Ale1x/auto-gauge/docs/hardware/README.md

# Hardware e gate K0

Analisi di fattibilità, vincoli e piani di verifica. Questi documenti non costituiscono una qualifica elettrica o automotive.

- [BUCK5_FEEDBACK_REVIEW.md](BUCK5_FEEDBACK_REVIEW.md) — Buck 5 V — screening del feedback LM5164-Q1
- [CAN_POWER_TEST_PLAN.md](CAN_POWER_TEST_PLAN.md) — CAN, alimentazione e prove K0 — proposta non congelata
- [CAPACITY_K0.md](CAPACITY_K0.md) — Sensibilità memoria e interrogazioni — K0, 2026-10-24
- [CONNECTORS_CABLE_K0.md](CONNECTORS_CABLE_K0.md) — Connettori e cavo — shortlist K0, 2026-10-24
- [GATE_K0.md](GATE_K0.md) — Gate K0 — revisione 0.14, 2026-10-24
- [HW_IGN_TEST_PROTOCOL.md](HW_IGN_TEST_PROTOCOL.md) — HW-IGN — protocollo operativo K0, NON ESEGUITO
- [LOGGING_K0.md](LOGGING_K0.md) — Logging locale limitato — proposta K0, 2026-10-24
- [MCU_RAIL_K0.md](MCU_RAIL_K0.md) — Rail MCU 3,3 V — verifica K0, 2026-10-24
- [MECHANICAL_K0.md](MECHANICAL_K0.md) — Studio meccanico K0 — revisione 0.3, diametro da congelare
- [MEMORY_RF_K0.md](MEMORY_RF_K0.md) — Memoria e RF — approfondimento K0, 2026-10-24
- [POWER_ENVELOPE_K0.md](POWER_ENVELOPE_K0.md) — Cavo e potenza — inviluppo analitico K0, 2026-10-24
- [STANDBY_BUDGET_K0.md](STANDBY_BUDGET_K0.md) — Standby — target approvato e primo controllo quantitativo
- [USB_RECOVERY_K0.md](USB_RECOVERY_K0.md) — Recovery USB alimentata — analisi K0

- [Blocker K0-001](issues/K0-001_BLOCKERS.md).
- [Sorgenti e studi KiCad](../../hardware/README.md).
- [BOM candidati](../../hardware/BOM_CANDIDATES.csv).
- [Studio meccanico](../../hardware/mechanical/gauge-k0-concepts.drawio.png).
