Ale1x/auto-gauge/docs/firmware/README.md

# Firmware

Guide dei sottosistemi. Per stato e comandi principali partire da firmware/README.md; studi SDK e codice rimangono nel modulo.

- [DEVICE_BUILD.md](DEVICE_BUILD.md) — Build reale ESP32-S3 — SDK ufficiale v6.1
- [DEVICE_ENDPOINT.md](DEVICE_ENDPOINT.md) — Endpoint C integrato — sviluppo host
- [DIAGNOSTIC_COVERAGE.md](DIAGNOSTIC_COVERAGE.md) — Copertura diagnostica scalare FW-09 — Service 01
- [FLASH_HISTORY_MODEL.md](FLASH_HISTORY_MODEL.md) — FW-08 — storico persistente su flash simulata
- [JOURNAL_HISTORY.md](JOURNAL_HISTORY.md) — FW10: sector journal history, development format 1
- [PARSER_BUILD.md](PARSER_BUILD.md) — Parser C condiviso: compilazione e stack
- [RUNTIME.md](RUNTIME.md) — FW11 autonomous host runtime coordinator
