Ale1x/auto-gauge/docs/project/README.md

# Progetto

Stato corrente, decisioni approvate e registri. WORKSTREAMS mantiene anche la cronologia; per riprendere partire da STATUS.

- [DECISIONS.md](DECISIONS.md) — Registro decisioni approvate
- [STATUS.md](STATUS.md) — Stato corrente — 25 ottobre 2026
- [WORKSTREAMS.md](WORKSTREAMS.md) — Lavoro parallelo — 24 ottobre 2026
- [traceability.md](traceability.md) — Tracciabilità K0 — revisione 0.8

- [DOCUMENTATION_MAP.json](DOCUMENTATION_MAP.json) — mappa dei percorsi precedenti.
