Ale1x/auto-gauge/hardware/pin_matrix.csv

sheet | reference | pin | pin_name | net | status
01_OBD_INPUT | J100 | 1 | Pin_1 | NC | EXTERNAL HARNESS / TYPE A DRAWING OPEN
01_OBD_INPUT | J100 | 2 | Pin_2 | NC | EXTERNAL HARNESS / TYPE A DRAWING OPEN
01_OBD_INPUT | J100 | 3 | Pin_3 | NC | EXTERNAL HARNESS / TYPE A DRAWING OPEN
01_OBD_INPUT | J100 | 4 | Pin_4 | GND | EXTERNAL HARNESS / TYPE A DRAWING OPEN
01_OBD_INPUT | J100 | 5 | Pin_5 | OBD_SIGNAL_GND | EXTERNAL HARNESS / TYPE A DRAWING OPEN
01_OBD_INPUT | J100 | 6 | Pin_6 | CANH_CABLE | EXTERNAL HARNESS / TYPE A DRAWING OPEN
01_OBD_INPUT | J100 | 7 | Pin_7 | NC | EXTERNAL HARNESS / TYPE A DRAWING OPEN
01_OBD_INPUT | J100 | 8 | Pin_8 | NC | EXTERNAL HARNESS / TYPE A DRAWING OPEN
01_OBD_INPUT | J100 | 9 | Pin_9 | NC | EXTERNAL HARNESS / TYPE A DRAWING OPEN
01_OBD_INPUT | J100 | 10 | Pin_10 | NC | EXTERNAL HARNESS / TYPE A DRAWING OPEN
01_OBD_INPUT | J100 | 11 | Pin_11 | NC | EXTERNAL HARNESS / TYPE A DRAWING OPEN
01_OBD_INPUT | J100 | 12 | Pin_12 | NC | EXTERNAL HARNESS / TYPE A DRAWING OPEN
01_OBD_INPUT | J100 | 13 | Pin_13 | NC | EXTERNAL HARNESS / TYPE A DRAWING OPEN
01_OBD_INPUT | J100 | 14 | Pin_14 | CANL_CABLE | EXTERNAL HARNESS / TYPE A DRAWING OPEN
01_OBD_INPUT | J100 | 15 | Pin_15 | NC | EXTERNAL HARNESS / TYPE A DRAWING OPEN
01_OBD_INPUT | J100 | 16 | Pin_16 | OBD_BATT_RAW | EXTERNAL HARNESS / TYPE A DRAWING OPEN
01_OBD_INPUT | J101 | 1 | Pin_1 | BPLUS_CABLE_FUSED | MAPPING H / HOUSINGS 0430200600 + 0430250600
01_OBD_INPUT | J101 | 2 | Pin_2 | GND | MAPPING H / HOUSINGS 0430200600 + 0430250600
01_OBD_INPUT | J101 | 3 | Pin_3 | OBD_SIGNAL_GND | MAPPING H / HOUSINGS 0430200600 + 0430250600
01_OBD_INPUT | J101 | 4 | Pin_4 | CANH_CABLE | MAPPING H / HOUSINGS 0430200600 + 0430250600
01_OBD_INPUT | J101 | 5 | Pin_5 | CANL_CABLE | MAPPING H / HOUSINGS 0430200600 + 0430250600
01_OBD_INPUT | J101 | 6 | Pin_6 | NC | MAPPING H / HOUSINGS 0430200600 + 0430250600
01_OBD_INPUT | F100 | 1 |  | OBD_BATT_RAW | OPEN: CURRENT / I2T / DC BREAKING
01_OBD_INPUT | F100 | 2 |  | BPLUS_CABLE_FUSED | OPEN: CURRENT / I2T / DC BREAKING
01_OBD_INPUT | R101 | 1 |  | OBD_SIGNAL_GND | OPEN GROUND / EMC REVIEW
01_OBD_INPUT | R101 | 2 |  | GND | OPEN GROUND / EMC REVIEW
01_OBD_INPUT | #FLG01 | 1 |  | OBD_BATT_RAW | EXTERNAL SOURCE DECLARATION
01_OBD_INPUT | #FLG02 | 1 |  | GND | EXTERNAL RETURN DECLARATION
02_AUTOMOTIVE_POWER | U201 | 2 | A | BPLUS_CABLE_FUSED | CANDIDATE / LIMITS OPEN
02_AUTOMOTIVE_POWER | U201 | 24 | C | PROT_MID | CANDIDATE / LIMITS OPEN
02_AUTOMOTIVE_POWER | U201 | 22 | VS | PROT_MID | CANDIDATE / LIMITS OPEN
02_AUTOMOTIVE_POWER | U201 | 3 | SW_SENSE | PROT_SENSE_SW | CANDIDATE / LIMITS OPEN
02_AUTOMOTIVE_POWER | U201 | 4 | UVLO | PROT_UVLO | CANDIDATE / LIMITS OPEN
02_AUTOMOTIVE_POWER | U201 | 5 | OV | PROT_OV | CANDIDATE / LIMITS OPEN
02_AUTOMOTIVE_POWER | U201 | 6 | EN | PROT_MID | CANDIDATE / LIMITS OPEN
02_AUTOMOTIVE_POWER | U201 | 7 | SLEEP | PROT_SLEEP_HV | CANDIDATE / LIMITS OPEN
02_AUTOMOTIVE_POWER | U201 | 13 | GND | GND | CANDIDATE / LIMITS OPEN
02_AUTOMOTIVE_POWER | U201 | 19 | CS_MINUS | PROT_CS_MINUS | CANDIDATE / LIMITS OPEN
02_AUTOMOTIVE_POWER | U201 | 20 | CS_PLUS | PROT_CS_PLUS | CANDIDATE / LIMITS OPEN
02_AUTOMOTIVE_POWER | U201 | 18 | ISCP | PROT_CS_PLUS | CANDIDATE / LIMITS OPEN
02_AUTOMOTIVE_POWER | U201 | 1 | DGATE | IDEAL_DIODE_GATE | CANDIDATE / LIMITS OPEN
02_AUTOMOTIVE_POWER | U201 | 14 | HGATE | LOAD_GATE | CANDIDATE / LIMITS OPEN
02_AUTOMOTIVE_POWER | U201 | 15 | OUT | AON_PROTECTED | CANDIDATE / LIMITS OPEN
02_AUTOMOTIVE_POWER | U201 | 16 | SLEEP_OV | PROT_MID | CANDIDATE / LIMITS OPEN
02_AUTOMOTIVE_POWER | U201 | 23 | CAP | PROT_CAP | CANDIDATE / LIMITS OPEN
02_AUTOMOTIVE_POWER | U201 | 9 | TMR | PROT_TMR | CANDIDATE / LIMITS OPEN
02_AUTOMOTIVE_POWER | U201 | 10 | IMON | NC | CANDIDATE / LIMITS OPEN
02_AUTOMOTIVE_POWER | U201 | 11 | ILIM | PROT_ILIM | CANDIDATE / LIMITS OPEN
02_AUTOMOTIVE_POWER | U201 | 12 | FLT | NC | CANDIDATE / LIMITS OPEN
02_AUTOMOTIVE_POWER | U201 | 8 | NC | NC | CANDIDATE / LIMITS OPEN
02_AUTOMOTIVE_POWER | U201 | 17 | NC | NC | CANDIDATE / LIMITS OPEN
02_AUTOMOTIVE_POWER | U201 | 21 | NC | NC | CANDIDATE / LIMITS OPEN
02_AUTOMOTIVE_POWER | Q201 | 1 | G | IDEAL_DIODE_GATE | OPEN MOSFET SELECTION
02_AUTOMOTIVE_POWER | Q201 | 2 | D | PROT_MID | OPEN MOSFET SELECTION
02_AUTOMOTIVE_POWER | Q201 | 3 | S | BPLUS_CABLE_FUSED | OPEN MOSFET SELECTION
02_AUTOMOTIVE_POWER | Q202 | 1 | G | LOAD_GATE | OPEN MOSFET SELECTION
02_AUTOMOTIVE_POWER | Q202 | 2 | D | PROT_CS_MINUS | OPEN MOSFET SELECTION
02_AUTOMOTIVE_POWER | Q202 | 3 | S | AON_PROTECTED | OPEN MOSFET SELECTION
02_AUTOMOTIVE_POWER | R201 | 1 |  | PROT_MID | OPEN OCP / I2T
02_AUTOMOTIVE_POWER | R201 | 2 |  | PROT_CS_MINUS | OPEN OCP / I2T
02_AUTOMOTIVE_POWER | R202 | 1 |  | PROT_MID | CANDIDATE
02_AUTOMOTIVE_POWER | R202 | 2 |  | PROT_CS_PLUS | CANDIDATE
02_AUTOMOTIVE_POWER | D201 | 1 | A1 | BPLUS_CABLE_FUSED | OPEN CLAMP / ENERGY / POLARITY
02_AUTOMOTIVE_POWER | D201 | 2 | A2 | GND | OPEN CLAMP / ENERGY / POLARITY
02_AUTOMOTIVE_POWER | C201 | 1 |  | PROT_MID | CANDIDATE
02_AUTOMOTIVE_POWER | C201 | 2 |  | GND | CANDIDATE
02_AUTOMOTIVE_POWER | C202 | 1 |  | PROT_CAP | CANDIDATE
02_AUTOMOTIVE_POWER | C202 | 2 |  | PROT_MID | CANDIDATE
02_AUTOMOTIVE_POWER | R203 | 1 |  | PROT_SENSE_SW | OPEN UV/OV LIMITS
02_AUTOMOTIVE_POWER | R203 | 2 |  | PROT_UVLO | OPEN UV/OV LIMITS
02_AUTOMOTIVE_POWER | R204 | 1 |  | PROT_UVLO | OPEN UV/OV LIMITS
02_AUTOMOTIVE_POWER | R204 | 2 |  | PROT_OV | OPEN UV/OV LIMITS
02_AUTOMOTIVE_POWER | R205 | 1 |  | PROT_OV | OPEN UV/OV LIMITS
02_AUTOMOTIVE_POWER | R205 | 2 |  | GND | OPEN UV/OV LIMITS
02_AUTOMOTIVE_POWER | R206 | 1 |  | PROT_ILIM | OPEN OCP
02_AUTOMOTIVE_POWER | R206 | 2 |  | GND | OPEN OCP
02_AUTOMOTIVE_POWER | C203 | 1 |  | PROT_TMR | OPEN FAULT TIME
02_AUTOMOTIVE_POWER | C203 | 2 |  | GND | OPEN FAULT TIME
02_AUTOMOTIVE_POWER | C204 | 1 |  | AON_PROTECTED | OPEN INRUSH / SOA
02_AUTOMOTIVE_POWER | C204 | 2 |  | GND | OPEN INRUSH / SOA
02_AUTOMOTIVE_POWER | R215 | 1 |  | CAN_INH_HV | CANDIDATE
02_AUTOMOTIVE_POWER | R215 | 2 |  | PROT_SLEEP_HV | CANDIDATE
02_AUTOMOTIVE_POWER | R216 | 1 |  | PROT_SLEEP_HV | CANDIDATE
02_AUTOMOTIVE_POWER | R216 | 2 |  | GND | CANDIDATE
02_AUTOMOTIVE_POWER | R217 | 1 |  | CAN_INH_HV | OPEN WAKE SEQUENCE
02_AUTOMOTIVE_POWER | R217 | 2 |  | BUCK5_EN_HV | OPEN WAKE SEQUENCE
02_AUTOMOTIVE_POWER | C217 | 1 |  | BUCK5_EN_HV | OPEN WAKE SEQUENCE
02_AUTOMOTIVE_POWER | C217 | 2 |  | GND | OPEN WAKE SEQUENCE
02_AUTOMOTIVE_POWER | U202 | 1 | GND | GND | CANDIDATE / 5V LOOP H
02_AUTOMOTIVE_POWER | U202 | 2 | VIN | AON_PROTECTED | CANDIDATE / 5V LOOP H
02_AUTOMOTIVE_POWER | U202 | 3 | EN/UVLO | BUCK5_EN_HV | CANDIDATE / 5V LOOP H
02_AUTOMOTIVE_POWER | U202 | 4 | RON | BUCK5_RON | CANDIDATE / 5V LOOP H
02_AUTOMOTIVE_POWER | U202 | 5 | FB | BUCK5_FB | CANDIDATE / 5V LOOP H
02_AUTOMOTIVE_POWER | U202 | 6 | PGOOD | BUCK5_PG | CANDIDATE / 5V LOOP H
02_AUTOMOTIVE_POWER | U202 | 7 | BST | BUCK5_BST | CANDIDATE / 5V LOOP H
02_AUTOMOTIVE_POWER | U202 | 8 | SW | BUCK5_SW | CANDIDATE / 5V LOOP H
02_AUTOMOTIVE_POWER | U202 | 9 | EP | GND | CANDIDATE / 5V LOOP H
02_AUTOMOTIVE_POWER | L202 | 1 | 1 | BUCK5_SW | H / CURRENT AND LOSS OPEN
02_AUTOMOTIVE_POWER | L202 | 2 | 2 | 5V_OBD | H / CURRENT AND LOSS OPEN
02_AUTOMOTIVE_POWER | C205 | 1 |  | AON_PROTECTED | CANDIDATE
02_AUTOMOTIVE_POWER | C205 | 2 |  | GND | CANDIDATE
02_AUTOMOTIVE_POWER | C206 | 1 |  | BUCK5_BST | CANDIDATE
02_AUTOMOTIVE_POWER | C206 | 2 |  | BUCK5_SW | CANDIDATE
02_AUTOMOTIVE_POWER | C207 | 1 |  | 5V_OBD | CANDIDATE
02_AUTOMOTIVE_POWER | C207 | 2 |  | GND | CANDIDATE
02_AUTOMOTIVE_POWER | R207 | 1 |  | BUCK5_RON | CANDIDATE
02_AUTOMOTIVE_POWER | R207 | 2 |  | GND | CANDIDATE
02_AUTOMOTIVE_POWER | R208 | 1 |  | 5V_OBD | CANDIDATE
02_AUTOMOTIVE_POWER | R208 | 2 |  | BUCK5_FB | CANDIDATE
02_AUTOMOTIVE_POWER | R209 | 1 |  | BUCK5_FB | CANDIDATE
02_AUTOMOTIVE_POWER | R209 | 2 |  | GND | CANDIDATE
02_AUTOMOTIVE_POWER | R210 | 1 |  | BUCK5_SW | OPEN TYPE3 LOOP
02_AUTOMOTIVE_POWER | R210 | 2 |  | BUCK5_RIPPLE_A | OPEN TYPE3 LOOP
02_AUTOMOTIVE_POWER | C208 | 1 |  | BUCK5_RIPPLE_A | OPEN TYPE3 LOOP
02_AUTOMOTIVE_POWER | C208 | 2 |  | 5V_OBD | OPEN TYPE3 LOOP
02_AUTOMOTIVE_POWER | C209 | 1 |  | BUCK5_RIPPLE_A | OPEN TYPE3 LOOP
02_AUTOMOTIVE_POWER | C209 | 2 |  | BUCK5_FB | OPEN TYPE3 LOOP
02_AUTOMOTIVE_POWER | R211 | 1 |  | 5V_OBD | CANDIDATE
02_AUTOMOTIVE_POWER | R211 | 2 |  | BUCK5_PG | CANDIDATE
02_AUTOMOTIVE_POWER | U203 | 2 | VIN | 5V_SERVICE | CANDIDATE / E46 INITIAL VALUES
02_AUTOMOTIVE_POWER | U203 | 8 | EN | 5V_SERVICE | CANDIDATE / E46 INITIAL VALUES
02_AUTOMOTIVE_POWER | U203 | 1 | MODE_SYNC | GND | CANDIDATE / E46 INITIAL VALUES
02_AUTOMOTIVE_POWER | U203 | 7 | COMP_FSET | GND | CANDIDATE / E46 INITIAL VALUES
02_AUTOMOTIVE_POWER | U203 | 6 | SS_TR | BUCK33_SS | CANDIDATE / E46 INITIAL VALUES
02_AUTOMOTIVE_POWER | U203 | 4 | GND | GND | CANDIDATE / E46 INITIAL VALUES
02_AUTOMOTIVE_POWER | U203 | 3 | SW | BUCK33_SW | CANDIDATE / E46 INITIAL VALUES
02_AUTOMOTIVE_POWER | U203 | 5 | FB | BUCK33_FB | CANDIDATE / E46 INITIAL VALUES
02_AUTOMOTIVE_POWER | U203 | 9 | PG | BUCK33_PG | CANDIDATE / E46 INITIAL VALUES
02_AUTOMOTIVE_POWER | L203 | 1 | 1 | BUCK33_SW | CANDIDATE
02_AUTOMOTIVE_POWER | L203 | 2 | 2 | 3V3_SYS | CANDIDATE
02_AUTOMOTIVE_POWER | C210 | 1 |  | 5V_SERVICE | CANDIDATE
02_AUTOMOTIVE_POWER | C210 | 2 |  | GND | CANDIDATE
02_AUTOMOTIVE_POWER | C211 | 1 |  | 3V3_SYS | CANDIDATE
02_AUTOMOTIVE_POWER | C211 | 2 |  | GND | CANDIDATE
02_AUTOMOTIVE_POWER | C212 | 1 |  | 3V3_SYS | CANDIDATE
02_AUTOMOTIVE_POWER | C212 | 2 |  | GND | CANDIDATE
02_AUTOMOTIVE_POWER | C213 | 1 |  | BUCK33_SS | CANDIDATE
02_AUTOMOTIVE_POWER | C213 | 2 |  | GND | CANDIDATE
02_AUTOMOTIVE_POWER | R212 | 1 |  | 3V3_SYS | CANDIDATE
02_AUTOMOTIVE_POWER | R212 | 2 |  | BUCK33_FB | CANDIDATE
02_AUTOMOTIVE_POWER | R213 | 1 |  | BUCK33_FB | CANDIDATE
02_AUTOMOTIVE_POWER | R213 | 2 |  | GND | CANDIDATE
02_AUTOMOTIVE_POWER | C214 | 1 |  | 3V3_SYS | CANDIDATE
02_AUTOMOTIVE_POWER | C214 | 2 |  | BUCK33_FB | CANDIDATE
02_AUTOMOTIVE_POWER | R214 | 1 |  | 3V3_SYS | CANDIDATE
02_AUTOMOTIVE_POWER | R214 | 2 |  | BUCK33_PG | CANDIDATE
03_MCU_MEMORY_BLE | U301 | 1 | GND | GND | CANDIDATE / PIN MAP H
03_MCU_MEMORY_BLE | U301 | 2 | 3V3 | 3V3_SYS | CANDIDATE / PIN MAP H
03_MCU_MEMORY_BLE | U301 | 3 | EN | MCU_EN | CANDIDATE / PIN MAP H
03_MCU_MEMORY_BLE | U301 | 4 | IO4 | CAN_TXD | CANDIDATE / PIN MAP H
03_MCU_MEMORY_BLE | U301 | 5 | IO5 | CAN_RXD | CANDIDATE / PIN MAP H
03_MCU_MEMORY_BLE | U301 | 6 | IO6 | CAN_EN | CANDIDATE / PIN MAP H
03_MCU_MEMORY_BLE | U301 | 7 | IO7 | CAN_nSTB | CANDIDATE / PIN MAP H
03_MCU_MEMORY_BLE | U301 | 8 | IO15 | CAN_nFAULT | CANDIDATE / PIN MAP H
03_MCU_MEMORY_BLE | U301 | 9 | IO16 | ALS_INT | CANDIDATE / PIN MAP H
03_MCU_MEMORY_BLE | U301 | 10 | IO17 | DISP_RESET | CANDIDATE / PIN MAP H
03_MCU_MEMORY_BLE | U301 | 11 | IO18 | TOUCH_INT | CANDIDATE / PIN MAP H
03_MCU_MEMORY_BLE | U301 | 12 | IO8 | ALS_SDA | CANDIDATE / PIN MAP H
03_MCU_MEMORY_BLE | U301 | 13 | USB_D- | USB_DN_MCU | CANDIDATE / PIN MAP H
03_MCU_MEMORY_BLE | U301 | 14 | USB_D+ | USB_DP_MCU | CANDIDATE / PIN MAP H
03_MCU_MEMORY_BLE | U301 | 15 | IO3 | NC | CANDIDATE / PIN MAP H
03_MCU_MEMORY_BLE | U301 | 16 | IO46 | NC | CANDIDATE / PIN MAP H
03_MCU_MEMORY_BLE | U301 | 17 | IO9 | ALS_SCL | CANDIDATE / PIN MAP H
03_MCU_MEMORY_BLE | U301 | 18 | IO10 | DISP_CS | CANDIDATE / PIN MAP H
03_MCU_MEMORY_BLE | U301 | 19 | IO11 | DISP_D0 | CANDIDATE / PIN MAP H
03_MCU_MEMORY_BLE | U301 | 20 | IO12 | DISP_CLK | CANDIDATE / PIN MAP H
03_MCU_MEMORY_BLE | U301 | 21 | IO13 | DISP_D1 | CANDIDATE / PIN MAP H
03_MCU_MEMORY_BLE | U301 | 22 | IO14 | DISP_D2 | CANDIDATE / PIN MAP H
03_MCU_MEMORY_BLE | U301 | 23 | IO21 | DISP_D3 | CANDIDATE / PIN MAP H
03_MCU_MEMORY_BLE | U301 | 24 | IO47 | TOUCH_RESET | CANDIDATE / PIN MAP H
03_MCU_MEMORY_BLE | U301 | 25 | IO48 | DISP_ENABLE | CANDIDATE / PIN MAP H
03_MCU_MEMORY_BLE | U301 | 26 | IO45 | NC | CANDIDATE / PIN MAP H
03_MCU_MEMORY_BLE | U301 | 27 | IO0 | BOOT_N | CANDIDATE / PIN MAP H
03_MCU_MEMORY_BLE | U301 | 28 | IO35 | NC | CANDIDATE / PIN MAP H
03_MCU_MEMORY_BLE | U301 | 29 | IO36 | NC | CANDIDATE / PIN MAP H
03_MCU_MEMORY_BLE | U301 | 30 | IO37 | NC | CANDIDATE / PIN MAP H
03_MCU_MEMORY_BLE | U301 | 31 | IO38 | USB_PRESENT_SAFE_TBD | CANDIDATE / PIN MAP H
03_MCU_MEMORY_BLE | U301 | 32 | IO39 | OBD_PRESENT_SAFE_TBD | CANDIDATE / PIN MAP H
03_MCU_MEMORY_BLE | U301 | 33 | IO40 | NC | CANDIDATE / PIN MAP H
03_MCU_MEMORY_BLE | U301 | 34 | IO41 | NC | CANDIDATE / PIN MAP H
03_MCU_MEMORY_BLE | U301 | 35 | IO42 | NC | CANDIDATE / PIN MAP H
03_MCU_MEMORY_BLE | U301 | 36 | RXD0 | UART0_RX_TEST | CANDIDATE / PIN MAP H
03_MCU_MEMORY_BLE | U301 | 37 | TXD0 | UART0_TX_TEST | CANDIDATE / PIN MAP H
03_MCU_MEMORY_BLE | U301 | 38 | IO2 | TOUCH_SCL_TBD_LEVEL | CANDIDATE / PIN MAP H
03_MCU_MEMORY_BLE | U301 | 39 | IO1 | TOUCH_SDA_TBD_LEVEL | CANDIDATE / PIN MAP H
03_MCU_MEMORY_BLE | U301 | 40 | GND | GND | CANDIDATE / PIN MAP H
03_MCU_MEMORY_BLE | U301 | 41 | GND | GND | CANDIDATE / PIN MAP H
03_MCU_MEMORY_BLE | C301 | 1 |  | 3V3_SYS | CANDIDATE
03_MCU_MEMORY_BLE | C301 | 2 |  | GND | CANDIDATE
03_MCU_MEMORY_BLE | C302 | 1 |  | 3V3_SYS | CANDIDATE
03_MCU_MEMORY_BLE | C302 | 2 |  | GND | CANDIDATE
03_MCU_MEMORY_BLE | R301 | 1 |  | 3V3_SYS | CANDIDATE
03_MCU_MEMORY_BLE | R301 | 2 |  | MCU_EN | CANDIDATE
03_MCU_MEMORY_BLE | C303 | 1 |  | MCU_EN | CANDIDATE
03_MCU_MEMORY_BLE | C303 | 2 |  | GND | CANDIDATE
03_MCU_MEMORY_BLE | R302 | 1 |  | 3V3_SYS | CANDIDATE
03_MCU_MEMORY_BLE | R302 | 2 |  | BOOT_N | CANDIDATE
03_MCU_MEMORY_BLE | TP301 | 1 | 1 | MCU_EN | TEST PAD / FOOTPRINT OPEN
03_MCU_MEMORY_BLE | TP302 | 1 | 1 | BOOT_N | TEST PAD / FOOTPRINT OPEN
03_MCU_MEMORY_BLE | TP303 | 1 | 1 | UART0_TX_TEST | TEST PAD / FOOTPRINT OPEN
03_MCU_MEMORY_BLE | TP304 | 1 | 1 | UART0_RX_TEST | TEST PAD / FOOTPRINT OPEN
03_MCU_MEMORY_BLE | TP305 | 1 | 1 | GND | TEST PAD / FOOTPRINT OPEN
04_CAN_PHY | U401 | 1 | TXD | CAN_TXD | PIN TABLE CHECKED / DFM OPEN
04_CAN_PHY | U401 | 2 | GND | GND | PIN TABLE CHECKED / DFM OPEN
04_CAN_PHY | U401 | 3 | VCC | 5V_OBD | PIN TABLE CHECKED / DFM OPEN
04_CAN_PHY | U401 | 4 | RXD | CAN_RXD | PIN TABLE CHECKED / DFM OPEN
04_CAN_PHY | U401 | 5 | VIO | 3V3_SYS | PIN TABLE CHECKED / DFM OPEN
04_CAN_PHY | U401 | 6 | EN | CAN_EN | PIN TABLE CHECKED / DFM OPEN
04_CAN_PHY | U401 | 7 | INH | CAN_INH_HV | PIN TABLE CHECKED / DFM OPEN
04_CAN_PHY | U401 | 8 | ~{FAULT} | CAN_nFAULT | PIN TABLE CHECKED / DFM OPEN
04_CAN_PHY | U401 | 9 | WAKE | AON_PROTECTED | PIN TABLE CHECKED / DFM OPEN
04_CAN_PHY | U401 | 10 | VSUP | AON_PROTECTED | PIN TABLE CHECKED / DFM OPEN
04_CAN_PHY | U401 | 11 | NC | NC | PIN TABLE CHECKED / DFM OPEN
04_CAN_PHY | U401 | 12 | CANL | CANL_CABLE | PIN TABLE CHECKED / DFM OPEN
04_CAN_PHY | U401 | 13 | CANH | CANH_CABLE | PIN TABLE CHECKED / DFM OPEN
04_CAN_PHY | U401 | 14 | ~{STB} | CAN_nSTB | PIN TABLE CHECKED / DFM OPEN
04_CAN_PHY | C401 | 1 |  | 5V_OBD | CANDIDATE
04_CAN_PHY | C401 | 2 |  | GND | CANDIDATE
04_CAN_PHY | C402 | 1 |  | 3V3_SYS | CANDIDATE
04_CAN_PHY | C402 | 2 |  | GND | CANDIDATE
04_CAN_PHY | C403 | 1 |  | AON_PROTECTED | CANDIDATE
04_CAN_PHY | C403 | 2 |  | GND | CANDIDATE
04_CAN_PHY | R401 | 1 |  | 3V3_SYS | CANDIDATE
04_CAN_PHY | R401 | 2 |  | CAN_TXD | CANDIDATE
04_CAN_PHY | R402 | 1 |  | CAN_EN | CANDIDATE
04_CAN_PHY | R402 | 2 |  | GND | CANDIDATE
04_CAN_PHY | R403 | 1 |  | CAN_nSTB | CANDIDATE
04_CAN_PHY | R403 | 2 |  | GND | CANDIDATE
04_CAN_PHY | D401 | 1 | A1 | CANH_CABLE | OPEN CAN CLAMP / CAPACITANCE
04_CAN_PHY | D401 | 2 | A2 | GND | OPEN CAN CLAMP / CAPACITANCE
04_CAN_PHY | D402 | 1 | A1 | CANL_CABLE | OPEN CAN CLAMP / CAPACITANCE
04_CAN_PHY | D402 | 2 | A2 | GND | OPEN CAN CLAMP / CAPACITANCE
05_AMOLED_TOUCH | J501 | 1 | Pin_1 | OPEN | BLOCKED / EXACT PANEL REVISION AND MATE OPEN
05_AMOLED_TOUCH | J501 | 2 | Pin_2 | OPEN | BLOCKED / EXACT PANEL REVISION AND MATE OPEN
05_AMOLED_TOUCH | J501 | 3 | Pin_3 | OPEN | BLOCKED / EXACT PANEL REVISION AND MATE OPEN
05_AMOLED_TOUCH | J501 | 4 | Pin_4 | OPEN | BLOCKED / EXACT PANEL REVISION AND MATE OPEN
05_AMOLED_TOUCH | J501 | 5 | Pin_5 | OPEN | BLOCKED / EXACT PANEL REVISION AND MATE OPEN
05_AMOLED_TOUCH | J501 | 6 | Pin_6 | OPEN | BLOCKED / EXACT PANEL REVISION AND MATE OPEN
05_AMOLED_TOUCH | J501 | 7 | Pin_7 | OPEN | BLOCKED / EXACT PANEL REVISION AND MATE OPEN
05_AMOLED_TOUCH | J501 | 8 | Pin_8 | OPEN | BLOCKED / EXACT PANEL REVISION AND MATE OPEN
05_AMOLED_TOUCH | J501 | 9 | Pin_9 | OPEN | BLOCKED / EXACT PANEL REVISION AND MATE OPEN
05_AMOLED_TOUCH | J501 | 10 | Pin_10 | OPEN | BLOCKED / EXACT PANEL REVISION AND MATE OPEN
05_AMOLED_TOUCH | J501 | 11 | Pin_11 | OPEN | BLOCKED / EXACT PANEL REVISION AND MATE OPEN
05_AMOLED_TOUCH | J501 | 12 | Pin_12 | OPEN | BLOCKED / EXACT PANEL REVISION AND MATE OPEN
05_AMOLED_TOUCH | J501 | 13 | Pin_13 | OPEN | BLOCKED / EXACT PANEL REVISION AND MATE OPEN
05_AMOLED_TOUCH | J501 | 14 | Pin_14 | OPEN | BLOCKED / EXACT PANEL REVISION AND MATE OPEN
05_AMOLED_TOUCH | J501 | 15 | Pin_15 | OPEN | BLOCKED / EXACT PANEL REVISION AND MATE OPEN
05_AMOLED_TOUCH | J501 | 16 | Pin_16 | OPEN | BLOCKED / EXACT PANEL REVISION AND MATE OPEN
05_AMOLED_TOUCH | J501 | 17 | Pin_17 | OPEN | BLOCKED / EXACT PANEL REVISION AND MATE OPEN
05_AMOLED_TOUCH | J501 | 18 | Pin_18 | OPEN | BLOCKED / EXACT PANEL REVISION AND MATE OPEN
05_AMOLED_TOUCH | J501 | 19 | Pin_19 | OPEN | BLOCKED / EXACT PANEL REVISION AND MATE OPEN
05_AMOLED_TOUCH | J501 | 20 | Pin_20 | OPEN | BLOCKED / EXACT PANEL REVISION AND MATE OPEN
05_AMOLED_TOUCH | J501 | 21 | Pin_21 | OPEN | BLOCKED / EXACT PANEL REVISION AND MATE OPEN
05_AMOLED_TOUCH | J501 | 22 | Pin_22 | OPEN | BLOCKED / EXACT PANEL REVISION AND MATE OPEN
05_AMOLED_TOUCH | J501 | 23 | Pin_23 | OPEN | BLOCKED / EXACT PANEL REVISION AND MATE OPEN
05_AMOLED_TOUCH | J501 | 24 | Pin_24 | OPEN | BLOCKED / EXACT PANEL REVISION AND MATE OPEN
05_AMOLED_TOUCH | J501 | 25 | Pin_25 | OPEN | BLOCKED / EXACT PANEL REVISION AND MATE OPEN
05_AMOLED_TOUCH | J501 | 26 | Pin_26 | OPEN | BLOCKED / EXACT PANEL REVISION AND MATE OPEN
05_AMOLED_TOUCH | J501 | 27 | Pin_27 | OPEN | BLOCKED / EXACT PANEL REVISION AND MATE OPEN
05_AMOLED_TOUCH | J501 | 28 | Pin_28 | OPEN | BLOCKED / EXACT PANEL REVISION AND MATE OPEN
05_AMOLED_TOUCH | J501 | 29 | Pin_29 | OPEN | BLOCKED / EXACT PANEL REVISION AND MATE OPEN
05_AMOLED_TOUCH | J501 | 30 | Pin_30 | OPEN | BLOCKED / EXACT PANEL REVISION AND MATE OPEN
05_AMOLED_TOUCH | J501 | 31 | Pin_31 | OPEN | BLOCKED / EXACT PANEL REVISION AND MATE OPEN
05_AMOLED_TOUCH | TP501 | 1 | 1 | DISP_CLK | LOGICAL INTERFACE ONLY
05_AMOLED_TOUCH | TP502 | 1 | 1 | DISP_CS | LOGICAL INTERFACE ONLY
05_AMOLED_TOUCH | TP503 | 1 | 1 | DISP_D0 | LOGICAL INTERFACE ONLY
05_AMOLED_TOUCH | TP504 | 1 | 1 | DISP_D1 | LOGICAL INTERFACE ONLY
05_AMOLED_TOUCH | TP505 | 1 | 1 | DISP_D2 | LOGICAL INTERFACE ONLY
05_AMOLED_TOUCH | TP506 | 1 | 1 | DISP_D3 | LOGICAL INTERFACE ONLY
05_AMOLED_TOUCH | TP507 | 1 | 1 | DISP_RESET | LOGICAL INTERFACE ONLY
05_AMOLED_TOUCH | TP508 | 1 | 1 | DISP_ENABLE | LOGICAL INTERFACE ONLY
05_AMOLED_TOUCH | TP509 | 1 | 1 | TOUCH_SCL_TBD_LEVEL | LOGICAL INTERFACE ONLY
05_AMOLED_TOUCH | TP510 | 1 | 1 | TOUCH_SDA_TBD_LEVEL | LOGICAL INTERFACE ONLY
05_AMOLED_TOUCH | TP511 | 1 | 1 | TOUCH_INT | LOGICAL INTERFACE ONLY
05_AMOLED_TOUCH | TP512 | 1 | 1 | TOUCH_RESET | LOGICAL INTERFACE ONLY
06_LIGHT_SENSOR | U601 | 1 | VDD | 3V3_SYS | PIN TABLE E06 / LAND PATTERN OPEN
06_LIGHT_SENSOR | U601 | 2 | ADDR | GND | PIN TABLE E06 / LAND PATTERN OPEN
06_LIGHT_SENSOR | U601 | 3 | GND | GND | PIN TABLE E06 / LAND PATTERN OPEN
06_LIGHT_SENSOR | U601 | 4 | SCL | ALS_SCL | PIN TABLE E06 / LAND PATTERN OPEN
06_LIGHT_SENSOR | U601 | 5 | INT | ALS_INT | PIN TABLE E06 / LAND PATTERN OPEN
06_LIGHT_SENSOR | U601 | 6 | SDA | ALS_SDA | PIN TABLE E06 / LAND PATTERN OPEN
06_LIGHT_SENSOR | C601 | 1 |  | 3V3_SYS | CANDIDATE
06_LIGHT_SENSOR | C601 | 2 |  | GND | CANDIDATE
06_LIGHT_SENSOR | R601 | 1 |  | 3V3_SYS | CANDIDATE
06_LIGHT_SENSOR | R601 | 2 |  | ALS_SCL | CANDIDATE
06_LIGHT_SENSOR | R602 | 1 |  | 3V3_SYS | CANDIDATE
06_LIGHT_SENSOR | R602 | 2 |  | ALS_SDA | CANDIDATE
06_LIGHT_SENSOR | R603 | 1 |  | 3V3_SYS | CANDIDATE
06_LIGHT_SENSOR | R603 | 2 |  | ALS_INT | CANDIDATE
07_TEST_SERVICE | J701 | A1 | GND | GND | CONNECTOR MPN / VBUS PROTECTION OPEN
07_TEST_SERVICE | J701 | A4 | VBUS | USB_VBUS_RAW | CONNECTOR MPN / VBUS PROTECTION OPEN
07_TEST_SERVICE | J701 | A5 | CC1 | USB_CC1 | CONNECTOR MPN / VBUS PROTECTION OPEN
07_TEST_SERVICE | J701 | A6 | D+ | USB_DP_PORT | CONNECTOR MPN / VBUS PROTECTION OPEN
07_TEST_SERVICE | J701 | A7 | D- | USB_DN_PORT | CONNECTOR MPN / VBUS PROTECTION OPEN
07_TEST_SERVICE | J701 | A8 | SBU1 | NC | CONNECTOR MPN / VBUS PROTECTION OPEN
07_TEST_SERVICE | J701 | A9 | VBUS | USB_VBUS_RAW | CONNECTOR MPN / VBUS PROTECTION OPEN
07_TEST_SERVICE | J701 | A12 | GND | GND | CONNECTOR MPN / VBUS PROTECTION OPEN
07_TEST_SERVICE | J701 | B1 | GND | GND | CONNECTOR MPN / VBUS PROTECTION OPEN
07_TEST_SERVICE | J701 | B4 | VBUS | USB_VBUS_RAW | CONNECTOR MPN / VBUS PROTECTION OPEN
07_TEST_SERVICE | J701 | B5 | CC2 | USB_CC2 | CONNECTOR MPN / VBUS PROTECTION OPEN
07_TEST_SERVICE | J701 | B6 | D+ | USB_DP_PORT | CONNECTOR MPN / VBUS PROTECTION OPEN
07_TEST_SERVICE | J701 | B7 | D- | USB_DN_PORT | CONNECTOR MPN / VBUS PROTECTION OPEN
07_TEST_SERVICE | J701 | B8 | SBU2 | NC | CONNECTOR MPN / VBUS PROTECTION OPEN
07_TEST_SERVICE | J701 | B9 | VBUS | USB_VBUS_RAW | CONNECTOR MPN / VBUS PROTECTION OPEN
07_TEST_SERVICE | J701 | B12 | GND | GND | CONNECTOR MPN / VBUS PROTECTION OPEN
07_TEST_SERVICE | J701 | SH | SHIELD | USB_SHIELD | CONNECTOR MPN / VBUS PROTECTION OPEN
07_TEST_SERVICE | R701 | 1 |  | USB_CC1 | CANDIDATE
07_TEST_SERVICE | R701 | 2 |  | GND | CANDIDATE
07_TEST_SERVICE | R702 | 1 |  | USB_CC2 | CANDIDATE
07_TEST_SERVICE | R702 | 2 |  | GND | CANDIDATE
07_TEST_SERVICE | R703 | 1 |  | USB_DP_PORT | CANDIDATE
07_TEST_SERVICE | R703 | 2 |  | USB_DP_MCU | CANDIDATE
07_TEST_SERVICE | R704 | 1 |  | USB_DN_PORT | CANDIDATE
07_TEST_SERVICE | R704 | 2 |  | USB_DN_MCU | CANDIDATE
07_TEST_SERVICE | R705 | 1 |  | USB_SHIELD | OPEN EMC / CHASSIS STRATEGY
07_TEST_SERVICE | R705 | 2 |  | GND | OPEN EMC / CHASSIS STRATEGY
07_TEST_SERVICE | U701 | 7 | VOUT | 5V_SERVICE | CANDIDATE / USB INPUT PROTECTION OPEN
07_TEST_SERVICE | U701 | 1 | GND | GND | CANDIDATE / USB INPUT PROTECTION OPEN
07_TEST_SERVICE | U701 | 2 | VOUT | 5V_SERVICE | CANDIDATE / USB INPUT PROTECTION OPEN
07_TEST_SERVICE | U701 | 3 | VIN1 | 5V_OBD | CANDIDATE / USB INPUT PROTECTION OPEN
07_TEST_SERVICE | U701 | 4 | PR1 | MUX_PR1 | CANDIDATE / USB INPUT PROTECTION OPEN
07_TEST_SERVICE | U701 | 5 | MODE | 5V_OBD | CANDIDATE / USB INPUT PROTECTION OPEN
07_TEST_SERVICE | U701 | 6 | VIN2 | USB_5V_PROTECTED_TBD | CANDIDATE / USB INPUT PROTECTION OPEN
07_TEST_SERVICE | U701 | 8 | ST | NC | CANDIDATE / USB INPUT PROTECTION OPEN
07_TEST_SERVICE | R706 | 1 |  | 5V_OBD | CANDIDATE
07_TEST_SERVICE | R706 | 2 |  | MUX_PR1 | CANDIDATE
07_TEST_SERVICE | R707 | 1 |  | MUX_PR1 | CANDIDATE
07_TEST_SERVICE | R707 | 2 |  | GND | CANDIDATE
07_TEST_SERVICE | C701 | 1 |  | USB_5V_PROTECTED_TBD | CANDIDATE
07_TEST_SERVICE | C701 | 2 |  | GND | CANDIDATE
07_TEST_SERVICE | C702 | 1 |  | 5V_SERVICE | CANDIDATE
07_TEST_SERVICE | C702 | 2 |  | GND | CANDIDATE
07_TEST_SERVICE | SW701 | 1 | 1 | MCU_EN | CANDIDATE
07_TEST_SERVICE | SW701 | 2 | 2 | GND | CANDIDATE
07_TEST_SERVICE | SW702 | 1 | 1 | BOOT_N | CANDIDATE
07_TEST_SERVICE | SW702 | 2 | 2 | GND | CANDIDATE
