Ale1x/auto-gauge/hardware/presence_sensing/study_pin_matrix.csv

sheet | reference | pin | pin_name | net | status
PRESENCE_SENSING_STUDY | R1 | 1 |  | USB_RAW_H | H / LEAKAGE MAX AND ENVIRONMENT OPEN
PRESENCE_SENSING_STUDY | R1 | 2 |  | USB_SENSE_H | H / LEAKAGE MAX AND ENVIRONMENT OPEN
PRESENCE_SENSING_STUDY | R2 | 1 |  | USB_SENSE_H | H / LEAKAGE MAX AND ENVIRONMENT OPEN
PRESENCE_SENSING_STUDY | R2 | 2 |  | GND_STUDY | H / LEAKAGE MAX AND ENVIRONMENT OPEN
PRESENCE_SENSING_STUDY | R3 | 1 |  | AON_PROTECTED_H | H / LEAKAGE MAX AND ENVIRONMENT OPEN
PRESENCE_SENSING_STUDY | R3 | 2 |  | OBD_SERIES_MID | H / LEAKAGE MAX AND ENVIRONMENT OPEN
PRESENCE_SENSING_STUDY | R4 | 1 |  | OBD_SERIES_MID | H / LEAKAGE MAX AND ENVIRONMENT OPEN
PRESENCE_SENSING_STUDY | R4 | 2 |  | OBD_SENSE_H | H / LEAKAGE MAX AND ENVIRONMENT OPEN
PRESENCE_SENSING_STUDY | R5 | 1 |  | OBD_SENSE_H | H / LEAKAGE MAX AND ENVIRONMENT OPEN
PRESENCE_SENSING_STUDY | R5 | 2 |  | GND_STUDY | H / LEAKAGE MAX AND ENVIRONMENT OPEN
PRESENCE_SENSING_STUDY | R6 | 1 |  | SWITCHED_3V3_H | H / LEAKAGE MAX AND ENVIRONMENT OPEN
PRESENCE_SENSING_STUDY | R6 | 2 |  | REFERENCE_H | H / LEAKAGE MAX AND ENVIRONMENT OPEN
PRESENCE_SENSING_STUDY | R7 | 1 |  | REFERENCE_H | H / LEAKAGE MAX AND ENVIRONMENT OPEN
PRESENCE_SENSING_STUDY | R7 | 2 |  | GND_STUDY | H / LEAKAGE MAX AND ENVIRONMENT OPEN
PRESENCE_SENSING_STUDY | U1 | 8 | VCC | SWITCHED_3V3_H | H / UNBOUNDED LEAKAGE / NOT QUALIFIED
PRESENCE_SENSING_STUDY | U1 | 4 | VEE | GND_STUDY | H / UNBOUNDED LEAKAGE / NOT QUALIFIED
PRESENCE_SENSING_STUDY | U1 | 3 | INA+ USB | USB_SENSE_H | H / UNBOUNDED LEAKAGE / NOT QUALIFIED
PRESENCE_SENSING_STUDY | U1 | 2 | INA- REF | REFERENCE_H | H / UNBOUNDED LEAKAGE / NOT QUALIFIED
PRESENCE_SENSING_STUDY | U1 | 5 | INB+ OBD | OBD_SENSE_H | H / UNBOUNDED LEAKAGE / NOT QUALIFIED
PRESENCE_SENSING_STUDY | U1 | 6 | INB- REF | REFERENCE_H | H / UNBOUNDED LEAKAGE / NOT QUALIFIED
PRESENCE_SENSING_STUDY | U1 | 1 | OUTA USB | USB_PRESENT_H | H / UNBOUNDED LEAKAGE / NOT QUALIFIED
PRESENCE_SENSING_STUDY | U1 | 7 | OUTB OBD | OBD_PRESENT_H | H / UNBOUNDED LEAKAGE / NOT QUALIFIED
PRESENCE_SENSING_STUDY | R8 | 1 |  | SWITCHED_3V3_H | H / LEAKAGE MAX AND ENVIRONMENT OPEN
PRESENCE_SENSING_STUDY | R8 | 2 |  | USB_PRESENT_H | H / LEAKAGE MAX AND ENVIRONMENT OPEN
PRESENCE_SENSING_STUDY | R9 | 1 |  | SWITCHED_3V3_H | H / LEAKAGE MAX AND ENVIRONMENT OPEN
PRESENCE_SENSING_STUDY | R9 | 2 |  | OBD_PRESENT_H | H / LEAKAGE MAX AND ENVIRONMENT OPEN
PRESENCE_SENSING_STUDY | C1 | 1 |  | SWITCHED_3V3_H | H / LOCAL VCC DECOUPLING
PRESENCE_SENSING_STUDY | C1 | 2 |  | GND_STUDY | H / LOCAL VCC DECOUPLING
PRESENCE_SENSING_STUDY | J1 | 1 | Pin_1 | USB_RAW_H | CANDIDATE
PRESENCE_SENSING_STUDY | J1 | 2 | Pin_2 | AON_PROTECTED_H | CANDIDATE
PRESENCE_SENSING_STUDY | J1 | 3 | Pin_3 | SWITCHED_3V3_H | CANDIDATE
PRESENCE_SENSING_STUDY | J1 | 4 | Pin_4 | GND_STUDY | CANDIDATE
PRESENCE_SENSING_STUDY | J2 | 1 | Pin_1 | USB_PRESENT_H | CANDIDATE
PRESENCE_SENSING_STUDY | J2 | 2 | Pin_2 | OBD_PRESENT_H | CANDIDATE
PRESENCE_SENSING_STUDY | J2 | 3 | Pin_3 | GND_STUDY | CANDIDATE
PRESENCE_SENSING_STUDY | #FLG1 | 1 |  | SWITCHED_3V3_H | CANDIDATE
PRESENCE_SENSING_STUDY | #FLG2 | 1 |  | GND_STUDY | CANDIDATE
