Ale1x/auto-gauge/hardware/usb_power/design_v01/study_pin_matrix.csv

sheet | reference | pin | pin_name | net | status
USB_PREREGULATOR_STUDY | U1 | 1 | PGND | GND_STUDY | H / LOW-VIN DROPOUT AND STARTUP OPEN
USB_PREREGULATOR_STUDY | U1 | 2 | VIN | BENCH_AFTER_PROTECTION_OPEN | H / LOW-VIN DROPOUT AND STARTUP OPEN
USB_PREREGULATOR_STUDY | U1 | 3 | EN | ENABLE_QUALIFIED_OPEN | H / LOW-VIN DROPOUT AND STARTUP OPEN
USB_PREREGULATOR_STUDY | U1 | 4 | AGND | GND_STUDY | H / LOW-VIN DROPOUT AND STARTUP OPEN
USB_PREREGULATOR_STUDY | U1 | 5 | FB | USB_PRE_FB | H / LOW-VIN DROPOUT AND STARTUP OPEN
USB_PREREGULATOR_STUDY | U1 | 6 | VOS | USB_PRE_H3V792 | H / LOW-VIN DROPOUT AND STARTUP OPEN
USB_PREREGULATOR_STUDY | U1 | 7 | SW | USB_PRE_SW | H / LOW-VIN DROPOUT AND STARTUP OPEN
USB_PREREGULATOR_STUDY | U1 | 8 | PG | PG_STUDY_NOT_MCU_GPIO | H / LOW-VIN DROPOUT AND STARTUP OPEN
USB_PREREGULATOR_STUDY | U1 | 9 | PAD | GND_STUDY | H / LOW-VIN DROPOUT AND STARTUP OPEN
USB_PREREGULATOR_STUDY | L1 | 1 | 1 | USB_PRE_SW | H / SOURCE STOCK0 / HOT CURVE OPEN
USB_PREREGULATOR_STUDY | L1 | 2 | 2 | USB_PRE_H3V792 | H / SOURCE STOCK0 / HOT CURVE OPEN
USB_PREREGULATOR_STUDY | C1 | 1 |  | BENCH_AFTER_PROTECTION_OPEN | H / BIAS ENVELOPE OPEN
USB_PREREGULATOR_STUDY | C1 | 2 |  | GND_STUDY | H / BIAS ENVELOPE OPEN
USB_PREREGULATOR_STUDY | C2 | 1 |  | BENCH_AFTER_PROTECTION_OPEN | H / BIAS ENVELOPE OPEN
USB_PREREGULATOR_STUDY | C2 | 2 |  | GND_STUDY | H / BIAS ENVELOPE OPEN
USB_PREREGULATOR_STUDY | C3 | 1 |  | USB_PRE_H3V792 | H / BIAS ENVELOPE OPEN
USB_PREREGULATOR_STUDY | C3 | 2 |  | GND_STUDY | H / BIAS ENVELOPE OPEN
USB_PREREGULATOR_STUDY | C4 | 1 |  | USB_PRE_H3V792 | H / BIAS ENVELOPE OPEN
USB_PREREGULATOR_STUDY | C4 | 2 |  | GND_STUDY | H / BIAS ENVELOPE OPEN
USB_PREREGULATOR_STUDY | R1 | 1 |  | USB_PRE_H3V792 | H / NOT PURCHASE APPROVED
USB_PREREGULATOR_STUDY | R1 | 2 |  | USB_PRE_FB | H / NOT PURCHASE APPROVED
USB_PREREGULATOR_STUDY | R2 | 1 |  | USB_PRE_FB | H / NOT PURCHASE APPROVED
USB_PREREGULATOR_STUDY | R2 | 2 |  | GND_STUDY | H / NOT PURCHASE APPROVED
USB_PREREGULATOR_STUDY | R3 | 1 |  | ENABLE_QUALIFIED_OPEN | H / NOT PURCHASE APPROVED
USB_PREREGULATOR_STUDY | R3 | 2 |  | GND_STUDY | H / NOT PURCHASE APPROVED
USB_PREREGULATOR_STUDY | R4 | 1 |  | USB_PRE_H3V792 | H / NOT PURCHASE APPROVED
USB_PREREGULATOR_STUDY | R4 | 2 |  | PG_STUDY_NOT_MCU_GPIO | H / NOT PURCHASE APPROVED
USB_PREREGULATOR_STUDY | J1 | 1 | Pin_1 | BENCH_AFTER_PROTECTION_OPEN | EXTERNAL BENCH INTERFACE ONLY
USB_PREREGULATOR_STUDY | J1 | 2 | Pin_2 | GND_STUDY | EXTERNAL BENCH INTERFACE ONLY
USB_PREREGULATOR_STUDY | J1 | 3 | Pin_3 | ENABLE_QUALIFIED_OPEN | EXTERNAL BENCH INTERFACE ONLY
USB_PREREGULATOR_STUDY | J2 | 1 | Pin_1 | USB_PRE_H3V792 | TEST ONLY / MUX NOT CONNECTED
USB_PREREGULATOR_STUDY | J2 | 2 | Pin_2 | GND_STUDY | TEST ONLY / MUX NOT CONNECTED
USB_PREREGULATOR_STUDY | J2 | 3 | Pin_3 | PG_STUDY_NOT_MCU_GPIO | TEST ONLY / MUX NOT CONNECTED
USB_PREREGULATOR_STUDY | #FLG1 | 1 |  | BENCH_AFTER_PROTECTION_OPEN | EXTERNAL BENCH SOURCE ONLY
USB_PREREGULATOR_STUDY | #FLG2 | 1 |  | GND_STUDY | EXTERNAL BENCH SOURCE ONLY
