Ale1x/auto-gauge/mobile/README.md

# Auto Gauge per iPhone

App SwiftUI in italiano con quattro sezioni: **Dispositivo, Schermate, Temi, Impostazioni**. Aspetto automatico, chiaro o scuro; un unico salvataggio per schermate e luminosità; catalogo di temi sportivi e creazione gratuita dei propri colori.

La modalità demo, inizialmente attiva, permette di provare tutte le funzioni senza hardware. È indicata da un solo banner superiore e si controlla dalle Impostazioni. Configurazione, due viaggi, backup e versione dell’aggiornamento demo persistono separatamente in `AutoGauge/demo/`; nessuna operazione demo usa radio, CloudKit, ricevute native qualificate o il provider OTA reale. La scheda del display è un’anteprima della configurazione, non una lettura live. Lo storico resta conservato nel modello e nel protocollo, ma non occupa una scheda della navigazione corrente.

La UI e le relative verifiche sono documentate in [DesignValidation/UX27](../docs/validation/ios/UX27/README.md). Il marketplace e la revisione delle superfici sono documentati in [DesignValidation/THEMES27](../docs/validation/ios/THEMES27/README.md). Le sezioni APP e i dettagli di protocollo più sotto documentano anche l’evoluzione storica del progetto.

La revisione compatta della panoramica e delle azioni di Schermate è documentata in [DesignValidation/SCREENS27](../docs/validation/ios/SCREENS27/README.md).

Le altre pagine e il nuovo primo avvio sono documentati in [DesignValidation/EXPERIENCE27](../docs/validation/ios/EXPERIENCE27/README.md).

## Introduzione iniziale

Il primo avvio propone tre pagine illustrate, scorrevoli e saltabili: il display, gli stili e il collegamento. Le immagini sono incluse nell’app e disponibili offline; sono illustrazioni introduttive, mentre le anteprime effettive dei temi restano nel marketplace. L’introduzione non cambia il tema salvato o i diritti di acquisto. La scelta finale apre la modalità dispositivo oppure la demo, senza iniziare automaticamente la ricerca Bluetooth. `onboarding.completed.v1` ricorda il completamento; anche Salta conclude l’introduzione. Le installazioni precedenti senza indicatore la vedono una volta dopo questo aggiornamento.

Il pulsante temporaneo **Impostazioni → Rivedi introduzione** riapre il percorso. Non cancella impostazioni o dati. I test UI ordinari evitano la presentazione automatica; i casi dedicati aggiungono `--uitesting-onboarding` per verificare primo avvio, completamento, ripetizione e scelta della modalità.

## Temi e acquisti

Il catalogo include il tema originale gratuito e 59 temi a pagamento, fra interpretazioni sportive e creazioni originali, con prezzo iniziale approvato di 1,99 € per tema. Il creatore di colori è gratuito. Dieci famiglie grafiche comprendono sport, pixel/16 bit, arcade, terminale, synthwave, analogico, minimal, blueprint, endurance e rétro. I 60 temi complessivi si esplorano per categoria; la ricerca ha una pagina dedicata e la creazione vive nella raccolta personale. Colori e intestazioni dei temi cambiano solo il quadrante: sfondi e superfici dell’app mantengono la palette adattiva comune.

La demo permette anteprima, aggiunta alla raccolta e selezione senza addebiti; proprietà e selezioni demo sono separate dallo stato reale. StoreKit gestisce prodotti non consumabili, transazioni verificate, ripristino e aggiornamenti dei diritti. Gli acquisti reali sono disabilitati da `AutoGaugeThemePurchasesEnabled = false`: prima di attivarli occorrono i prodotti App Store Connect e il supporto di consegna del tema al display reale, assente nell’attuale schema BLE. La selezione modifica ora le anteprime dell’app; non viene inviata al firmware come tema.

`Config/Themes.storekit` è un catalogo locale per sviluppo, rigenerato da `scripts/generate_theme_store.py` (invocato dal generatore del progetto). Non viene attivato automaticamente nello schema. Per le verifiche StoreKit locali, selezionarlo nell’azione Run di uno schema di sviluppo e abilitare il gate solo in quella build; ripristinare il gate prima di distribuire. Il catalogo locale non crea prodotti su App Store Connect. Nessun logo ufficiale o affiliazione è dichiarato.

## Target corrente

Dal 25 ottobre 2026 il target minimo dell'app e del package GaugeCore è **iOS 27.0** (DEC-015), compilato con Xcode 27/Swift 6.4 e SDK iOS 27. La navigazione usa direttamente `Tab`, senza fallback iOS17. Le sezioni APP-04…APP-16 e le immagini conservano le verifiche storiche con target precedente; non dimostrano esecuzione sul runtime iOS27. Il generatore del progetto conserva il nuovo minimo anche nelle build cloud-development.

## Avvio e verifica

Dalla radice del repository:

```sh
python3 mobile/scripts/generate_project.py
swift test --package-path mobile
xcodebuild -project mobile/AutoGauge.xcodeproj -scheme AutoGauge -sdk iphonesimulator -configuration Debug -derivedDataPath mobile/DerivedData build CODE_SIGNING_ALLOWED=NO
```

Aprire `mobile/AutoGauge.xcodeproj`, schema condiviso `AutoGauge`, simulatore iPhone. Il generatore usa soltanto Python standard, scopre i file Swift per feature, configura gli asset e rigenera le risorse demo dalle fixture condivise. Non serve XcodeGen.

Bundle approvato: `it.ale1x.autogauge`. La configurazione predefinita resta senza firma e senza entitlement cloud. Team/container approvati e opzione esplicita `--cloud-development` sono descritti in [Config/README.md](Config/README.md). Il flag prepara il progetto, non esegue provisioning né avvia CloudKit. Non sono state modificate impostazioni dell’account Apple o pubblicato nulla.

## App e stato

- `App/AutoGaugeApp.swift` è il solo entry point; `App/Model/AppModel.swift` coordina le azioni con @Observable/@MainActor.
- `App/Features/` separa dispositivo, dashboard, temi, impostazioni e storico; `App/Navigation/` mantiene destinazioni tipizzate e stato per scena.
- `App/Design/` e `App/Components/` raccolgono theme, colori adattivi e azioni con area minima44pt. L’aspetto Automatico segue il sistema; Chiaro e Scuro sono preferenze esplicite persistite.
- `Sources/GaugeCore/` contiene configurazione/editor, framing, archivio storico e `Simulation/` con endpoint/canale in memoria. Il package è testabile su host senza SwiftUI.

La UI espone **Salva modifiche**. Il modello conserva separatamente bozza, salvataggio locale e conferma del dispositivo. Quando il dispositivo reale è scollegato, il salvataggio resta sul telefono e indica che il display deve essere aggiornato. Alla riconnessione il confronto con la configurazione letta ricostruisce le modifiche pendenti; un esito sconosciuto richiede lettura/riconciliazione senza ripetizione cieca della scrittura.

Annulla torna all’ultimo salvataggio locale. Il ripristino delle impostazioni iniziali, nel menu con conferma, usa solo misure disponibili e richiede poi Salva modifiche. Le scritture locali sono atomiche. La prima apertura migra l’eventuale precedente configurazione demo locale.

## Roundtrip configurazione e connessioni

APP-08 usa `DevelopmentGaugeTransport` → `GaugeRPCClient` → `InMemoryGaugePacketPipe`: encode richiesta → decode endpoint → encode risposte → decode client per `hello`, `config.get`, `config.validate`, `config.apply`, `logs.read` e `logs.ack`. Verifica kind, requestID, versione, fase e revisione. `SimulatedGaugeTransport` APP-04 resta disponibile solo per compatibilità/regressioni. Le capability del mock sono esattamente sette PID Service01:04/05/0C/0D/0F/10/11; non sono una promessa di supporto di una vettura o di tutti i PID standard.

Applicare richiede `expected_revision` corrente e nuova revisione corrente+1. `received` è distinto da `applied`/`persistence=volatile`. Se il link cade prima del commit, il pending può essere annullato; se il device committa e l’ACK si perde, il client mantiene l’esito **sconosciuto**, conserva la bozza e deve rileggere dopo riconnessione. Nessun rollback o retry cieco e nessuna falsa conferma di persistenza flash.

Il canale consente una sola connessione attiva e lega i pending a lease + requestID. Client A/B/A possono collegarsi in sequenza senza reset; callback del vecchio lease non agiscono sul nuovo. Non c’è owner unico persistente. Token e CRC sono strumenti di simulazione/correlazione, non autenticazione. Il trasporto reale `UnconfiguredGaugeTransport` continua a rifiutare le scritture.

## Editor

Limiti1–3 dashboard e1–5 widget; ID stabili dopo rimozioni, geometrie su griglia intera0–10000. Selezione dalla lista o anteprima, trascinamento, slider e stepper coerenti con gli stessi metodi core. I riquadri che superano il bordo circolare producono un avviso senza cambiare la validazione rettangolare condivisa.

Target minimo **iOS 27**, editor libero, font e disposizione sono ipotesi di sviluppo per O-10/O-23. Il modello non dichiara fit finale del pannello. Ai font di accessibilità lista e controlli conservano nomi, selezione e funzioni con testo dinamico; i controlli di posizione e dimensione sono espressi in percentuale. Nessuna dashboard live sull’iPhone.

## Storici

L’app importa pagine dal ring volatile del gauge simulato attraverso `logs.read`, salva prima sul telefono e invia `logs.ack` solo dopo write riuscita. L’ACK non elimina il buffer sorgente per altri telefoni. Ogni installazione ha un proprio cursore device/session; si riparte dal cursore locale per il resume. Le fixture storiche del protocollo includono sequenze3–6 e perdita1–2 per le regressioni. La UI demo corrente usa due viaggi separati, con 960 letture e quattro misure.

`LogModels.swift` conserva sequenze/tempi uint64 come stringhe decimali canoniche, anche oltre2^53 e fino aUInt64.max, senza Double. Pagine con record/status/raw incoerenti, chiavi duplicate/sconosciute, primitive fuori tipo o gap non dichiarati vengono rifiutate. Gli stati non disponibili mostrano `—`; i validi sono visualizzati mediante i decoder delle misure supportate, senza esporre i byte del protocollo. Nessuna data assoluta viene ricostruita senza un’ancora affidabile.

`LocalLogArchive` prepara snapshot candidati e li rende attivi soltanto dopo sostituzione atomica del file. Duplicati identici sono idempotenti; conflitti o errori storage preservano lo snapshot e non producono ACK nuovo. Se un ACK verso il simulatore fallisce dopo la write locale, il salvataggio rimane valido e la mancata conferma è dichiarata.

Limiti **del prototipo**, non retention di prodotto/cloud:512KiB di file,1024record complessivi,16sessioni e128intervalli coalescenti; pagina4096byte/max16record/max16intervalli. A pieno si rifiuta la nuova pagina senza eviction. Una sola istanza actor per file, nessun coordinamento fra processi. Atomicità file non significa durabilità a ogni power loss o policy finale di protezione/backup iOS.

Il pulsante Aggiorna viaggi aggiorna la demo senza duplicare i dati. Le risorse demo derivano da `shared/fixtures/` tramite `generate_demo_logs.py`; non vengono caricate sul cloud.

## iCloud e manutenzione

DEC-012 sceglie account iCloud del telefono e CloudKit senza account email separato. L’adapter nativo APP-05 usa la banca dati privata Development: l’azione Sincronizza verifica l’account e poi aggiorna la copia; Recupera viaggi verifica l’account e recupera i dati. Una verifica account riuscita non equivale a backup. Configurazione e blocco Apple Developer Program sono descritti in [Config/README.md](Config/README.md).

La build predefinita unsigned e tutte le build simulatore non costruiscono CKContainer. Il factory reale richiede flag esplicito e un profilo Development incorporato, non scaduto, con Team/app/container/servizio CloudKit approvati; il controllo del template non sostituisce la verifica della firma/provisioning da parte di iOS. I dettagli tecnici Apple restano nella configurazione, fuori dalla UI.

**L’archivio corrente contiene soltanto simulazione.** La UI non lo accoda al cloud, anche su build firmata: `enqueue(..., provenance: .simulation)` viene rifiutato dal core. Non esiste ancora un produttore di storici da radio reale. La sync esplicita può elaborare solo una coda reale già predisposta; senza record reali mostra “Nessuno storico reale”, senza dichiarare backup riuscito. Fixture e test sintetici restano locali/fakeDB.

`CloudHistoryOutbox` salva atomicamente in `cloud-outbox-v1.json`: massimo512 KiB,1024 elementi complessivi e8 contesti account. Il prototipo trattiene anche le ricevute già confermate: al limite rifiuta nuovi inserimenti con errore visibile, senza cancellare pending, archivio o cloud. Nessuna retention cloud è imposta. Un actor possiede un file, senza coordinamento tra processi. Reload/scritture fallite preservano lo snapshot; dopo errore di reload gli inserimenti sono bloccati. Nessun upload automatico/background o migrazione di coda tra account.

Schema cloud immutabile1: tipo `AGHistoryV1`, campi `schemaVersion`, `payload` JSON canonico e `digest` SHA256. Ogni payload contiene device/session e un record oppure intervallo di perdita esplicita; sequence/monotonic_ms restano stringhe uint64. Il recordID è SHA256 dell’identità device/session/sequence (o estremi della perdita), separato dal digest contenuto. Il digest rileva incoerenze, non autentica i dati. Una fetch identica o un conflitto di creazione identico confermano l’idempotenza; contenuto diverso blocca la coda senza sovrascrivere il server (`ifServerRecordUnchanged`). Non vengono caricate dashboard/configurazione né date assolute inventate. APP-05 offre upload e riconciliazione dei singoli record; APP-06 aggiunge il recupero paginato descritto sotto, senza promettere download atomico/completo o unificazione remota delle sessioni. Le ricevute già confermate non vengono riverificate contro cancellazioni/modifiche cloud successive: il contatore indica conferme passate, non un audit attuale del backup.

Il contesto deriva dall’identificatore utente CloudKit, conservato localmente solo come digest. Un cambio account invalida la generazione e annulla il task/operazione di salvataggio in corso; anche i controlli prima e dopo gli await impediscono ricevute locali per un contesto vecchio. La coda precedente resta separata e si riprende solo dopo nuova verifica di quell’account e azione esplicita. Se un salvataggio remoto riesce ma la risposta o la scrittura locale si perde, il pending viene conservato e il retry verifica il record immutabile: non si presume rollback remoto. Annullare non elimina record già ricevuti dal server. I controlli account pre/post e la cancellazione sono difese del client: il SDK non offre in questa API una precondizione server atomica sull’identità account, quindi resta da verificare sul dispositivo il cambio account durante una richiesta già in volo. L’ACK gauge resta esclusivamente conferma di salvataggio locale e non dipende da iCloud.

Il reset fisico USB è manutenzione separata dal cambio telefono: cancellerà credenziali, configurazione e log locali del gauge, senza cancellare cloud o storici già sincronizzati. Questa app non esegue reset reali.

## Verifiche APP-04

Con Xcode27.0 (27A266a), Swift6.4, SDK iOS Simulator27.0: **42 test Swift superati**, build Debug arm64/x86_64 riuscita. Suite:22 casi configurazione,15 vettori framing,8 scenari storico con riapertura a ogni operazione e10 scambi RPC golden condivisi, oltre ai test di failure/disconnessione/revisione/lease/limiti. Nessun dispositivo fisico o BLE reale testato.

Installazione/avvio locale sul simulatore iPhone17Pro/iOS26.4 riusciti. L’archivio prodotto dal bootstrap del nuovo bundle contiene quattro record della sessione05…, perdita1–2 e cursore6, dopo roundtrip attraverso il simulatore.

La [verifica design](../docs/validation/ios/README.md) descrive rendering statici ImageRenderer light/dark,320/640pt e DynamicType accessibility3, contrasto misurato e limiti. Non è un collaudo interattivo completo di VoiceOver o di tutte le schermate native. CUA non espone Simulator.app in questa sessione. La sola compilazione non è stata presentata come verifica visiva.

## Verifiche APP-05

Gli11 test fakeDB/cloud coprono offline/reopen/resume, idempotenza, conflitti locali/remoti, errore scrittura dopo commit remoto, rifiuto fixture, account change durante await e dopo commit, cancellazione, uint64 oltre2^53/fino aUInt64.max, perdite esplicite, decoder diretto invalido, limiti e reload corrotto. Nessun test contatta Apple. Build simulatore e device unsigned verificano la compilazione; cloud live non verificato per mancanza membership/profilo. Schermata Account usa componenti SwiftUI Pro con controlli44pt, etichette italiane e testo dinamico; verifica VoiceOver su dispositivo resta manuale.

## Recupero iCloud APP-06

`CloudHistoryPullDatabase` espone pagine opache account-local; l’adapter usa `CKQueryOperation` su `AGHistoryV1` nella private DB e richiede soltanto schemaVersion/payload/digest. Legge al massimo16 record per pagina; il core accetta payload≤4096 byte, somma payload/identità/digest≤64KiB, cursore opaco≤64KiB e1–8 pagine per azione. Il limite di64KiB riguarda la pagina applicativa, escluso cursore; i callback SDK ricevono comunque un CKRecord prima dei controlli (limiti SDK/servizio distinti). Nessuna API di streaming campi CloudKit viene dichiarata. Cancellazione annulla CKQueryOperation e impedisce checkpoint tardivi.

L’archivio dedicato `cloud-restored-v1.json` mantiene massimo512KiB/1024 elementi/8 account complessivi. Elementi e checkpoint della pagina vengono salvati con una sola write atomica; nessun avanzamento su conflitto, digest/identità errata, errore parziale query o write fallita. Pagine precedenti già scritte restano recuperate anche se una successiva fallisce. Il resume riparte dal cursore persistito di quell’account; la UI richiede verifica account prima di selezionare/rileggere l’archivio, quindi dopo cold launch senza accesso iCloud non espone automaticamente un account precedente. Il pieno blocca nuove pagine senza espellere dati. L’archivio non viene accodato automaticamente all’upload e non invia ACK al gauge.

Il merge differisce dall’import diretto del gauge: una loss è un’**osservazione**, non assenza globale. Un record di B dentro una perdita segnalata da A viene conservato insieme all’intervallo osservato; non è corruzione. Schema1 non conserva l’identificatore del telefono osservatore, quindi non viene inventata una provenienza individuale non disponibile. Intervalli osservati sovrapposti rimangono elementi separati; record device/session/sequence identico si deduplica, contenuto diverso con stessa identità blocca tutta la pagina. Dispositivi/sessioni diversi restano distinti. Il ripristino non forza contiguità né un ACK sequenziale globale, non cancella dati locali e non deduce cancellazioni remote.

Il cursore CKQuery viene archiviato via NSSecureCoding e vincolato al contesto account. Cursor non decodificabile o errore CloudKit invalidArguments/changeTokenExpired durante continuation produce richiesta di nuova scansione, senza restart nascosto o eliminazione dei dati. La nuova scansione è un pulsante esplicito e azzera solo checkpoint/stato di traversata; i record già recuperati restano. Quello che termina è **una scansione**, non una fotografia completa/atomica del backup: [Apple precisa che il cursore non è uno snapshot](https://developer.apple.com/documentation/cloudkit/ckqueryoperation/init(cursor:)) e che [gli indici query si aggiornano in modo asincrono](https://developer.apple.com/documentation/cloudkit/ckqueryoperation/recordmatchedblock-7kek0). Inserimenti/delezioni fra pagine possono causare risultati ripetuti o saltati; ripetere una scansione riconcilia gli elementi trovati ma non dimostra completezza. Non si usano offset sequenziali fabbricati o tempi assoluti come watermark.

Account offre recupero/continua, nuova scansione, cancellazione e navigazione all’elenco cloud separato dagli esempi. I record mostrano stato/raw/tempo relativo; le perdite osservate hanno una spiegazione distinta dalla disponibilità cloud. Il banner globale riguarda il collegamento dispositivo simulato; l’archivio iCloud è etichettato come sorgente separata. Default unsigned/simulatore resta disabilitato e nessuna fixture viene inviata. Nessuna chiamata live/provisioning è stata eseguita. Membership/profilo restano necessari; query/schema/indici non sono stati verificati sul servizio.

Test fakeDB aggiunti: merge loss+record, identità device/session, contatori unsigned64, pagina atomica, offline/reopen/checkpoint, retry deduplicato, conflitti con rollback, digest/ID, cursor scaduto/restart, cambio account durante read/account await, cancellazione, pagine vuote/budget, ripartenza esplicita dopo scan terminata, bounds count/bytes e reload corrotto. I test rimangono locali, senza Apple.

## Bluetooth nativo di sviluppo APP-07

`shared/gatt.profile.json` è copiato deterministicamente in GaugeCore/Resources dal generatore; `GaugeGATTProfile` verifica UUID distinti/versione/tipi interi/limiti e non duplica UUID nel client. `NativeBluetoothController` non costruisce CBCentralManager all’avvio: occorrono toggle sviluppo e pressione esplicita su Avvia ricerca. La descrizione privacy `NSBluetoothAlwaysUsageDescription` è italiana, nella lingua unica dell’app. Nessun test o tool ha attivato la radio, cercato o collegato hardware.

Ricerca filtrata per servizio per massimo10s e20 candidati, nessun connect automatico; un solo peripheral e una sola write/read in attesa. Connect/discovery/CCCD hanno limite30s H. La scrittura usa esclusivamente `.withResponse` e attende callbackATT per ogni chunk≤min(maximumWriteValueLength,512); il canale non è pronto prima della conferma CCCD. La caratteristica risposta deve offrire indicazioni senza proprietà notify concorrente (CoreBluetooth non consente di scegliere arbitrariamente fra entrambe). Nessun MTU o payload20/512 è assunto garantito. Cancel, uscita schermata e background fermano scan/link; nessun background mode, reconnect o retry infinito. Le richieste si annullano alla chiusura. Proxy delegate per lease/generazioni, identità di central/peripheral/caratteristiche e ricreazione manager al nuovo scan impediscono riuso intenzionale di callback/chunk fra collegamenti.

Lo stream AG usa `GaugeStreamReassembler`: un frame incompleto≤4112byte, chunk≤512, header/version/kind/ID/reserved/length e CRC controllati, nessuna ricerca di magic dentro dati corrotti. Timer assoluto10s dal primo byte, non rinnovato dai frammenti. Il nativo valida all’arrivo anche se l’ultimoACKATT è ancora pendente: conserva il solo frame incompleto e mette in coda soltanto frame completi validati (coda separata≤4112byte, poi frammenti≤512 per il pipe). Coda piena/indicazioni non richieste/corruzione chiudono il link senza troncare dati. Il clientRPC ha un ulteriore assembler bounded e deadline assoluta30s per richiesta, compresa la scrittura; i timer scadono anche senza nuovi bytes. Questi sono parametri H, non throughput qualificato.

`GaugeRPCClient` è indipendente da CoreBluetooth e testabile con packetpipe finto: una richiesta in volo, requestID crescente nonzero nella connessione, nessun reset ID su open ripetuta/stessa generazione o wrap. Verifica op/kind/ID/versione/fase/capability, distingue received da applied e legge configurazione soltanto dopo hello/capability valide. La configurazione letta passa il validator con i soli PID dichiarati (ECUunknown, senza inventare supporto numerico). Il riferimento di sviluppo conferma solo persistence=volatile; niente durable simulato. Eventi non gestiti/risposte di altre richieste abortiscono il client invece di essere riusati.

Apply può aver committato già alla dispatch dell’ultimo chunk, anche se l’ACKATT manca: perdita link/timeout/errore produce esito sconosciuto, nessun rollback/retry cieco. Solo revision_conflict/invalid_configuration sono rifiuti precommit noti nel contratto di sviluppo; I/O dopo received resta ambiguo. Con esito sconosciuto una nuova apply è bloccata fino a config.get valido dopo riconnessione/hello. Le risposte già arrivate prima dell’ACKATT finale restano accodate. I test possono abilitare esplicitamente mutazioni su pipe finto (`allowTestMutations`); il percorso nativo mantiene sempre chiuso quel gate e non lo deduce da hello.authenticated o da ATT.

La UI nativa offre solo selezione/connessione/hello di sviluppo con stato **sicurezza non verificata**. Configurazione e log reali non sono collegati all’editor/importer, e ogni mutazione reale resta bloccata finché LESC/MITM/128bit/ammissione e server radio non sono provati. Il telefono non può osservare tutti i flag SMP: hello/CCCD/ATT non autenticano il server. Nessun codice fisso, bond wipe, reset per cambiare telefono o owner unico viene introdotto. Più telefoni sequenziali/una connessione restano DEC-011; iCloud è distinto. Futuro passo hardware: qualificare server/admission/indications e pairing con passkey sul gauge, poi collegare i flussi reali attraverso prove e nuovi gate espliciti.

Test host aggiunti: framing massimo/varie frammentazioni, CRC/header/kind/versione/ID, coalescing e partial, deadline assoluta con drip e senza bytes, limiti/profile condiviso, CCCD/writeLength, una richiesta, cancel/lease vecchi, gate anche con authenticated=true, received/applied primaACKATT, ultimoACKATT perso dopo commit, I/O ambiguo/rifiuto precommit, blocco retry fino a lettura validata. Build sim/device unsigned verificano compilazione, non pairing/radio/sicurezza. PNG DesignValidation sono snapshot APP-04 e non certificano la nuova pagina Bluetooth; form/list usano componenti italiani44pt/DynamicType. VoiceOver e hardware restano collaudi manuali non eseguiti.

Interop APP-07: le risposte legacy config current/validated/received/applied e rejected del contratto possono omettere op. Il client correla sempre requestID e operazione/fase pendente, limita l’omissione alle precise forme legacy e rifiuta op presente ma null/bool/numero/errato. Hello e successi logs richiedono op. Un rifiuto applicativo valido conclude la richiesta mantenendo sequenzaID/link, mentre frame extra o frammenti trailing nella stessa consegna provocano chiusura. Il replay end-to-end dei10scambi `shared/fixtures/rpc.exchanges.json` usa i payload originali senza aggiungere op e copre anche revision_conflict e session_mismatch; fixture/serverPython/C non sono stati modificati per adattarsi al fake. Errori I/O ambigui di apply continuano a produrre unknown/readback gate.

Verifica finale APP-07/interoperabilità: **89 test Swift passati** (84 precedenti +5 regressioni golden/forme legacy). Il replay copre tutti10gli scambi originali, senza op aggiunti nei payload. Build iOSsimulator e generic iOSdevice unsigned riuscite dopo il fix. La verifica indipendente/integrata non attiva radio, pairing, provisioning o cloud; native resta hello-only e la sicurezza server non è qualificata.

## Trasporto unificato e integrazione C APP-08

Editor e storico nella UI usano ora `DevelopmentGaugeTransport`, non più il client parallelo APP-04: stesso `GaugeRPCClient`/framing/reassembly del percorso host C. Il pipe in memoria frammenta richieste/risposte e conserva i payload originali del simulatore, senza aggiungere op alle risposte legacy. UI e file restano esplicitamente simulati/volatili. Il protocollo `DevelopmentGaugePacketPipe` richiede connessione locale esplicita; `NativeBluetoothController` non vi conforma, quindi questo adapter non apre configurazione/log/mutazioni BLE. Le API APP-04 e i vecchi nomi stato/risultato restano compatibili tramite alias.

Il transport coordina capability/identità, bozza validata, revisione attesa letta e nuova revisione device+1, snapshot e stato ricevuto/applicato/sconosciuto. La revisione del file bozza può essere41 mentre il device passa1→2: applicare non riscrive la bozza. Durante import storico, la guardia di operazione/lease copre lettura cursore→logs.read→write atomica del file→logs.ack; cambio lease dopo write lascia il file locale e segnala ACK non consegnato. La richiestaACK viene registrata nei test C solo dopo scrittura riuscita, mai dopo un errore filesystem.

`GaugeRPCPersistencePolicy` distingue `volatileDevelopment` da `hostDurableStore` **scelto esplicitamente dal test**. La policy verifica il label atteso, non dimostra da sola durabilità/auth. Gli stati `appliedHostDurable` significano file host C con readback verificato; non flashESP32, firmware firmato, alimentazione automotive o radio qualificata. La UI ordinaria mantiene policyvolatile. Hello.authenticated del CLI deriva da hookfixture esplicitamente trusted, non pairing fisico; non apre gate nativi.

Solo `Tests/GaugeCoreTests/CHostEndpointSupport.swift`, sotto `#if os(macOS)`, contiene Foundation.Process/POSIXpipe. Compila in directory temporanea il target firmware `gauge_device_endpoint_cli` usando CMake/toolchain esistenti (`AG_SANITIZERS=OFF` in questa integrazione; sanitizerC sono verifiche separate). Avvia un processo C persistente con `--trusted-fixture-admission --store-file PATH --control-file PATH`; `--seed-initial` è aggiunto soltanto alla prima creazione del file. Nessun Process, comando CMake, hookadmission o eseguibileC entra nell’app iOS. I payload AG sono binari originali, con read POSIX≤512 per non attendere artificialmente512byte su una risposta corta. Le sidecar fault/connect sono ASCII host-only, fuori dal wireRPC.

I test esercitano processi C veri, non golden sintetizzati: hello/get/validate/applydurable/readback; draft/save indipendente; logs.read/import AtomicLogFileStorage/reopen/ACK; errore filesystem reale che impedisceACK e retry degli stessi record; RPCrevisionstale; A→B→A nello **stesso PID** con snapshot aggiornato e cursori file separati, ACK senza erase del ring. ConfigstoreC reale su file8192byte usa flush/readback; i log restano la sorgente volatile seed5/seq3–6 del CLI, non log fisici del veicolo né flashhistorypersistente.

Con `drop-applied`, C committa ma tace dopo received: deadline del client e cancellazione terminano il processo host in attesa, conservando il file; reconnect avvia C sullo stesso store senza seeddefault e get verifica revisione2 prima di consentire apply3. `fail-after-marker` dimostra unknown anche dopo marker persistito ma readback I/O fallito; controllo host restoreIO+get risolve nello stesso processo. Non si presume rollback. Gli identificatori/proxy del client restano legati al lease: il pipe host mantiene il processo nei passaggi puliti A/B/A, ma lo termina in disconnect sporco (richiesta incompleta, risposta non consumata o lettura pendente) per impedire che un vecchio ID1 diventi la risposta del nuovo client ID1. Il file config resta; il ring seed ricreato dopo reboot è esclusivamente una fixture host, non un reset di prodotto.

Verifica APP-08: **105 test Swift passati**, inclusi89precedenti,2testtransportunificato,10testprocessoC e4test diagnostici/negative aggiuntivi. La regressione aggiuntiva abbandona deliberatamente helloID1 non consumato e prova che il nuovo client non riceve quei byte. Il subprocesso viene terminato/teardown e buildtemporanei eliminati; i test non richiedono rete, radio o provisioning. Buildsim/device unsigned compilano la UI con transportunificato. CloudKit e Nativehello-only restano invariati; nessun dato demo/Cfixture viene accodato al cloud. La durabilità host e l’ammissione trustedfixture non qualificano lo stackradio o i driverflash fisici.

Diagnostica APP-08: il client riconosce esclusivamente le forme C tipizzate `(diagnostic, configuration_not_operational, store_state)` per config.get/apply (stati read_only/capability_mismatch/no_valid_configuration/conflict/io_or_integrity_error), `(diagnostic, history_not_operational, read_only)` per logs.read/ack e `(outcome_unknown, outcome_unknown, commit_or_readback_failed)` solo per apply. Op esplicito deve corrispondere; omissione resta limitata a queste forme e alle legacy già previste. Extra configurazione/applied_revision/persistence, fase/operazione/stato incoerenti o op:null non producono una diagnosi accettata né uno snapshot corrente. Non sono stati cambiati payload/schema C per adattare il client.

`GaugeEndpointFailure`/Kind/StoreState e `lastEndpointFailure` conservano la causa tipizzata per test/diagnostica. La UI usa descrizioni italiane (“Configurazione non verificabile: archivio in sola lettura”), senza stampare store_state/codici sorgente. Apply diagnostico/outcome_unknown produce comunque unknownCommit+latch; un get diagnostico non cancella il latch. Il transport conserva lo snapshot precedente **stale**, richiede rilettura e non invia apply automatici. Il test C corrompe in-place il payload dello slot più recente lasciando un fallback READ_ONLY: quel fallback non diventa current, non sovrascrive la revisione2 confermata sul telefono e non abilita nuovi apply.

Exception safety del solo harness: letture pendenti sono legate alla generazione e il defer vecchio non azzera quella nuova. Prima di avviare un successore sullo stesso file, `confirmStopped` attende sia uscita del vecchio processo sia completamento del suo reader, con deadline2s; se non confermato, il nuovo writer non parte. Una cancellazione può lasciare cleanup in corso ma il connect seguente deve attendere la stessa conferma. Nessun SIGKILL o processo di terzi coinvolto. Il controllo sidecar viene scritto prima di pubblicare lease/avviare un processo; errore file non può lasciare active bloccato. Regressioni C coprono readA pendente→disconnect→B immediato, esito corrente verificato oppure diagnosi readonly dopo interruzione, e sidecar reso directory→nessun PID/lease esposto→retry riuscito dopo rimozione del blocco.

## Analisi storici APP-09

La pagina «Misure nel tempo» legge gli archivi già importati sul telefono e offre filtri per sessione, PID ed ECU. Il percorso Storici usa il file locale del gauge simulato; il percorso Account usa separatamente gli elementi effettivamente recuperati dall’archivio iCloud. Nessuna fixture diventa live, nessun dato viene creato dal grafico e nessuna operazione BLE/cloud viene attivata da questa pagina.

Sono qualificate soltanto sette formule, coerenti con `firmware/src/obd_decode.c`: carico04, refrigerante05, regime0C, velocità0D, aspirazione0F, portata aria10 e farfalla11. I raw escludono header Service/PID e devono avere la lunghezza esatta. Stato sorgente non valido, formula sconosciuta, lunghezza errata o regressione del contatore non diventano zero: rimangono righe diagnostiche con raw e contatori originali immutati. I valori zero validi restano zero.

Le linee uniscono campioni disponibili della stessa serie e si interrompono su qualità esclusa, regressioni temporali o buchi nella copia sequenziale globale. Non rappresentano una misura continua; una perdita contiene sequenze, non un intervallo temporale inventato. Le osservazioni di perdita cloud possono coesistere con record disponibili nello stesso intervallo; la UI distingue osservazione, record disponibili e sequenze mancanti nella copia, senza dedurre assenza globale. Sessioni e dispositivi rimangono distinti.

Il tempo del grafico è relativo al primo record della sessione: la sottrazione avviene in UInt64 prima della conversione in Double. Tabella e origine conservano contatori esatti in stringhe canoniche, anche oltre2^53 e fino aUInt64.max; per intervalli che superano la precisione intera diDouble è mostrato un avviso sull’asse approssimato. Non vengono fabbricate date assolute.

Limiti del prototipo: massimo1024 record/1024 osservazioni per sessione e1024 record nell’input importato, massimo240 punti sul grafico, tabella paginata50 righe. La decimazione seleziona soltanto punti originali, conserva estremi/globali e bordi dei segmenti quando il budget lo consente; se le interruzioni sono troppe usa soli punti senza false connessioni. Proiezioni cancellabili fuori dal MainActor e generazioni impediscono pubblicazioni obsolete al cambio filtro/archivio. Un errore non modifica l’archivio.

Verifica: **117 test Swift passati** (105 precedenti +12 formule/qualità/filtri/sessioni/perdite/UInt64/decimazione/bounds). Build simulatore e device unsigned riuscite. La [verifica visiva APP-09](../docs/validation/ios/APP09/README.md) contiene screenshot reali del simulatore light/dark e testo accessibile, con titolo e back nativi visibili. Il banner è inserito nei contenuti degli stack invece di coprire la barra di navigazione. VoiceOver interattivo, gesto back e tap fisico non sono stati eseguiti; i controlli usano navigazione SwiftUI nativa ed etichette italiane. Nessuna qualifica su hardware/radio/cloud live viene dedotta da questi esiti.

## Catalogo scalare APP-10

La copertura grafici passa da7a **53 PID scalari**, esattamente quelli implementati in `firmware/src/obd_decode.c` e descritti in `docs/firmware/DIAGNOSTIC_COVERAGE.md`. Questa sezione aggiorna il limite di sette formule descritto nell’incremento APP-09. Nessun PID composto/O2, stato/enum, OEM o servizio aggiuntivo viene proiettato arbitrariamente in un valore scalare. Per tutti gli altri PID resta «formula non disponibile nell’app».

Nomi italiani, unità, lunghezza raw esatta e coefficienti razionali rispettano il decoder C; nessun clamp ai normali valori fisici. Restano preservati in particolare22=79U16/1000,43=100U16/255 (massimo25700%),44=U16/32768 comandato e non lambda misurata,5D=U16/128−210 con frazioni eA6=U32/10 unsigned fino429496729,5km.5B indica vita residua del pacco ibrido.42 rimane tensione centralina, senza promuoverla a tensione misurata ai morsetti della batteria. Raw/status originali e separazione qualità/perdite non cambiano.

Timeline e filtri usano automaticamente le53 etichette e unità quando tali PID sono presenti nell’archivio. Il Catalogo misure mostra separatamente i PID dichiarati dal gauge simulato e le formule disponibili per gli storici: la presenza della formula non dichiara supportoECU, non aggiunge misure al mock o all’editor e non attiva discovery/polling. Nessuna modifica ai gate BLE/cloud.

Verifica: **121 test Swift passati**, inclusi117 precedenti e4 nuovi test di catalogo. Il confronto indipendente carica readonly `shared/fixtures/diagnostic-scalars.cases.json`:212 vettori generati eseguendo il vero parser C,53PID per minimo/metà/massimo/pattern, con valori, byteCount e unità. Ulteriori prove coprono allowlist precisa su256PID, lunghezze0…8 e raw non canonici per ogni formula, tutti i6status per ciascuno dei53PID, preservazione raw e casi frazionari/U32 espliciti. Il generatore/oracle C è gestito dal coordinatore, distinto dall’implementazione Swift. Build simulatore e device unsigned riuscite; nessuna prova radio, veicolo o cloud live viene dedotta da questo confronto. Nessun redesign o nuovo framework; iOS17 resta il target minimo.

## Verifica pacchetto OTA offline APP-11

`OTAPackageVerifier.verify(envelope:image:trustedKeys:hardwareID:inactiveCapacity:acceptedCounter:)` è un’API sincrona del core senza UI di download o updater. Il chiamante fornisce hardwareID, capacità effettiva dello slot inattivo, soglia di release fidata/durevole e una mappa locale di chiavi pubbliche fidate. Il pacchetto non può fornire una propria trust anchor. Non sono incluse chiavi di prodotto; nessuna chiave privata è presente nel core, nell’app o nei file versionati.

Envelope1…4096byte, oggetti con schema chiuso e rilevamento duplicati anche dopo decoding degli escape JSON, niente numeri frazionari/esponenziali/bool al posto di interi, trailingJSON, array o nesting arbitrario. Stringhe limitate al sottoinsieme ASCII del reference, hash esadecimale lowercase e releaseUInt64 come stringa canonica senza conversione inDouble. La serializzazione firmata usa esattamente `AUTO-GAUGE-OTA-MANIFEST\0V1\0` seguito dal JSON ASCII ordinato/compatto di `shared/reference/ota_manifest.py`.

Il parser conserva il limite generico64 caratteri di firmware_version del reference; la verifica **candidato ESP32-S3** aggiunge un gate esplicito di versione≤31 e image_bytes multiplo di16. Queste restrizioni concordate corrispondono al profilo del verificatore target e sono più strette della sola verifica Python generica: un pacchetto generico firmato può essere rifiutato come candidato ESP. Non viene confuso expected_reference con expected_package nei vettori comuni.

Chiavi pubbliche accettate soltanto come DER PKCS#1 RSAPublicKey, dimensione≤8192byte, struttura DER esatta/minimale senza dati trailing, modulo esattamente3072bit, attributi Security RSA/public/3072 e blocksize384. SPKI/PEM non vengono indovinati o convertiti dal core. Firma base64 canonica di384byte, `Security.framework` `.rsaSignatureMessagePSSSHA256`: l’header SecKey.h dell’SDK specifica MGF1-SHA256 e salt32byte per tale algoritmo. Nessun fallback a paddingPKCS1, salt automatico, algoritmi differenti o libreria esterna.

Dopo firma valida, la dimensione deve corrispondere esattamente a quella dichiarata e rientrare nei16MiB; CryptoKit SHA256 verifica i byte copiati. `VerifiedOTACandidate` conserva manifest, envelopeSnapshot e imageSnapshot in proprietà `let`, senza init pubblico o Codable che possano fabbricare un esito verificato. I byte vengono copiati profondamente; mutare la memoria sorgente o una successiva copia del chiamante non muta il candidato. Il chiamante deve evitare scritture concorrenti alla memoria d’ingresso durante la chiamata, come per ogni Data usato fra thread. Nessuno stato/floor/slot viene avanzato.

Il risultato attesta soltanto questo snapshot: non dichiara installazione, applicazione, formato immagine/descriptor/chip avviabile, SecureBoot, flash, boot selection, salute o rollback realmente eseguiti. Questi passaggi restano responsabilità del target e delle qualifiche successive. L’API non è collegata ai flussi BLE/cloud; nessun download, comando remoto o accesso a rete/radio è stato aggiunto. Per immagini grandi la futura UI dovrà chiamare questa API fuori dal MainActor, senza alterarne i byte fra verifica e uso.

Verifica: **130 test Swift passati** (121 precedenti +9 OTA). I test macOS eseguono esclusivamente il generatore condiviso `scripts/generate_ota_vectors.py` in cartella temporanea con chiavi effimere OpenSSL eliminate, poi verificano46casi con l’implementazione Swift nativa, non con un fake crypto. Coperti7pacchetti validi (ordine/whitespace/escape/limiti/counterMAX), salt20/MGF384/paddingPKCS1/domain errati, chiave3070bit/SPKI/trailing/garbage, hardware/trust/capacity/replay, schema/duplicati/overflow/trailing, profiloESP e immagine mutata/troncata/estesa. Prove aggiuntive confrontano i byte canonici esatti, bounds/profili, ragioni tipizzate e snapshot contro memoria NSMutableData successivamente alterata. Process/OpenSSL esistono solo nei test macOS e non entrano nel core o nel binario iOS. Build sim/device unsigned riuscite: compilazione, non prova updater fisico o test radio/cloud.

## Trasferimento OTA host APP-12

Il core aggiunge il codec binario bounded e `OTATransferSender`, un actor stop-and-wait che accetta solo `VerifiedOTACandidate`. Il gate `allowHostDevelopmentMutations` è chiuso per default: non è un'autorizzazione di produzione e nessun adapter BLE o controllo UI lo abilita. `OTATransferTransport` rappresenta una sessione host esterna già qualificata dal test, con generazione nonzero e scambio completo di payload AG correlati; framing, sicurezza radio e sessione fidata restano responsabilità del futuro adapter.

`upload(_:transferID:)` invia start, blocchi manifesto fino1024byte, begin, blocchi immagine fino1024byte e finish; termina in `ready`. `select()` è un'azione successiva esplicita. Ogni ACK deve avere16byte esatti e corrispondere a ID, fase e offset previsti; versioni/enum/flag riservati, trailing byte, rifiuti, ACK persi, deadline, cancellazioni e cambi generazione non producono avanzamenti inventati. Dopo una consegna incerta lo stato `unknown` è terminale: nessun retry, reset, resume, cancel o select automatico. Una select tentata conserva `selectionMayHaveChanged` anche se la risposta non arriva; selected non significa firmware avviato o sano.

Il deadline assoluto copre l'intera upload o la singola select; il trasporto deve rispettare cancellazione/deadline e rifiutare frame extra/obsoleti. La protezione actor impedisce upload/select sovrapposti anche durante un await. Il client conserva gli ultimi offset confermati e non considera la sola accettazione di un blocco prova di durabilità fisica. Contratto e confini: [OTA_TRANSFER_V0.1.md](../docs/protocols/OTA_TRANSFER_V0.1.md). Nessun download, flash, reboot, chiave di prodotto, floor durabile o aggiornamento operativo viene attivato da questa API.

I test consumano gli stessi vettori binari C/Swift e candidati verificati con vere firme OpenSSL/Security.framework. Il mock di trasporto è esplicitamente comportamentale: verifica sequenza e guasti, non firma target, flash o BLE. Le prove coprono upload fino ready, select separata, ACK esatti/alterati, gate, timeout, cambio generazione, busy/reentry e cancellazione prima/dopo consegna. L'interop con processo C è un controllo distinto del coordinatore.

Verifica APP-12: **143testSwift passati** (130precedenti +11codec/sender +2interop con processo C),41request e20response fixture condivise, build iOSsim e genericdevice unsigned riuscite. Le prove di processo C usano un sink comportamentale con consenso fixture esplicito, senza PSA/SDK/flash o radio; confermano il dialogo e il blocco dei retry dopo ACK perduto. Nessuna esecuzione OTA su iPhone o ESP32 è dedotta dalle build.

## Sessione OTA con frame AG APP-13

`OTAPacketTransport` collega `OTATransferSender` a un `GaugePacketPipe` esclusivo usando codec e reassembler AG esistenti. Non modifica i kind/frame RPC né sceglie una route in base al contenuto remoto. Il gate host è chiuso per default; `open()` osserva soltanto una connessione già pronta e non avvia scansione/pairing/radio. La generazione nonzero e il limite effettivo di write vengono fissati una volta. Un oggetto chiuso non si riapre e non riusa la pipe con RPC.

Ogni richiesta usa un ID AG crescente da1, un solo scambio alla volta e frammenti≤min(limite connessione,512). La risposta deve essere un unico frame kind2 con stesso ID e ACK OTA16byte valido: frame aggiuntivi o prefissi trailing nello stesso chunk, CRC, timestamp fuori dall'intervallo dello scambio, cambi di generazione/limite, timeout e cancellazione chiudono la sessione senza retry. Epoch verificati dopo gli await impediscono che un callback tardivo dopo `close()` pubblichi successo; close disconnette soltanto la generazione fissata. `currentGeneration()` durante uno scambio può osservare lo stato senza dichiarare BUSY o interromperlo. L'osservazione non dimostra autenticazione radio.

Otto test mirati passati: gate/readiness, frammentazione fino a1byte e cap512, ID consecutivi, ACK errati/extra/troncati/corrotti, timestamp futuro/precedente, cambio generazione/limite, deadline totale e frame dal primo byte, cancellazione, busy e close durante open/readiness/write/receive con callback tardivi. Le mock pipe rispettano cancellazione; anche la futura pipe deve farlo affinché le deadline della task group terminino bounded. L'interop framed con il processo C e le build vengono registrati separatamente dal coordinatore. [Contratto](../docs/protocols/OTA_FRAMED_V0.1.md). Nessun percorso BLE nativo, UI updater, flash o provisioning è abilitato da APP-13.

Verifica integrata APP-13: **153testSwift passati** (143precedenti +8packettransport +2framedinteropC), build iOSsim e genericdevice unsigned riuscite. Il processo C riceve frammenti request≤23byte e Swift riassembla ACK in chunk5byte; upload si ferma READY, select distinta. La perdita dell'ACK select dopo esecuzione C lascia UNKNOWN e impedisce un secondo tentativo. Il backend CLI resta comportamentale, senza SDK/PSA/flash o radio; nessuna esecuzione OTA fisica viene dedotta.

## Preparazione locale pacchetto OTA APP-14

La schermata Firmware permette di selezionare separatamente manifesto firmato e immagine tramite il file picker di sistema. `OTAPackagePreparation` copia file regolari con limiti4096byte/16MiB, usando accesso security-scoped e letture bounded, poi conserva gli snapshot nel proprio actor. Verifica firma/hash/policy con il verificatore nativo esistente fuori dal MainActor. Cambiare un input o fallire una nuova importazione invalida il candidato; file originali modificati dopo la copia non modificano il pacchetto già preparato.

`OTAPreparationTrust` arriva esclusivamente dal chiamante locale e copia profondamente le chiavi pubbliche; non è decodificato dal pacchetto o dall’archivio. Nel normale avvio il profilo è assente: la UI mostra il requisito e permette la selezione, senza inventare verifica/compatibilità o abilitare trasferimenti. Non esiste un import di trust anchor dal file scaricato né una chiave di prodotto incorporata. I profili nei test sono solo fixture esplicite, con chiavi private OpenSSL già eliminate dal generatore comune.

Un candidato verificato può essere salvato con sostituzione atomica in un unico file locale `AGOP`v1 con header chiuso/lunghezze e i soli byte envelope+immagine. Non si salvano trust, percorsi, un bit «verificato», stato installato o contatori accettati. Alla riapertura tutti i byte sono limitati e verificati nuovamente con il profilo/floor corrente; replay, alterazione, troncamento e trailing sono rifiutati senza riscrivere il file originale. Scrittura atomica non è una promessa di fsync/power-loss fisico. Cancellazione durante scrittura può seguire un salvataggio già avvenuto: la UI richiede verifica successiva e non dichiara rollback.

Stato UI sul MainActor con generazioni protegge le pubblicazioni obsolete; cancellazione mantiene il blocco fino all’invalidazione dell’actor. Etichette italiane, picker e Form nativi, nessun nuovo framework, download o comando OTA. Verifica locale non equivale a bootabilità/installazione. Il sender BLE resta disabilitato nella UI: questa preparazione non apre alcun gate nativo.

Verifica APP-14: **163testSwift passati** (153precedenti +10preparazione), build simulatore e genericdevice unsigned riuscite. Coperti save/reopen reale, floor corrente, archive corruption/truncation/trailing, limiti e tipi file, copie input/trust indipendenti, invalidazione, cancellazione e errore filesystem senza falsi successi. [Screenshot reali light/dark e limiti dell’ispezione](../docs/validation/ios/APP14/README.md). Progetto Xcode rigenerato per le nuove view; i3JSON risorse restano invariati. Nessun flash, radio, cloud live o provisioning attivato.

## Sessioni native predisposte APP-15

AppModel usa ora una sessione configurazione/storici astratta, con bozze simulate separate dalle bozze perdevice e archivio nativo indicizzato perdevice/sessione. `QualifiedGaugeTransport` richiede un provider di qualifica **locale**, legato a generazione e deviceID, ricontrollato a ogni RPC e prima del consumo delle risposte. Il provider dell’app resta `UnqualifiedNativeGaugeProvider`: nessun `hello.authenticated`, pulsante o dato del wire apre il gate. Il controller CoreBluetooth riserva una finestra di scambio alla sessione qualificata e invalida i callback per generazione.

`logs.sessions` fornisce un catalogo non-snapshot, ordinato perSID e mai interpretato come cronologia. Import locale committato prima dell’ACK; solo la sessione qualificata può creare receipt per l’inbox locale dei dati destinati al cloud. Il successivo spostamento nell’outbox è durevole prima della rimozione dall’inbox, e richiede un’azione account esplicita. Non si caricano fixture/demo. Un receipt già committato viene accodato anche se la UI ha cambiato sessione prima del ritorno dell’import.

Review del coordinatore: corretto il caso in cui una qualifica tardiva perA poteva aprire/scollegare il nuovopeerB. L’open RPC verifica ora la connessione attesa; cleanup usa soltanto la generazione tentata. Due regressioni dedicate passano; suite Swift finale175test e build iOSsim/device unsigned riuscite. I9test di sessione qualificata usano pipe/provider locali comportamentali; non sono una qualifica Bluetooth fisica.

Aggiornamento APP-15 recovery: lo snapshot archivio v2 salva record/cursore e intenti cloud qualificati nello stesso commit atomico. La riconciliazione locale consegna gli intenti all’inbox con deduplica e li rimuove dall’archivio solo dopo il commit inbox; crash o errore tra i file conservano una copia recuperabile. Errori di scrittura dall’esito ambiguo bloccano ulteriori mutazioni fino al reload. L’app recupera anche all’avvio senza connessione al gauge/account e riusa un solo actor per il file nativo. Archivi v1 e import simulati non acquisiscono provenienza qualificata. Dettagli e verifiche in [APP15_RECOVERY](../docs/mobile/APP15_RECOVERY.md). Il provider/route fisico resta da qualificare e il gate nativo predefinito resta chiuso; nessuna sync CloudKit live viene dedotta dai test.

## Flusso OTA collegato APP-16

La schermata Firmware collega ora la preparazione al sender con dipendenze locali iniettate da AppModel. `OTAInstallationController` mantiene una sola operazione attraverso la navigazione: progresso da ACK reali, termine READY, selezione successiva esplicita e confermata, UNKNOWN terminale senza retry, chiusura lease su annullamento/uscita. Con trust e provider di sessione qualificata configurati la UI chiama il percorso esistente; nel normale avvio le dipendenze sono assenti e vengono mostrate chiaramente. Nessun fake provider, downloader, chiave prodotto o qualifica fisica è stato aggiunto. Dettagli del contratto provider e limiti dopo crash in [APP16_INSTALLATION](../docs/mobile/APP16_INSTALLATION.md).
