Ale1x/auto-gauge/docs/mobile/README.md

# App iPhone

Guide tecniche iOS. Il punto di ingresso del modulo resta mobile/README.md; DEVELOPMENT descrive la postazione e i comandi correnti.

- [APP15_RECOVERY.md](APP15_RECOVERY.md) — APP-15 — recovery degli intenti storici qualificati
- [APP16_INSTALLATION.md](APP16_INSTALLATION.md) — APP-16 — preparazione e trasferimento OTA raggiungibili dalla UI
- [APPLE_CONFIGURATION.md](APPLE_CONFIGURATION.md) — Configurazione Apple approvata per CloudKit
- [DEVELOPMENT.md](DEVELOPMENT.md) — Sviluppo iOS locale
- [IOS27_MIGRATION.md](IOS27_MIGRATION.md) — Migrazione iOS 27 — 25 ottobre 2026
