Ale1x/auto-gauge/docs/product/README.md

# Prodotto

La specifica v0.2 è la baseline; applicare le successive decisioni in ../project/DECISIONS.md.

- [SPEC_V0.2.md](SPEC_V0.2.md) — OBD-II Smart Gauge — Specifica di prodotto e hardware
