Ale1x/auto-gauge/docs/protocols/README.md

# Protocolli e policy condivise

Contratti documentati fra app e dispositivo. Schema, fixture e codice di riferimento rimangono in [shared/](../../shared/README.md). I documenti marcati come proposta mantengono quello stato; applicare le decisioni approvate e le implementazioni effettive.

- [BLE_ADMISSION_PROPOSAL.md](BLE_ADMISSION_PROPOSAL.md) — Ammissione di nuovi telefoni — flusso approvato in DEC-014
- [CLOUD_OPTIONS.md](CLOUD_OPTIONS.md) — Account e cloud — CloudKit scelto in DEC-012
- [CONFIG_JSON_C.md](CONFIG_JSON_C.md) — Parser C bounded della configurazione wire — sviluppo v0.1
- [CONNECTION_POLICY_V0.1.md](CONNECTION_POLICY_V0.1.md) — Più client, una connessione BLE attiva — sviluppo v0.1
- [C_STREAM_V0.1.md](C_STREAM_V0.1.md) — Stream C bounded — riferimento v0.1
- [DIAGNOSTIC_ORACLE.md](DIAGNOSTIC_ORACLE.md) — Oracle C per il catalogo diagnostico mobile
- [ESP_IMAGE_PREFLIGHT.md](ESP_IMAGE_PREFLIGHT.md) — OTA-02: preflight immagine ESP32-S3, solo host
- [FRAMING_V0.1.md](FRAMING_V0.1.md) — Framing di sviluppo v0.1
- [GATT_V0.1.md](GATT_V0.1.md) — GATT di sviluppo v0.1
- [HISTORY_SESSIONS_V0.1.md](HISTORY_SESSIONS_V0.1.md) — Retained history session discovery v0.1
- [LOG_SYNC_V0.1.md](LOG_SYNC_V0.1.md) — Import storico — riferimento locale v0.1
- [OTA_BOOT_HEALTH_V0.1.md](OTA_BOOT_HEALTH_V0.1.md) — Durable OTA boot state and local health
- [OTA_FRAMED_V0.1.md](OTA_FRAMED_V0.1.md) — OTA framed session v0.1
- [OTA_TRANSFER_V0.1.md](OTA_TRANSFER_V0.1.md) — OTA transfer v0.1 — development contract
- [OTA_V0.1.md](OTA_V0.1.md) — OTA — pacchetto firmato e verifica offline v0.1
- [OWNERSHIP_PROPOSAL.md](OWNERSHIP_PROPOSAL.md) — Proposta storica di ownership — SUPERATA
- [PROTOCOL_V0.1.md](PROTOCOL_V0.1.md) — Contratto di sviluppo app–gauge v0.1
- [RPC_C_V0.1.md](RPC_C_V0.1.md) — Codec RPC C bounded — sviluppo v0.1
- [RPC_V0.1.md](RPC_V0.1.md) — Roundtrip applicativo di sviluppo
- [SESSION_SECURITY_REVIEW.md](SESSION_SECURITY_REVIEW.md) — Sessioni e reset — invarianti di sviluppo
