Ale1x/auto-gauge/docs/software/README.md

# Architettura software

Documenti di integrazione applicativa e consegna. Le baseline riportate nelle sezioni storiche non attestano nuove prove fisiche.

- [APPLICATION.md](APPLICATION.md) — Serialized firmware application owner
- [DISCOVERY.md](DISCOVERY.md) — Discovery Service01 e proposta iniziale
- [GAUGE_RENDERER.md](GAUGE_RENDERER.md) — Renderer RGB565 incrementale — V0.13
- [GAUGE_UI.md](GAUGE_UI.md) — Controller gauge autonomo e scena tipizzata
- [MAINTENANCE.md](MAINTENANCE.md) — Provisioning e manutenzione persistente
- [SOFTWARE_COMPLETION.md](SOFTWARE_COMPLETION.md) — Completamento software — inventario eseguibile
- [SOFTWARE_DELIVERY.md](SOFTWARE_DELIVERY.md) — Consegna software riproducibile
- [TWAI_PORT.md](TWAI_PORT.md) — Modern TWAI SDK adapter — development boundary
