Ale1x/auto-gauge/firmware/ota_study/README.md

# OTA-03 / FW-12: installer e verificatore SDK isolati

24 ottobre 2026. Questo progetto compila e collega un percorso ESP-IDF reale per il solo slot OTA inattivo. **`app_main` è vuoto e non invoca alcuna API.** Le funzioni installer, se chiamate in futuro con callback qualificati, cancellerebbero/scriverebbero flash e potrebbero cambiare il boot. Nessun dispositivo è stato collegato o aggiornato durante queste prove.

## Sequenza e confini

`ag_ota_installer_init` richiede un oggetto statico azzerato, un proprietario esclusivo di tutte le operazioni OTA/partizioni e tre hook fidati: verificatore crittografico del manifesto, autorizzazione locale corrente legata alla lease e clock monotono. Il verificatore target `ag_manifest_verify` e il wrapper `ag_manifest_verify_hook` sono implementati e linkati: verificano RSA3072-PSS-SHA256, schema/canonicalizzazione, hardware, capacità e release floor con trust locale. Sono ora collegati all’installer dal nuovo adapter di trasferimento, con un owner bounded; main e servizio BLE/RPC restano da integrare. Il chiamante deve fornire hardwareID, floor fidato e lookup delle chiavi locali; nessun booleano del telefono può sostituirli. Il verificatore Python host resta distinto. Le chiavi di produzione non sono provisionate. Dettagli: [MANIFEST_VERIFY.md](MANIFEST_VERIFY.md).

1. `begin`: verifica prima il manifesto, ricontrolla tempo/autorizzazione, richiede running OTA VALID e boot==running, due slot registrati distinti/non sovrapposti e otadata8192byte. Chiama `esp_ota_begin` soltanto sullo slot opposto. Factory/PENDING_VERIFY, altri boot già selezionati e geometrie incompatibili sono rifiutati. Lo studio non effettua il bootstrap iniziale da factory.
2. `write`: chunk1…1024byte in ordine e nell’esatta lunghezza autorizzata, offset non riutilizzati, policy/clock freschi dopo le letture di metadati. SDK write riuscita significa accettazione SDK, non una promessa di durabilità per ciascun chunk. Nessuna ripresa/riprogrammazione automatica dopo errore.
3. `finish`: lunghezza completa, `esp_ota_end` per verificare l’immagine secondo configurazione SDK, poi SHA256 PSA dei byte effettivamente riletti dalla partizione e confronto con hash autorizzato. Verifica anche versione descriptor/floor secure_version. SDK end consuma sempre il handle: il codice non lo abortisce dopo end.
4. `select`: operazione separata, ricontrolla partizioni/autorizzazione e ricalcola l’hash dello slot per rilevare modifiche successive a finish. Usa `esp_ota_set_boot_partition`, senza bypass della verifica SDK. Prima della chiamata marca `selection_may_have_changed`: errore o revoca/timeout dopo la chiamata possono significare selezione già avvenuta. Nessun retry cieco o rollback inventato.

SDK begin può invalidare metadati dello slot **inattivo** in otadata già prima di select; la separazione delle API non significa otadata immutato durante il download. I byte dello slot running sono esclusi dal writer. Le garanzie fisiche del bootloader e di otadata sotto brownout non sono dimostrate da questo studio.

Un rilievo della review del sorgente SDK fissato è stato corretto: `esp_ota_begin` può pubblicare un handle e poi fallire l’erase senza liberarlo. Il codice conserva tale handle anche su errore e tenta abort; fallimento cleanup rimane esplicito. Un’installazione per boot e nessun altro proprietario OTA sono prerequisiti anche per escludere il wrap del contatore handle SDK. Un rifiuto di autorizzazione prima dell’ammissione lascia IDLE, lease e clock non associati: non occupa il ciclo di un futuro chiamante valido. Dopo l’ammissione, fault/cancel non riaprono il ciclo: serve gestione esplicita al nuovo boot, con riconciliazione dello stato reale.

Tutti gli accessi usano lease corrente, clock senza regressione e deadline assoluta/idle, compreso il polling senza nuovi byte. Hook non rientranti, serializzati sullo stesso proprietario; nessun writer concorrente può alterare i byte fra hash e selezione. Limiti H:16MiB immagine,4096byte manifesto, versione ASCII terminata32byte, timeout totale massimo15minuti. Sono limiti di sviluppo, non requisiti V1 congelati.

## Riproduzione senza dispositivo

```sh
sh firmware/ota_study/build.sh
python3 firmware/ota_study/report_build.py
python3 -m unittest discover -s tests -p test_ota_installer.py -v
```

Build SDKv6.1 fissato a `fff9895c82d744c7237be8847347bdd1b07c6643`; tutte18entry point (7installer +2manifesto +3payloadadapter +6framedadapter) sono trattenute nel link con le vere dipendenze esp_ota/PSA. Immagine260608byte, non sizing V1. Report controlla main senza chiamate e hash sorgenti/artefatti. Configurazione separata4MiB con factory+due OTA da1MiB e rollback abilitato; **non** è la mappa della V1 e non dimensiona i2MiB di log. Secure Boot/encryption/antirollback hardware non sono attivati; l’installer rifiuta la compilazione con antirollback hardware in questo studio. Il flag SDK di capacità Wi-Fi può risultare attivo: i simboli init radio sono assenti e il main non avvia radio.

L’harness host compila il C di produzione con shim comportamentali SDK e **hash model non crittografico** esplicito. Copre ordering, errori e byte letti, non la correttezza SHA/SMP/flash del vero SDK. ASan/UBSan e8gruppi includono pre/post allocazione su begin fallito, abort fallito, offset/lunghezza, manifest/auth prima di erase, partizioni/boot invalidi, timeout/regressione/IO lento, lease vecchie, reentry, hash/descriptor e selezione ambigua. Il nuovo harness manifesto aggiunge4gruppi/55vettori con shim PSA esplicitamente non crittografico. Le firme reali sono provate separatamente con Python/OpenSSL, Security.framework Swift e la libreria portable TF-PSA-Crypto nativa:55vettori/13manifesti accettati. Questa prova nativa usa il C di produzione e vere RSA/SHA, senza sostituzioni delle funzioni crypto; non esegue il provider/acceleratore ESP32. Report separato `native-crypto-report.json` e comando locale facoltativo `python3 scripts/check_native_ota_crypto.py`, con cache fissata e sorgenti verificate. La correttezza/integrazione SHA del vero SDK sul target non è stata eseguita qui. Non si attribuiscono al modello le garanzie crittografiche della libreria.

Restano necessari provisioning delle trust anchor target e binding del controller a un trasporto autenticato, salute del boot di prova, coordinamento del contatore durabile con rollback, recovery USB e prove fisiche di interruzione. Questo codice non conferma salute, riavvia, avanza floor durabili o brucia eFuse. Non è una release di aggiornamento utilizzabile.

Fonti primarie lette: [OTA ESP-IDFv6.1 ESP32-S3](https://docs.espressif.com/projects/esp-idf/en/v6.1/esp32s3/api-reference/system/ota.html) e `components/app_update/esp_ota_ops.c`, `include/esp_ota_ops.h`, `esp_partition.h` del checkout fissato. [Review sorgente](../../docs/reviews/software/OTA_INSTALLER_SOURCE_REVIEW.md), [harness e review indipendente](../../docs/reviews/software/OTA_INSTALLER_REVIEW.md).

## Trasferimento bounded FW-13

`transfer_adapter.{h,c}` collega `ag_ot_owner_t` al verificatore C/PSA e all’installer esistenti. Il chiamante fornisce trust e callback platform locali, con lease autenticata/manutenzione corrente, clock e timeout. Init non esegue crypto o flash. L’owner statico assembla envelope≤4096byte in blocchi≤1024, verifica prima di begin e accetta immagine soltanto agli offset esatti autorizzati. Finish e select restano operazioni separate; nessun reboot/floor/health viene aggiunto. [Contratto](../../docs/protocols/OTA_TRANSFER_V0.1.md).

ACK16byte con ID/progressi/stato bounded; ID e CRC non autenticano. Una richiesta valida richiede controlli prima/dopo callback; revoca, deadline o errore backend terminano l’owner e tentano cleanup una sola volta se begin era stato tentato. Dopo select tentato l’incertezza resta latched e non si ritenta. Lease di un altro telefono non può cancellare o avanzare il trasferimento corrente. Poll periodico obbligatorio anche senza traffico. Un owner e un trasferimento per boot, nessun resume/restart.

Il mapping cancel riconosce `AG_OTA_DENIED`+FAULT dell’installer come cleanup eseguito solo se handle inattivo e nessuna incertezza; un errore abort resta incerto. Harness adapter collega controller+adapter+installer veri con doppi SDK/hash/manifesto **non crittografici**. Il link ESP-IDF separato usa invece il vero verificatore PSA. Test Swift eseguono il CLI C di fixture tramite stdio: confermano ordering/ACK, non sicurezza radio o flash. Nessuna route nativa BLE/RPC o UI OTA è attiva. [Review indipendente](../../docs/reviews/software/OTA_TRANSFER_REVIEW.md), [verifica V0.10](../../docs/verification/VERIFICATION_V0.10.md).

## Sessione AG dedicata FW-14

`framed_adapter.{h,c}` compone endpoint AG, owner OTA, adapter payload, verificatore manifesto e installer. `ag_ota_framed_adapter_init` richiede lease e policy locali, non inizializza radio, non verifica pacchetti e non scrive flash. L’endpoint usa kind1/2 esistenti, ID consecutivi da1, staging senza mutazioni e step separato. Header OTA oversize/non-request, replay, frame concatenati/trailing o deadline chiudono la sessione prima del dispatch; una chiusura dopo effetti conserva l’incertezza. I callback tardivi/lease obsolete non resettano l’owner.

Nessuna route viene aggiunta al bridge NimBLE/JSON RPC; la futura piattaforma deve scegliere localmente una sessione OTA esclusiva. Prima di ogni ACK il chiamante ricontrolla autorizzazione/tempo e deve poi gestire l’invio/confirm reale. Poll periodico e proprietario esclusivo rimangono obbligatori. Main ancora vuoto;18entry point forzate e dipendenze AG vere linkate. Il test adapter framed esegue produzione C attraverso doppi SDK/hash/manifesto **non crittografici**; SDK reale compila separatamente. [Contratto framed](../../docs/protocols/OTA_FRAMED_V0.1.md), [review](../../docs/reviews/software/OTA_FRAMED_REVIEW.md), [V0.11](../../docs/verification/VERIFICATION_V0.11.md).
