Ale1x/auto-gauge/docs/reviews/software/README.md

# Review software

Risultati di revisioni tecniche alla data indicata. Gli esiti non si estendono automaticamente al codice modificato successivamente.

- [ADMISSION_REVIEW.md](ADMISSION_REVIEW.md) — FW-07 — review indipendente del controller di ammissione
- [APP08_REVIEW.md](APP08_REVIEW.md) — Review indipendente APP08 — transport di sviluppo e processo C
- [APP09_REVIEW.md](APP09_REVIEW.md) — Review APP-09 del coordinatore
- [APP10_REVIEW.md](APP10_REVIEW.md) — Review APP-10 del coordinatore
- [BLE_CREDENTIAL_RESET_AUDIT.md](BLE_CREDENTIAL_RESET_AUDIT.md) — Audit reset credenziali NimBLE — V0.13
- [BLUETOOTH_REVIEW.md](BLUETOOTH_REVIEW.md) — Review indipendente APP07 — Bluetooth/RPC/stream
- [BOOT_HEALTH_REVIEW.md](BOOT_HEALTH_REVIEW.md) — Boot health and durable floor — independent review
- [CLOUDKIT_REVIEW.md](CLOUDKIT_REVIEW.md) — APP-05 — review indipendente CloudKit e outbox
- [CLOUD_RESTORE_REVIEW.md](CLOUD_RESTORE_REVIEW.md) — APP-06 — review indipendente del recupero storico CloudKit
- [COMPLETION_COORDINATOR_REVIEW.md](COMPLETION_COORDINATOR_REVIEW.md) — Completion checkpoint coordinator review —25October2026
- [C_STREAM_REVIEW.md](C_STREAM_REVIEW.md) — Review indipendente — decoder C dello stream AG
- [ENDPOINT_INTEGRATION_REVIEW.md](ENDPOINT_INTEGRATION_REVIEW.md) — Review del coordinatore: endpoint e integrazione
- [ESP_IMAGE_REVIEW.md](ESP_IMAGE_REVIEW.md) — Independent review: OTA-02 ESP image preflight
- [FLASH_HISTORY_REVIEW.md](FLASH_HISTORY_REVIEW.md) — Lettura del coordinatore — FW08 persistente simulato
- [FW05_REVIEW.md](FW05_REVIEW.md) — FW-05 — review indipendente della persistenza configurazione
- [INTEGRATION_V0.13_REVIEW.md](INTEGRATION_V0.13_REVIEW.md) — Review di integrazione V0.13
- [JOURNAL_HISTORY_REVIEW.md](JOURNAL_HISTORY_REVIEW.md) — FW-10 journal history — independent review
- [NIMBLE_STUDY_REVIEW.md](NIMBLE_STUDY_REVIEW.md) — NimBLE compile study — independent review
- [OTA_FRAMED_REVIEW.md](OTA_FRAMED_REVIEW.md) — OTA framed session — independent review
- [OTA_INSTALLER_REVIEW.md](OTA_INSTALLER_REVIEW.md) — OTA03 installer study — independent review and host fault injection
- [OTA_INSTALLER_SOURCE_REVIEW.md](OTA_INSTALLER_SOURCE_REVIEW.md) — Independent source review: SDK OTA installer study
- [OTA_MANIFEST_TARGET_REVIEW.md](OTA_MANIFEST_TARGET_REVIEW.md) — FW-12 target manifest verifier — independent review
- [OTA_PACKAGE_SWIFT_REVIEW.md](OTA_PACKAGE_SWIFT_REVIEW.md) — APP-11 — review indipendente del verificatore OTA Swift
- [OTA_REVIEW.md](OTA_REVIEW.md) — Review indipendente OTA v0.1
- [OTA_TRANSFER_REVIEW.md](OTA_TRANSFER_REVIEW.md) — OTA transfer v0.1 — independent source and fault review
- [PARSER_ADMISSION_COORDINATOR.md](PARSER_ADMISSION_COORDINATOR.md) — Lettura del coordinatore — parser e ammissione
- [PREPARATION_AND_CATALOG_REVIEW.md](PREPARATION_AND_CATALOG_REVIEW.md) — Offline OTA preparation and retained-session catalog — independent review
- [READINESS_AUDIT.md](READINESS_AUDIT.md) — Audit di completamento — Auto Gauge v0.2.6
- [RUNTIME_REVIEW.md](RUNTIME_REVIEW.md) — FW-11 runtime — independent review
