Ale1x/auto-gauge/docs/project/DECISIONS.md

# Registro decisioni approvate

## DEC-001 — 2026-10-24 — revisione requisiti v0.2.1

Origine: risposta del proprietario in questa chat: «Diametro esterno del dispositivo: 44,45 mm».

O-02 è risolta per l'interpretazione: **il diametro esterno finito massimo è 44,45 mm**. Si applica al dispositivo, non al solo PCB o all'area attiva del pannello. Il limite non autorizza aumenti di diametro né riduzioni del display PR-009. Tolleranze produttive e inclusione dell'inviluppo del connettore accoppiato vanno ancora esplicitate; non si assume una tolleranza positiva.

Questo addendum approvato integra docs/product/SPEC_V0.2.md, conservata invariata. La revisione dei requisiti risultante è v0.2.1. Non è un'approvazione di K0, BOM o produzione.

## DEC-002 — 2026-10-24 — revisione requisiti v0.2.2

Origine: risposta del proprietario: «Bene, allora facciamolo leggermente più grande, non è un problema».

È approvato un aumento contenuto del diametro esterno rispetto a 44,45 mm, per permettere lo studio dell'assieme con display AMOLED touch nominale 1,75″. DEC-001 è superata **nel limite numerico**, mentre resta confermato che l'ingombro di interesse è quello esterno del dispositivo. PR-013 è aggiornato in questo senso; PR-009 resta invariato.

Il nuovo massimo numerico non è stato indicato dal proprietario. Ø52 mm è un'ipotesi ingegneristica iniziale, non un massimo approvato né un fit validato. Prima del freeze serviranno quote reali di pannello/FPC, pareti e tolleranze, connettori, magnete e RF. O-02 rimane aperta per il valore finale, tolleranze e inviluppo del plug accoppiato.

Questo addendum integra docs/product/SPEC_V0.2.md e porta i requisiti risultanti a v0.2.2. Non approva K0, BOM o produzione.

## DEC-003 / DEC-004 / DEC-005 — 2026-10-24 — revisione requisiti v0.2.3

Tre decisioni approvate dal proprietario in questa chat:

- **DEC-003 — O-01:** «Solo PID live Service 01 (consigliato)». La V1 comprende solo PID live Service 01 standard supportati dal veicolo. Service 02/09 e lettura DTC non rientrano nel perimetro approvato. Restano vietati servizi di scrittura/attuazione e Mode 04. La compatibilità e i decoder richiedono comunque verifica.
- **DEC-004 — O-14:** «Buffer sul gauge e sincronizzazione successiva. Però senza intasare il gauge». È approvato il buffering locale con successiva sincronizzazione BLE; deve essere limitato e non sovraccaricare il dispositivo. Capacità, frequenza log, retention, comportamento a pieno e perdita ammessa non sono fissati. docs/hardware/LOGGING_K0.md propone una soluzione circolare bounded: i suoi valori numerici restano H, non decisioni approvate.
- **DEC-005 — O-04 / parte O-06:** «Sì: 100 µA entro 5 minuti». Target massimo all'ingresso OBD a 12 V: 100 µA entro 5 minuti dal quadro OFF. Il limite è approvato, non misurato. Condizioni termiche, banda e picchi da precisare; latenza di riaccensione e rilevamento IGN restano aperti. Nessuna deroga per CAN attivo a quadro OFF.

Le decisioni integrano docs/product/SPEC_V0.2.md e i precedenti addendum; requisiti risultanti v0.2.3. O-01 chiusa come decisione di scope; O-04 chiusa nel target e tempo, aperta nella prova/metodo; O-14 risolta nel meccanismo, aperta nei limiti quantitativi. Nessuna approvazione K0, PCB o ordine.

## DEC-006 / DEC-007 — 2026-10-24 — revisione requisiti v0.2.4

- **DEC-006 — O-14:** owner approva la policy proposta:2MiB fissi se disponibili dopo sizing OTA, registrazione fino a1Hz per PID, sovrascrittura dati più vecchi con segnalazione della perdita. Non è garantita una durata fissa: overhead, numeroPID e formato record la determinano. La lettura/UI può restare a5Hz ove supportato; il logger non deve rallentare i percorsi critici. Se2MiB non sono disponibili dopo sizing, riportare il conflitto; non ridurre OTA/recovery autonomamente.
- **DEC-007 — O-03:** owner approva alimentazione USB temporanea per recovery anche senza OBD collegato. USB non è alimentazione d'uso normale. Restano obbligatorie protezioni e verifica di backfeed in entrambe le direzioni.

Autorizzazione operativa: invio delle richieste già preparate a VIEWE, Huaxin, JLCPCB e PCBWay approvato, senza ordine o impegno di acquisto. Recapito di risposta fornito dall'owner registrato in docs/suppliers/SUPPLIER_CONTACT_LOG.md.

Queste decisioni integrano gli addendum precedenti; requisiti risultanti v0.2.4. Nessuna approvazione del gate K0 o produzione.

## DEC-008 — 2026-10-24 — revisione requisiti v0.2.5

Origine: alla domanda «Durante l’avviamento del motore, accetti che il gauge possa riavviarsi per una breve caduta di tensione, purché riparta automaticamente?» il proprietario risponde «Sì, riavvio automatico accettabile».

Durante l’avviamento motore è ammesso un riavvio del gauge dovuto a una breve caduta di alimentazione, con ripartenza automatica. Questa eccezione aggiorna PR-006 nel solo evento crank; non autorizza spegnimenti a quadro ON fuori da quell’evento, né richiede continuità del display durante la caduta. Non introduce un’alimentazione nominale24V.

O-07 è risolta solo per la classe funzionale durante il crank: reset ammesso, recupero autonomo richiesto. Livelli/durate del profilo, soglie brownout e latenza massima di recupero restano aperti e da verificare. Integrità configurazione/log/OTA, assenza di trasmissioni diagnostiche improprie al riavvio e protezioni restano da dimostrare.

Requisiti risultanti v0.2.5; docs/product/SPEC_V0.2.md resta conservata invariata. Nessuna approvazione del gate K0, di componenti definitivi o produzione.

## DEC-009 — 2026-10-24 — autorizzazione operativa allo schema di revisione

Origine, richiesta esplicita del proprietario: «Procedi,non fermarti fin quando abbiamo lo schema kicad, fai tutti gli step necessari».

È autorizzato proseguire a pin assignment, progetto e schema KiCad modificabile per revisione ingegneristica, anche con i blocker K0 già documentati. Questa richiesta successiva prevale sulle precedenti condizioni operative che impedivano di creare lo schema. Non dimostra il superamento K0 né risolve dati tecnici mancanti: connessioni/valori non verificati devono restare marcati H/TBD/OPEN, senza dichiarare lo schema definitivo o pronto alla fabbricazione.

La revisione A0 non autorizza layout/routing PCB, ordini, eFuse irreversibili o collegamento alla vettura. I requisiti funzionali restano v0.2.5; si tratta di una variazione dell’ordine di lavoro, non di una deroga a protezioni, diametro, standby o comportamento IGN.

## DEC-010 — 2026-10-24 — avvio parallelo app e firmware

Origine: richiesta del proprietario «Organizziamo il lavoro: puoi dividere in più agenti che lavorano contemporaneamente a più task: si può già iniziare a lavorare all'app mobile. Un altro subagente può lavorare al firmware del device».

È autorizzato avviare contemporaneamente app iOS e firmware mediante subagenti, coordinando le interfacce con il filone hardware. Il primo incremento può usare dati simulati, test host e HAL finché i dettagli hardware non sono verificati. Le assegnazioni e i risultati sono in docs/project/WORKSTREAMS.md.

Le scelte di sviluppo nel contratto docs/protocols/PROTOCOL_V0.1.md (schema, geometria, target SDK) sono ipotesi tecniche, non risposte del proprietario alle questioni aperte. Backend, ownership, sicurezza BLE/OTA e specifiche hardware non sono implicitamente approvati da questa organizzazione del lavoro. Non sono autorizzati pubblicazione dell'app, ordini, provisioning eFuse o collegamenti alla vettura. Requisiti funzionali invariati v0.2.5.

## DEC-011 — 2026-10-24 — più dispositivi BLE, una connessione attiva

Origine, precisazione del proprietario: «il dispositivo può essere connesso a N dispositivi bluetooth, però non contemporaneamente, questo è l'unico constrain».

PR-020 è aggiornato: il gauge può essere utilizzato da più dispositivi Bluetooth in momenti diversi; l'unico vincolo di esclusività è **una sola connessione Bluetooth attiva alla volta**. Non è richiesto un solo iPhone permanentemente associato o un unico proprietario dispositivo nel cloud. Aggiungere o cambiare telefono non richiede reset, cancellazione dei dati o trasferimento di proprietà. Non viene introdotto un numero massimo N come nuovo requisito: gli eventuali limiti tecnici di bonding/memoria vanno documentati e verificati, senza trasformarli tacitamente in un vincolo di prodotto.

La precisazione supera la formulazione originaria di PR-020 e le proposte tecniche successive fondate su owner unico. La policy di connessione non è una prova di autenticazione: sicurezza della sessione, antireplay e aggiornamenti firmati restano requisiti separati già previsti dalla SPEC. Non vanno usati per reintrodurre un'esclusività permanente a un solo telefono. La V1 conserva l'app iOS/Swift; consentire altri client BLE non richiede in questa decisione lo sviluppo di un'app Android.

Decisione precedente mantenuta nel suo ambito corretto: il proprietario ha scelto «Reset fisico via USB/pulsanti, senza autorizzazione cloud» alla domanda che specificava la cancellazione di credenziali, configurazione e log locali del gauge, senza cancellare gli storici cloud. Tale reset rimane una **procedura di manutenzione/factory reset separata**, non il meccanismo necessario per cambiare telefono. La scelta non esegue alcuna cancellazione adesso e non definisce tempi/gesto, circuiti o provisioning.

O-08 è risolta per il vincolo di connessione e la natura locale del reset; implementazione, autenticazione e prove restano aperte. Requisiti risultanti v0.2.6; docs/product/SPEC_V0.2.md è conservata invariata come fonte originaria. Nessuna approvazione hardware, produzione o attivazione di un trasporto reale.

## DEC-012 — 2026-10-24 — account iCloud e CloudKit

Origine: alla domanda sul modello di account/cloud il proprietario sceglie «Account iCloud del telefono + CloudKit, senza account email separato».

PR-021 usa l'account iCloud dell'iPhone e CloudKit per la sincronizzazione; non si crea un account email/password distinto né un backend Supabase. Il gauge resta autonomo senza telefono/cloud. DEC-011 resta invariata: più client utilizzabili in sequenza e una sola connessione BLE attiva, senza owner unico del gauge imposto dall'account cloud.

O-13 è risolta per provider e identità account. Container, team/firma Apple e ambiente devono essere configurati prima delle prove live; retention, cancellazione/esportazione, offline e protezione dati vanno ancora definite/verificate. La scelta non autorizza costi, pubblicazione dell'app, provisioning irreversibile o upload di fixture nel database reale. Requisiti risultanti v0.2.7; SPEC originaria conservata invariata.

## DEC-013 — 2026-10-24 — identificatori Apple di sviluppo

Origine: il proprietario conferma «Usa il team ZDQFU74347 e i nuovi identificatori proposti» alla domanda che indicava Team, Bundle ID e container e specificava l'assenza di pubblicazione App Store.

Configurazione di sviluppo autorizzata: team `ZDQFU74347`, Bundle ID `it.ale1x.autogauge`, container `iCloud.it.ale1x.autogauge`, ambiente iniziale Development e database privato dell'account iCloud. È autorizzata la creazione/configurazione delle risorse Apple relative a questi identificatori tramite l'account già disponibile, se accessibile; nessuna pubblicazione App Store, nuovo contratto, costo o cambio di abbonamento. Credenziali e chiavi non vengono inserite nel repository. Un'eventuale richiesta Apple di login/consenso non disponibile richiede l'intervento del proprietario.

Questa è un'autorizzazione operativa, non un'esecuzione già avvenuta o un esito di sync live. Requisiti funzionali invariati v0.2.7.

## DEC-014 — 2026-10-24 — autorizzazione locale dei nuovi telefoni

Origine: il proprietario approva «codice solo per nuovi telefoni» alla proposta di aprire «Associa telefono» sul display del gauge, mostrare un codice casuale e inserirlo su iPhone.

Il nuovo telefono richiede questo consenso locale e codice; i telefoni già riconosciuti si riconnettono senza ripeterlo. DEC-011 resta invariata: più telefoni sequenziali, una connessione attiva, nessun owner unico o reset per cambiare telefono. Il pairing non richiede iCloud o autorizzazione cloud. Il reset fisico USB/pulsanti resta manutenzione separata.

Il flusso UX è fissato; tecnologia LE Secure Connections/passkey, cache dei bond, durata della finestra, rate limit, gesto menu e revoca sono dettagli da implementare/verificare in `docs/protocols/BLE_ADMISSION_PROPOSAL.md`. Non si attivano radio, chiavi o accesso alla vettura per effetto della decisione. Requisiti risultanti v0.2.8; SPEC originaria conservata invariata.

## DEC-015 — 2026-10-25 — migrazione a iOS 27

Origine: il proprietario chiede «Puoi migrare ad IOS 27». Il target minimo di app iPhone e package GaugeCore diventa iOS27.0; il generatore Xcode e la tracciabilità devono conservarlo. Si può usare direttamente la navigazione moderna senza fallback iOS17. Il deployment macOS del package per i test host rimane invariato, così come bundle/team/container e i gate di sicurezza BLE/OTA/cloud. La richiesta non avvia acquisti, provisioning o pubblicazione. Le evidenze precedenti con targetiOS17 restano snapshot storici.
