Ale1x/auto-gauge/evidence/contact/huaxin-submission.png

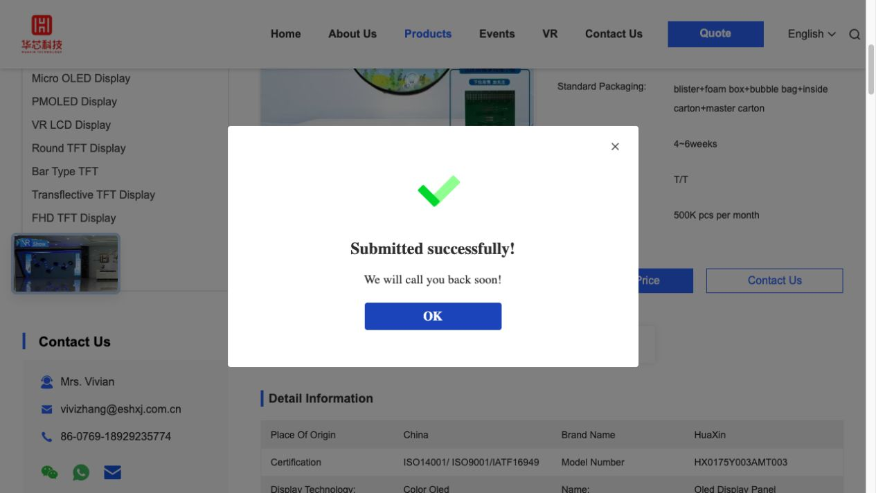
evidence/contact/huaxin-submission.png
