Ale1x/auto-gauge/evidence/contact/viewe-submission.png

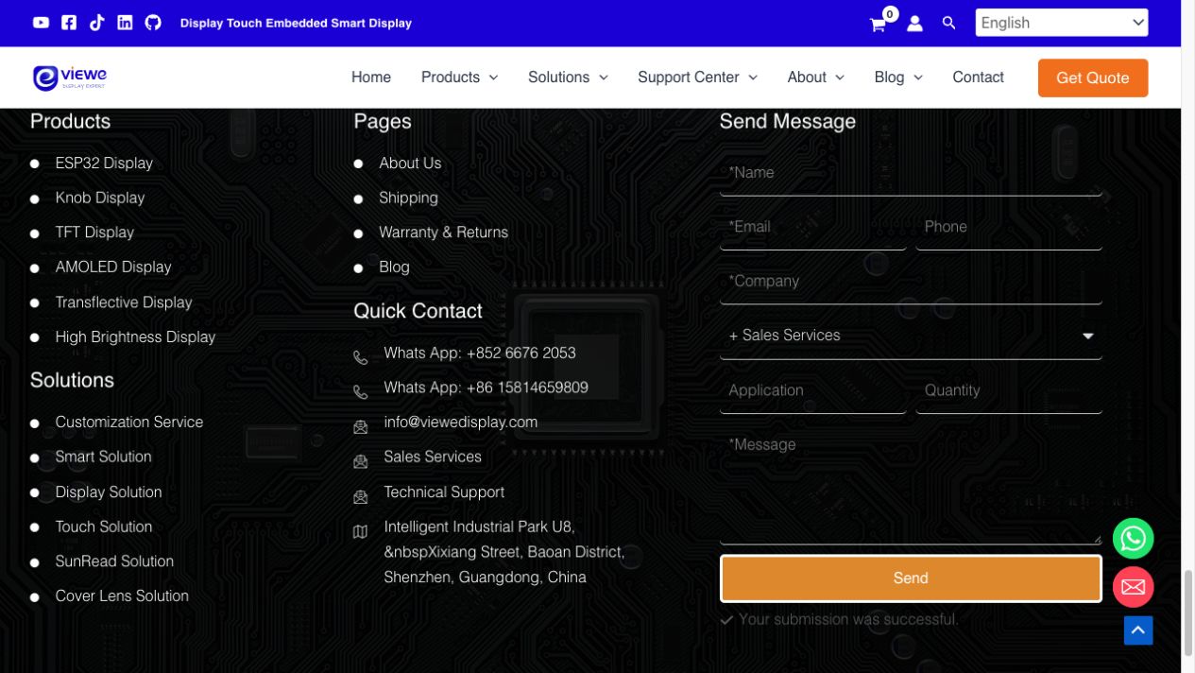
evidence/contact/viewe-submission.png
