Ale1x/auto-gauge/evidence/lm74900-current.png

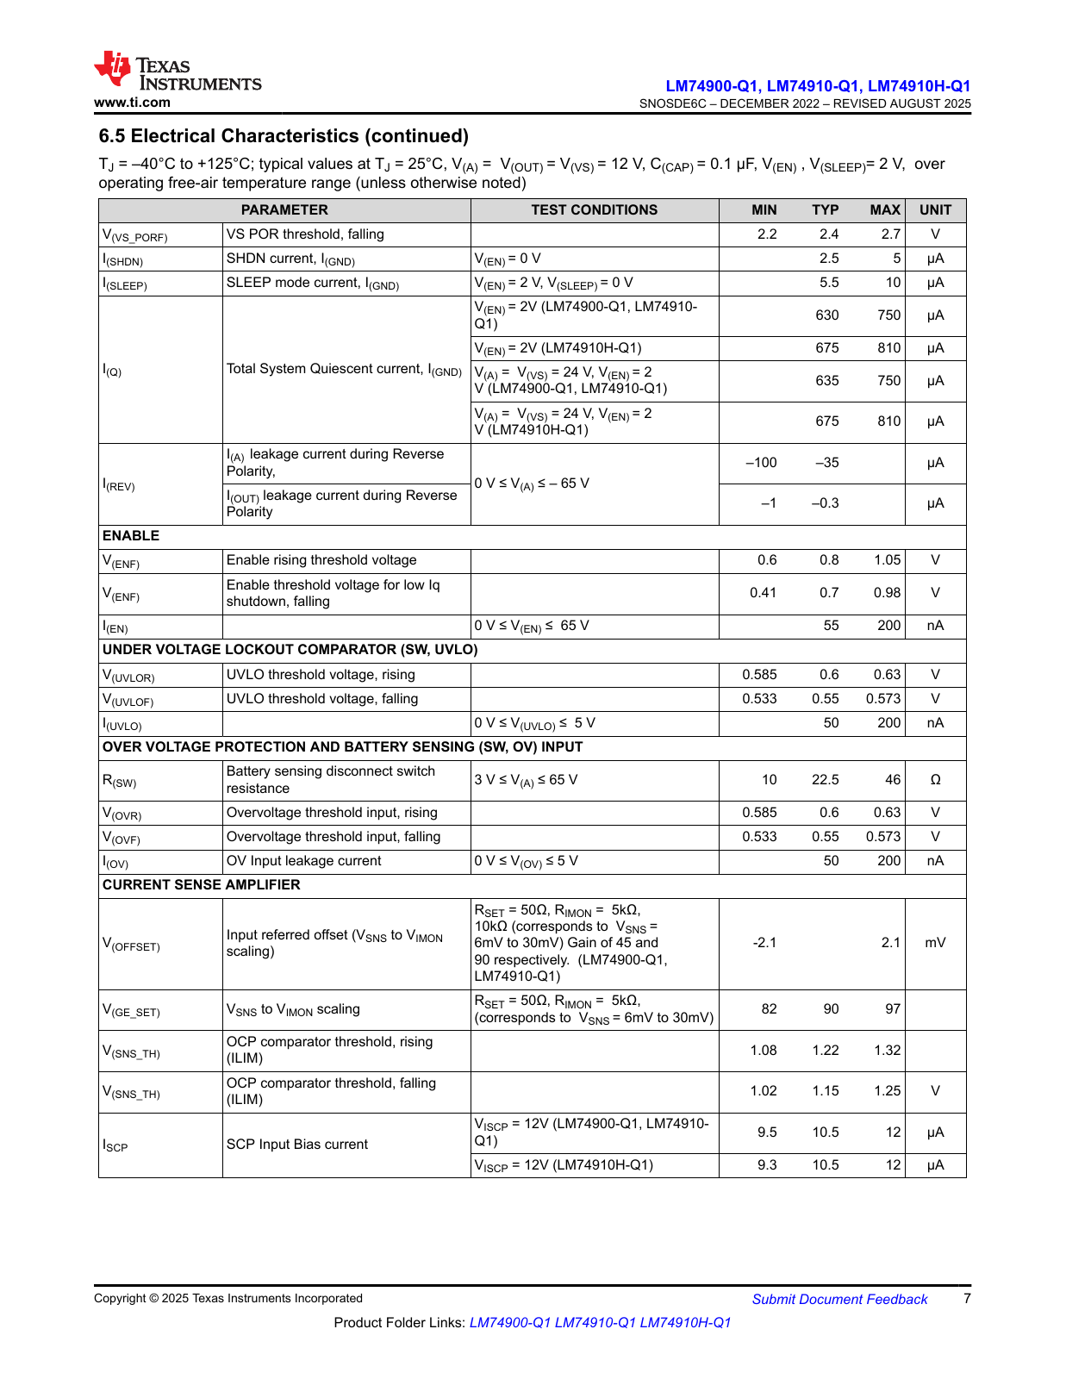
evidence/lm74900-current.png
