Ale1x/auto-gauge/evidence/lx-electrical.png

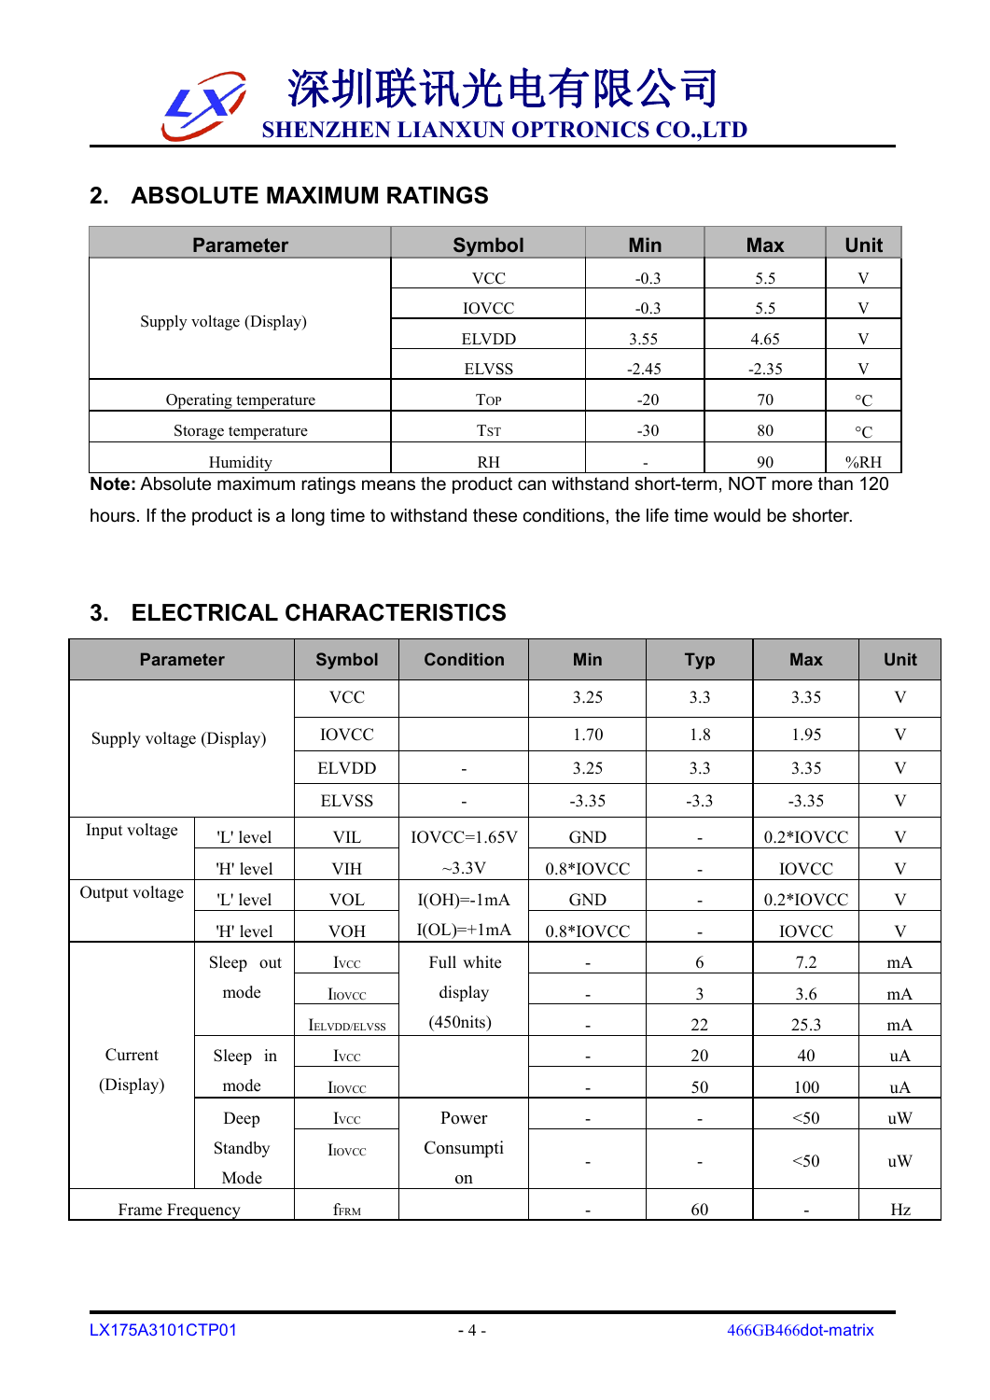
evidence/lx-electrical.png
