Ale1x/auto-gauge/evidence/lx-mechanical.png

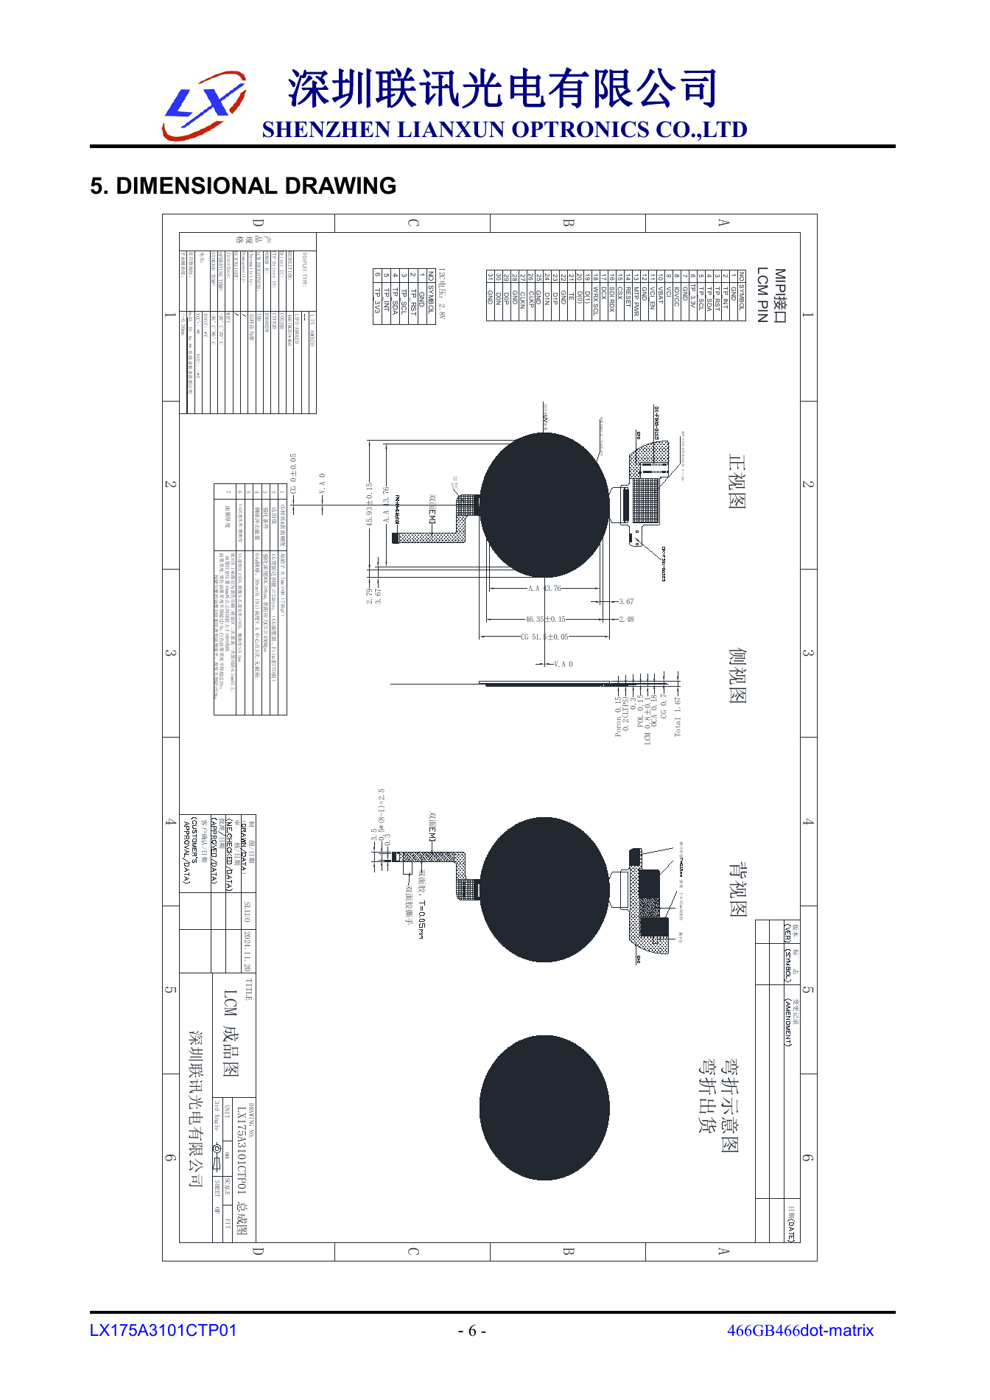
evidence/lx-mechanical.png
