Ale1x/auto-gauge/evidence/lx-pinout.png

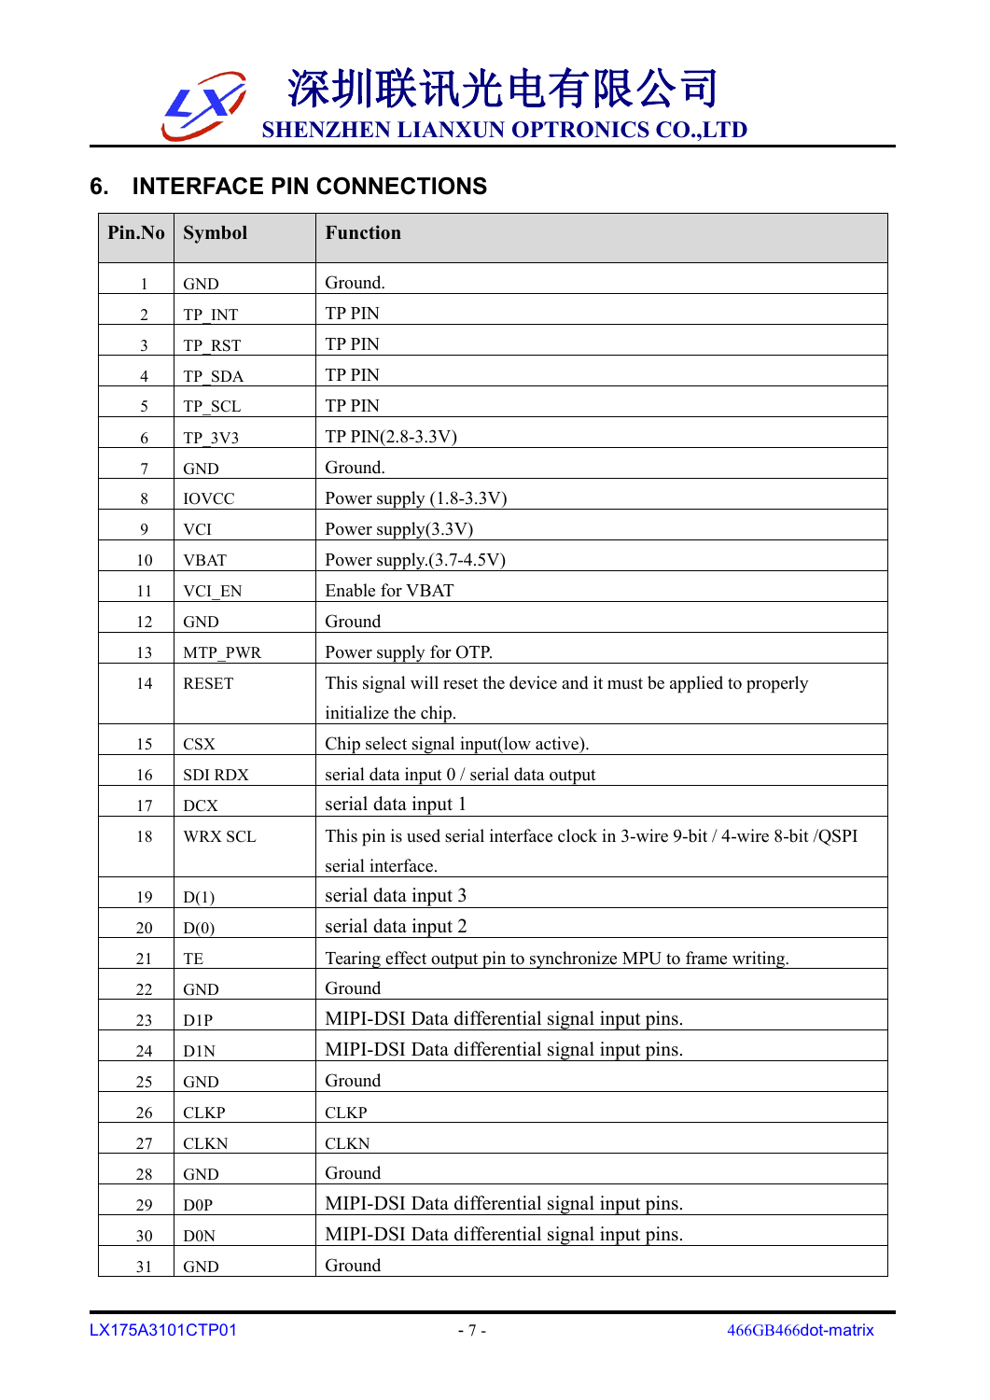
evidence/lx-pinout.png
