Ale1x/auto-gauge/evidence/panel-application.png

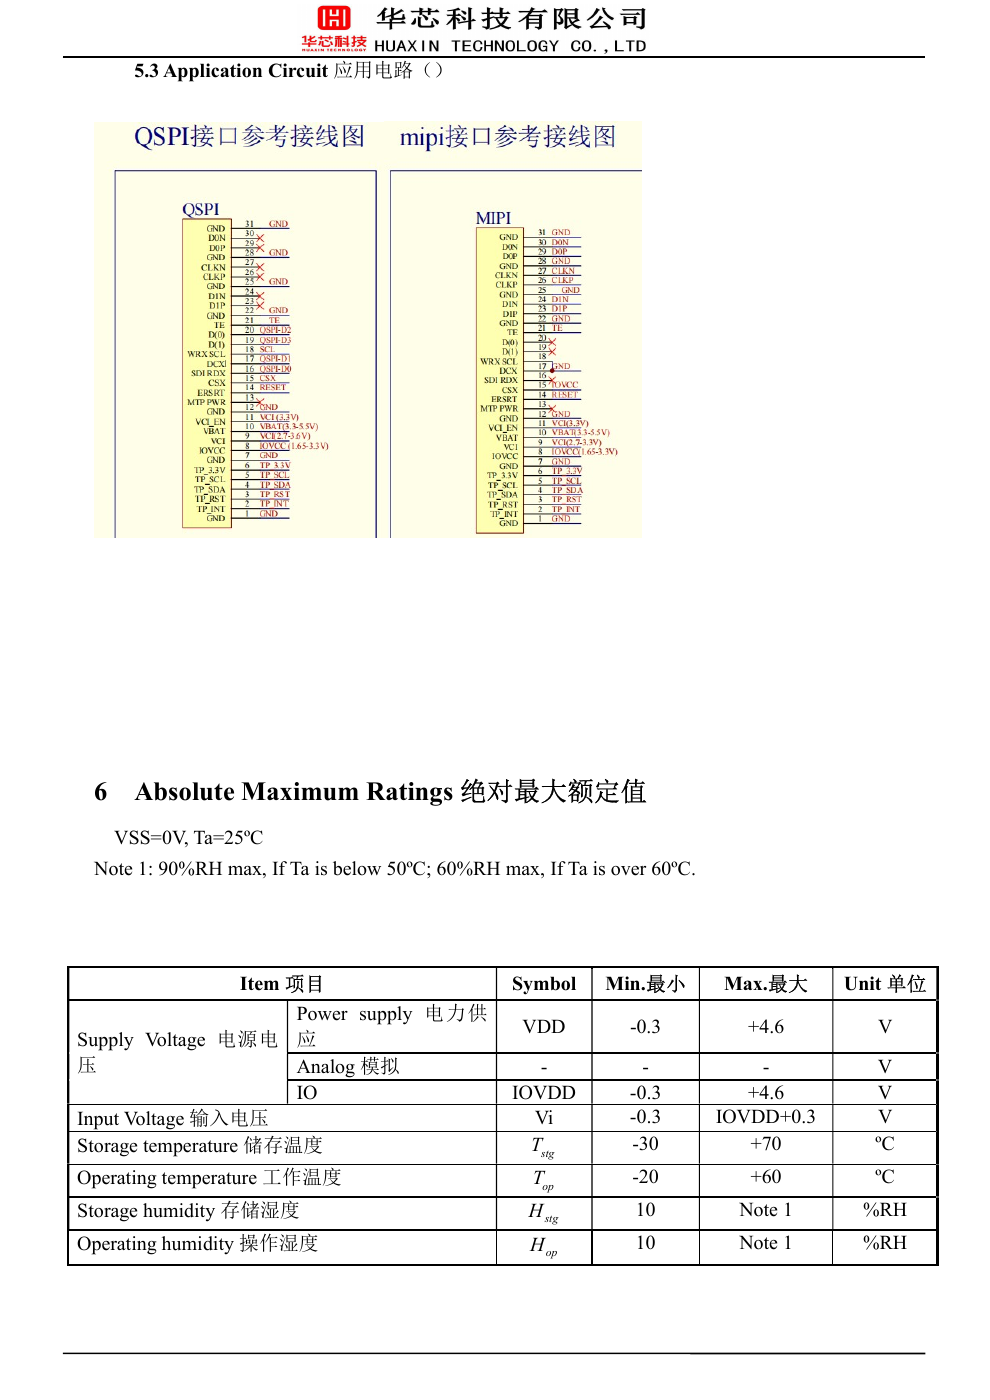
evidence/panel-application.png
