Ale1x/auto-gauge/evidence/panel-mechanical.png

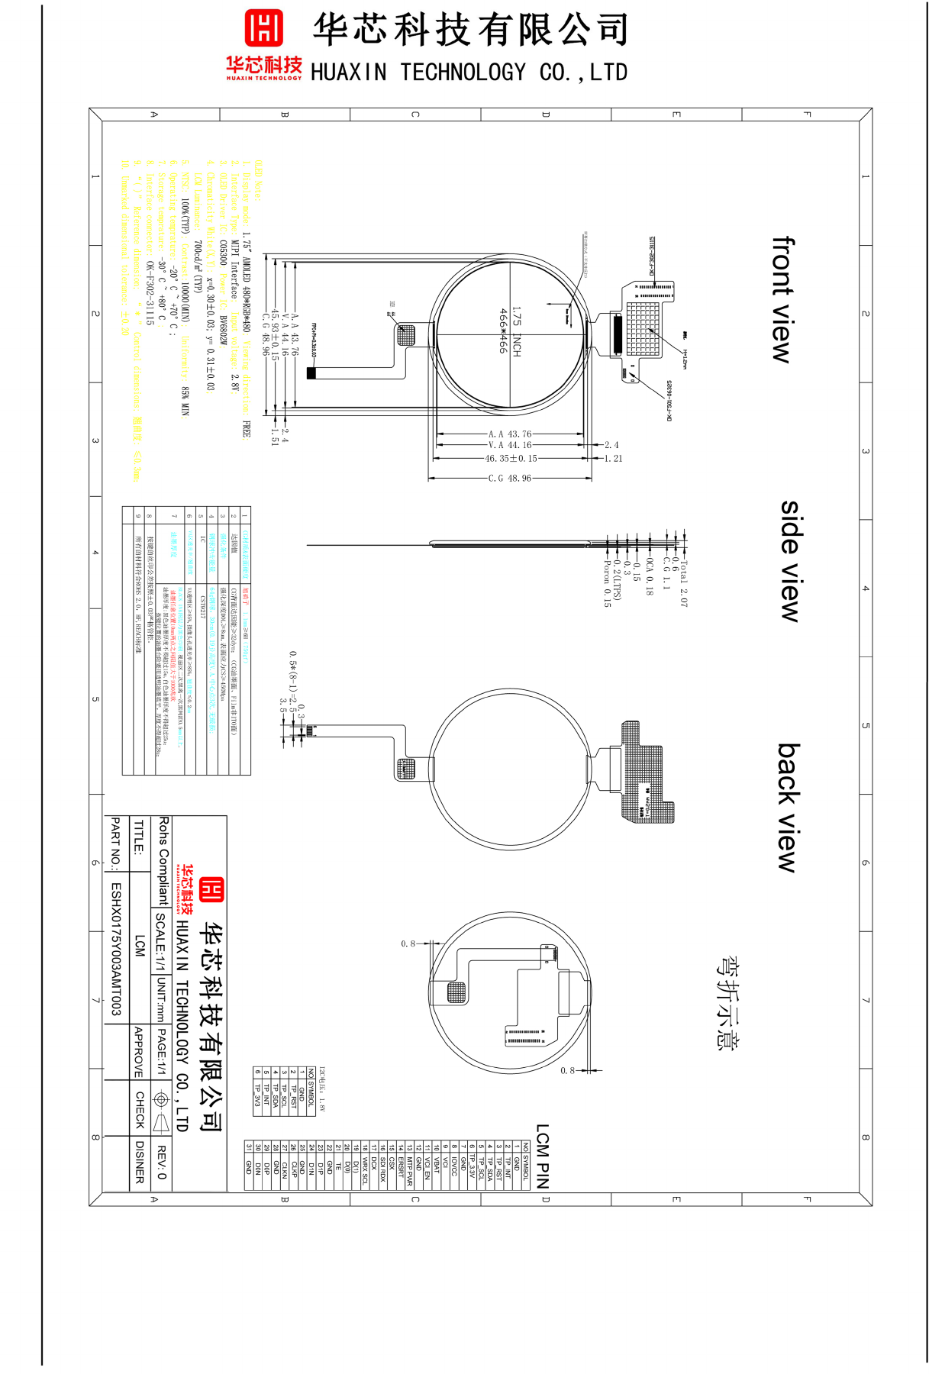
evidence/panel-mechanical.png
