Ale1x/auto-gauge/evidence/tcan-power.png

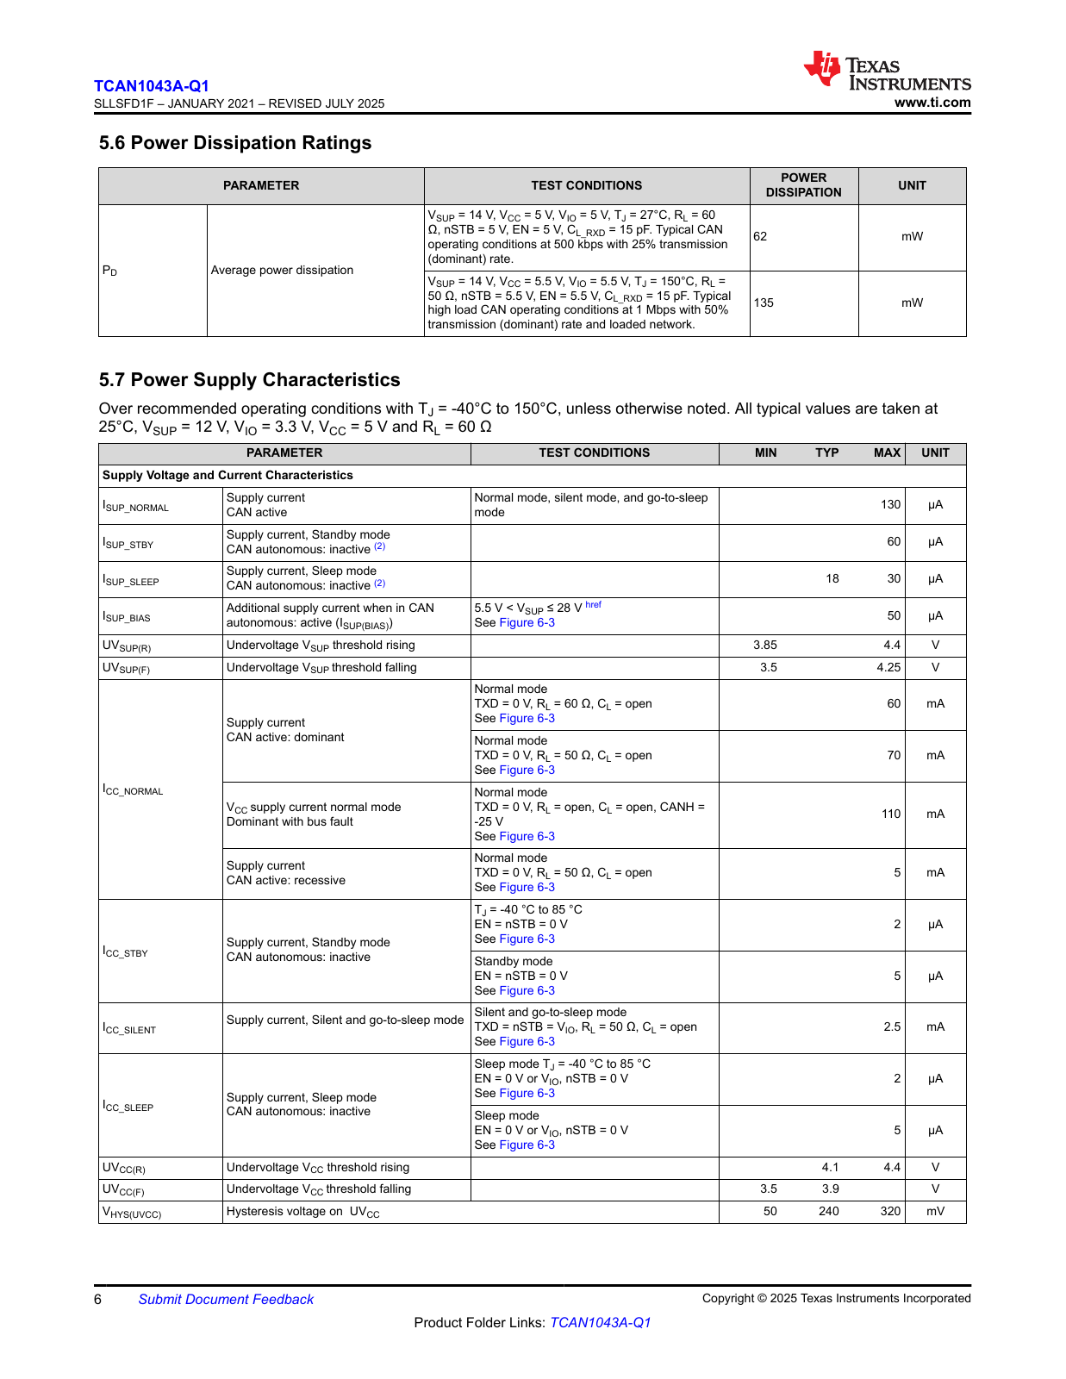
evidence/tcan-power.png
