Ale1x/auto-gauge/evidence/tps7a21-thermal-table.png

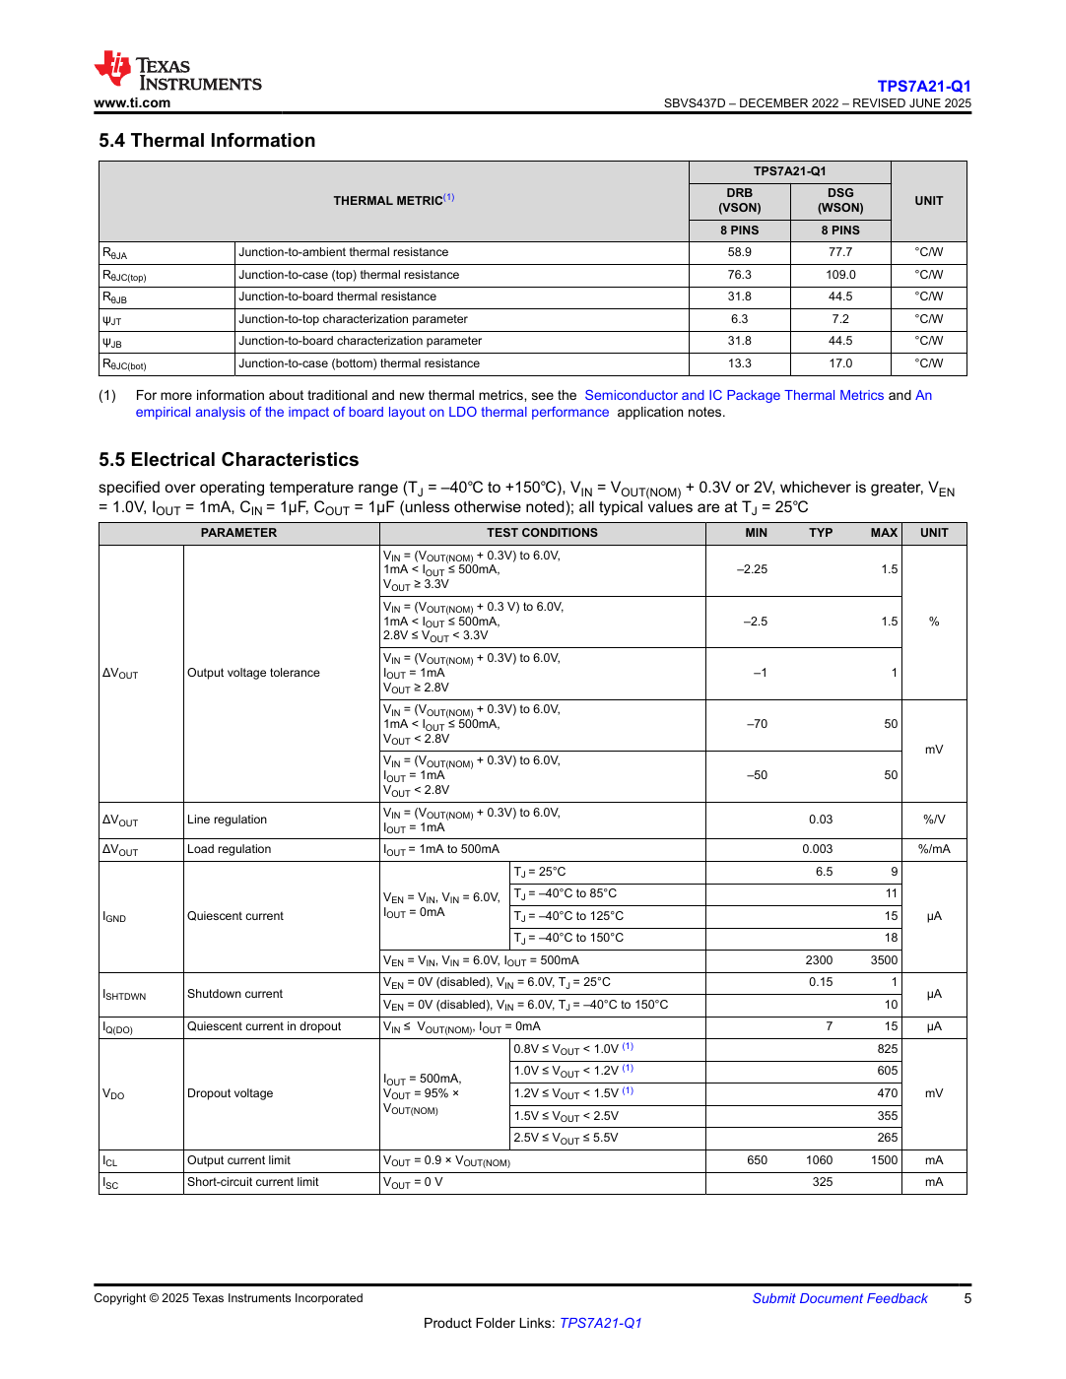
evidence/tps7a21-thermal-table.png
