Ale1x/auto-gauge/evidence/tps2116-limits-04.png

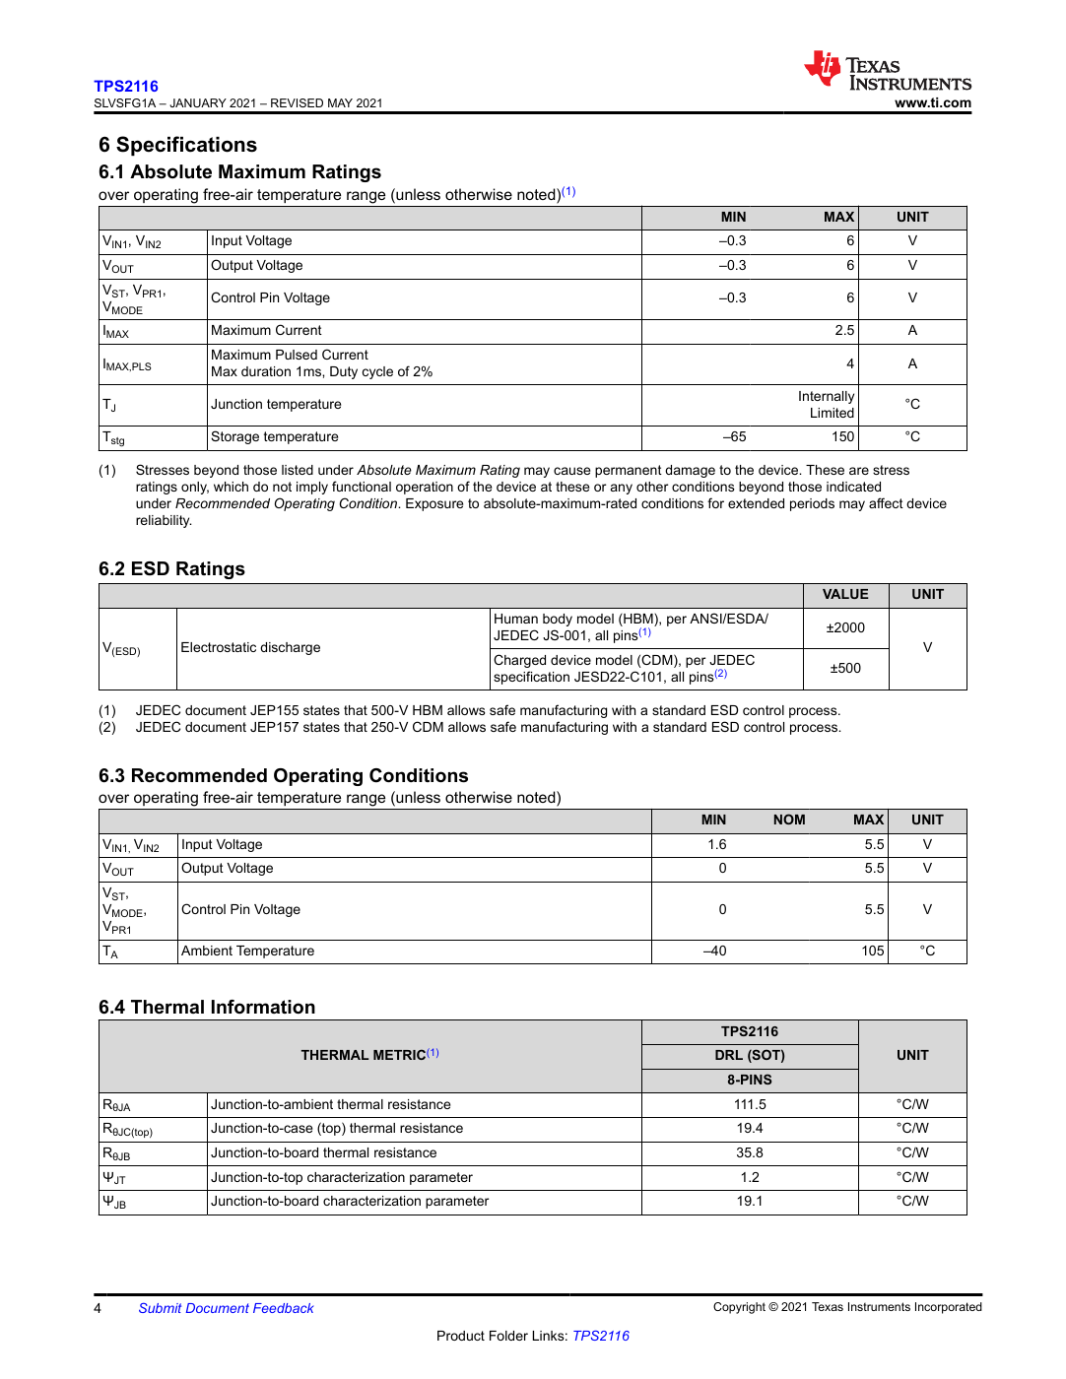
evidence/tps2116-limits-04.png
