Ale1x/auto-gauge/evidence/tps2116-limits-05.png

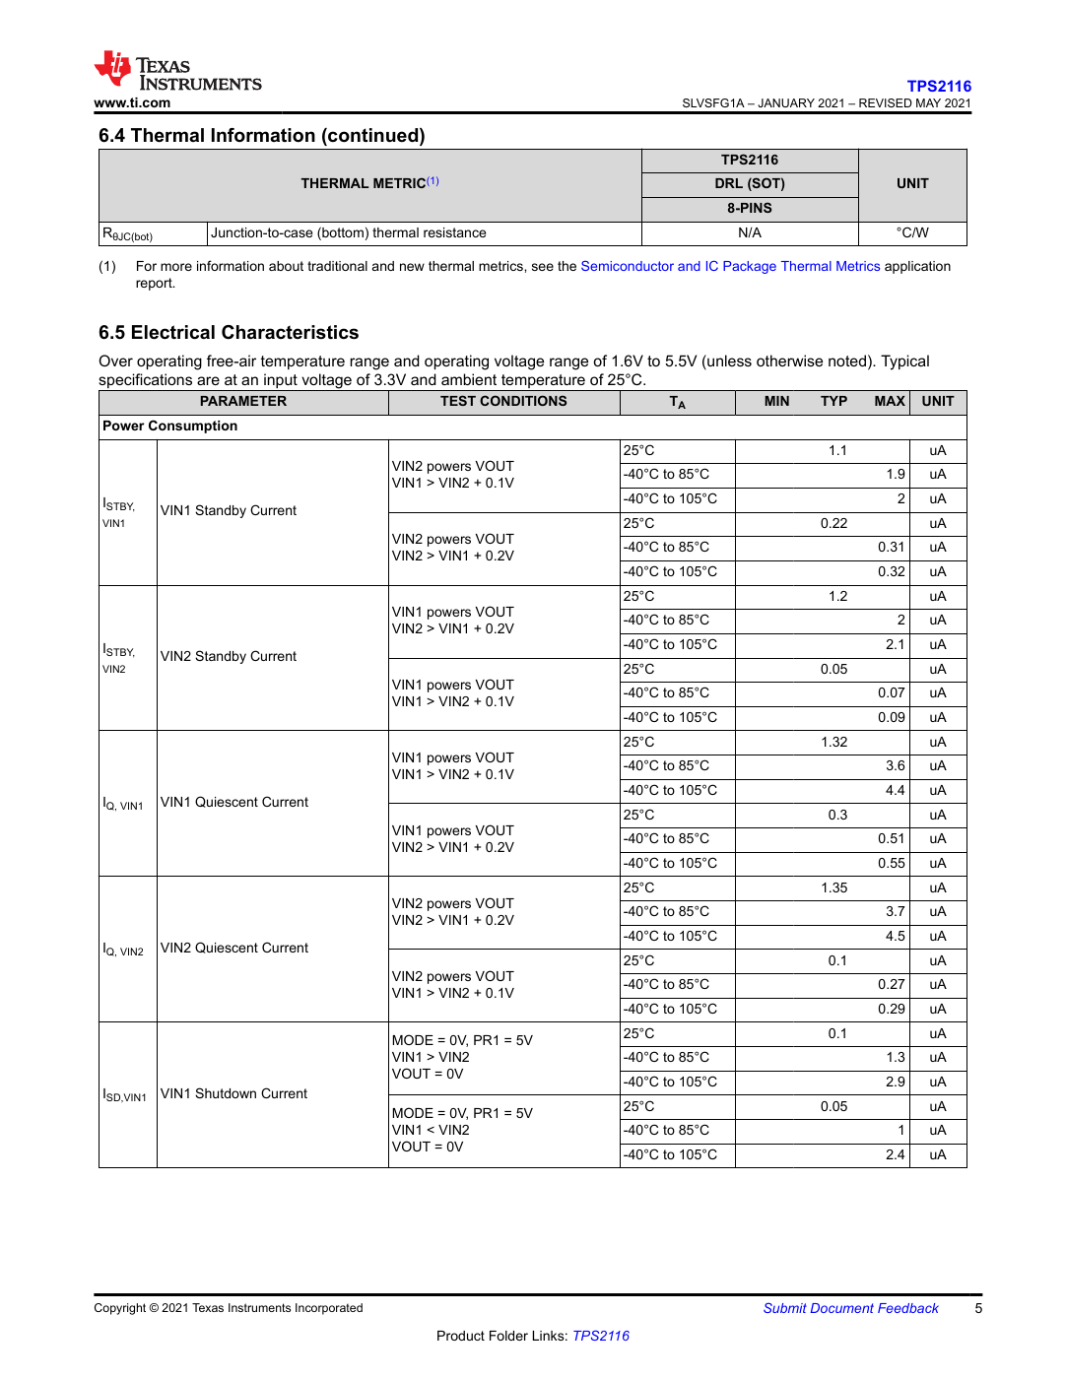
evidence/tps2116-limits-05.png
