Ale1x/auto-gauge/evidence/tps6281x-current-table.png

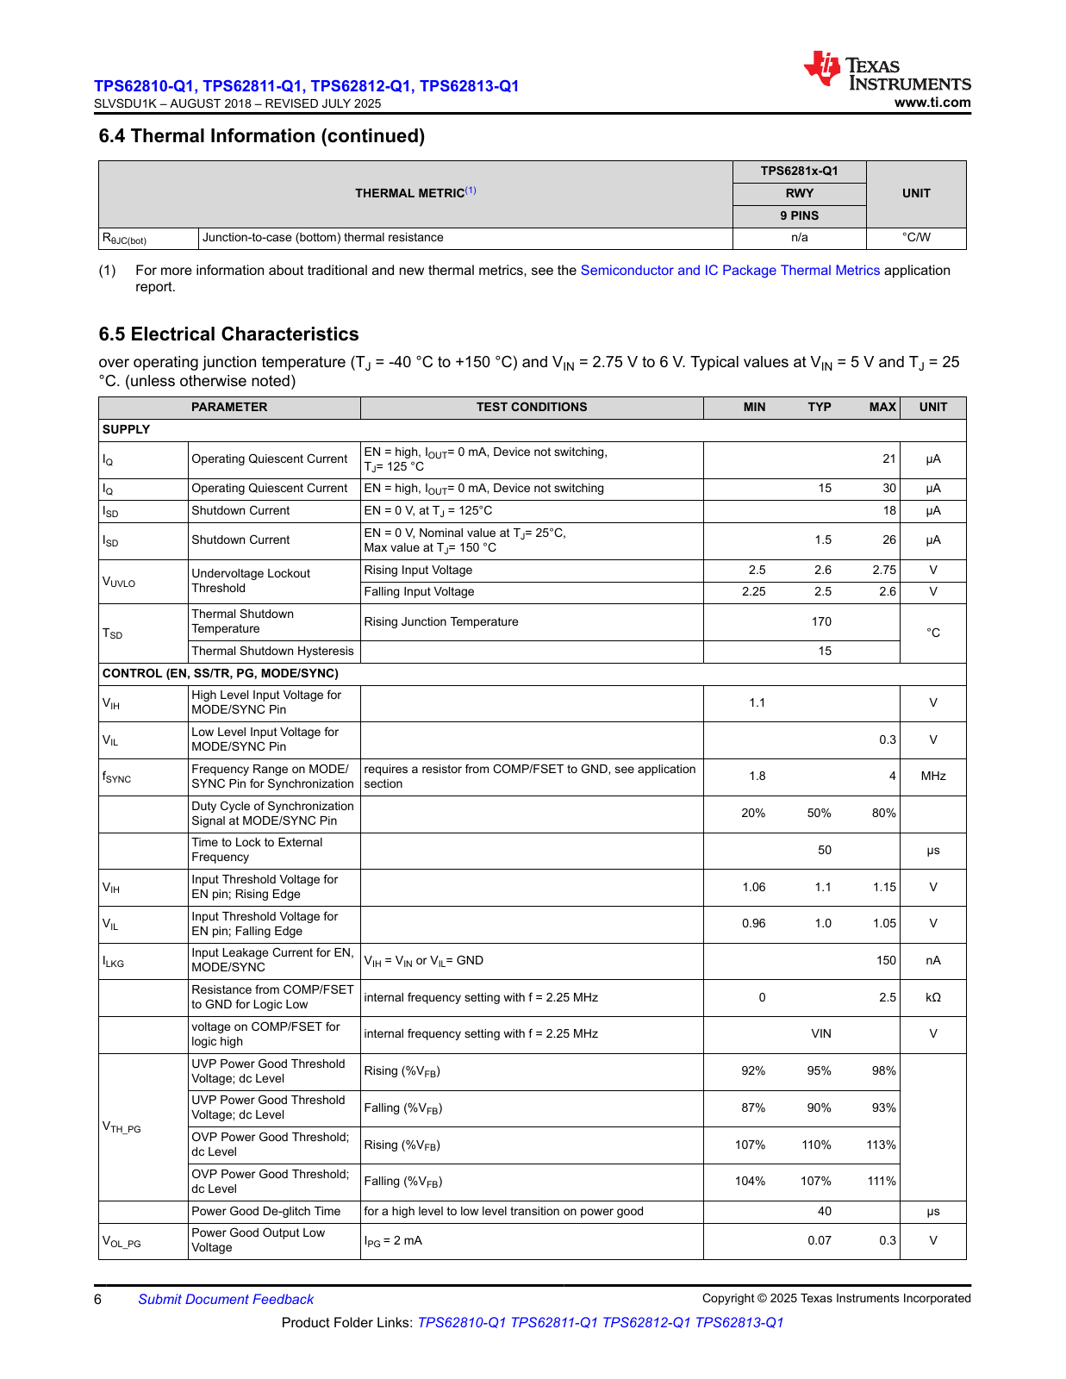
evidence/tps6281x-current-table.png
