Ale1x/auto-gauge/evidence/viewe-electrical.png

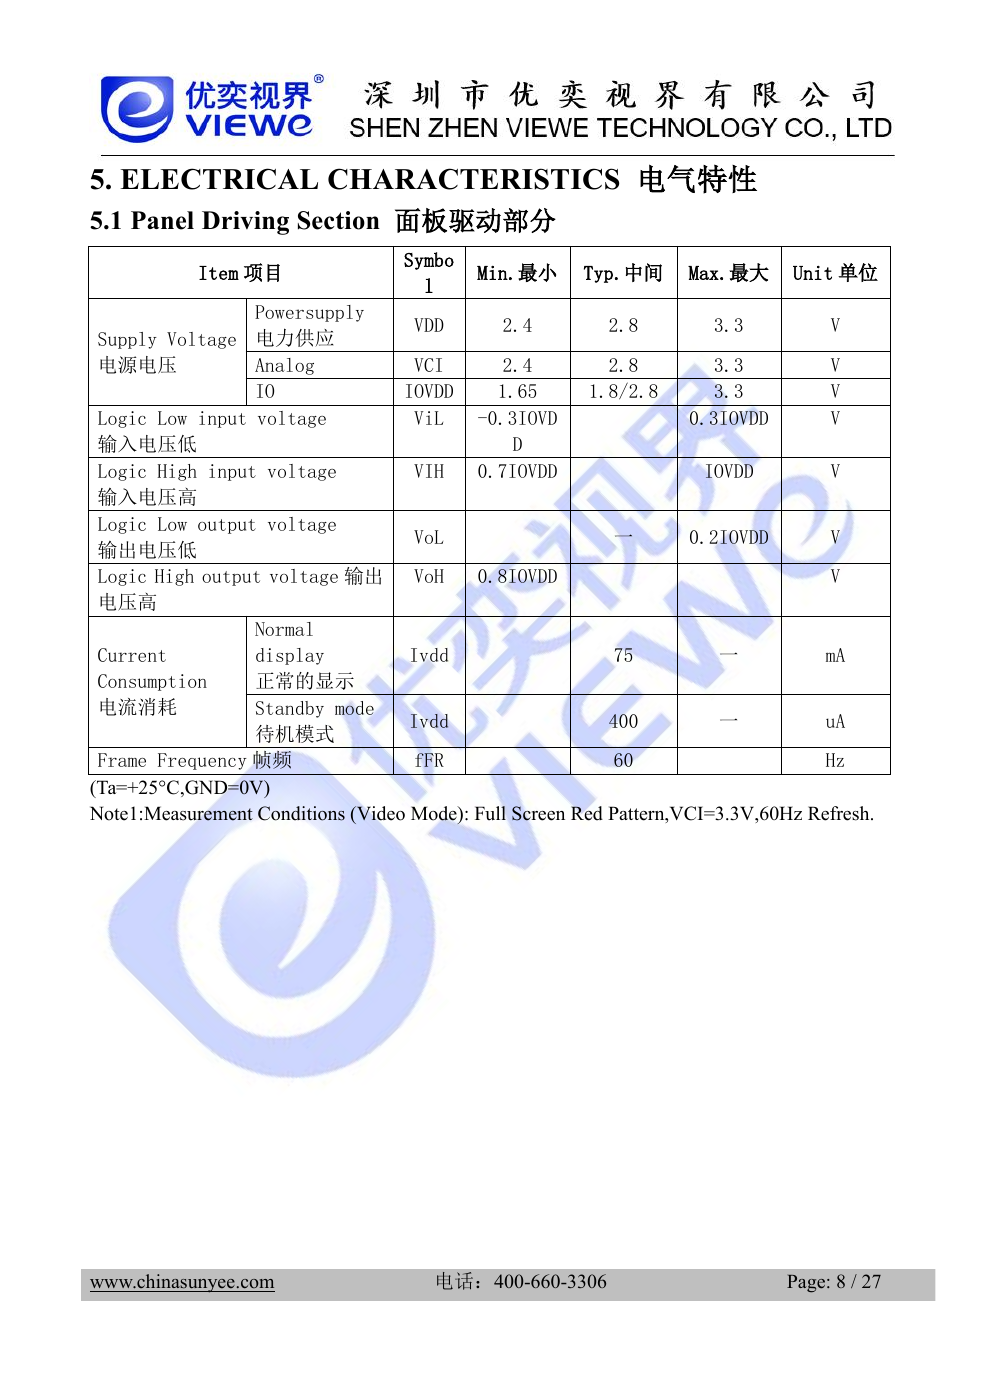
evidence/viewe-electrical.png
