Ale1x/auto-gauge/evidence/viewe-mechanical.png

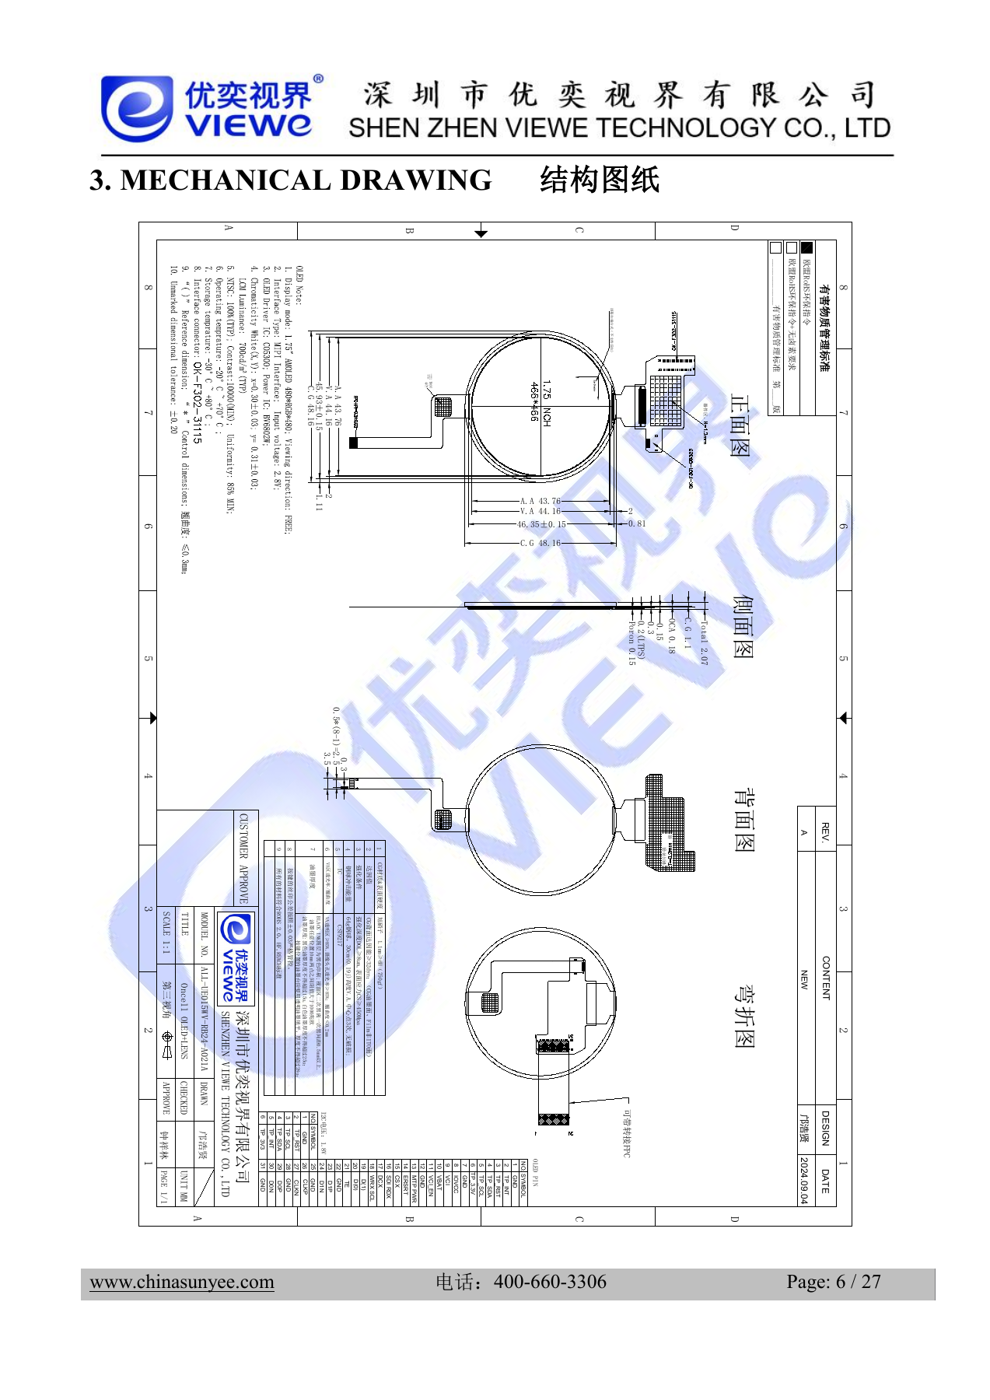
evidence/viewe-mechanical.png
