Ale1x/auto-gauge/hardware/mechanical/gauge-k0-concepts.drawio.png

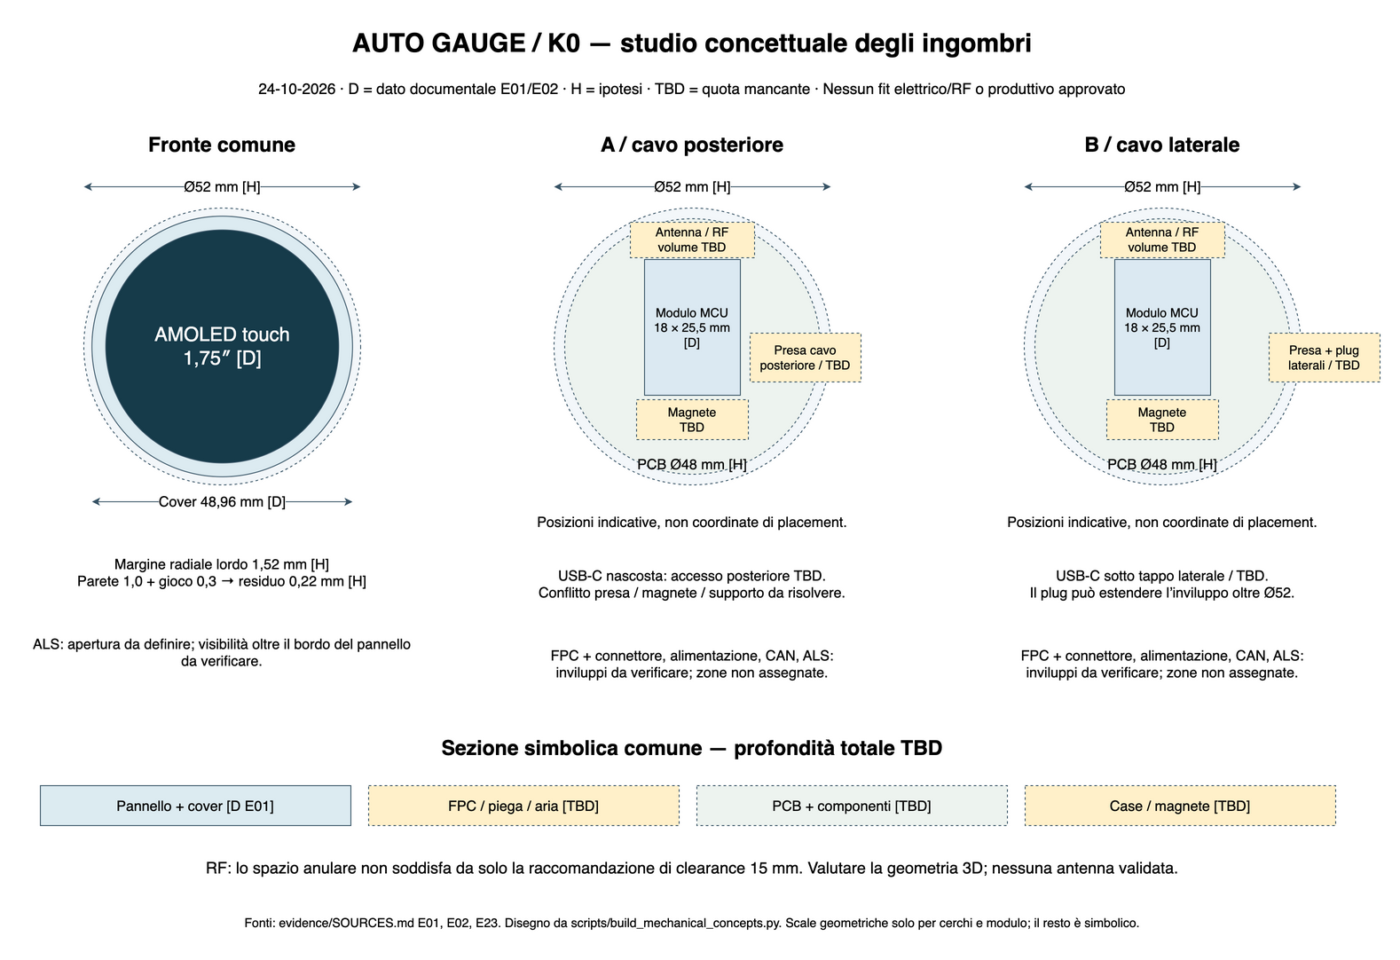
hardware/mechanical/gauge-k0-concepts.drawio.png
