Ale1x/auto-gauge/hardware/presence_sensing/presence_sensing_render.png

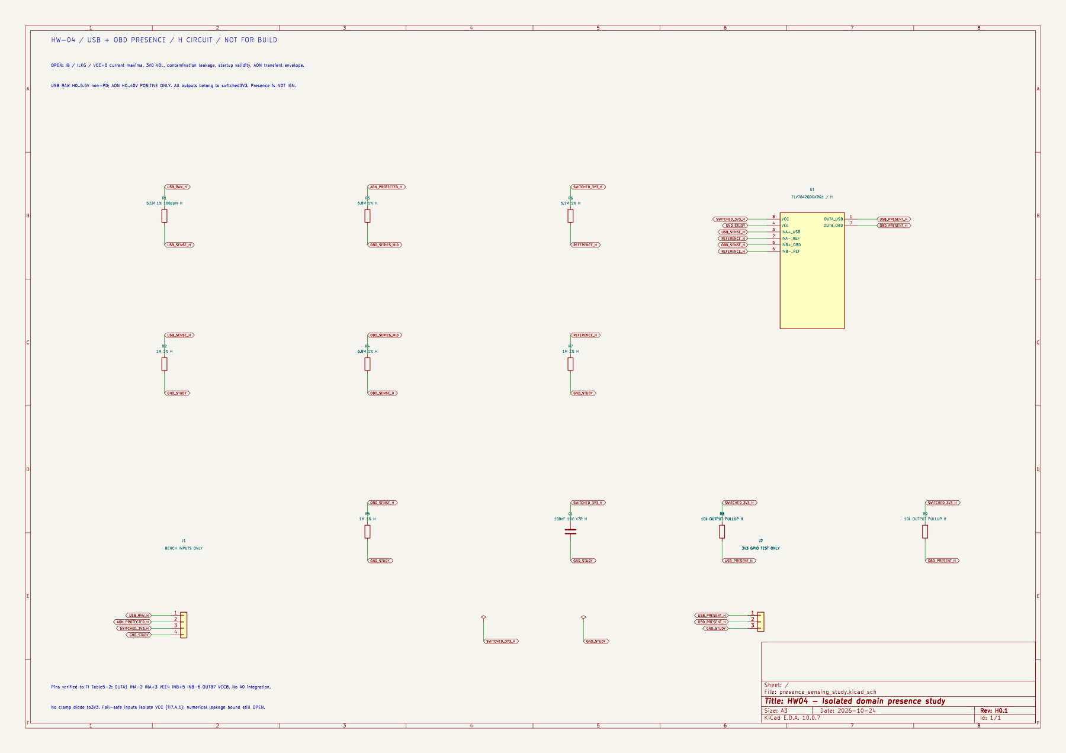
hardware/presence_sensing/presence_sensing_render.png
