Ale1x/auto-gauge/hardware/presence_sensing/sources/dual_electrical_table.png

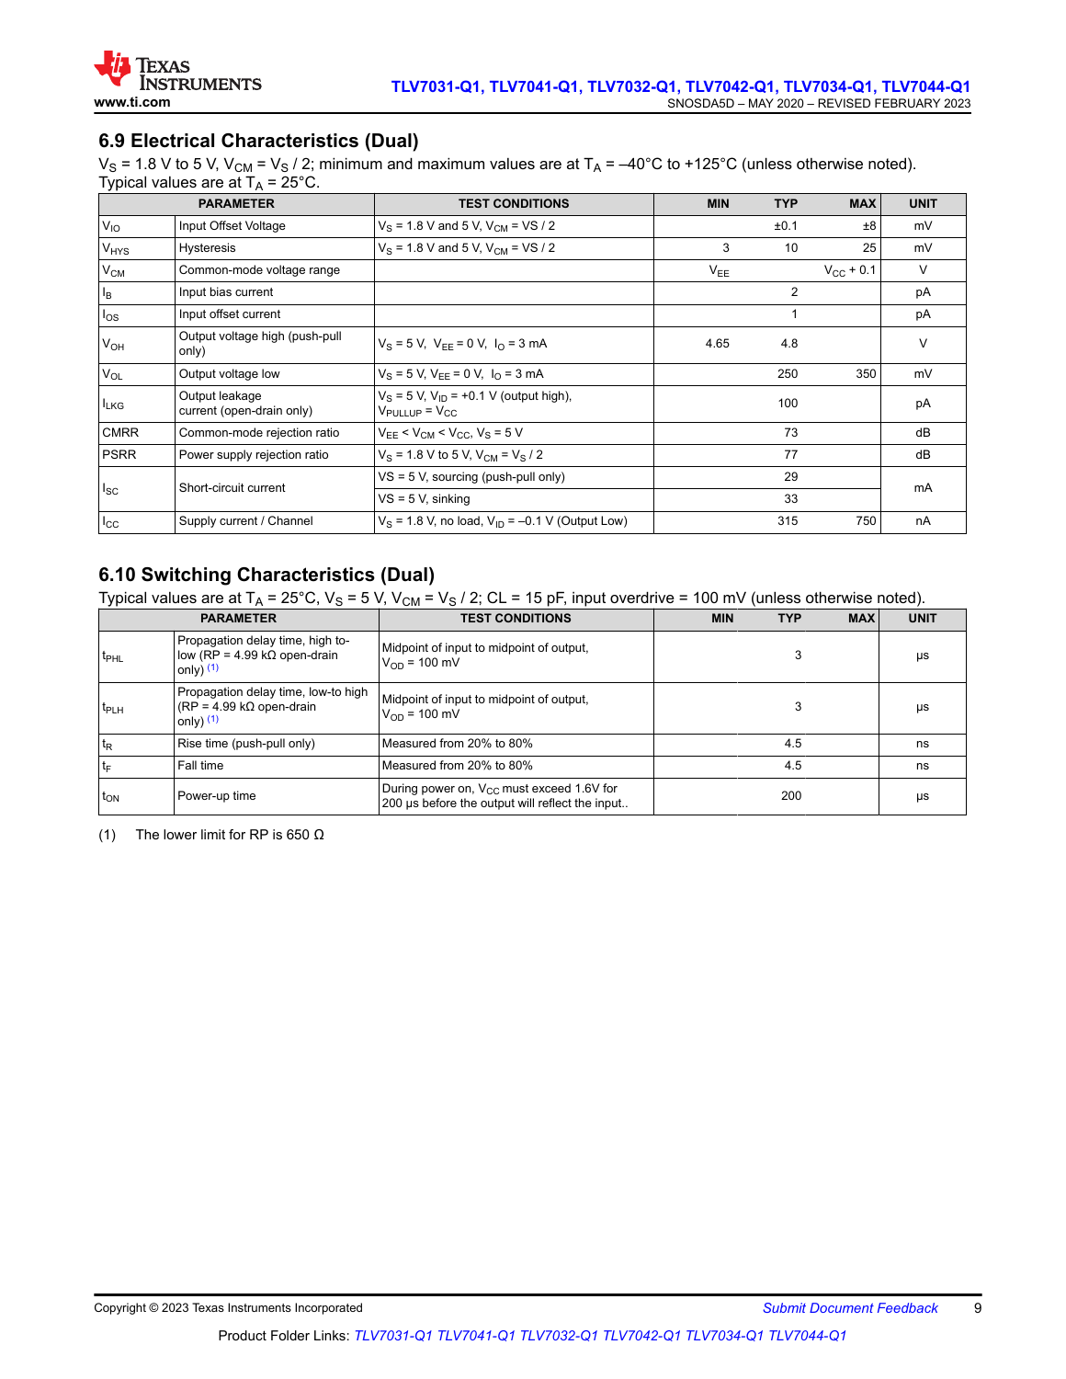
hardware/presence_sensing/sources/dual_electrical_table.png
