Ale1x/auto-gauge/hardware/usb_power/design_v01/sources/coilcraft_xal4030_curves.png

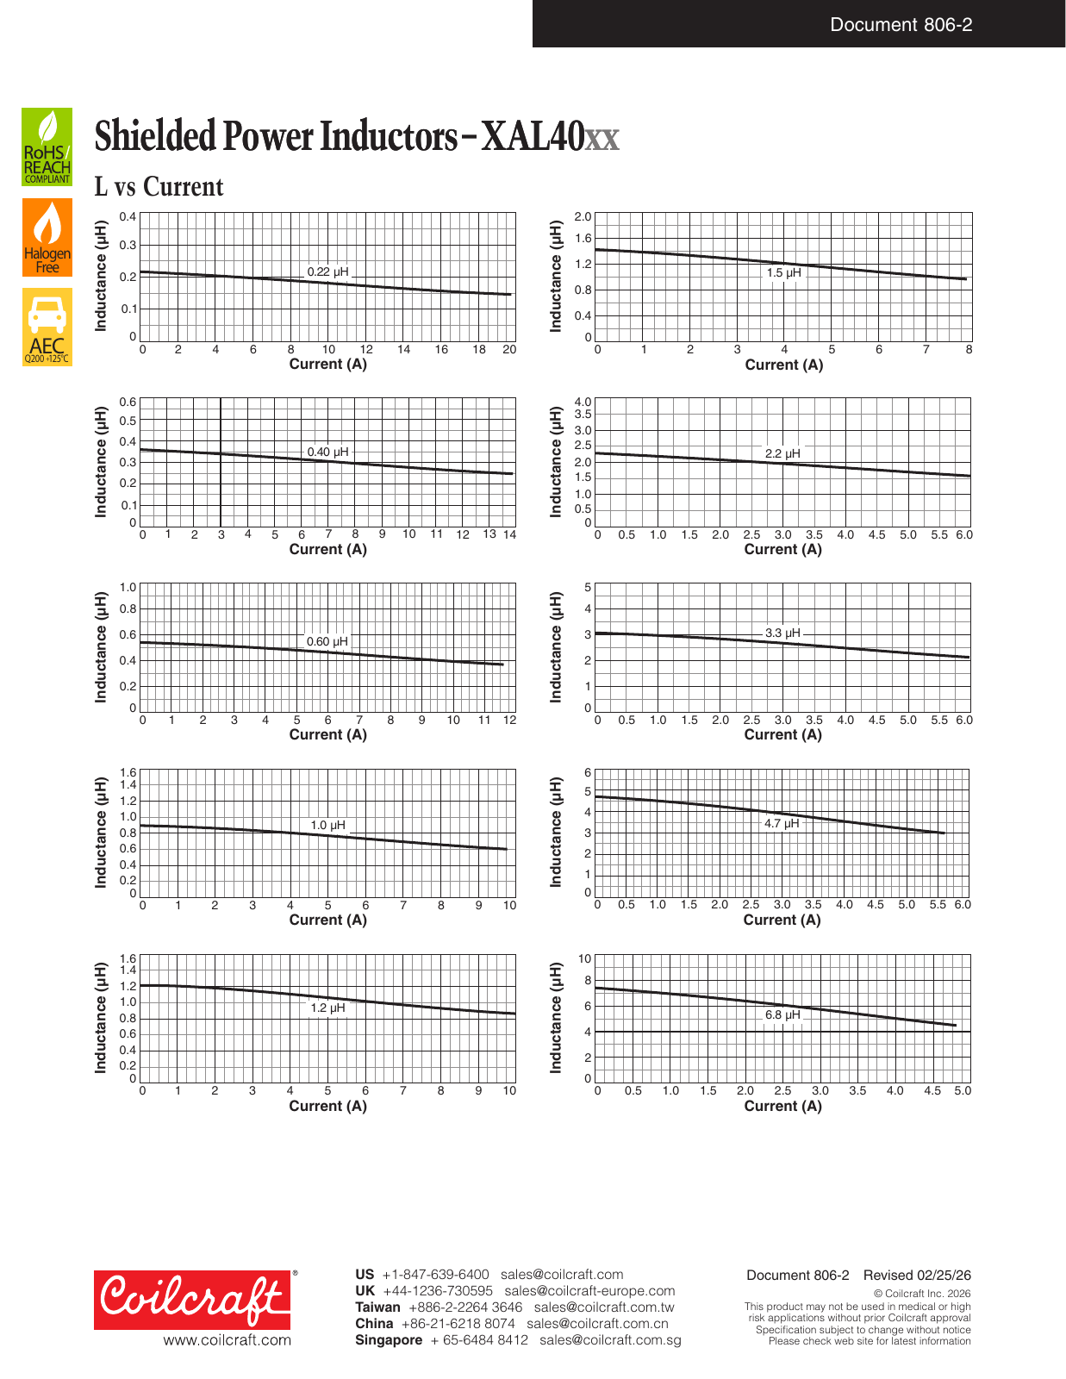
hardware/usb_power/design_v01/sources/coilcraft_xal4030_curves.png
