Ale1x/auto-gauge/hardware/usb_power/design_v01/study_render.png

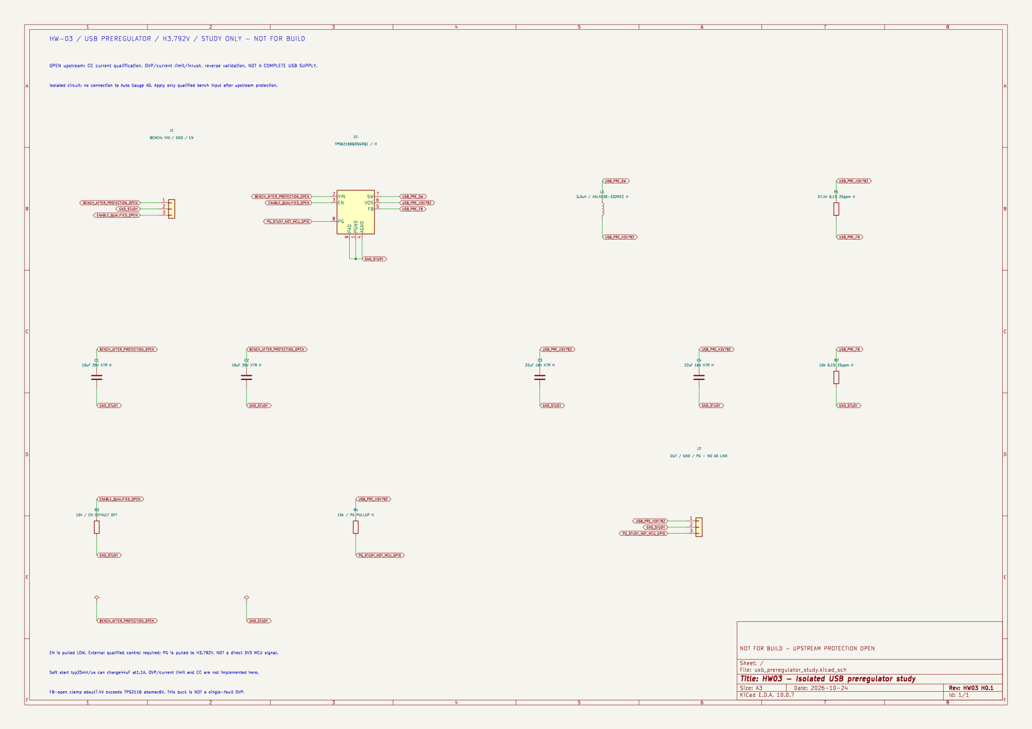
hardware/usb_power/design_v01/study_render.png
