Ale1x/auto-gauge/hardware/usb_power/sources/tps2596-table7.png

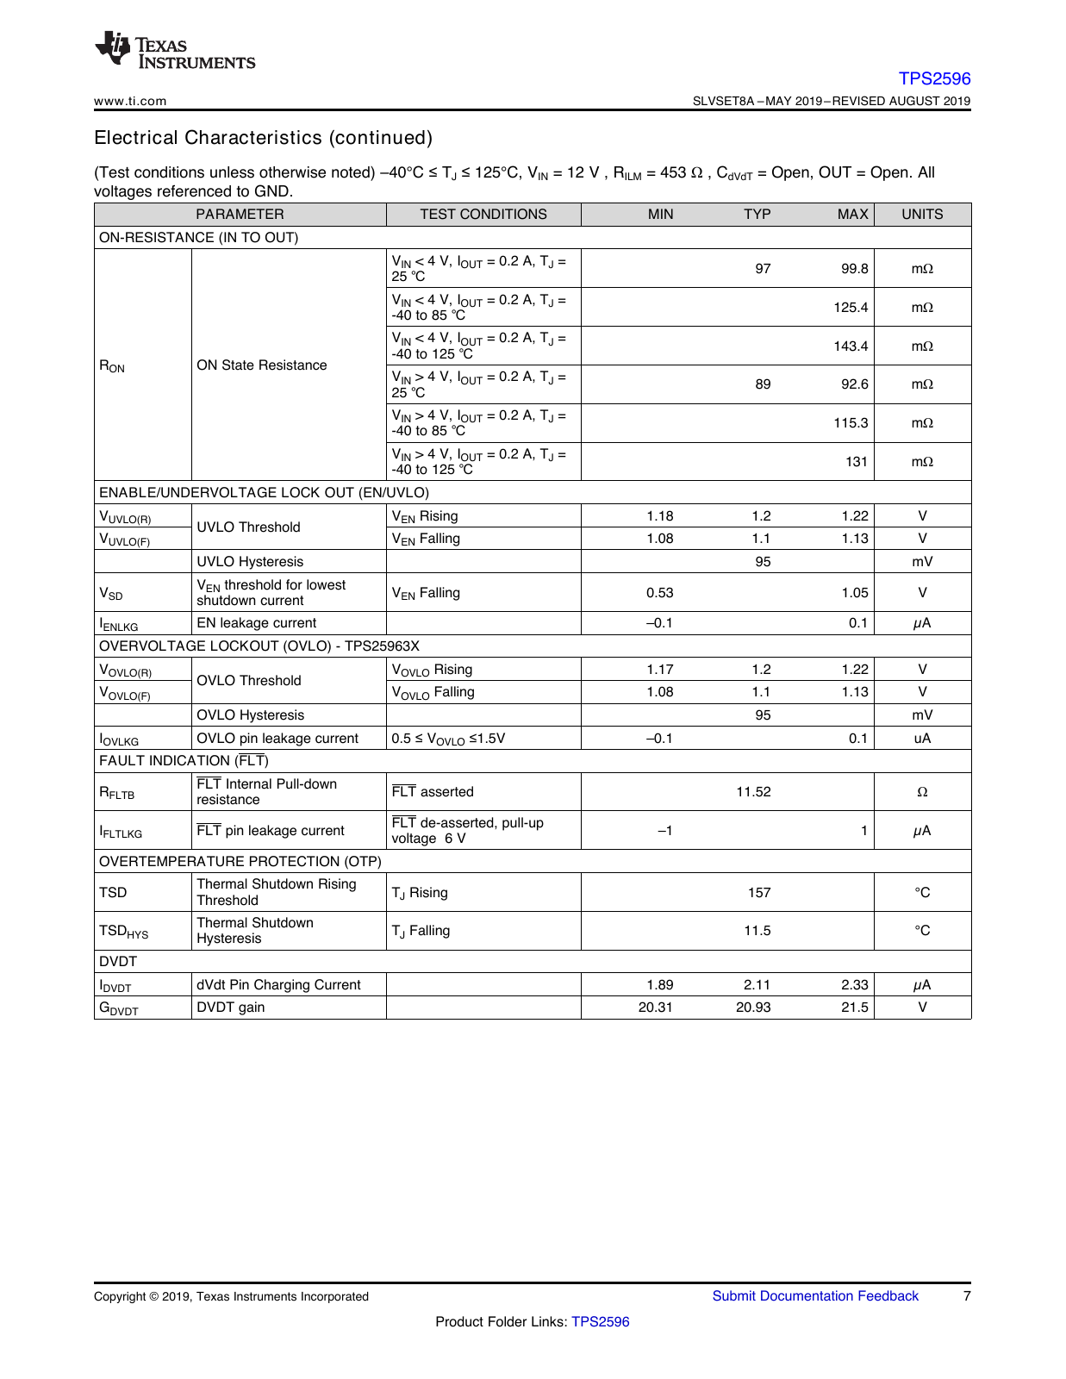
hardware/usb_power/sources/tps2596-table7.png
