Ale1x/auto-gauge/hardware/usb_power/sources/tps25940-table6.png

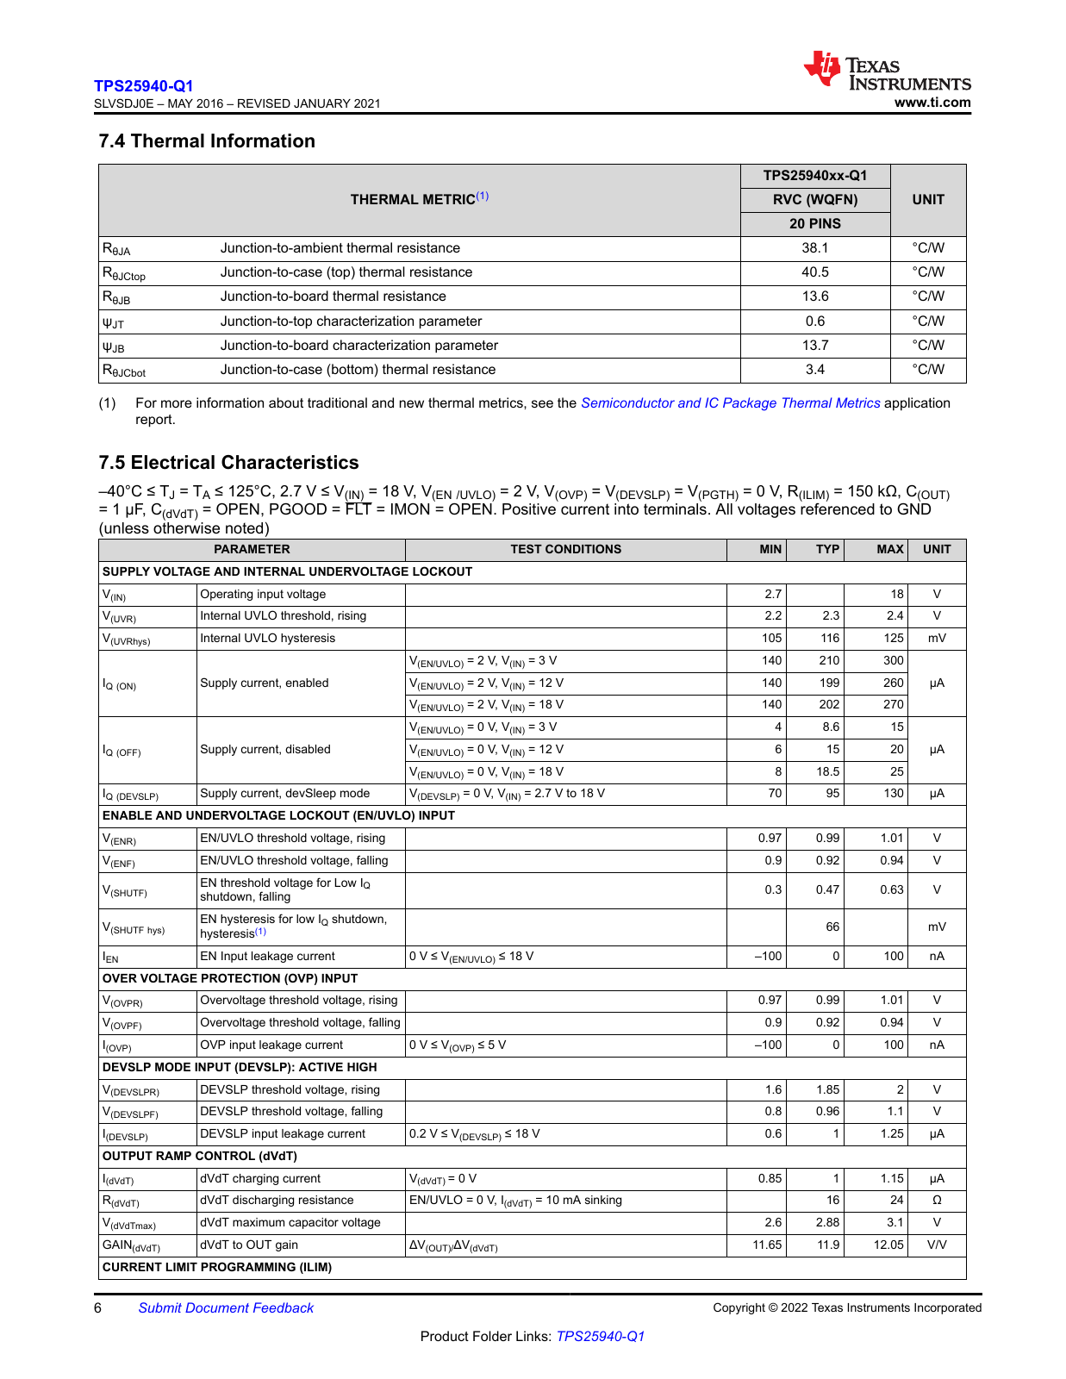
hardware/usb_power/sources/tps25940-table6.png
