Ale1x/auto-gauge/docs/suppliers/SUPPLIER_CONTACT_LOG.md

# Registro contatti fornitori — 2026-10-24

Autorizzazione esplicita del proprietario a contattare VIEWE, Huaxin, JLCPCB e PCBWay ricevuta in chat; indirizzo di risposta fornito: passarelli598@gmail.com. Contatto usato: Auto Gauge project. Nessun ordine o pagamento autorizzato o effettuato.

| Fornitore | Canale | Stato comprovato | Evidenza |
|---|---|---|---|
| VIEWE | Modulo prodotto, selezione Technical Support | INVIATO; sito mostra «Your submission was successful.» | evidence/contact/viewe-submission.png |
| Huaxin | Modulo prodotto + risposta Gmail da Janie | RISPOSTA ricevuta24/10/2026,11:24:43 Europe/Rome: campioni a stock, USD10/unità; trasporto da quotare | E32; evidence/contact/huaxin-submission.png |
| Ecer | Email Jessica, Buyer Service | RICHIESTA INFORMAZIONI ricevuta24/10/2026,12:15:10 Europe/Rome; nessuna offerta | E33 |
| JLCPCB | Gmail a support@jlcpcb.com | INVIATO24/10/2026; API label SENT | messaggio/thread1a16d739c384f6e6 |
| PCBWay | Gmail a service@pcbway.com | INVIATO24/10/2026; API label SENT | messaggio/thread1a16d73a05737e49 |

Le conferme provano la ricezione del modulo da parte del sito, non una risposta commerciale né approvazione tecnica. I testi di riferimento sono docs/suppliers/SUPPLIER_MESSAGES_READY.md; nel modulo è stato inserito il recapito approvato. Nessun allegato progettuale caricato. Non reinviare duplicati a VIEWE/Huaxin senza motivo documentato.

Aggiornamento verificato in Gmail: due messaggi ricevuti, registrati come E32/E33. Allegato Huaxin salvato in evidence/huaxin-email-2026-10-24.pdf. Nessun blocker tecnico chiuso. Le email costituiscono evidenza commerciale/documentale, non istruzioni a cambiare requisiti o ordinare.

Follow-up Huaxin INVIATO il24/10/2026 tramite Gmail, dopo che il proprietario ha fornito il recapito di spedizione per il preventivo. Messaggio `1a16d72c214c2295`, thread `1a16d3a6a89c9b04`, label SENT confermata dall’API. Testo conservato in evidence/contact/huaxin-followup-2026-10-24.html. Richiesti costo spedizione in Italia, disponibilità di cinque campioni, conferma prezzo/codice/touch e rettifica dei dati tecnici. Chiarito che il prodotto richiesto è1,75″ e che non si tratta di un ordine. In attesa di risposta; nessun pagamento o acquisto.

Richieste assemblaggio JLCPCB/PCBWay inviate separatamente, senza CC fra fornitori, usando il testo già autorizzato. Nessun allegato di produzione. Corpo conservato in evidence/contact/assembly-inquiry-2026-10-24.html. Indirizzi riconfermati sulle pagine ufficiali E10/E11 (riverifica24/10/2026). Invio API non prova lettura, accettazione di montaggio completo o preventivo. In attesa di risposta.

KDS: estensione del consenso ricevuta esplicitamente in chat il24/10/2026. INVIATO a mail@kds-online.de tramite Gmail, messaggio/thread1a16d7e3b92f1aaa, label SENT. Richiesti disegno/rating del33114 e fattibilità di cinque cavi2m CAN+potenza, con riferimenti4/5 separati nello studio, strain relief e protezione al prelievo da valutare. Nessun indirizzo personale di spedizione o allegato riservato trasmesso; nessun ordine. Testo conservato in evidence/contact/kds-inquiry-2026-10-24.html. In attesa di risposta.

Controllo Gmail mirato del24/10/2026,12:46UTC: ricerche nei messaggi ricevuti oggi per domini fornitori noti e oggettoAMOLED restituiscono soltanto E32/Janie ed E33/Jessica già registrati. Nessuna nuova risposta ai follow-up trovata in queste ricerche, nessuna modifica ai blocker pannello/cavo/assemblaggio. Non è un monitoraggio continuo né una ricerca di tutta la casella; nessun nuovo invio, ordine o pagamento.

## Aggiornamento — 25 ottobre 2026

Riletti thread Gmail Janie `1a16ea8142ede051` e `1a16d3a6a89c9b04`. La risposta delle 18:04:21 del24/10 (Europe/Rome) segnala problemi di consegna email e chiede un contatto alternativo; l'utente risponde alle18:06:09. Il materiale WhatsApp fornito in `email-response/` è ora esaminato (E53/E54; [analisi](../../evidence/HUAXIN_RESPONSE_2026-10-25.md)). Screenshot: confermati cinque ESHX0175Y003AMT003 on-cell, USD50 prodotto + USD50 UPS = USD100 dichiarati, partenza entro2–3giorni dal pagamento. Oneri importazione/IVA e revisione campioni non chiariti. Acquisiti wiring V1, due sequenze display, pacchetto factory CST9217 e tre foto FPC opzionali. Restano chiarimenti elettrici/termici e meccanici; nessun ordine, pagamento o nuovo messaggio. L'attesa del follow-up Huaxin sopra è superata da queste evidenze, non dagli altri fornitori.
