Ale1x/auto-gauge/docs/suppliers/SUPPLIER_MESSAGES_READY.md

# Richieste esterne pronte per revisione — 2026-10-24

Stato aggiornato: invio autorizzato dal proprietario; VIEWE/Huaxin inviati e confermati dal sito; JLCPCB/PCBWay inviati via Gmail con label SENT. Dettagli in docs/suppliers/SUPPLIER_CONTACT_LOG.md. Nessun acquisto, ordine o impegno economico. Testi senza allegati riservati; firma progetto «Auto Gauge prototype project». Canali pubblici nelle fonti E10/E11/E18–E22.

## 1. VIEWE — richiesta tecnica pannello

Destinatario pubblico: support@viewedisplay.com; canale alternativo: form sulla pagina E19.

Subject: Five bare 1.75-inch round touch AMOLED samples — exact part identity and technical clarification

Hello,

We are assessing five prototypes of a 12 V OBD-II gauge with one custom PCB and a bare 1.75-inch circular AMOLED panel with capacitive touch. The enclosure is being studied around 52 mm diameter; this is not a frozen mechanical specification.

Your product page lists ALL-UEOL018VG-RA31-A001A at USD 14.99, but its linked PDF cover identifies ALL-UEOL018WV-RA31-A001A and the mechanical drawing title block identifies ALL-UE015WV-RB24-A021A. Please confirm the exact orderable part and provide a corrected, revision-controlled datasheet for that exact assembly.

We need the full mechanical outline and tolerances including cover lens, folded FPC and component area; mating connector part numbers and pin numbering/contact orientation; all supply rails, sequencing, QSPI and touch logic levels; initialization code; maximum current per rail versus brightness/pattern and temperature; permitted operating/storage temperatures. Please clarify the differing temperature figures and the 1.8 V touch note in the linked document.

Can you supply five bare panels with touch, without a controller PCB? Please confirm stock, sample MOQ, exact unit price, shipping options to Italy, lead time, product revision and continuity of supply. An initial answer without payment or an order is requested.

Thank you,
Auto Gauge prototype project

## 2. Huaxin — richiesta tecnica alternativa

Canale: form del prodotto E18, contatto pubblico vivizhang@eshxj.com.cn.

Subject: Five 1.75-inch round AMOLED touch samples — ESHX/HX0175Y003AMT003 clarification

Hello,

We are assessing five prototypes using a bare 1.75-inch circular touch AMOLED on one custom PCB, without a development board. Please confirm whether ESHX0175Y003AMT003 in your published V0 PDF and HX0175Y003AMT003 on your product page are the same orderable assembly, and whether five samples can be supplied despite the listed production MOQ of 1000.

Please provide a corrected datasheet for the exact sample revision: supply rails and power sequencing, logic levels, maximum current per rail, operating/storage temperatures, initialization code, full mechanical/FPC drawing with tolerances and mating connector part numbers. The current document contains differing supply/temperature values, which we cannot resolve from a development board pinout.

Please confirm price, stock, sample lead time and shipping options to Italy. The enclosure diameter is not yet frozen; approximately 52 mm is the current study assumption. This is a feasibility inquiry, not an order or commitment to buy.

Thank you,
Auto Gauge prototype project

## 3. JLCPCB / PCBWay — fattibilità assieme completo

Canali: support/form ufficiale JLCPCB E10 e richiesta OEM/box build PCBWay E11. Non caricare un ordine o file di produzione inesistenti per simulare una quotazione.

Subject: Pre-design feasibility inquiry — five complete OBD gauge assemblies including display and cable

Hello,

Before freezing the PCB design, we would like to confirm feasibility for five complete prototype assemblies: one custom PCB, a bare 1.75-inch round AMOLED touch panel connected by FPC, a 2 m cable with twisted CAN pair, a Type A J1962 vehicle plug, and a detachable connector at the gauge. The system is for nominal 12 V vehicles only. The panel and final enclosure dimensions are not frozen; approximately 52 mm diameter is currently under study.

Can your service source or accept consigned panels, install and secure the FPC/panel manually, manufacture/source the cable and connectors, provide strain relief, and deliver all parts connected rather than only the SMT PCB? A candidate gauge connector is the Molex 0430200600/0430250600 pair, including appropriate crimp contacts and a short internal pigtail to the same PCB; it is not frozen.

Please distinguish PCB/PCBA, panel sourcing, cable/connector sourcing, manual assembly, fixtures/NRE, flashing, functional test, packaging, shipping and taxes. The indicative target is EUR 40–70 per finished unit for five units; the exact cost boundary is still being clarified. Please state any MOQ, exclusions, consigned-material requirements, scrap allowance and whether this target appears plausible before detailed design.

Gerbers, final BOM/CPL and assembly drawings do not exist yet. Please identify the information you require for an initial engineering assessment and a later binding quote. No manufacturing order or payment is authorized by this inquiry.

Thank you,
Auto Gauge prototype project

## 4. KDS — invio autorizzato ed eseguito24/10/2026

Destinatario pubblico verificato: mail@kds-online.de, da Impressum E42. Estensione del consenso ricevuta in chat; Gmail conferma SENT, messaggio1a16d7e3b92f1aaa. Nessun indirizzo di spedizione personale incluso in questa prima richiesta.

Subject: Technical inquiry — five Type A OBD plugs and 2 m CAN/power cable assemblies

Hello,

We are assessing five prototypes of a nominal 12 V OBD-II CAN gauge. Your article 33114, OBD-2 Stecker 44, is a candidate vehicle-side Type A plug. Before selection, please provide the manufacturer part number and current dimensioned drawing, contact numbering viewed from the mating and wiring sides, contact current/voltage and operating-temperature ratings, permitted wire sizes and cable outside diameter, soldering instructions, and strain-relief details. Please confirm whether any PCB or electronics is included; our design uses one custom PCB at the gauge only.

Can you supply five complete 2 m cables with a genuine twisted CAN-H/CAN-L pair and appropriately rated battery/ground conductors, a Type A vehicle plug, and a free end for installation of a detachable gauge connector? Please provide cable impedance, construction, conductor resistance, sections, insulation diameters, outside diameter, temperature/flex ratings and pin-to-colour mapping. No termination resistor, gateway or other electronics should be included. We are studying OBD pins 6/14/16 with pins 4 and 5 kept separately available pending the ground design; no OEM pins are needed. The final wiring and gauge connector are not frozen.

The cable requires appropriate protection close to the battery pickup; please state whether an inline fuse and strain relief can be integrated without an additional PCB, and which further electrical/load data you need to evaluate that. Fuse rating is not yet selected.

Please distinguish the plug kit price from the complete cable/assembly price, MOQ, stock, lead time and shipping to Italy. This is a feasibility and quotation inquiry only, not an order or purchase commitment.

Thank you,
Auto Gauge prototype project
