Ale1x/auto-gauge/hardware/BOM_CANDIDATES.csv

funzione | MPN_candidato | datasheet_link | tensioni | range_termico_C | disponibilita | prezzo_unitario | quantita_per_unita | quantita_lotto_5 | libreria_KiCad_o_footprint | LCSC_JLC_code | alternativa | rischio | evidenza | stato
MCU BLE + memoria | ESP32-S3-WROOM-1-N16R8 | https://www.espressif.com/sites/default/files/documentation/esp32-s3-wroom-1_wroom-1u_datasheet_en.pdf | 3.0–3.6 V | -40…+65 standard; fino+85 con ECC PSRAM e capacità ridotta1/16 | Mouser/LCSC: indicazione pubblica indicizzata; riconfermare | USD 6.72 Mouser qty1; USD 5.0752 LCSC promozione qty1 | 1 | 5 | RF_Module:ESP32-S3-WROOM-1 trovato via MCP; pin/land pattern da verificare | C2913202 LCSC; JLC non confermato | WROOM con R2 o SoC separato: nuova verifica obbligatoria | ECC necessario per estensione termica; RF magnete; log/OTA non dimensionati; Wi-Fi da disabilitare | E02 E13 E14 | NON CONGELATO
CAN PHY con wake | TCAN1043ADRQ1 | https://www.ti.com/lit/ds/symlink/tcan1043a-q1.pdf | VCC 5 V; VIO 1.7–5.5 V; VSUP da verificare su profilo scelto | -40…+125 ambiente | DigiKey 1699 indicati; non riservati | USD 1.71 qty1 | 1 | 5 | TCAN1043xDxQ1:14pin corrispondono aE03; land pattern generico diverso da esempioTI, DFM aperto | TBD | TCAN1043ATDRQ1; compatibilità da verificare | Wake non IGN; rail5 necessario; leakage e Vsup protetti | E03 E15 evidence/kicad-tcan-library-audit.json | NON CONGELATO
Buck dominio MCU3.3V | TPS62811QWRWYRQ1 | https://www.ti.com/lit/ds/symlink/tps62813-q1.pdf | VIN2.75–6V; VOUT3.3 candidato regolabile;1A | -40…+125TA; TJfino150 daPDF | DigiKey indicizzati decine di pezzi; prezzo/stockUE eJLC da confermare | USD2.12–2.47 qty1 indicativi fra risultati; non offerta | 1 candidato | 5 se selezionato | RWY9pin3x2mm; footprint e pin da verificare | TBD | TPS7A21-Q1 solo confrontoLDO500mA, non equivalente | Stadio5Vprotetto; shutdown max26uA a150C; inrush/compensazione/EMI e budget aperti | E46 E48 docs/hardware/MCU_RAIL_K0.md | CANDIDATO NON CONGELATO
Buck automotive | LM5164QDDARQ1 | https://www.ti.com/lit/ds/symlink/lm5164-q1.pdf | VIN6–100 V; uscita candidata5 V; max1 A | -40…+125 ambiente | Famiglia attiva; stock MPN TBD | TBD | 1 | 5 | Regulator_Switching:LM5164DDA trovato via MCP; PowerPAD/pin/rating variante da verificare | TBD | Altro buck automotive dopo power budget | Non regola sotto6 V; margine potenza/termica non chiuso | E04 | CANDIDATO STOCK NON VERIFICATO
Protezione polarità OV OC | LM74900QRGERQ1 | https://www.ti.com/lit/ds/symlink/lm74900-q1.pdf | 3–65 V; MOSFET esterni | -40…+125 ambiente | Famiglia attiva; stock MPN TBD | TBD | 1 | 5 | VQFN24 RGE: custom/check datasheet | TBD | Architettura a basso IQ da confrontare | Modalità normale incompatibile100µA; percorsoSLEEP/wake e TVS/SOA da validare | E05 | CANDIDATO STOCK NON VERIFICATO
Sensore luce | OPT3001DNPRQ1 | https://www.ti.com/lit/ds/symlink/opt3001-q1.pdf | VDD1.6–3.6 V; I2C | -40…+105 grade2 | Stock MPN TBD | TBD | 1 | 5 | USON6 DNP: custom/check finestra ottica | TBD | Altro ALS automotive da verificare | Apertura case e calibrazione ottica | E06 | CANDIDATO STOCK NON VERIFICATO
Pannello AMOLED touch | ESHX0175Y003AMT003 | https://www.displayamoled.com/photo/displayamoled/document/88489/ESHX0175Y003AMT003-SPEC.pdf | NON CONGELABILI: incongruenze fra sezioni | Incongruente nel PDF; conferma richiesta | E32 email24/10: campioni dichiarati a stock; quantità5/trasporto da confermare | USD10 campione; trasporto/imposte esclusi o da chiarire | 1 | 5 | FPC e pinout solo dopo revisione corretta | TBD | Altro pannello1.75 equivalente; nuovo diametro da definire | Fit completo nel nuovo inviluppo non verificato; dati elettrici incompleti | E01 E18 E32 DEC-002 | CANDIDATO RIAMMESSO ALLO STUDIO; NON VALIDATO
Pannello AMOLED touch alternativo | ALL-UEOL018VG-RA31-A001A | https://viewedisplay.com/download/72/display-datasheet/6230/all-ueol018wv-ra31-a001a-v1-0-spec.pdf | TBD: PDF relativo a codici diversi | TBD: dati non coerenti fra pagina e PDF | Vendita diretta pubblica; stock lotto5 non confermato | USD14.99 prezzo esposto; trasporto e imposte esclusi | 1 alternativa non cumulativa | 5 se selezionato | Custom FPC solo dopo identità/drawing corretti | TBD | Huaxin ESHX0175Y003AMT003 | VG/WV/cartiglio discordanti; no pinout congelabile | E19 E20 docs/suppliers/PANEL_SOURCING_K0.md | CANDIDATO; BLOCCATO SU IDENTITA/DATASHEET
Pannello AMOLED touch alternativo | LX175A3101CTP01 | https://cdn.ozdisan.com/public/product/assets/LX175A3101CTP01.pdf | Rail incoerenti nelPDF:richiesta chiarimento necessaria | -20…+70 dichiarati dal distributore; da confermare | Özdisan stock0 MOQ1 lead time4–5settimane; Eurocoin su richiesta | TBD | 1 alternativa non cumulativa | 5 se selezionato | TBD dopo datasheet esatto | TBD | VIEWE / Huaxin, non drop-in | Ingombro51.5mm dichiarato; no fit Ø52 con pareti ipotizzate; touch diverso | E21 E22 E29 docs/suppliers/PANEL_SOURCING_K0.md | CANDIDATO DI RISERVA; NO STOCK; DATASHEET INCOERENTE
Connettore gauge a pannello | 0430200600 | https://www.molex.com/en-us/products/part-detail/430200600 | Da verificare con terminali/profilo transitori | -40…+105 dichiarati | DigiKey indicizzati3769; riconfermare | USD0.40 solo housing qty1 | 1 candidato | 5 | A pannello con pigtail; nessun footprint selezionato | TBD | Header PCB diretto, studio alternativo | Crimp e cablaggio interno extra; fit e strain relief non verificati | E24 E25 E27 docs/hardware/CONNECTORS_CABLE_K0.md | CANDIDATO NON CONGELATO
Housing femmina cavo gauge | 0430250600 | https://www.molex.com/en-us/products/part-detail/0430250600 | Da verificare con terminali/profilo transitori | Da confermare variante | DigiKey indicizzati85648; riconfermare | USD0.51 solo housing qty1 | 1 candidato | 5 | Cablaggio; nessun footprint | TBD | Presa esterna diversa da verificare | Terminali venduti separatamente; protezione contatti alimentati e mating da verificare | E24 E28 docs/hardware/CONNECTORS_CABLE_K0.md | CANDIDATO NON CONGELATO
Terminale maschio gauge | 0430310007 | https://www.molex.com/en-us/products/part-detail/430310007 | Sistema transitori da verificare | Da verificare con specifica assieme | DigiKey indicizzati232719; non riservati | USD0.23 qty1 indicizzato | 5 H se cinque linee cablate; pinout non congelato | 25 H più scarti da quotare | Crimp in0430200600; nessun footprint | TBD | Variante26-30AWG solo con altro terminale verificato | 20-24AWG; isolamento/tooling e30cicli da verificare per uso previsto | E36 E38 E39 docs/hardware/CONNECTORS_CABLE_K0.md | CANDIDATO; NON CONGELATO
Terminale femmina cavo | 0430300007 | https://www.molex.com/en-us/products/part-detail/430300007 | Sistema transitori da verificare | Da verificare con specifica assieme | DigiKey indicizzati422268; non riservati | USD0.20 qty1 indicizzato | 5 H se cinque linee cablate; pinout non congelato | 25 H più scarti da quotare | Crimp in0430250600; nessun footprint | TBD | Variante26-30AWG solo con altro terminale verificato | 20-24AWG; isolamento/tooling e30cicli da verificare per uso previsto | E37 E38 E39 docs/hardware/CONNECTORS_CABLE_K0.md | CANDIDATO; NON CONGELATO
Plug veicolo J1962 Type A candidato | KDS articolo33114 (codice fornitore; MPN produttore TBD) | https://kds-online.de/de/obd-2-steckerkit-44-j1962-typ-a-12v-male.html | 12VTypeA dichiarato; rating contatti/transitori TBD | TBD | Pagina indica a stock2–4giorni; lotto5 non confermato | EUR4.99 esposti incl.IVA19%; consegnaItalia/IVA da riconfermare | 1 candidato | 5 se selezionato | Cablaggio saldato; drawing/pinout lato mating da acquisire | TBD | Altra famigliaJ1962 TypeA con evidenze complete | Solo SKU/pagina commerciale: dati essenziali e protezione fusibile mancanti | E42 docs/hardware/CONNECTORS_CABLE_K0.md | CANDIDATO COMMERCIALE; NON CONGELABILE
Connettore gauge PCB alternativo4p | 0430450400 | https://www.molex.com/en-us/products/part-detail/0430450400?display=pdf | Rating pagina600V; verifica transitori e sistema necessaria | -40…+105 dichiarati | Stock indicizzato; MOQ/prezzo UE TBD | TBD | 1 alternativa non cumulativa | 5 se selezionato | THT right angle; footprint/pin e meccanica da verificare | TBD | Micro-Fit6p a pannello | Solo4vie richiede decisione masse;30cicli dichiarati; no fit dimostrato | E26 docs/hardware/CONNECTORS_CABLE_K0.md | ALTERNATIVA NON CONGELATA
TVS ingresso automotive | TBD |  | TBD | TBD | NON VERIFICATA | TBD | TBD | TBD | Da definire: 02_AUTOMOTIVE_POWER | TBD | TBD | Energia e clamp dopo O-07 | SPEC v0.2 / K0-001 | BLOCCATO / NESSUN MPN SELEZIONATO
MOSFET protezione | TBD |  | TBD | TBD | NON VERIFICATA | TBD | TBD | TBD | Da definire: 02_AUTOMOTIVE_POWER | TBD | TBD | VDS SOA leakage e inrush dopo O-07 | SPEC v0.2 / K0-001 | BLOCCATO / NESSUN MPN SELEZIONATO
Fusibile cablaggio | TBD |  | TBD | TBD | NON VERIFICATA | TBD | TBD | TBD | Da definire: 01_OBD_INPUT | TBD | TBD | Proteggere cavo vicino al prelievo senza secondo PCB | SPEC v0.2 / K0-001 | BLOCCATO / NESSUN MPN SELEZIONATO
Rail pannello | TBD |  | TBD | TBD | NON VERIFICATA | TBD | TBD | TBD | Da definire: 02_AUTOMOTIVE_POWER / 05_AMOLED_TOUCH | TBD | TBD | Dati pannello incoerenti; power budget e sequenza da chiudere | SPEC v0.2 / K0-001 | BLOCCATO / NESSUN MPN SELEZIONATO
TVS CAN e filtro EMI | TBD |  | TBD | TBD | NON VERIFICATA | TBD | TBD | TBD | Da definire: 04_CAN_PHY | TBD | TBD | Capacità clamp e SI da validare | SPEC v0.2 / K0-001 | BLOCCATO / NESSUN MPN SELEZIONATO
Cavo2m con coppiaCAN e conduttori potenza | TBD |  | TBD | TBD | NON VERIFICATA | TBD | TBD | TBD | Da definire: 01_OBD_INPUT | TBD | TBD | Nessun cavo completo verificato; non trasferire rating cavo dati a potenza; E44 | SPEC v0.2 / K0-001 | BLOCCATO / NESSUN MPN SELEZIONATO
Connettore FPC | TBD |  | TBD | TBD | NON VERIFICATA | TBD | TBD | TBD | Da definire: 05_AMOLED_TOUCH | TBD | TBD | Vietato scegliere da foto o devboard | SPEC v0.2 / K0-001 | BLOCCATO / NESSUN MPN SELEZIONATO
USB-C + ESD + power path | TBD |  | TBD | TBD | NON VERIFICATA | TBD | TBD | TBD | Da definire: 07_TEST_SERVICE | TBD | TBD | DEC-007:recovery alimentata; fit e backfeed da verificare | SPEC v0.2 / K0-001 | BLOCCATO / NESSUN MPN SELEZIONATO
Passivi induttori condensatori | TBD |  | TBD | TBD | NON VERIFICATA | TBD | TBD | TBD | Da definire: 02_AUTOMOTIVE_POWER | TBD | TBD | Rating derating EMC e temperature da dimensionare | SPEC v0.2 / K0-001 | BLOCCATO / NESSUN MPN SELEZIONATO
Case magnete supporto | TBD |  | TBD | TBD | NON VERIFICATA | TBD | TBD | TBD | Da definire: docs/hardware/MECHANICAL_K0.md | TBD | TBD | Fit nuovo diametro (Ø52 ipotesi) e RF; costo assieme | SPEC v0.2 / K0-001 | BLOCCATO / NESSUN MPN SELEZIONATO
