Ale1x/auto-gauge/hardware/schematic_bom_review.csv

sheet | reference | value | MPN | footprint | datasheet | status | dnp | on_board | in_bom
01_OBD_INPUT | J100 | EXTERNAL J1962 TYPE A / 12V | TBD |  |  | EXTERNAL HARNESS / TYPE A DRAWING OPEN | False | False | True
01_OBD_INPUT | J101 | GAUGE INPUT / MAP H | TBD |  |  | MAPPING H / HOUSINGS 0430200600 + 0430250600 | False | True | True
01_OBD_INPUT | F100 | TBD FUSE / AT OBD B+ | TBD |  |  | OPEN: CURRENT / I2T / DC BREAKING | False | False | True
01_OBD_INPUT | R101 | DNP / GROUND LINK TBD | TBD |  |  | OPEN GROUND / EMC REVIEW | True | True | True
01_OBD_INPUT | #FLG01 | PWR_FLAG | TBD |  |  | EXTERNAL SOURCE DECLARATION | False | False | False
01_OBD_INPUT | #FLG02 | PWR_FLAG | TBD |  |  | EXTERNAL RETURN DECLARATION | False | False | False
02_AUTOMOTIVE_POWER | U201 | LM74900QRGERQ1 | LM74900QRGERQ1 |  | https://www.ti.com/lit/ds/symlink/lm74900-q1.pdf | CANDIDATE / LIMITS OPEN | False | True | True
02_AUTOMOTIVE_POWER | Q201 | TBD 80V+ / SOA | TBD |  |  | OPEN MOSFET SELECTION | False | True | True
02_AUTOMOTIVE_POWER | Q202 | TBD 80V+ / SOA | TBD |  |  | OPEN MOSFET SELECTION | False | True | True
02_AUTOMOTIVE_POWER | R201 | TBD SHUNT | TBD |  |  | OPEN OCP / I2T | False | True | True
02_AUTOMOTIVE_POWER | R202 | 0.1 ohm H / CS FILTER | TBD |  |  | CANDIDATE | False | True | True
02_AUTOMOTIVE_POWER | D201 | TBD AUTOMOTIVE TVS | TBD |  |  | OPEN CLAMP / ENERGY / POLARITY | False | True | True
02_AUTOMOTIVE_POWER | C201 | 100n / 100V H | TBD |  |  | CANDIDATE | False | True | True
02_AUTOMOTIVE_POWER | C202 | 100n / 16V H | TBD |  |  | CANDIDATE | False | True | True
02_AUTOMOTIVE_POWER | R203 | TBD UV TOP | TBD |  |  | OPEN UV/OV LIMITS | False | True | True
02_AUTOMOTIVE_POWER | R204 | TBD UV/OV MID | TBD |  |  | OPEN UV/OV LIMITS | False | True | True
02_AUTOMOTIVE_POWER | R205 | TBD OV BOTTOM | TBD |  |  | OPEN UV/OV LIMITS | False | True | True
02_AUTOMOTIVE_POWER | R206 | TBD ILIM | TBD |  |  | OPEN OCP | False | True | True
02_AUTOMOTIVE_POWER | C203 | TBD TIMER | TBD |  |  | OPEN FAULT TIME | False | True | True
02_AUTOMOTIVE_POWER | C204 | TBD BULK / RATING | TBD |  |  | OPEN INRUSH / SOA | False | True | True
02_AUTOMOTIVE_POWER | R215 | 10k H / HV INPUT | TBD |  |  | CANDIDATE | False | True | True
02_AUTOMOTIVE_POWER | R216 | 100k H | TBD |  |  | CANDIDATE | False | True | True
02_AUTOMOTIVE_POWER | R217 | TBD WAKE DELAY | TBD |  |  | OPEN WAKE SEQUENCE | False | True | True
02_AUTOMOTIVE_POWER | C217 | TBD / 50V | TBD |  |  | OPEN WAKE SEQUENCE | False | True | True
02_AUTOMOTIVE_POWER | U202 | LM5164QDDARQ1 / 5V H | LM5164QDDARQ1 | Package_SO:HSOP-8-1EP_3.9x4.9mm_P1.27mm_EP2.41x3.1mm_ThermalVias | https://www.ti.com/lit/ds/symlink/lm5164-q1.pdf | CANDIDATE / 5V LOOP H | False | True | True
02_AUTOMOTIVE_POWER | L202 | 47uH H / Isat TBD | TBD |  |  | H / CURRENT AND LOSS OPEN | False | True | True
02_AUTOMOTIVE_POWER | C205 | 2.2u / 100V H | TBD |  |  | CANDIDATE | False | True | True
02_AUTOMOTIVE_POWER | C206 | 2.2n / 50V X7R | TBD |  |  | CANDIDATE | False | True | True
02_AUTOMOTIVE_POWER | C207 | 47u / 10V H | TBD |  |  | CANDIDATE | False | True | True
02_AUTOMOTIVE_POWER | R207 | 41.2k H | TBD |  |  | CANDIDATE | False | True | True
02_AUTOMOTIVE_POWER | R208 | 316k H | TBD |  |  | CANDIDATE | False | True | True
02_AUTOMOTIVE_POWER | R209 | 100k H | TBD |  |  | CANDIDATE | False | True | True
02_AUTOMOTIVE_POWER | R210 | TBD RIPPLE RA | TBD |  |  | OPEN TYPE3 LOOP | False | True | True
02_AUTOMOTIVE_POWER | C208 | TBD RIPPLE CA | TBD |  |  | OPEN TYPE3 LOOP | False | True | True
02_AUTOMOTIVE_POWER | C209 | TBD RIPPLE CB | TBD |  |  | OPEN TYPE3 LOOP | False | True | True
02_AUTOMOTIVE_POWER | R211 | 100k H | TBD |  |  | CANDIDATE | False | True | True
02_AUTOMOTIVE_POWER | U203 | TPS62811QWRWYRQ1 / 3V3 H | TPS62811QWRWYRQ1 |  | https://www.ti.com/lit/ds/symlink/tps62813-q1.pdf | CANDIDATE / E46 INITIAL VALUES | False | True | True
02_AUTOMOTIVE_POWER | L203 | 0.47uH H / Isat TBD | TBD |  |  | CANDIDATE | False | True | True
02_AUTOMOTIVE_POWER | C210 | 22u / 10V H | TBD |  |  | CANDIDATE | False | True | True
02_AUTOMOTIVE_POWER | C211 | 22u / 10V H | TBD |  |  | CANDIDATE | False | True | True
02_AUTOMOTIVE_POWER | C212 | 22u / 10V H | TBD |  |  | CANDIDATE | False | True | True
02_AUTOMOTIVE_POWER | C213 | 4.7n H | TBD |  |  | CANDIDATE | False | True | True
02_AUTOMOTIVE_POWER | R212 | 88.7k H | TBD |  |  | CANDIDATE | False | True | True
02_AUTOMOTIVE_POWER | R213 | 19.6k H | TBD |  |  | CANDIDATE | False | True | True
02_AUTOMOTIVE_POWER | C214 | 10p H | TBD |  |  | CANDIDATE | False | True | True
02_AUTOMOTIVE_POWER | R214 | 100k H | TBD |  |  | CANDIDATE | False | True | True
03_MCU_MEMORY_BLE | U301 | ESP32-S3-WROOM-1-N16R8 | ESP32-S3-WROOM-1-N16R8 | RF_Module:ESP32-S3-WROOM-1 | https://www.espressif.com/sites/default/files/documentation/esp32-s3-wroom-1_wroom-1u_datasheet_en.pdf | CANDIDATE / PIN MAP H | False | True | True
03_MCU_MEMORY_BLE | C301 | 10u / 6.3V H | TBD |  |  | CANDIDATE | False | True | True
03_MCU_MEMORY_BLE | C302 | 100n / 10V H | TBD |  |  | CANDIDATE | False | True | True
03_MCU_MEMORY_BLE | R301 | 10k | TBD |  |  | CANDIDATE | False | True | True
03_MCU_MEMORY_BLE | C303 | 1u / 10V H | TBD |  |  | CANDIDATE | False | True | True
03_MCU_MEMORY_BLE | R302 | 10k H | TBD |  |  | CANDIDATE | False | True | True
03_MCU_MEMORY_BLE | TP301 | MCU_EN | TBD |  |  | TEST PAD / FOOTPRINT OPEN | False | True | False
03_MCU_MEMORY_BLE | TP302 | BOOT_N | TBD |  |  | TEST PAD / FOOTPRINT OPEN | False | True | False
03_MCU_MEMORY_BLE | TP303 | UART0_TX_TEST | TBD |  |  | TEST PAD / FOOTPRINT OPEN | False | True | False
03_MCU_MEMORY_BLE | TP304 | UART0_RX_TEST | TBD |  |  | TEST PAD / FOOTPRINT OPEN | False | True | False
03_MCU_MEMORY_BLE | TP305 | GND | TBD |  |  | TEST PAD / FOOTPRINT OPEN | False | True | False
04_CAN_PHY | U401 | TCAN1043ADRQ1 | TCAN1043ADRQ1 | Package_SO:SOIC-14_3.9x8.7mm_P1.27mm | https://www.ti.com/lit/ds/symlink/tcan1043a-q1.pdf | PIN TABLE CHECKED / DFM OPEN | False | True | True
04_CAN_PHY | C401 | 100n / 10V H | TBD |  |  | CANDIDATE | False | True | True
04_CAN_PHY | C402 | 100n / 10V H | TBD |  |  | CANDIDATE | False | True | True
04_CAN_PHY | C403 | 100n / 50V H | TBD |  |  | CANDIDATE | False | True | True
04_CAN_PHY | R401 | 10k H | TBD |  |  | CANDIDATE | False | True | True
04_CAN_PHY | R402 | 100k H | TBD |  |  | CANDIDATE | False | True | True
04_CAN_PHY | R403 | 100k H | TBD |  |  | CANDIDATE | False | True | True
04_CAN_PHY | D401 | TBD CAN TVS | TBD |  |  | OPEN CAN CLAMP / CAPACITANCE | False | True | True
04_CAN_PHY | D402 | TBD CAN TVS | TBD |  |  | OPEN CAN CLAMP / CAPACITANCE | False | True | True
05_AMOLED_TOUCH | J501 | FPC31 / ALL PINS OPEN | TBD |  |  | BLOCKED / EXACT PANEL REVISION AND MATE OPEN | False | False | False
05_AMOLED_TOUCH | TP501 | DISP_CLK | TBD |  |  | LOGICAL INTERFACE ONLY | False | False | False
05_AMOLED_TOUCH | TP502 | DISP_CS | TBD |  |  | LOGICAL INTERFACE ONLY | False | False | False
05_AMOLED_TOUCH | TP503 | DISP_D0 | TBD |  |  | LOGICAL INTERFACE ONLY | False | False | False
05_AMOLED_TOUCH | TP504 | DISP_D1 | TBD |  |  | LOGICAL INTERFACE ONLY | False | False | False
05_AMOLED_TOUCH | TP505 | DISP_D2 | TBD |  |  | LOGICAL INTERFACE ONLY | False | False | False
05_AMOLED_TOUCH | TP506 | DISP_D3 | TBD |  |  | LOGICAL INTERFACE ONLY | False | False | False
05_AMOLED_TOUCH | TP507 | DISP_RESET | TBD |  |  | LOGICAL INTERFACE ONLY | False | False | False
05_AMOLED_TOUCH | TP508 | DISP_ENABLE | TBD |  |  | LOGICAL INTERFACE ONLY | False | False | False
05_AMOLED_TOUCH | TP509 | TOUCH_SCL_TBD_LEVEL | TBD |  |  | LOGICAL INTERFACE ONLY | False | False | False
05_AMOLED_TOUCH | TP510 | TOUCH_SDA_TBD_LEVEL | TBD |  |  | LOGICAL INTERFACE ONLY | False | False | False
05_AMOLED_TOUCH | TP511 | TOUCH_INT | TBD |  |  | LOGICAL INTERFACE ONLY | False | False | False
05_AMOLED_TOUCH | TP512 | TOUCH_RESET | TBD |  |  | LOGICAL INTERFACE ONLY | False | False | False
06_LIGHT_SENSOR | U601 | OPT3001DNPRQ1 | OPT3001DNPRQ1 |  | https://www.ti.com/lit/ds/symlink/opt3001-q1.pdf | PIN TABLE E06 / LAND PATTERN OPEN | False | True | True
06_LIGHT_SENSOR | C601 | 100n / 10V H | TBD |  |  | CANDIDATE | False | True | True
06_LIGHT_SENSOR | R601 | 10k H | TBD |  |  | CANDIDATE | False | True | True
06_LIGHT_SENSOR | R602 | 10k H | TBD |  |  | CANDIDATE | False | True | True
06_LIGHT_SENSOR | R603 | 10k H | TBD |  |  | CANDIDATE | False | True | True
07_TEST_SERVICE | J701 | USB-C / EXACT MPN OPEN | TBD |  | https://www.usb.org/sites/default/files/documents/usb_type-c.zip | CONNECTOR MPN / VBUS PROTECTION OPEN | False | True | True
07_TEST_SERVICE | R701 | 5.1k 1% H / Rd | TBD |  |  | CANDIDATE | False | True | True
07_TEST_SERVICE | R702 | 5.1k 1% H / Rd | TBD |  |  | CANDIDATE | False | True | True
07_TEST_SERVICE | R703 | 0R H | TBD |  |  | CANDIDATE | False | True | True
07_TEST_SERVICE | R704 | 0R H | TBD |  |  | CANDIDATE | False | True | True
07_TEST_SERVICE | R705 | DNP / SHIELD LINK | TBD |  |  | OPEN EMC / CHASSIS STRATEGY | True | True | True
07_TEST_SERVICE | U701 | TPS2116DRLR | TPS2116DRLR | Package_TO_SOT_SMD:SOT-583-8 | https://www.ti.com/lit/ds/symlink/tps2116.pdf | CANDIDATE / USB INPUT PROTECTION OPEN | False | True | True
07_TEST_SERVICE | R706 | 340k H | TBD |  |  | CANDIDATE | False | True | True
07_TEST_SERVICE | R707 | 100k H | TBD |  |  | CANDIDATE | False | True | True
07_TEST_SERVICE | C701 | 1u / 10V H | TBD |  |  | CANDIDATE | False | True | True
07_TEST_SERVICE | C702 | 1u / 10V H | TBD |  |  | CANDIDATE | False | True | True
07_TEST_SERVICE | SW701 | RESET / HIDDEN SERVICE | TBD |  |  | CANDIDATE | False | True | True
07_TEST_SERVICE | SW702 | BOOT / HIDDEN SERVICE | TBD |  |  | CANDIDATE | False | True | True
