Ale1x/auto-gauge/docs/suppliers/README.md

# Fornitori

Documenti di sourcing e comunicazioni predisposte. I messaggi pronti sono documenti storici, non istruzioni a inviare nuove email.

- [PANEL_SOURCING_K0.md](PANEL_SOURCING_K0.md) — Pannelli K0 — ricerca di secondo livello, 2026-10-24
- [SUPPLIER_CONTACT_LOG.md](SUPPLIER_CONTACT_LOG.md) — Registro contatti fornitori — 2026-10-24
- [SUPPLIER_MESSAGES_READY.md](SUPPLIER_MESSAGES_READY.md) — Richieste esterne pronte per revisione — 2026-10-24
- [SUPPLIER_RFQ_DRAFT.md](SUPPLIER_RFQ_DRAFT.md) — Bozza richiesta fattibilità e preventivo — NON INVIATA
