Ale1x/auto-gauge/hardware/usb_power/design_v01/rail_tradeoff.csv

target_H_V | rtop_candidate_ohm | actual_nominal_V | vpre_min_screen_V | vpre_max_screen_V | i3p3_H_A | v3p3_upper_H_V | eta1_H | eta2_H | intermediate_current_screen_A | usb_load_only_screen_A | postmux_min_screen_V | tps62811_required_input_H_V | second_stage_margin_H_V | preregulator_rhs_allowed_at_usb4p5_H_ohm | low_vin_rhs_max_is_missing | status
3.8 | 37400.0 | 3.7920000000000003 | 3.6430875368809166 | 3.9805506239237336 | 0.5 | 3.42 | 0.8 | 0.8 | 0.5867275980499914 | 0.5937499999999998 | 3.607883880997917 | 3.53 | 0.07788388099791721 | 0.7129254142905241 | True | CONDITIONAL_SCREEN_NOT_GUARANTEED
4.0 | 40200.0 | 4.016 | 3.8577358016741408 | 4.216270991490216 | 0.5 | 3.42 | 0.8 | 0.8 | 0.5540814897361269 | 0.5937499999999998 | 3.8244909122899733 | 3.53 | 0.2944909122899735 | 0.3318523830539106 | True | CONDITIONAL_SCREEN_NOT_GUARANTEED
4.2 | 42200.0 | 4.176 | 4.011055990812158 | 4.384642682609133 | 0.5 | 3.42 | 0.8 | 0.8 | 0.5329020599304073 | 0.5937499999999998 | 3.9790818672163337 | 3.53 | 0.4490818672163339 | 0.030672345131835012 | True | CONDITIONAL_SCREEN_NOT_GUARANTEED
4.5 | 46400.0 | 4.512 | 4.333028388001994 | 4.738223233958856 | 0.5 | 3.42 | 0.8 | 0.8 | 0.4933039455542603 | 0.5937499999999998 | 4.3034301512687385 | 3.53 | 0.7734301512687387 | -0.6804275893472027 | True | CONDITIONAL_SCREEN_NOT_GUARANTEED
