Ale1x/auto-gauge/docs/validation/ios/THEMES27/after/33-purchase-dark.png

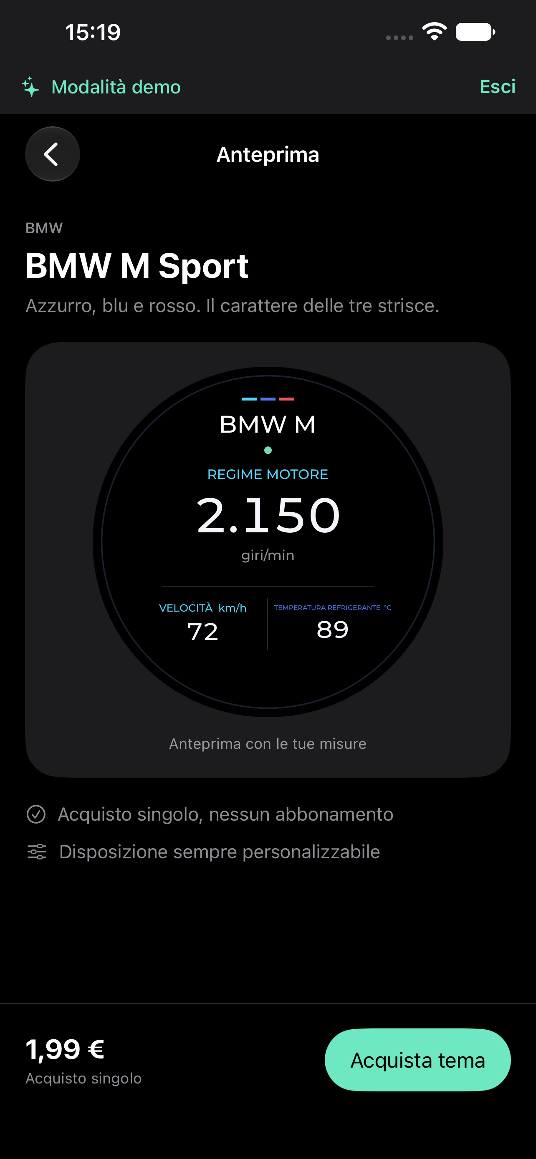
docs/validation/ios/THEMES27/after/33-purchase-dark.png
