Ale1x/auto-gauge/docs/validation/ios/THEMES27/before/31-purchase-before.png

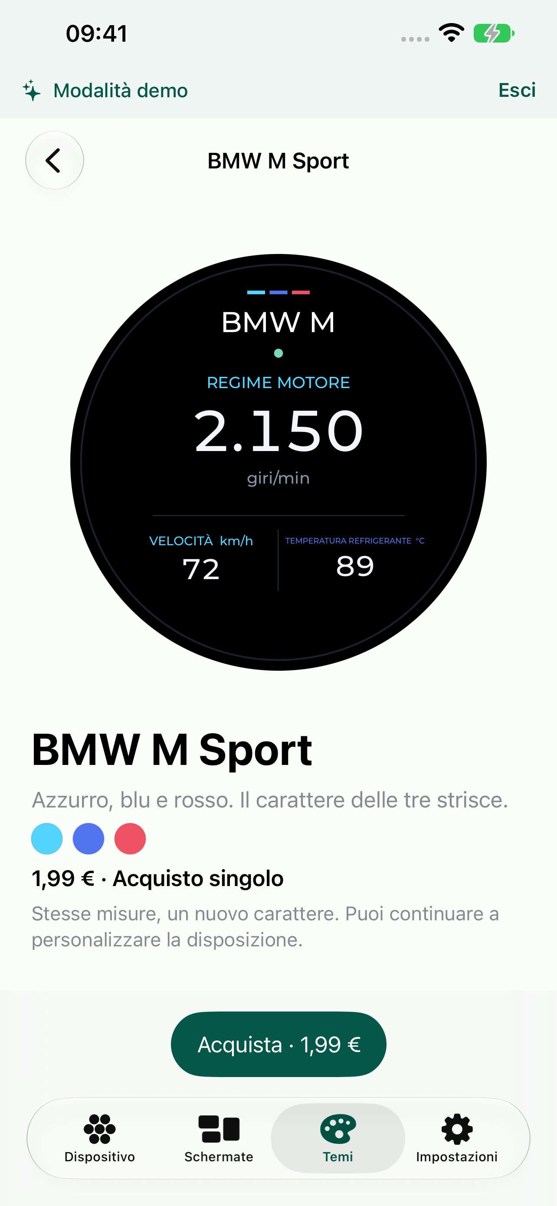
docs/validation/ios/THEMES27/before/31-purchase-before.png
