Ale1x/auto-gauge/docs/validation/ios/EXPERIENCE27/before/55-theme-maker.png

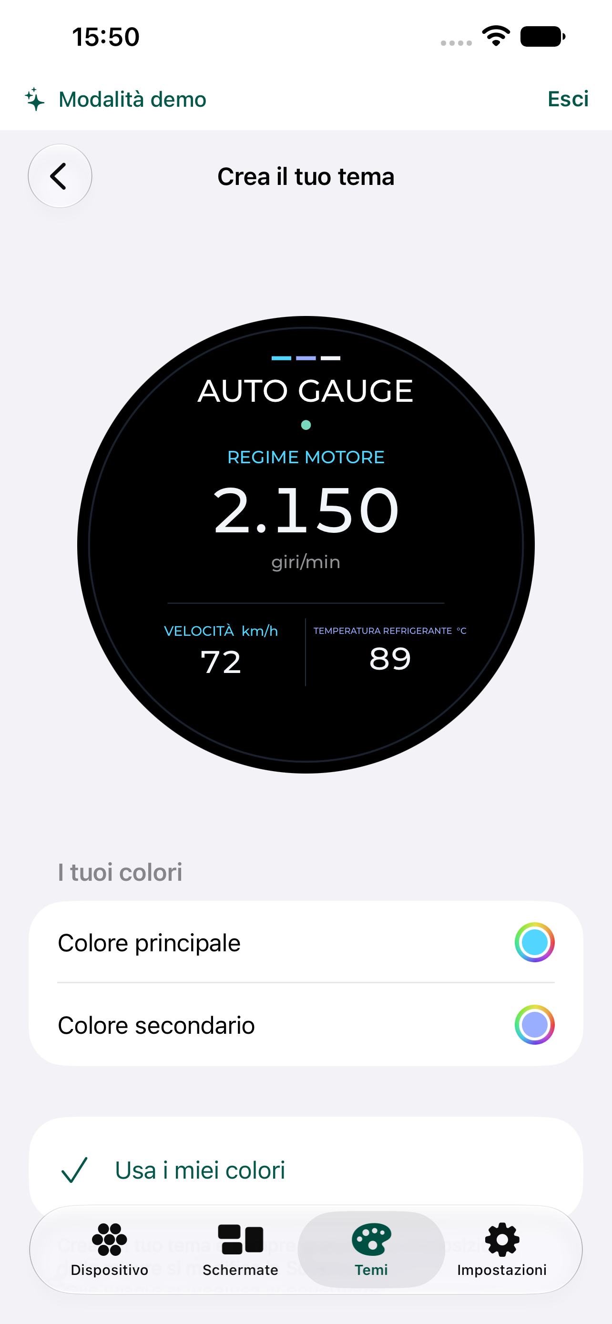
docs/validation/ios/EXPERIENCE27/before/55-theme-maker.png
