Ale1x/auto-gauge/docs/validation/ios/ONBOARDING27/ASSETS.md

# Onboarding illustration assets

Generated on 25 October 2026 using the built-in Image Gen tool. Each PNG has an alpha channel, is bundled in Assets.xcassets and loads offline. No external image service is called by the app. These are conceptual onboarding illustrations; real theme previews use the app renderer.

## Final assets

- `App/Assets.xcassets/OnboardingWelcome.imageset/illustration.png`
- `App/Assets.xcassets/OnboardingThemes.imageset/illustration.png`
- `App/Assets.xcassets/OnboardingConnect.imageset/illustration.png`

## Generation prompts

### Welcome

Use case: stylized-concept. Asset type: polished transparent hero illustration for the first onboarding screen of the Italian Auto Gauge iPhone app. Existing design language: light cool gray or true black native canvas, teal accent #05574A in light mode and mint #6EE8C2 in dark. Subject: a beautiful round automotive digital gauge, black satin slim circular housing, floating at a subtle three-quarter angle. Face has precise mint green and white tick marks, a central large simple speed number 86 with tiny km/h, restrained redline arc, two small lower readouts. Editorial premium 3D product illustration, soft tactile materials, crisp purposeful geometry, subtle mint reflected light, no excessive sci-fi neon. Centered composition, entire device fully visible, generous transparent margin, roughly square, object occupies 76 percent of frame. A few subtle floating mint motion arcs convey driving without a car or a scene. Actual alpha transparent background, no white box or cast floor. No logos, no branding, no slogans, no explanatory text, no watermark. Intended to be displayed about 340x340 points on a mobile onboarding, strong silhouette works on both dark and light backgrounds.

### Themes

Use case: stylized-concept. Asset type: transparent illustration for step two of Auto Gauge iPhone onboarding. Premium editorial 3D product art with black satin automotive digital gauge housings, soft tactile materials, precise geometry and restrained mint #6EE8C2 edge highlights. Three distinctly styled circular gauge faces arranged in a tasteful fan floating in depth: largest foreground round gauge has a retro 16-bit pixel speed readout in mint with squared bitmap tick marks; a partially overlapping rear left round gauge shows a minimal ivory analog face with orange needle; rear right round gauge shows a dark purple and coral synthwave digital face. Completely round faces, no square phone or cards. Entire three objects visible without cropping, square centered composition, balanced transparent margins, occupies 82 percent of canvas. Beautiful controlled studio lighting, realistic premium materials but playful clean app illustration. Palette mint, black, ivory with coral/purple confined to alternate gauge faces. Works on cool light gray or true black UI backgrounds. True transparent alpha background, no floor, no opaque rectangle, no text except restrained small numeric gauge readouts, no brand logos, no slogans, no watermark. Intended to visually communicate many different display themes, at 340x340 points.

### Connection

Use case: stylized-concept. Asset type: transparent hero illustration for final connection step of Auto Gauge iPhone onboarding. Polished editorial 3D product illustration. A slim black modern smartphone tilted slightly backward on the left and a black satin round automotive digital gauge floating slightly forward on the right. The phone screen shows a beautifully simple mint green circular confirmation checkmark on dark glass and a miniature circular gauge near bottom; no app text. The round gauge has precise mint green and white speed ticks, central numeric 86, restrained redline arc, tiny lower numeric readouts. Two subtle mint wireless curved waves between phone and gauge communicate easy pairing. Consistent premium tactile materials, crisp geometry, soft mint reflected light #6EE8C2, controlled studio lighting. Square centered composition with entire objects fully visible, 78 percent frame occupancy, generous transparent margin, no environment or cast floor. True alpha transparent background. Strong silhouette works on both cool light gray and pure black native UI. No logos, no branding, no captions or slogans, no watermark. Designed to display at about 340x340 points in an approachable consumer app.
