Ale1x/auto-gauge/docs/validation/README.md

# Verifiche UI iOS

Le cartelle conservano screenshot, metadati e report del singolo intervento. Le immagini sono evidenze alla data di acquisizione; non tutte rappresentano la UI corrente. I test eseguibili restano in `mobile/UITests/`.

| Revisione | Contenuto |
|---|---|
| [ONBOARDING27](ios/ONBOARDING27/README.md) | Ultima introduzione con tre illustrazioni; chiaro/scuro e testo grande |
| [EXPERIENCE27](ios/EXPERIENCE27/README.md) | Home, impostazioni, luminosità, misure, aggiornamenti e primo onboarding |
| [SCREENS27](ios/SCREENS27/README.md) | Panoramica Schermate e azioni contestuali |
| [THEMES27](ios/THEMES27/README.md) | Marketplace, raccolta e 60 temi |
| [CLUSTER27](ios/CLUSTER27/README.md) | Quadrante circolare nella direzione Waveshare |
| [UX27](ios/UX27/README.md) | Prima revisione UX sul runtime iOS 27 |
| [APP14](ios/APP14/README.md) | Preparazione aggiornamento e relativi stati |
| [APP09](ios/APP09/README.md) | Storici, filtri e grafici della baseline precedente |
| [Rendering iniziali](ios/README.md) | Verifiche statiche iniziali e relativi limiti |

I prompt e i percorsi delle illustrazioni correnti sono in [ONBOARDING27/ASSETS.md](ios/ONBOARDING27/ASSETS.md). Le immagini usate dall’app rimangono in `mobile/App/Assets.xcassets/`; questa sezione contiene le evidenze di verifica.
