Ale1x/auto-gauge/docs/verification/README.md

# Verifiche versionate

Risultati storici degli incrementi software. Conservare la distinzione fra test host, build SDK e qualifica fisica.

- [VERIFICATION_V0.1.md](VERIFICATION_V0.1.md) — Verifica del primo incremento software
- [VERIFICATION_V0.10.md](VERIFICATION_V0.10.md) — Decimo incremento: controller e sender OTA bounded
- [VERIFICATION_V0.11.md](VERIFICATION_V0.11.md) — Undicesimo incremento: sessione OTA nei frame AG
- [VERIFICATION_V0.12.md](VERIFICATION_V0.12.md) — Dodicesimo incremento: chiusura dei filoni avviati
- [VERIFICATION_V0.13.md](VERIFICATION_V0.13.md) — V0.13 — integrazione applicativa e consegna software
- [VERIFICATION_V0.2.md](VERIFICATION_V0.2.md) — Verifica del secondo incremento parallelo
- [VERIFICATION_V0.3.md](VERIFICATION_V0.3.md) — Verifica del terzo incremento — più client BLE
- [VERIFICATION_V0.4.md](VERIFICATION_V0.4.md) — Verifica del quarto incremento
- [VERIFICATION_V0.5.md](VERIFICATION_V0.5.md) — Verifica del quinto incremento
- [VERIFICATION_V0.6.md](VERIFICATION_V0.6.md) — Sesto incremento: integrazione software
- [VERIFICATION_V0.7.md](VERIFICATION_V0.7.md) — Settimo incremento: storici, grafici e preflight OTA
- [VERIFICATION_V0.8.md](VERIFICATION_V0.8.md) — Ottavo incremento: runtime autonomo e percorso OTA
- [VERIFICATION_V0.9.md](VERIFICATION_V0.9.md) — Nono incremento: verifica OTA offline e manifesto target
