Ale1x/auto-gauge/docs/validation/ios/APP09/simulator-chart-dark.png

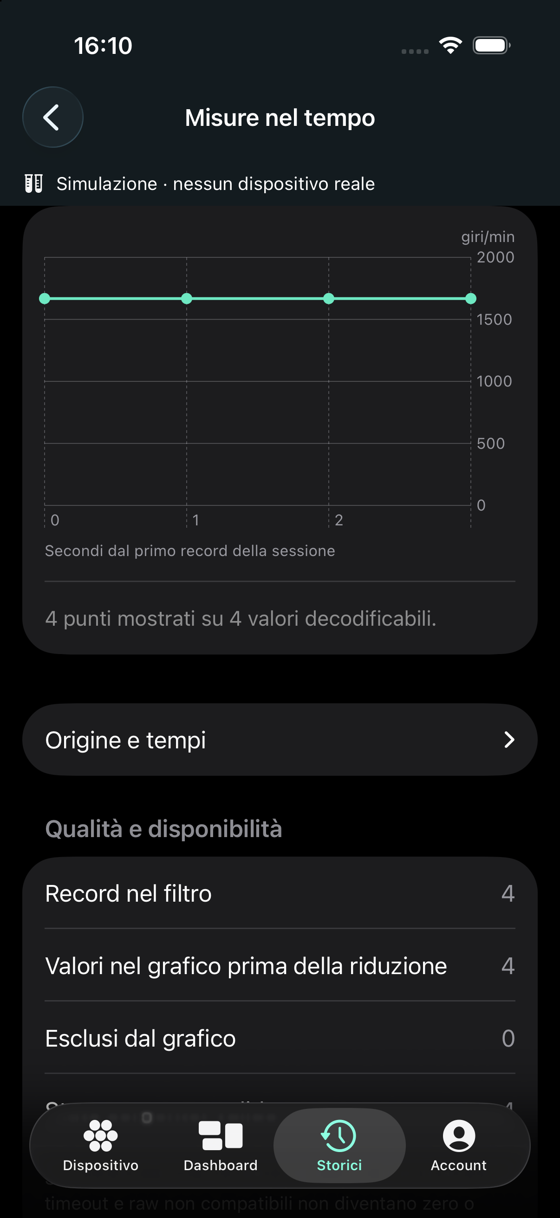
docs/validation/ios/APP09/simulator-chart-dark.png
