Ale1x/auto-gauge/docs/validation/ios/APP09/simulator-chart.png

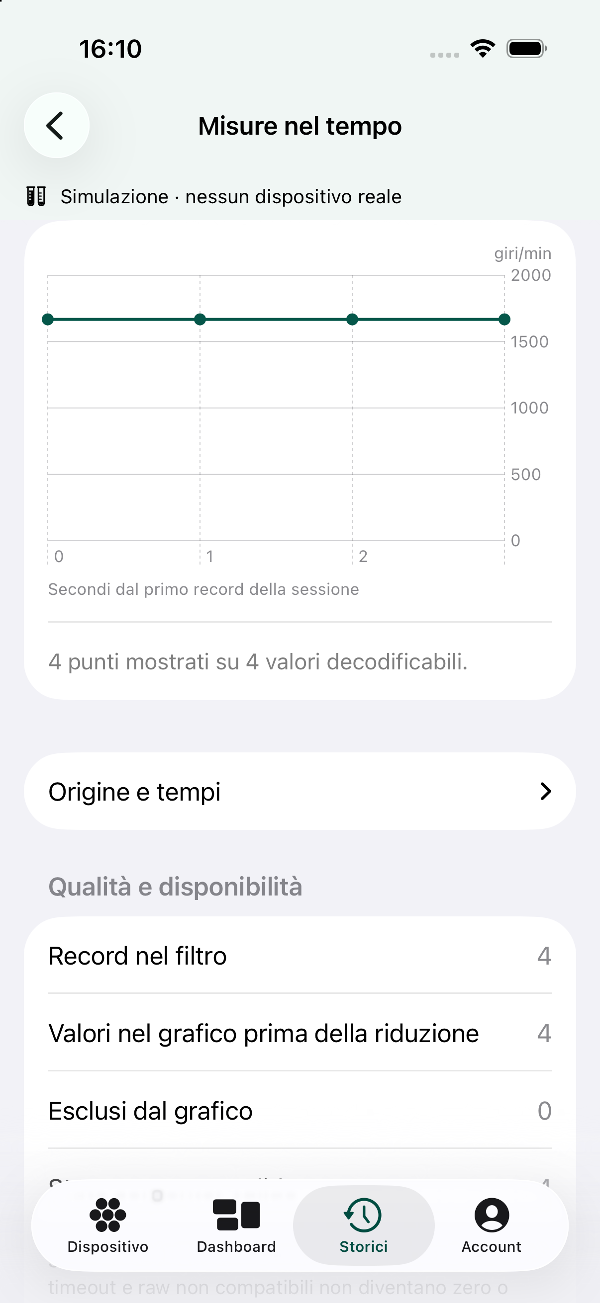
docs/validation/ios/APP09/simulator-chart.png
