Ale1x/auto-gauge/docs/validation/ios/APP09/simulator-table-accessibility.png

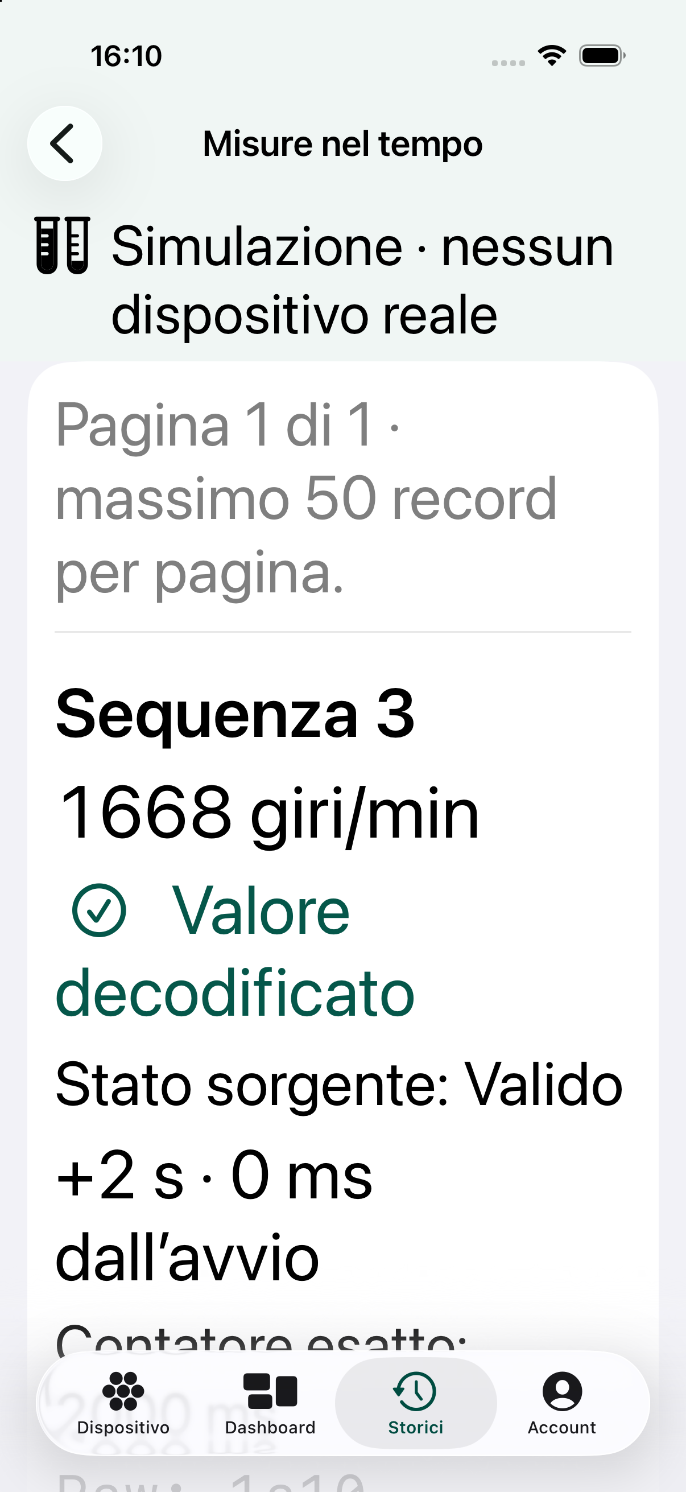
docs/validation/ios/APP09/simulator-table-accessibility.png
