Ale1x/auto-gauge/docs/validation/ios/APP14/firmware-dark.png

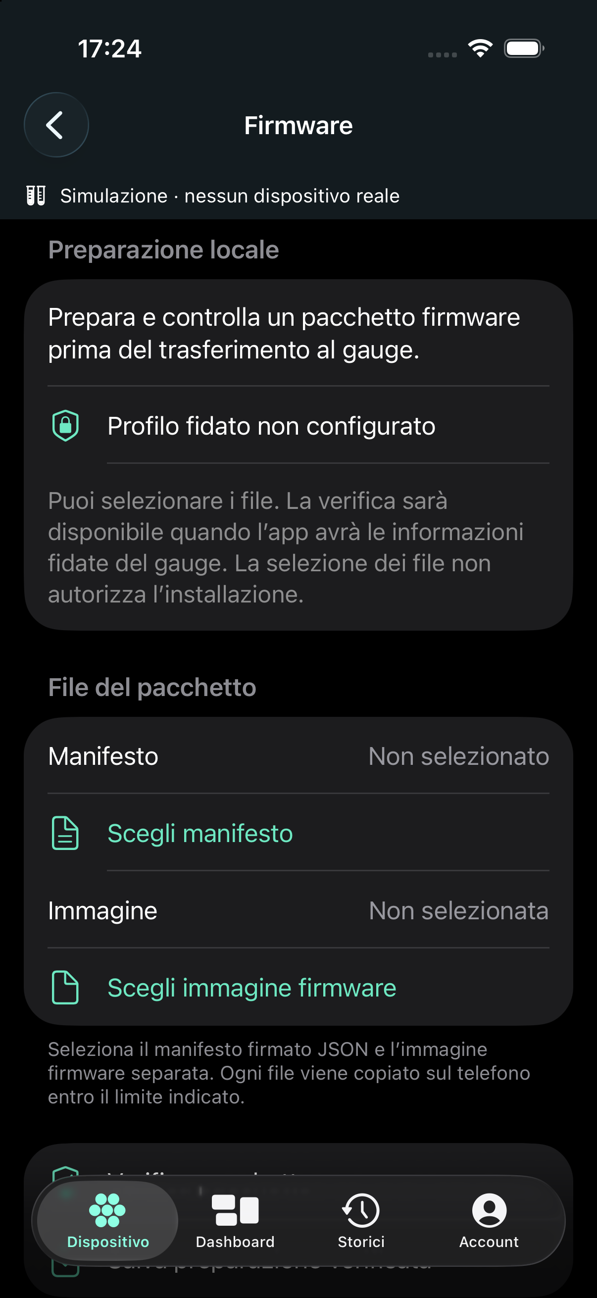
docs/validation/ios/APP14/firmware-dark.png
