Ale1x/auto-gauge/docs/validation/ios/APP14/firmware-light.png

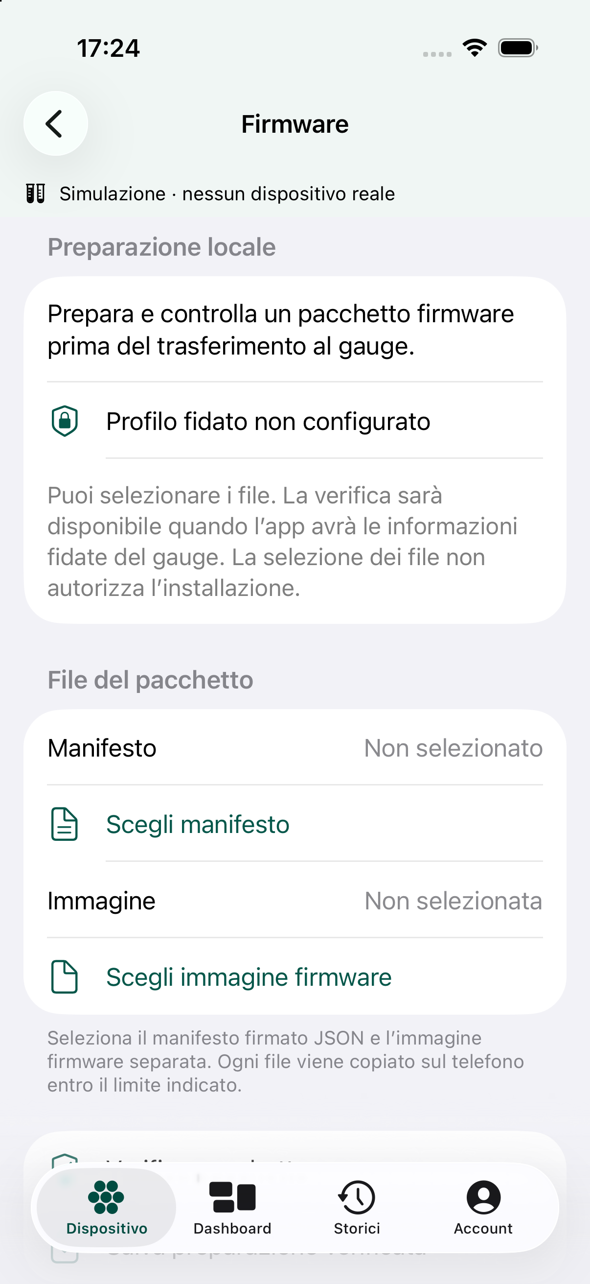
docs/validation/ios/APP14/firmware-light.png
