Ale1x/auto-gauge/docs/validation/ios/CLUSTER27/01-device-light.png

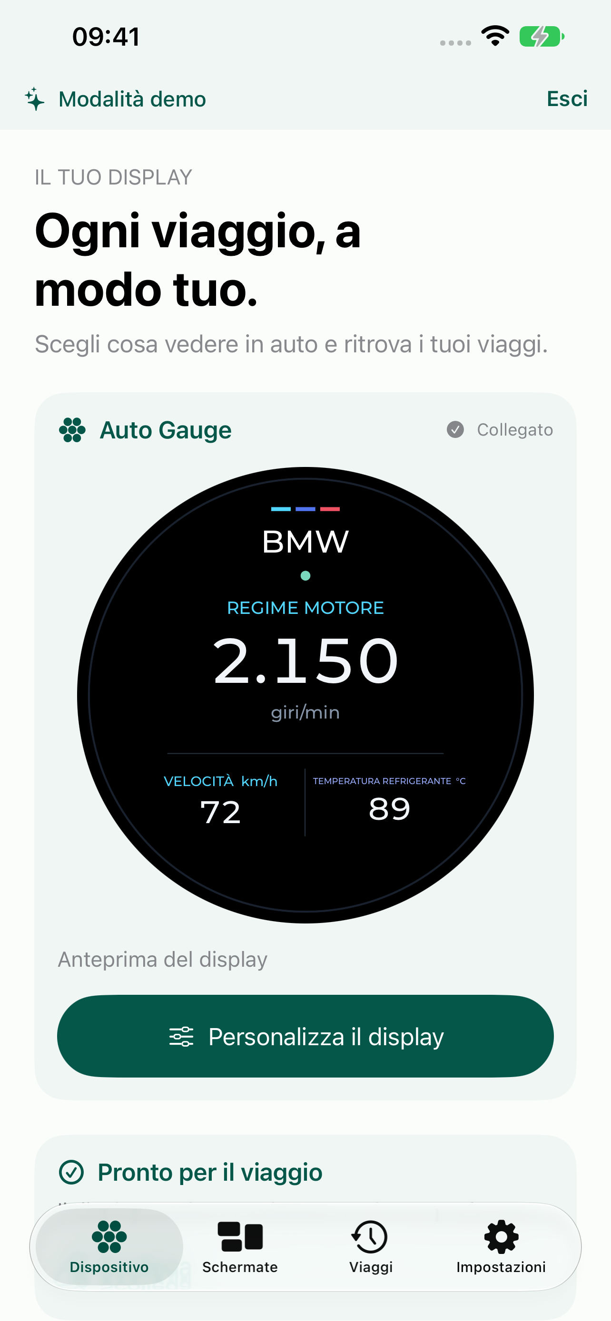
docs/validation/ios/CLUSTER27/01-device-light.png
