Ale1x/auto-gauge/docs/validation/ios/CLUSTER27/05-settings-dark.png

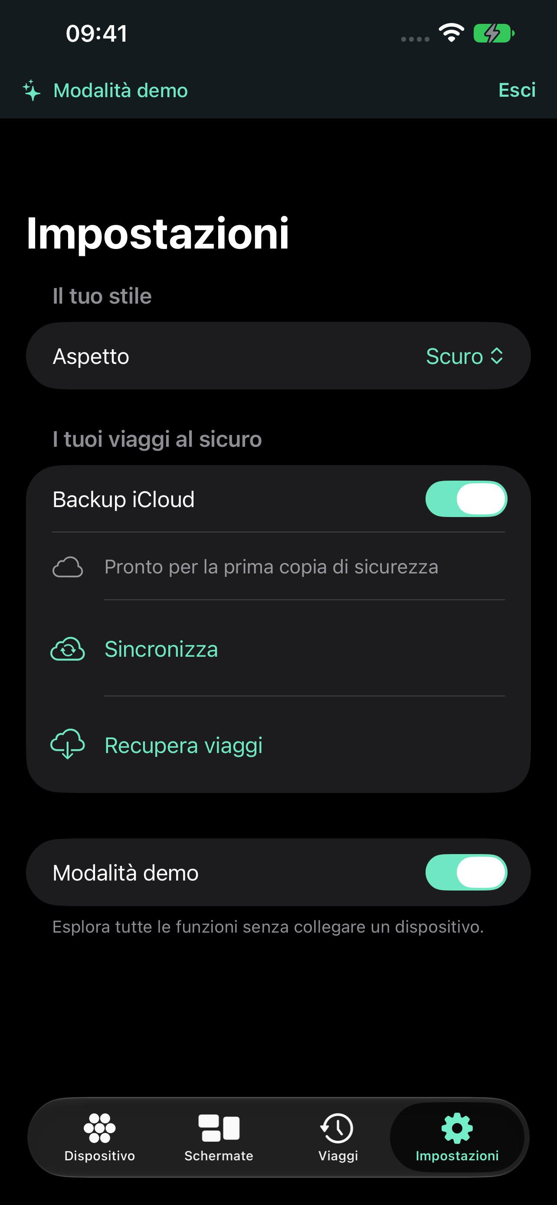
docs/validation/ios/CLUSTER27/05-settings-dark.png
