Ale1x/auto-gauge/docs/validation/ios/CLUSTER27/07-device-mode.png

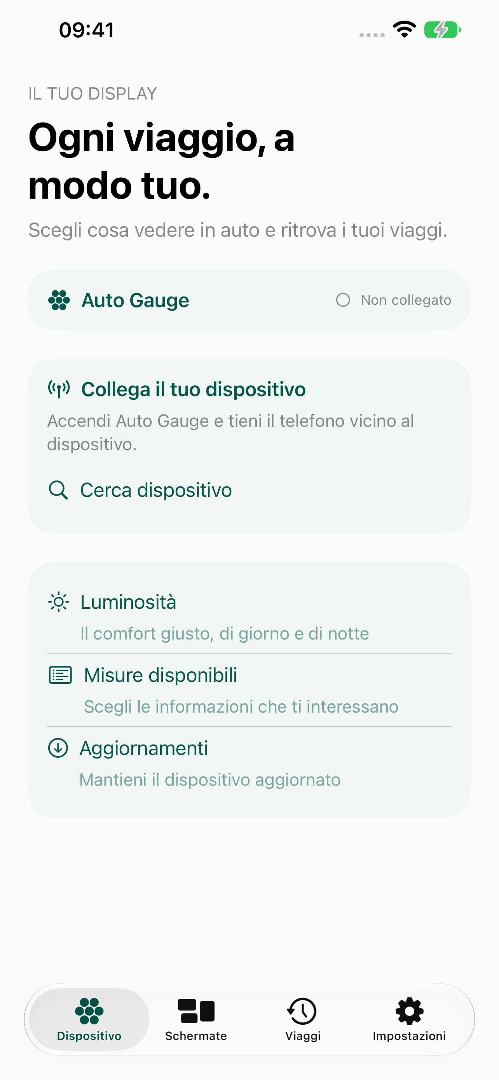
docs/validation/ios/CLUSTER27/07-device-mode.png
