Ale1x/auto-gauge/docs/validation/ios/CLUSTER27/13-device-large-text.png

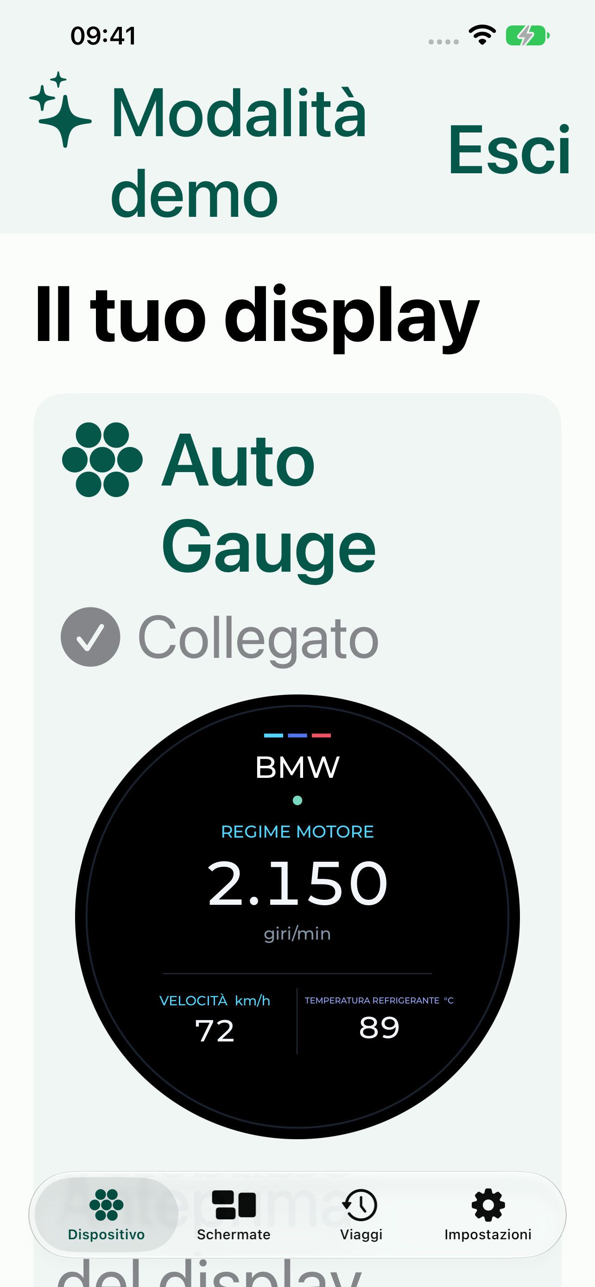
docs/validation/ios/CLUSTER27/13-device-large-text.png
