Ale1x/auto-gauge/docs/validation/ios/CLUSTER27/14-settings-large-text.png

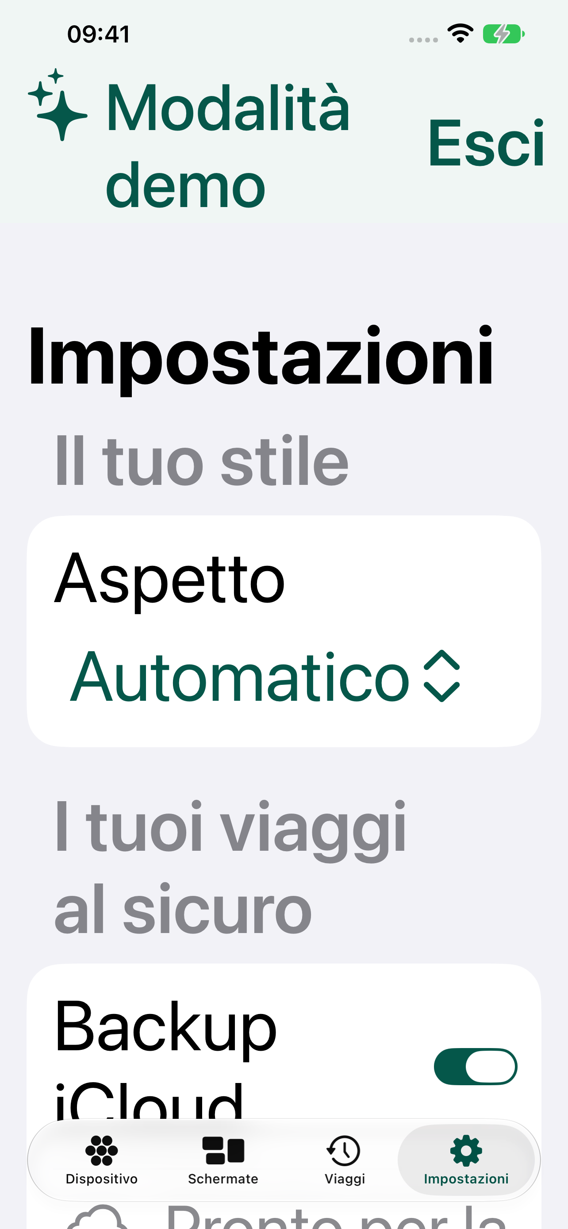
docs/validation/ios/CLUSTER27/14-settings-large-text.png
