Ale1x/auto-gauge/docs/validation/ios/CLUSTER27/15-device-large-text-scrolled.png

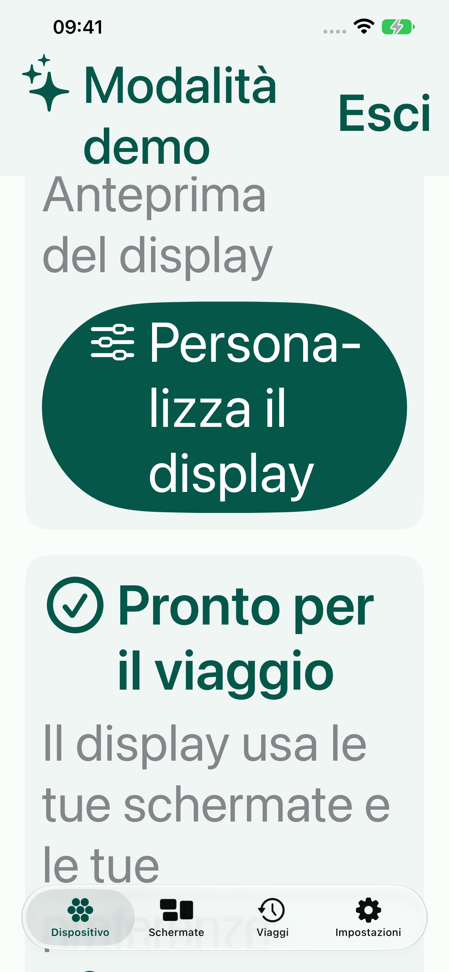
docs/validation/ios/CLUSTER27/15-device-large-text-scrolled.png
