Ale1x/auto-gauge/docs/validation/ios/CLUSTER27/16-cluster-gallery.png

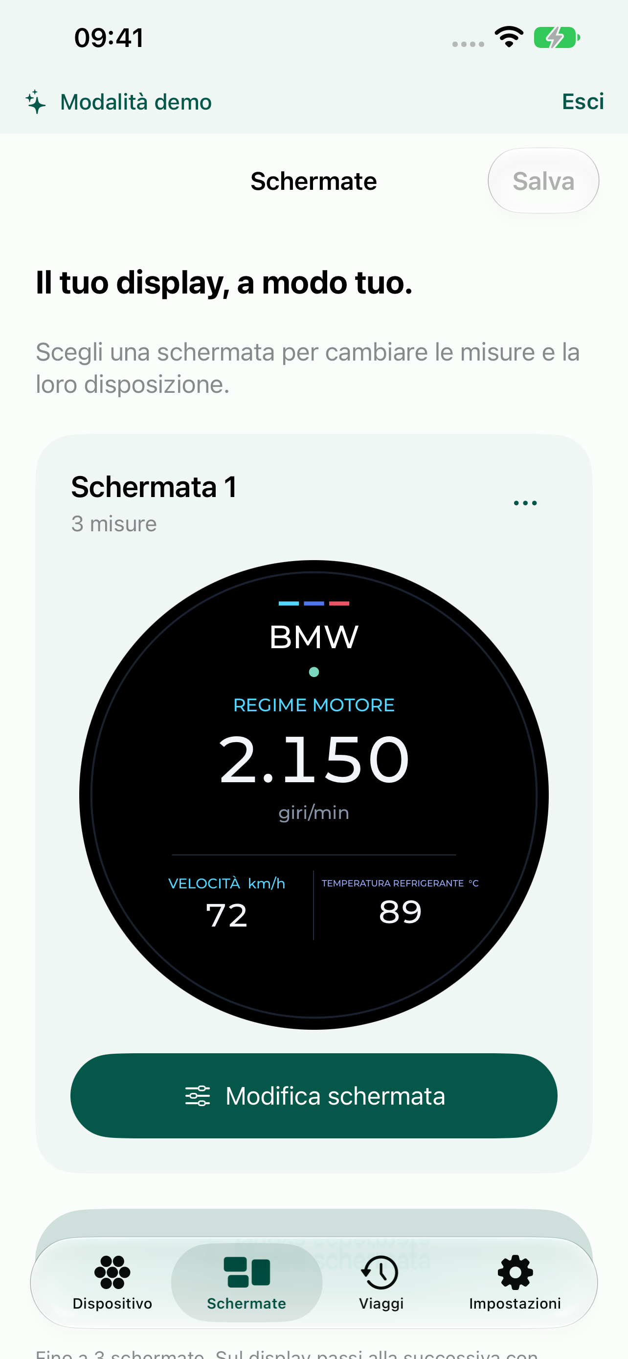
docs/validation/ios/CLUSTER27/16-cluster-gallery.png
