Ale1x/auto-gauge/docs/validation/ios/CLUSTER27/17-cluster-editor.png

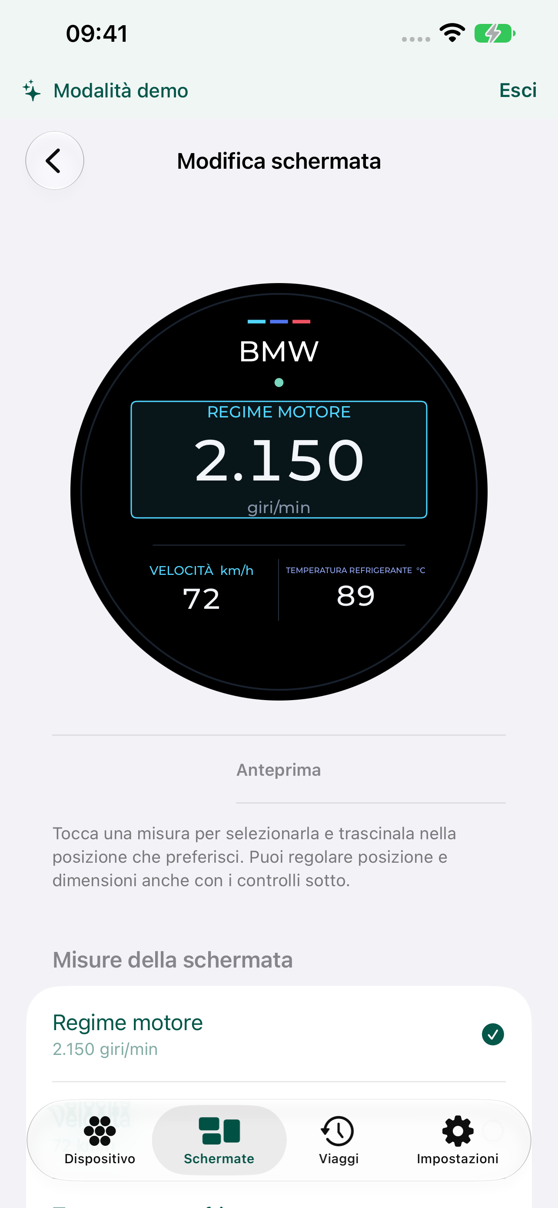
docs/validation/ios/CLUSTER27/17-cluster-editor.png
