Ale1x/auto-gauge/docs/validation/ios/EXPERIENCE27/after/64-onboarding-large-text.png

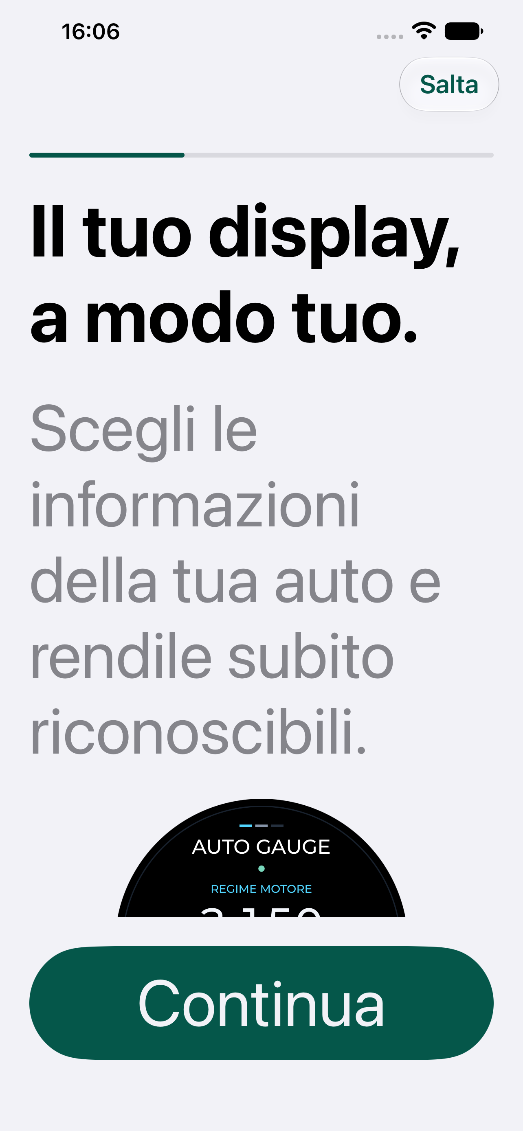
docs/validation/ios/EXPERIENCE27/after/64-onboarding-large-text.png
