Ale1x/auto-gauge/docs/validation/ios/EXPERIENCE27/before/51-brightness.png

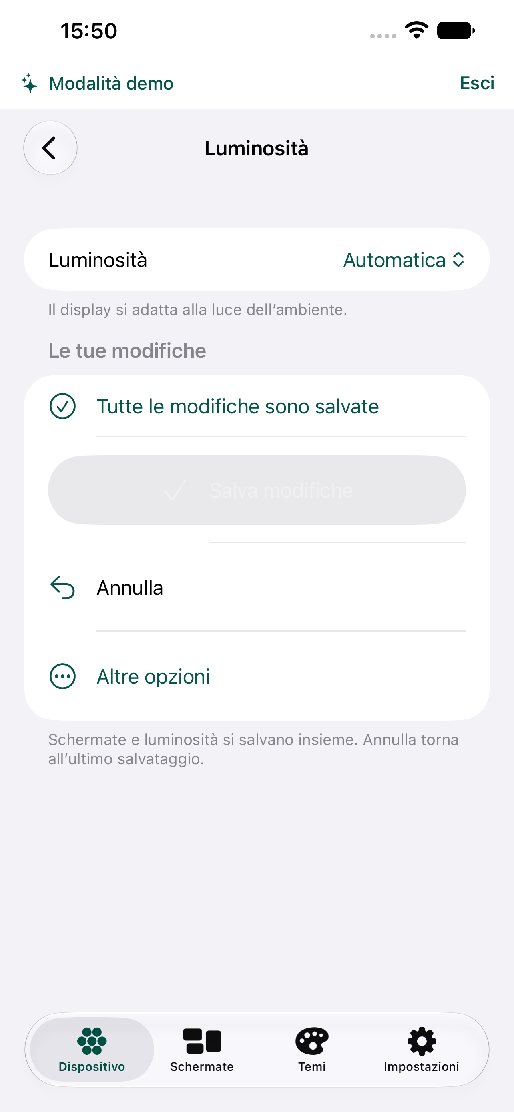
docs/validation/ios/EXPERIENCE27/before/51-brightness.png
