Ale1x/auto-gauge/docs/validation/ios/EXPERIENCE27/before/52-measures.png

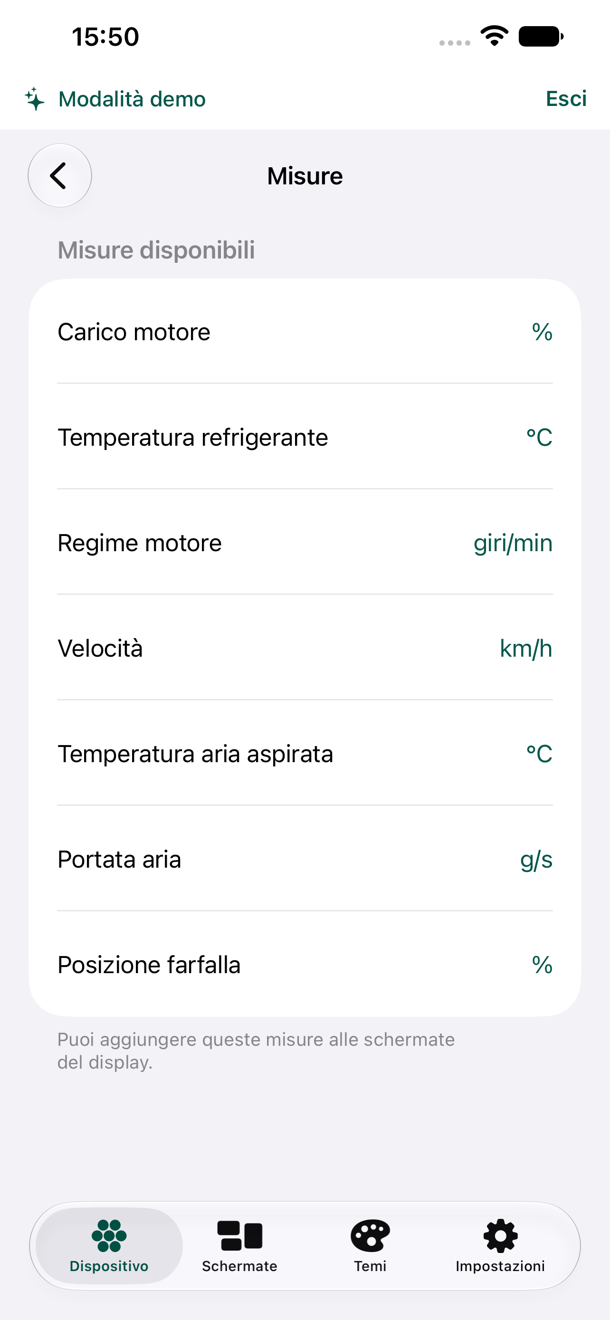
docs/validation/ios/EXPERIENCE27/before/52-measures.png
