Ale1x/auto-gauge/docs/validation/ios/EXPERIENCE27/before/53-updates.png

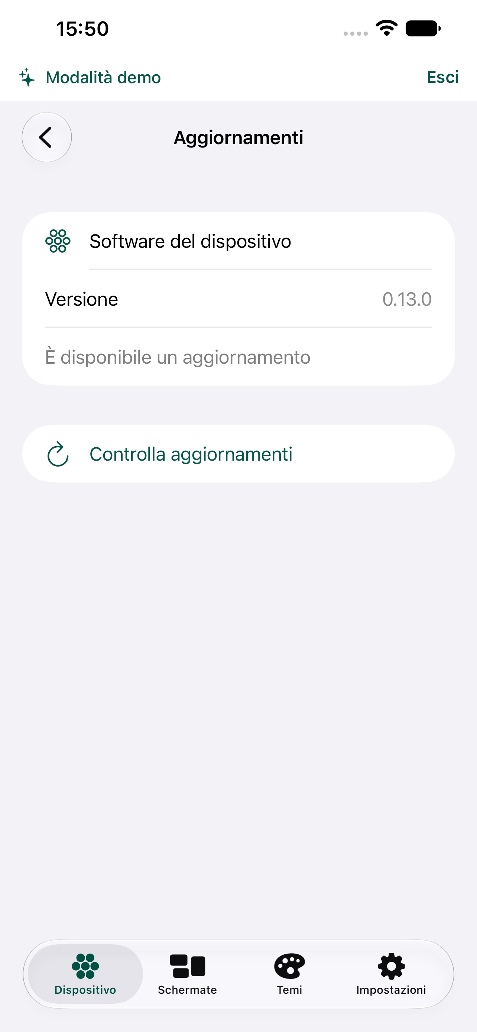
docs/validation/ios/EXPERIENCE27/before/53-updates.png
