Ale1x/auto-gauge/docs/validation/ios/EXPERIENCE27/before/54-settings.png

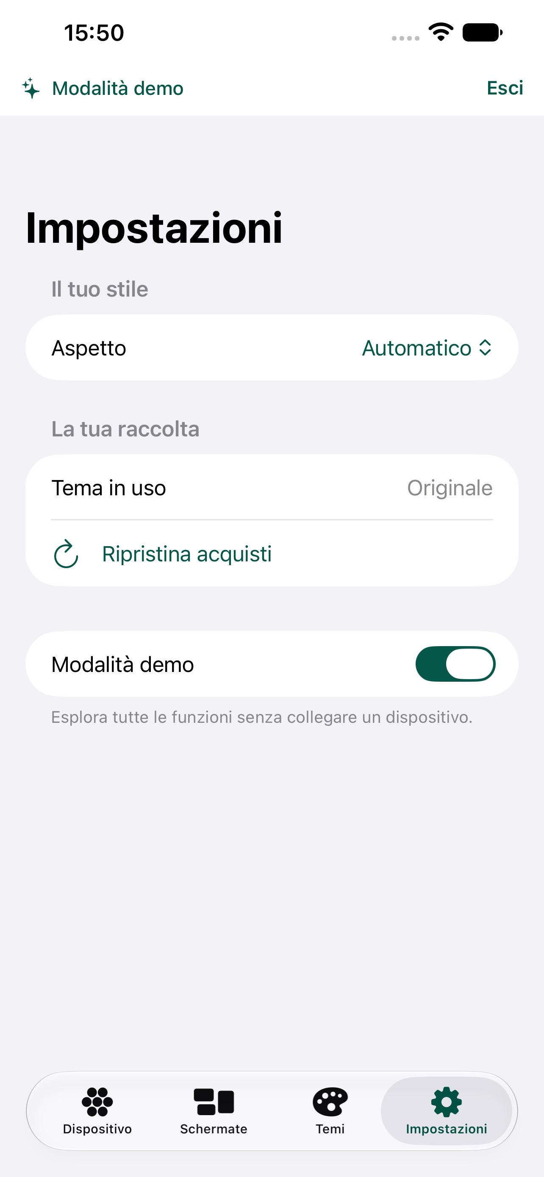
docs/validation/ios/EXPERIENCE27/before/54-settings.png
