Ale1x/auto-gauge/docs/validation/ios/EXPERIENCE27/before/57-connect.png

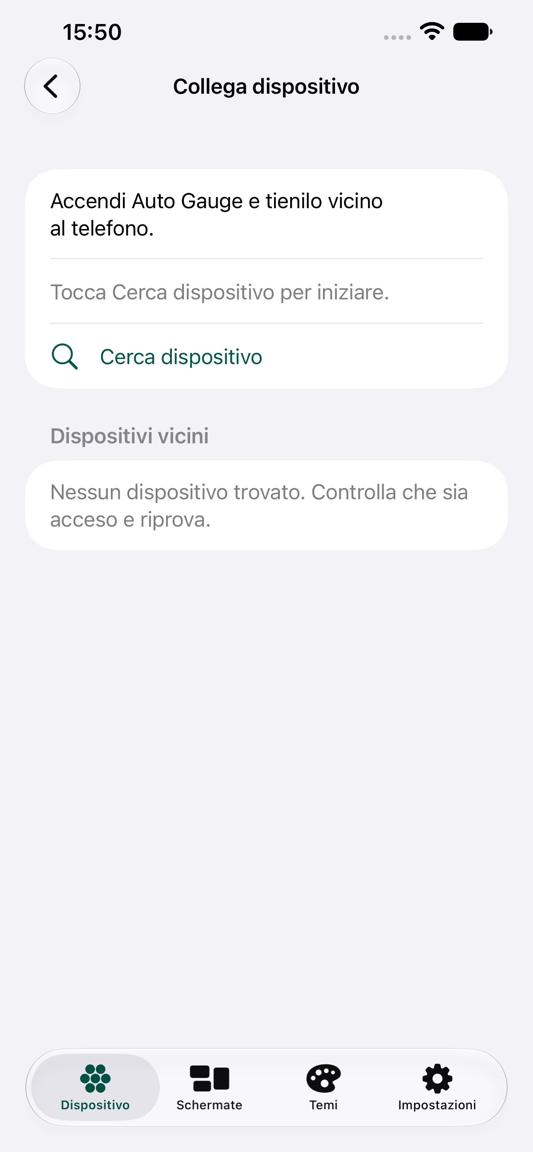
docs/validation/ios/EXPERIENCE27/before/57-connect.png
