Ale1x/auto-gauge/docs/validation/ios/EXPERIENCE27/dark/50-home.png

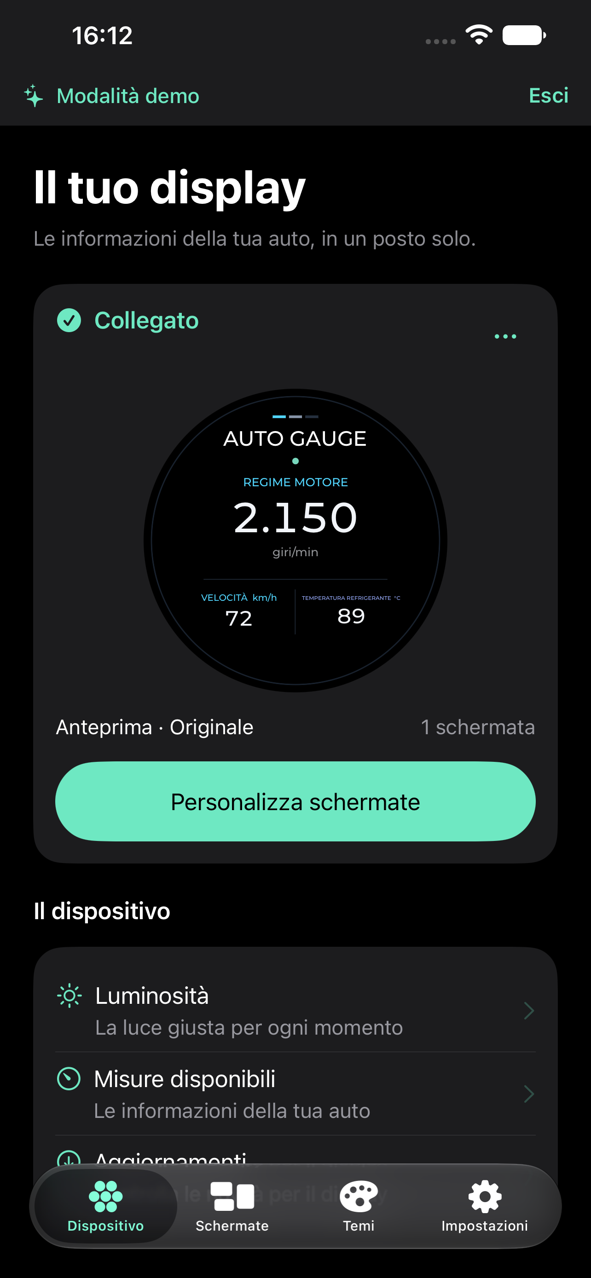
docs/validation/ios/EXPERIENCE27/dark/50-home.png
