Ale1x/auto-gauge/docs/validation/ios/EXPERIENCE27/dark/51-brightness.png

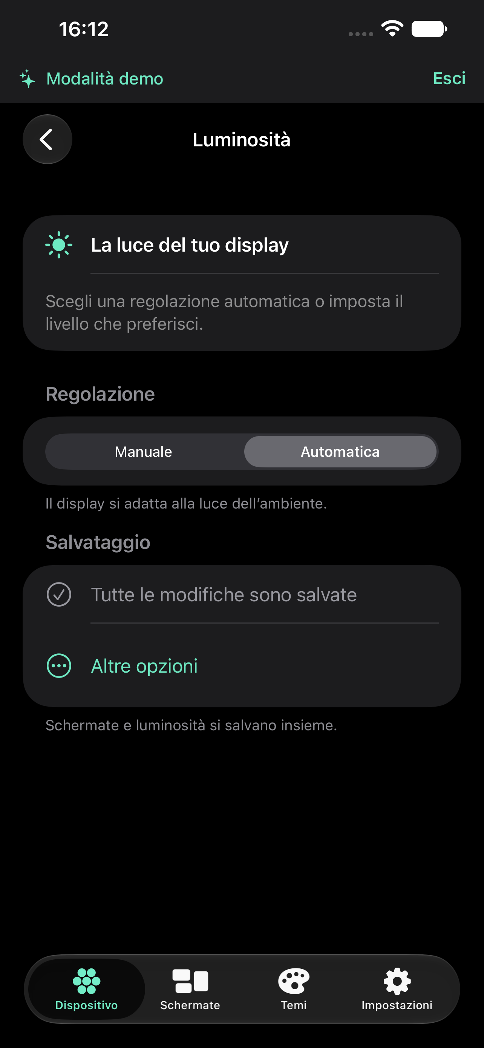
docs/validation/ios/EXPERIENCE27/dark/51-brightness.png
