Ale1x/auto-gauge/docs/validation/ios/EXPERIENCE27/dark/54-settings.png

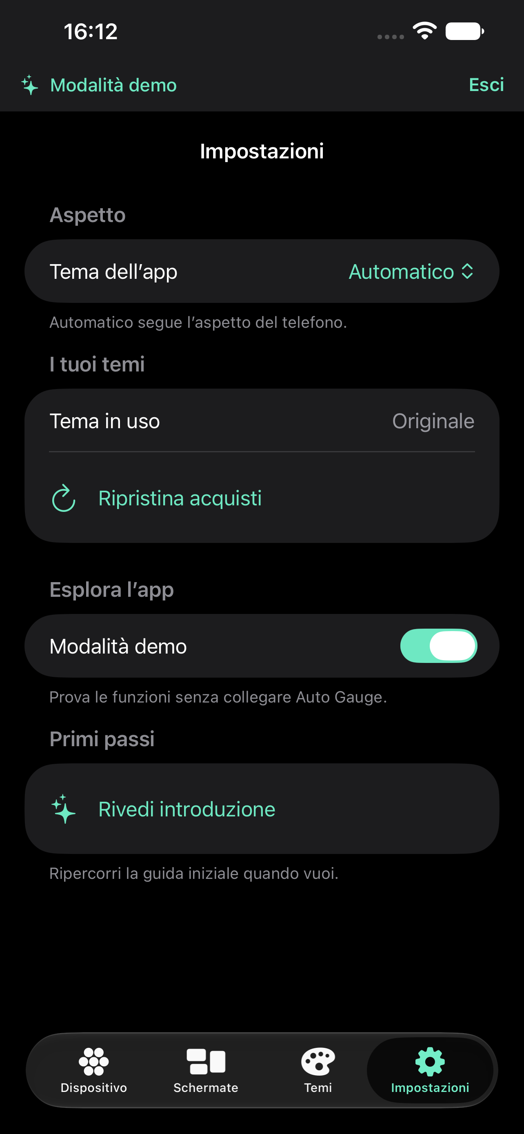
docs/validation/ios/EXPERIENCE27/dark/54-settings.png
