Ale1x/auto-gauge/docs/validation/ios/EXPERIENCE27/dark/60-onboarding-welcome.png

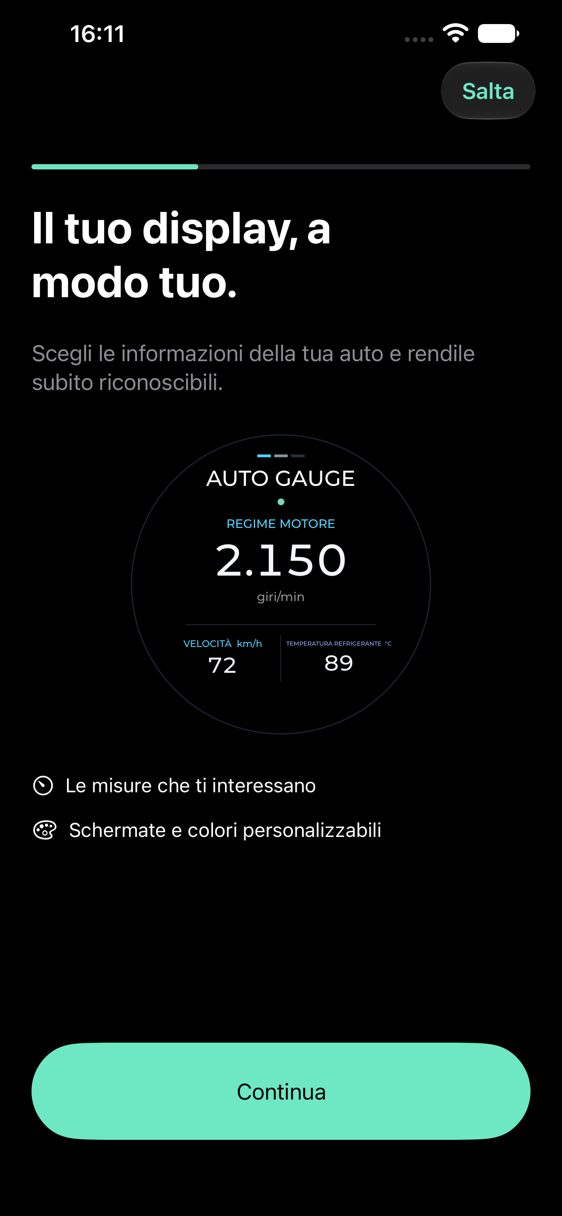
docs/validation/ios/EXPERIENCE27/dark/60-onboarding-welcome.png
