Ale1x/auto-gauge/docs/validation/ios/EXPERIENCE27/dark/61-onboarding-style.png

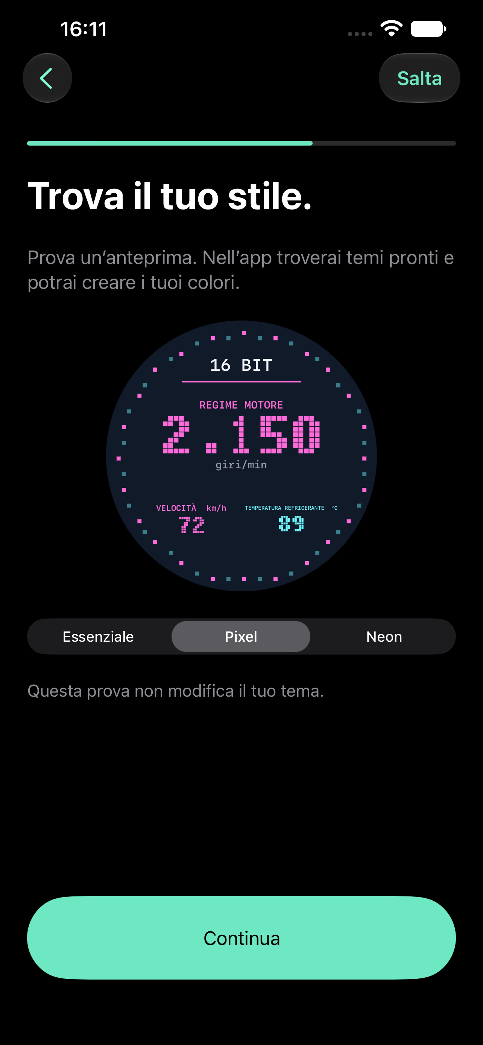
docs/validation/ios/EXPERIENCE27/dark/61-onboarding-style.png
