Ale1x/auto-gauge/docs/validation/ios/EXPERIENCE27/dark/62-onboarding-start.png

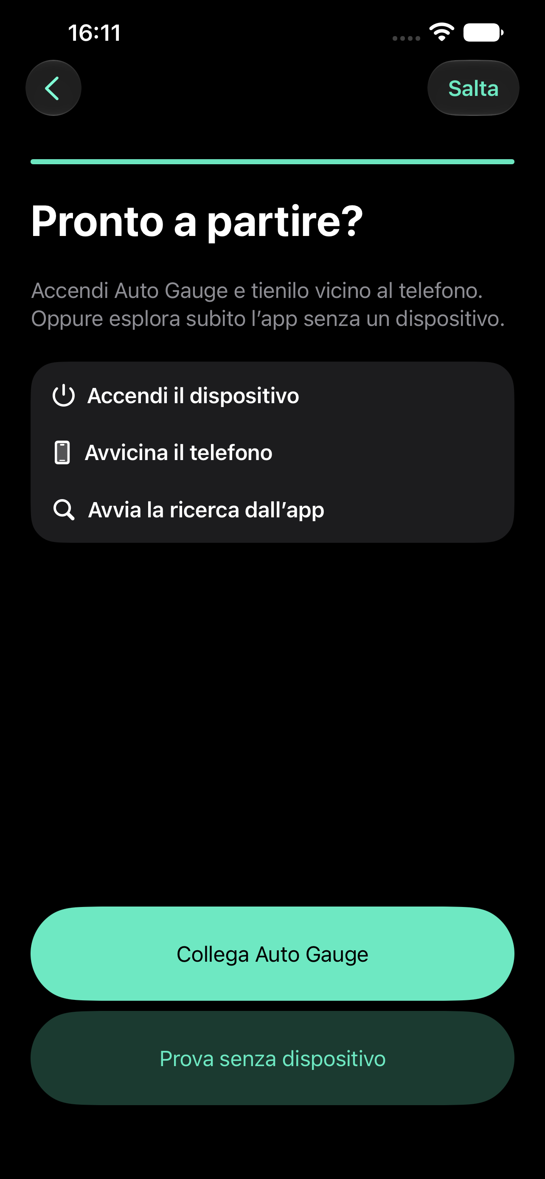
docs/validation/ios/EXPERIENCE27/dark/62-onboarding-start.png
