Ale1x/auto-gauge/docs/validation/ios/narrow-accessibility.png

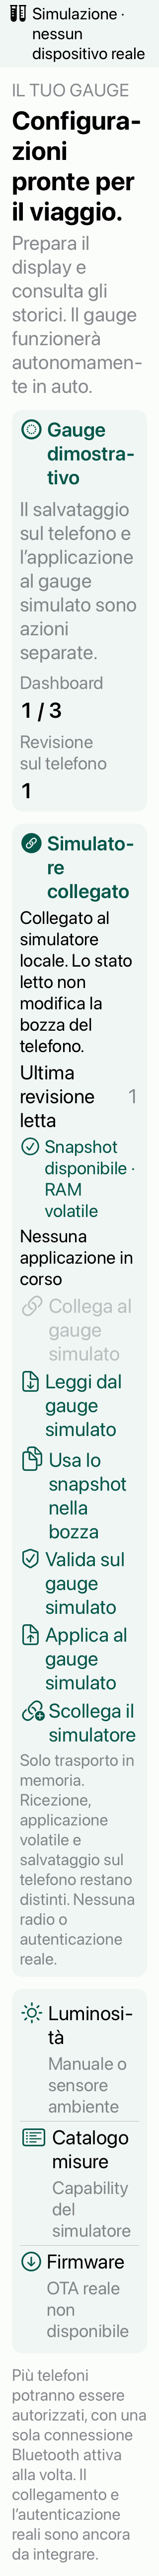
docs/validation/ios/narrow-accessibility.png
