Ale1x/auto-gauge/docs/validation/ios/narrow-dark.png

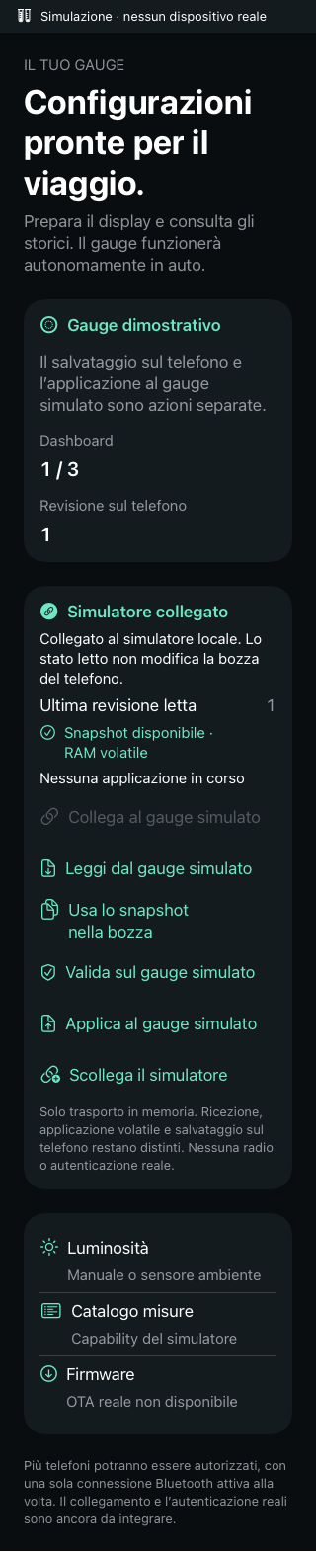
docs/validation/ios/narrow-dark.png
