Ale1x/auto-gauge/docs/validation/ios/narrow-light.png

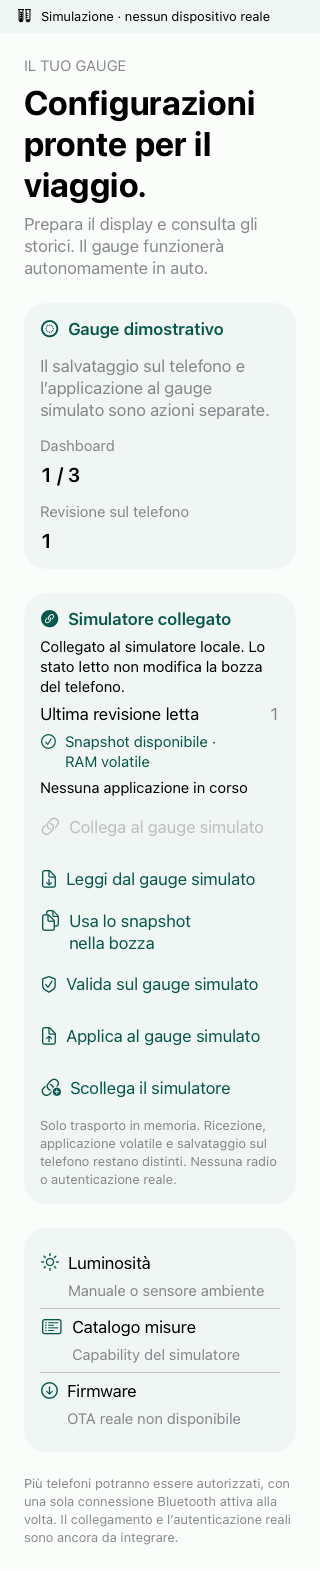
docs/validation/ios/narrow-light.png
