Ale1x/auto-gauge/docs/validation/ios/ONBOARDING27/dark/60-onboarding-welcome.png

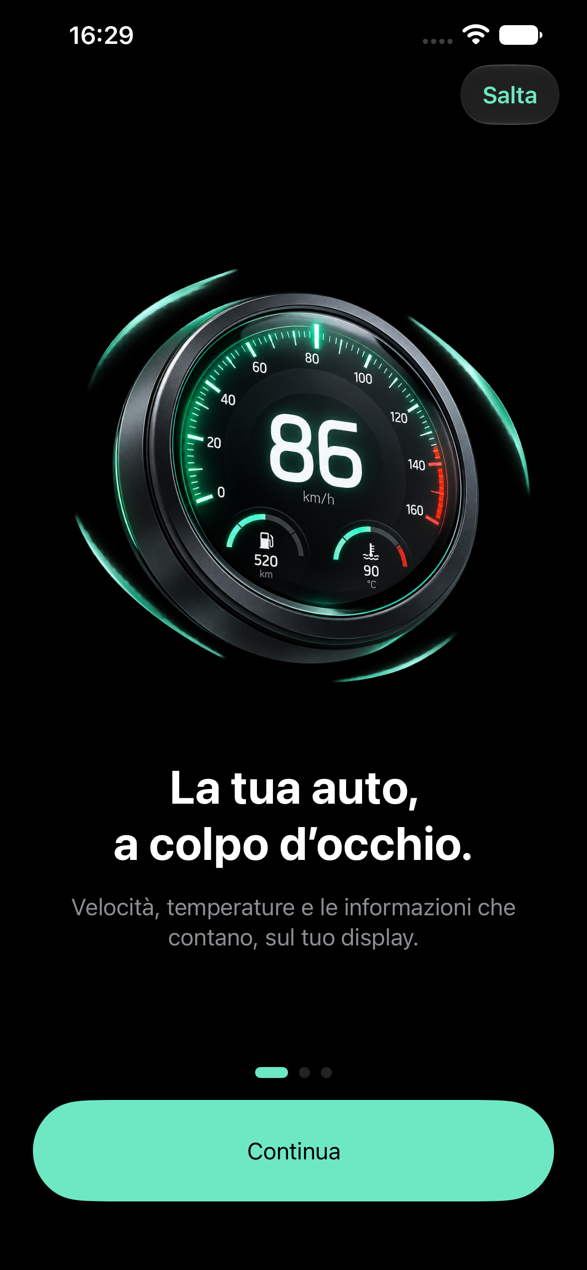
docs/validation/ios/ONBOARDING27/dark/60-onboarding-welcome.png
