Ale1x/auto-gauge/docs/validation/ios/ONBOARDING27/dark/61-onboarding-style.png

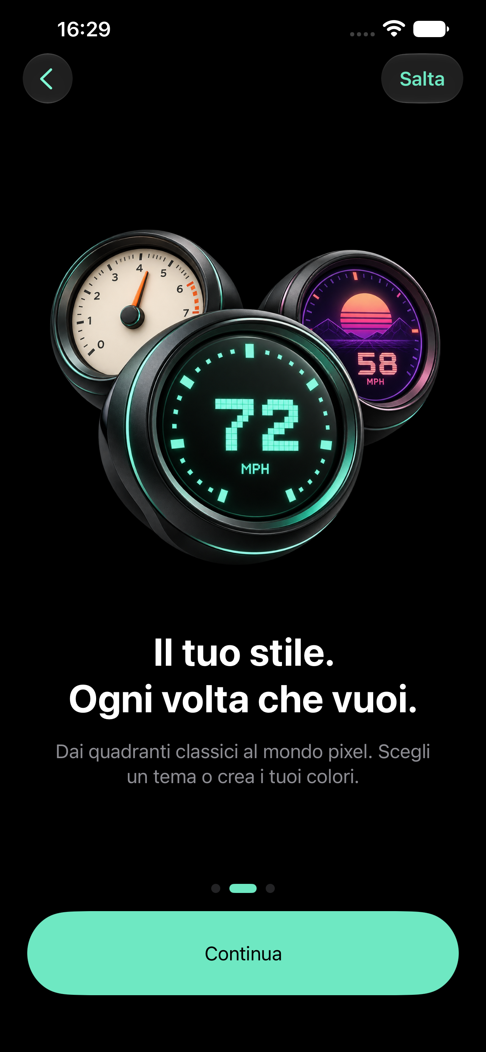
docs/validation/ios/ONBOARDING27/dark/61-onboarding-style.png
