Ale1x/auto-gauge/docs/validation/ios/ONBOARDING27/dark/62-onboarding-start.png

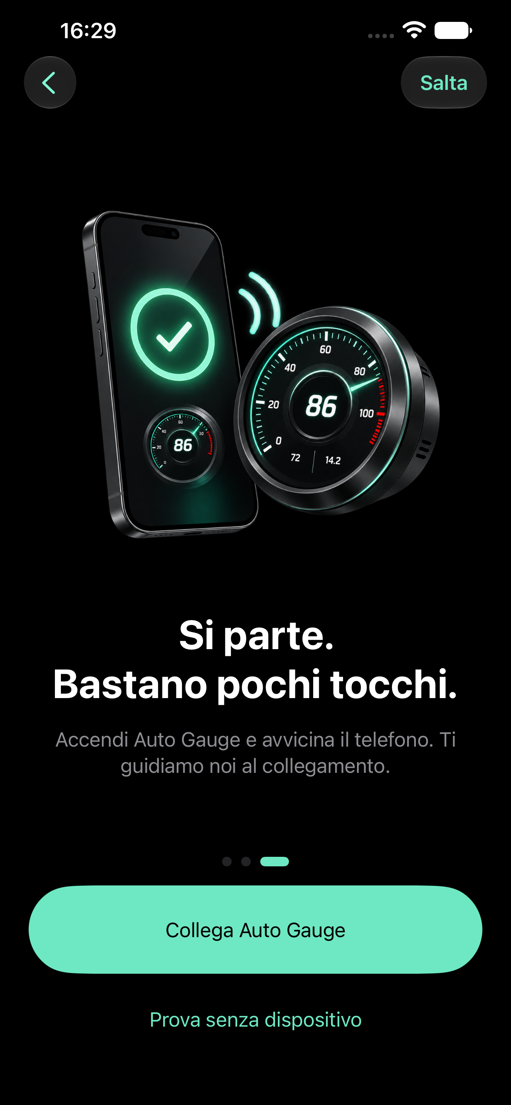
docs/validation/ios/ONBOARDING27/dark/62-onboarding-start.png
