Ale1x/auto-gauge/docs/validation/ios/ONBOARDING27/dark/65-onboarding-style-large-text.png

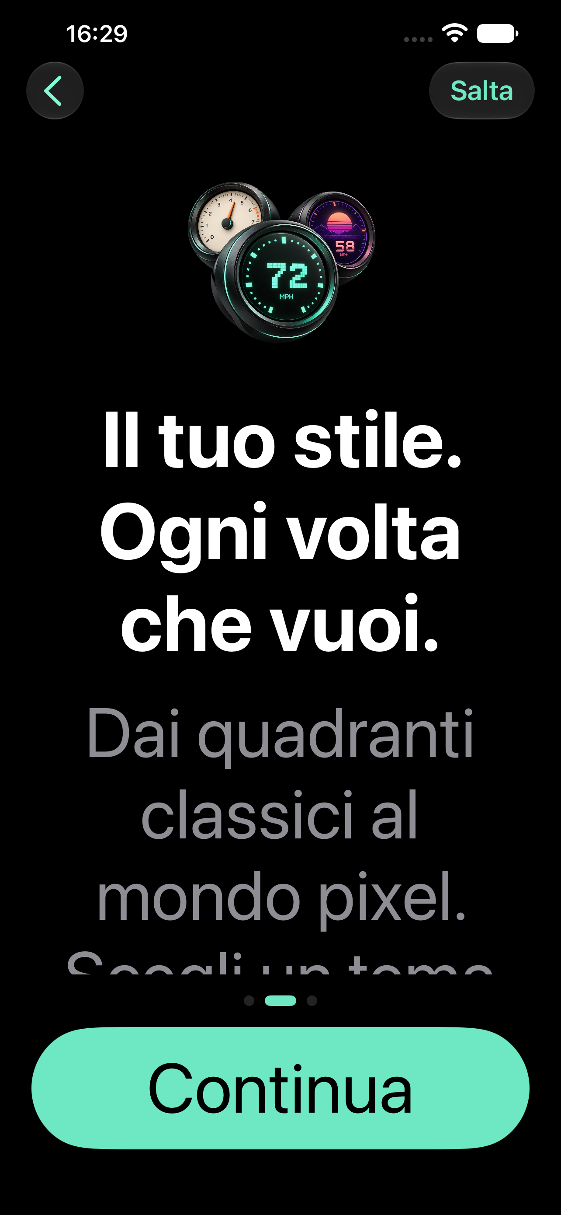
docs/validation/ios/ONBOARDING27/dark/65-onboarding-style-large-text.png
