Ale1x/auto-gauge/docs/validation/ios/ONBOARDING27/dark/66-onboarding-start-large-text.png

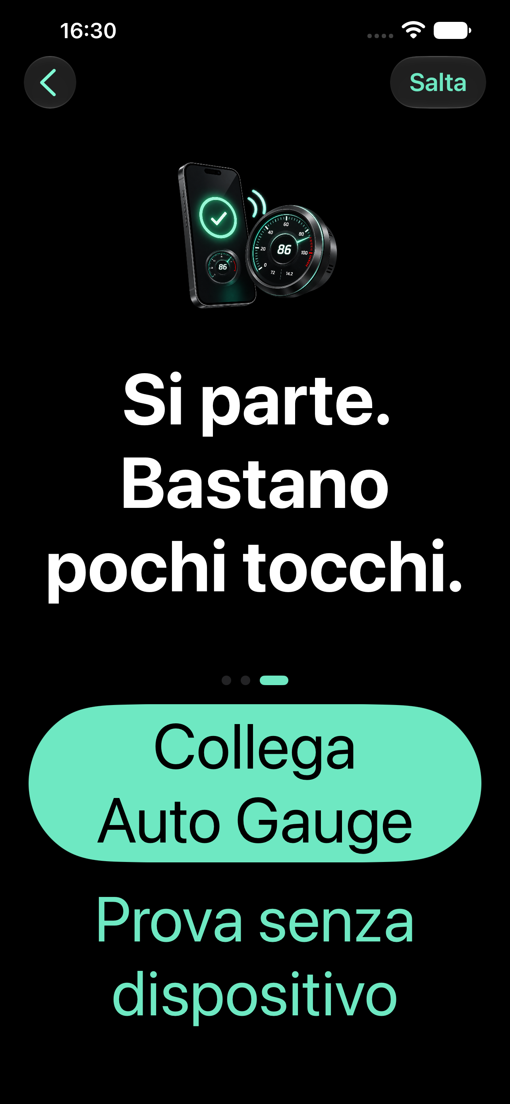
docs/validation/ios/ONBOARDING27/dark/66-onboarding-start-large-text.png
