Ale1x/auto-gauge/docs/validation/ios/ONBOARDING27/light/61-onboarding-style.png

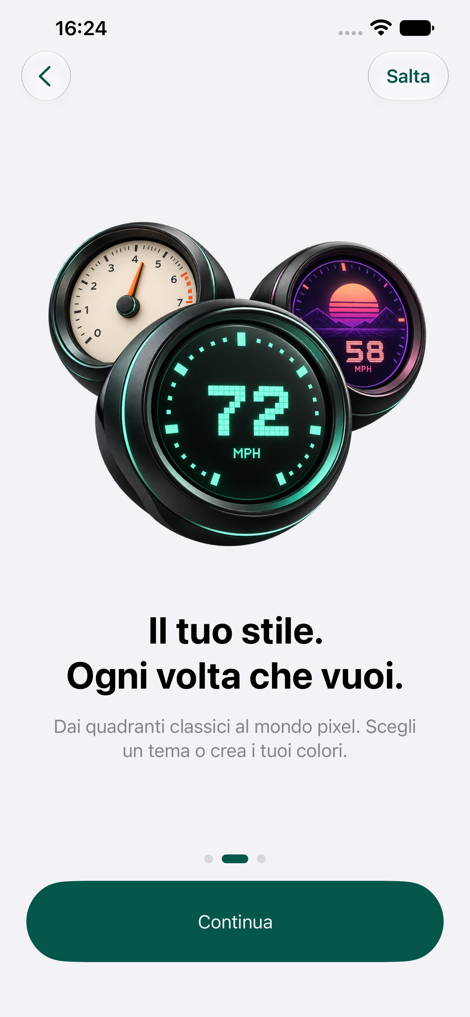
docs/validation/ios/ONBOARDING27/light/61-onboarding-style.png
