Ale1x/auto-gauge/docs/validation/ios/ONBOARDING27/light/62-onboarding-start.png

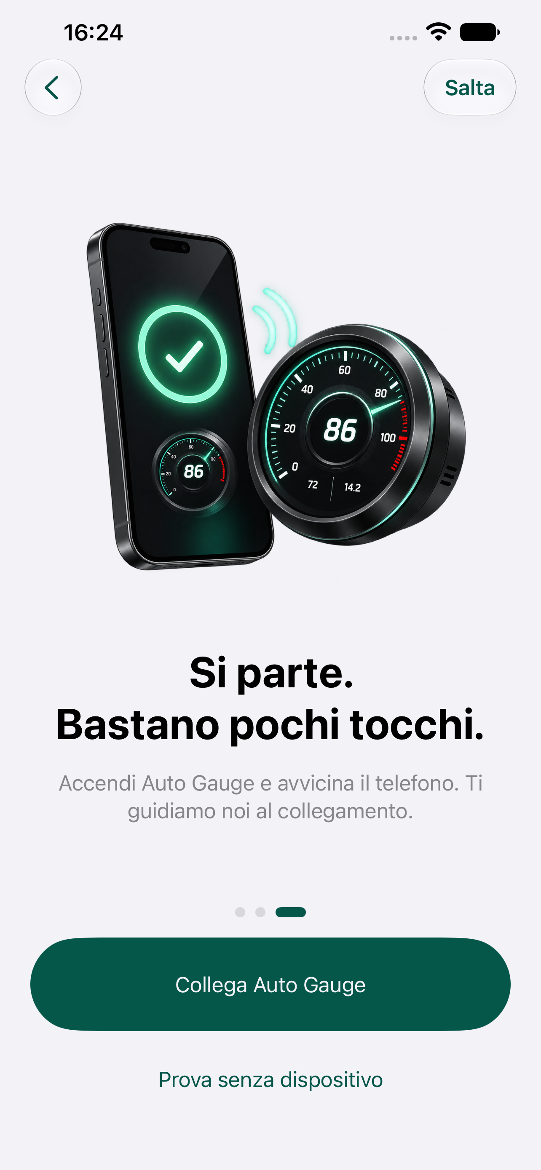
docs/validation/ios/ONBOARDING27/light/62-onboarding-start.png
