Ale1x/auto-gauge/docs/validation/ios/ONBOARDING27/light/64-onboarding-large-text.png

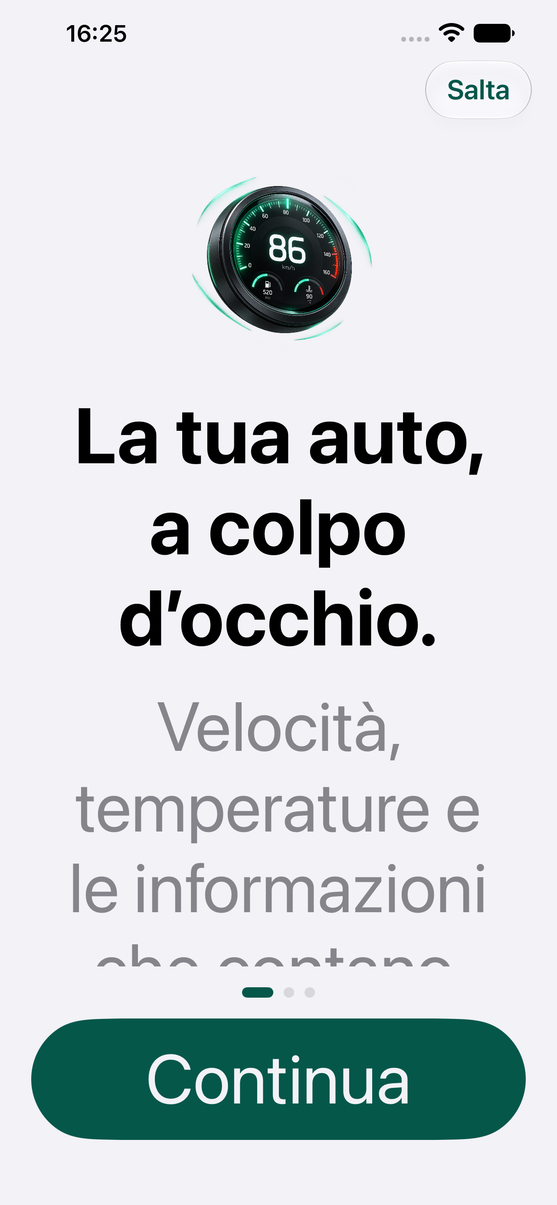
docs/validation/ios/ONBOARDING27/light/64-onboarding-large-text.png
