Ale1x/auto-gauge/docs/validation/ios/SCREENS27/after/12-screens-saved.png

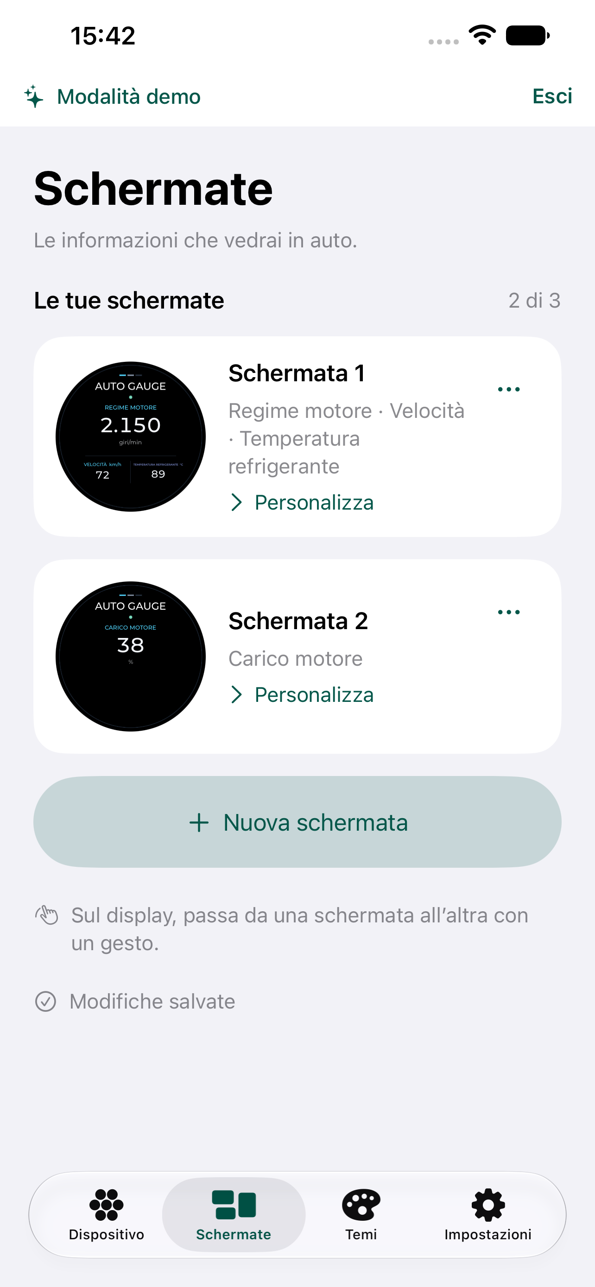
docs/validation/ios/SCREENS27/after/12-screens-saved.png
