Ale1x/auto-gauge/docs/validation/ios/SCREENS27/after/41-three-screens.png

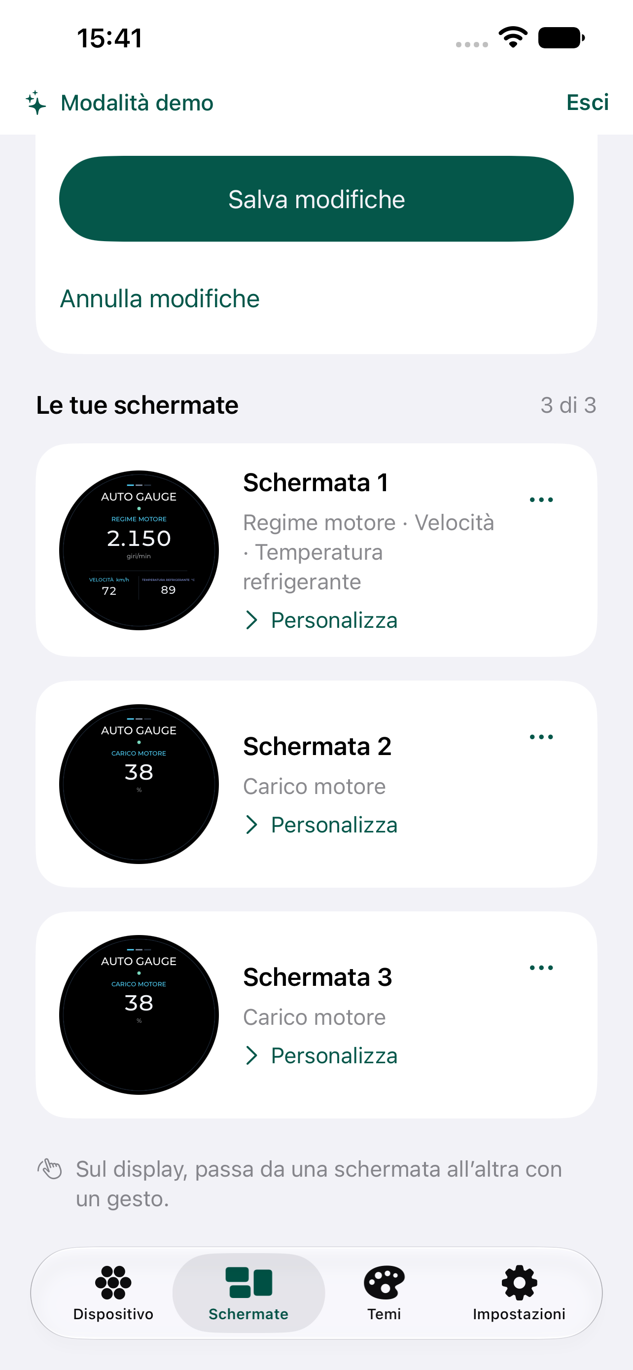
docs/validation/ios/SCREENS27/after/41-three-screens.png
