Ale1x/auto-gauge/docs/validation/ios/SCREENS27/after/43-screens-large-text.png

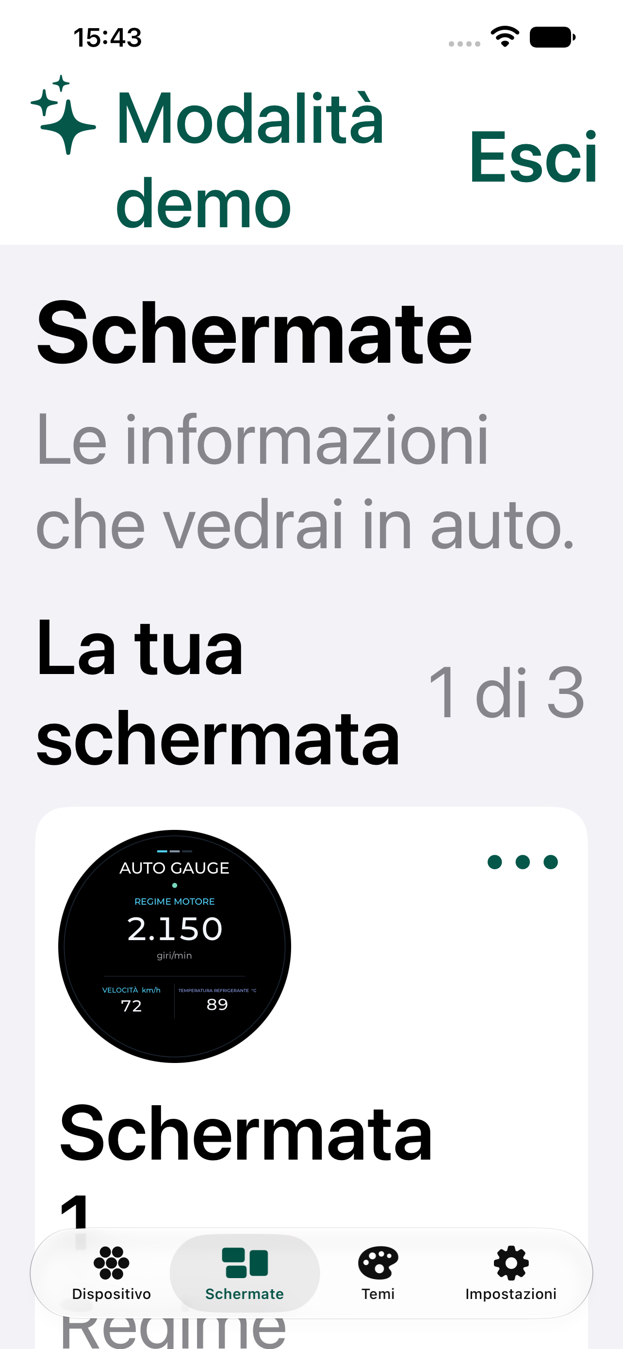
docs/validation/ios/SCREENS27/after/43-screens-large-text.png
