Ale1x/auto-gauge/docs/validation/ios/SCREENS27/before/16-cluster-gallery.png

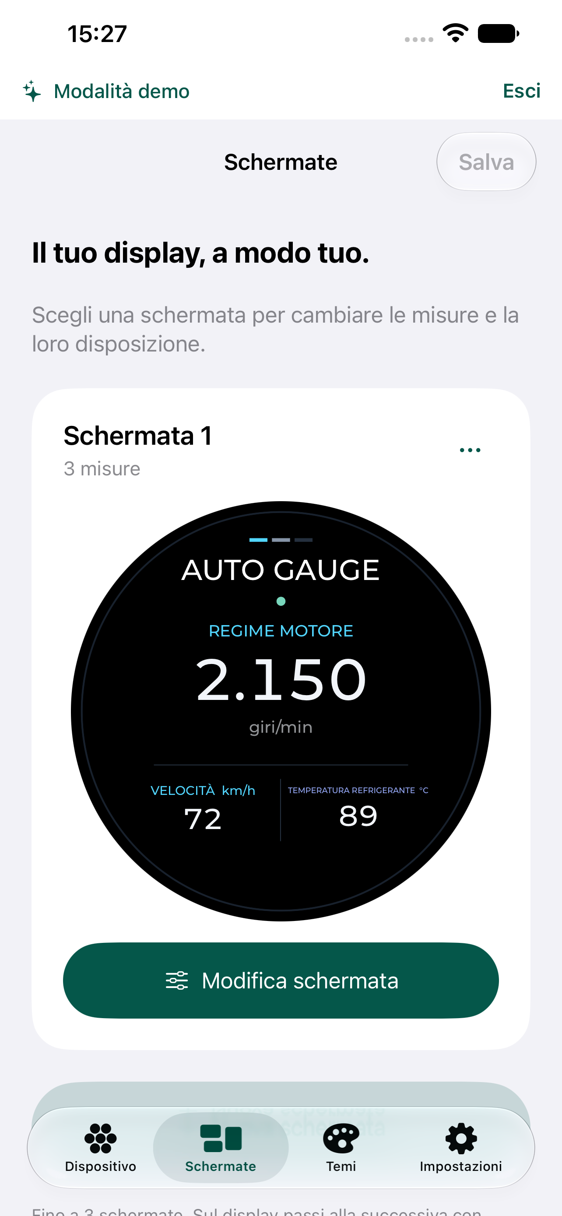
docs/validation/ios/SCREENS27/before/16-cluster-gallery.png
