Ale1x/auto-gauge/docs/validation/ios/THEMES27/before/30-marketplace-before.png

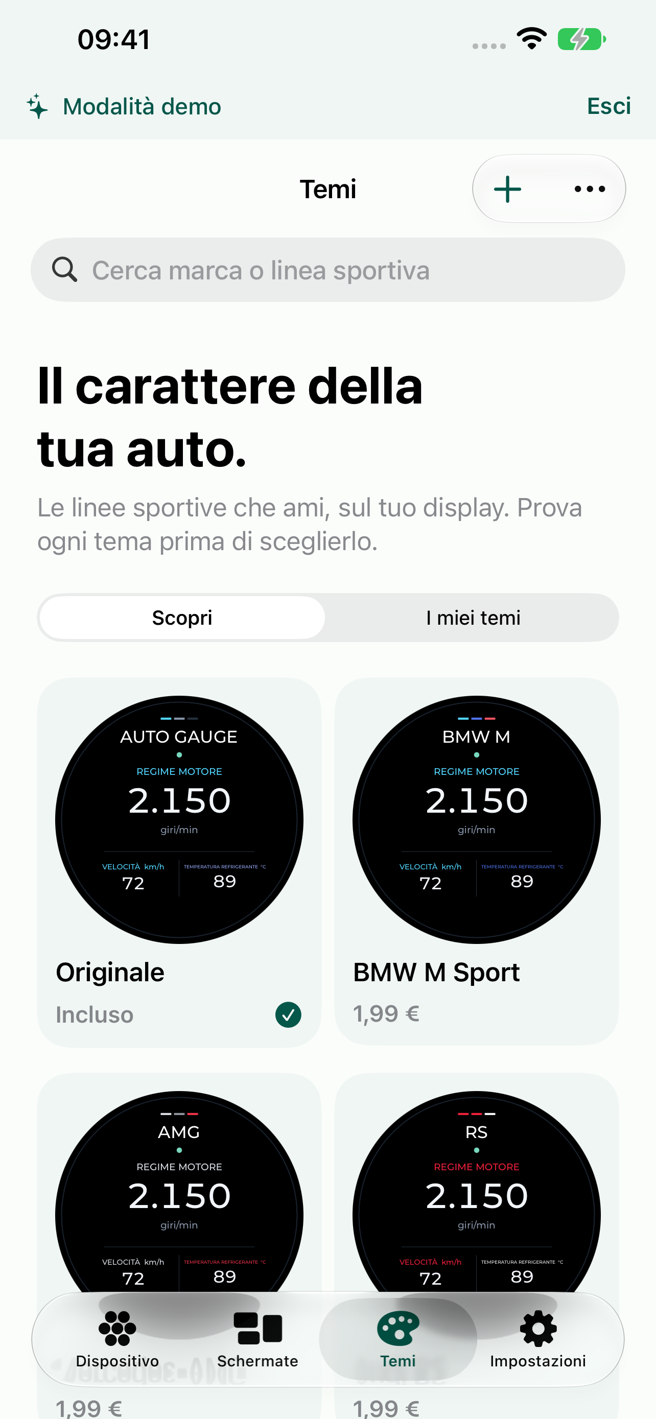
docs/validation/ios/THEMES27/before/30-marketplace-before.png
