Ale1x/auto-gauge/docs/validation/ios/UX27/after/01-device-light.png

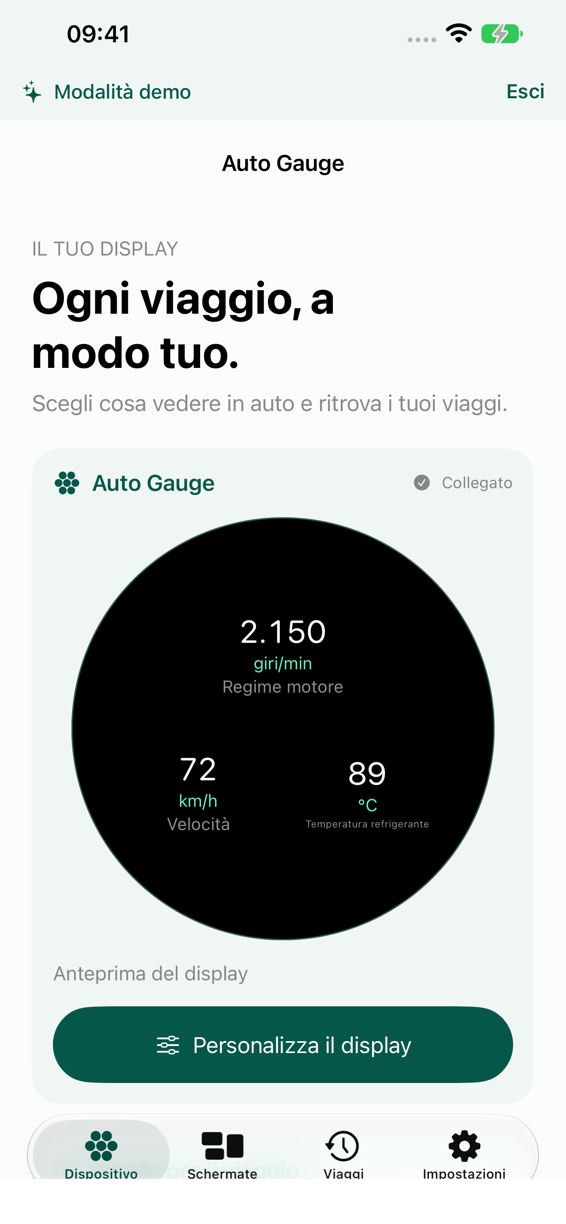
docs/validation/ios/UX27/after/01-device-light.png
