Ale1x/auto-gauge/docs/validation/ios/UX27/after/02-screens-light.png

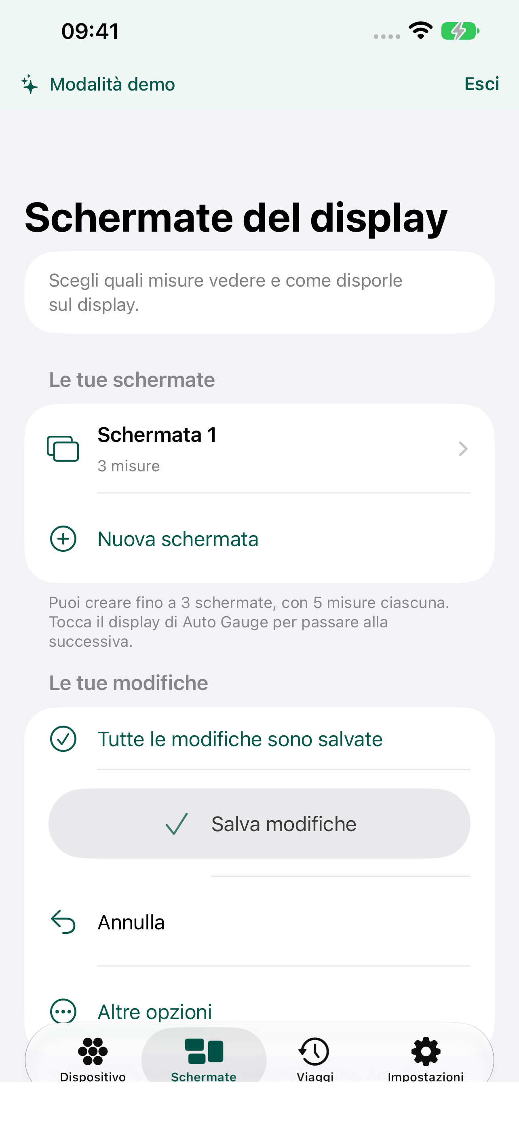
docs/validation/ios/UX27/after/02-screens-light.png
