Ale1x/auto-gauge/docs/validation/ios/UX27/after/03-trips-light.png

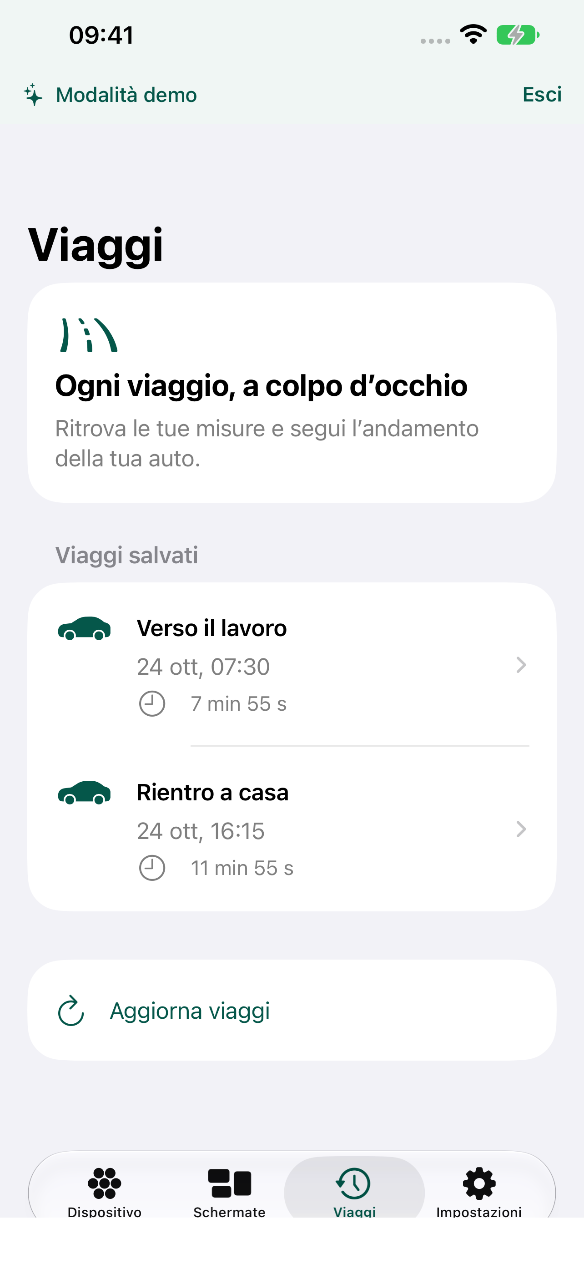
docs/validation/ios/UX27/after/03-trips-light.png
