Ale1x/auto-gauge/docs/validation/ios/UX27/after/04-settings-light.png

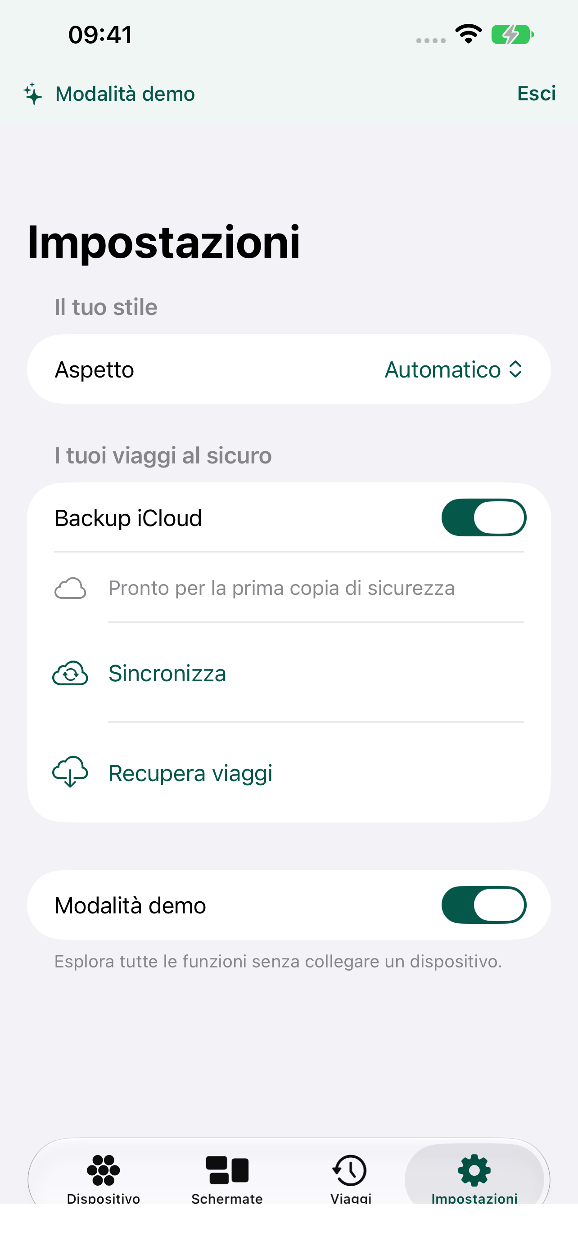
docs/validation/ios/UX27/after/04-settings-light.png
