Ale1x/auto-gauge/docs/validation/ios/UX27/after/07-device-mode.png

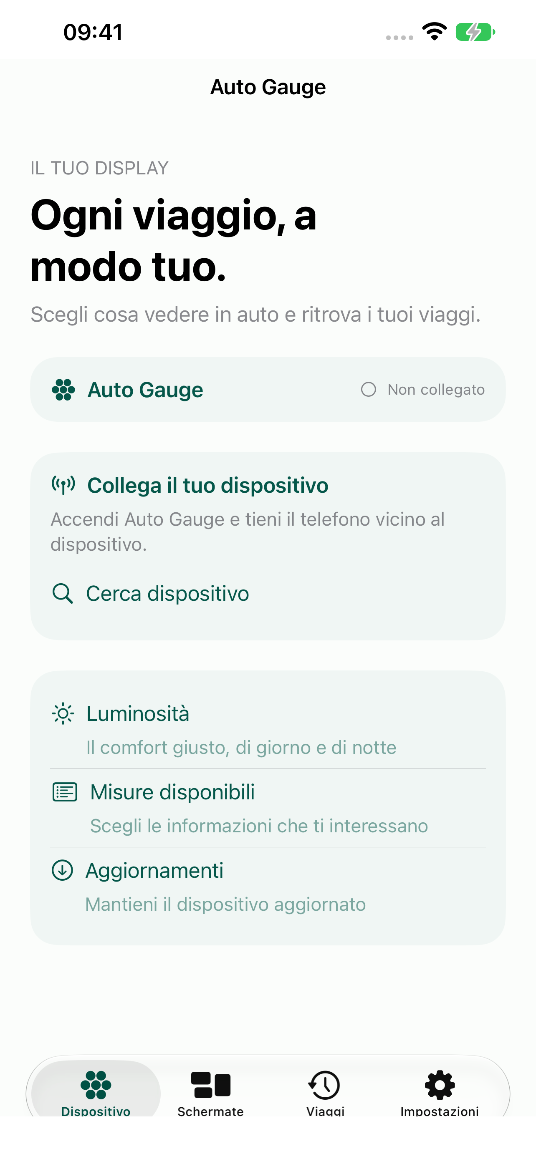
docs/validation/ios/UX27/after/07-device-mode.png
