Ale1x/auto-gauge/docs/validation/ios/UX27/after/09-trip-chart.png

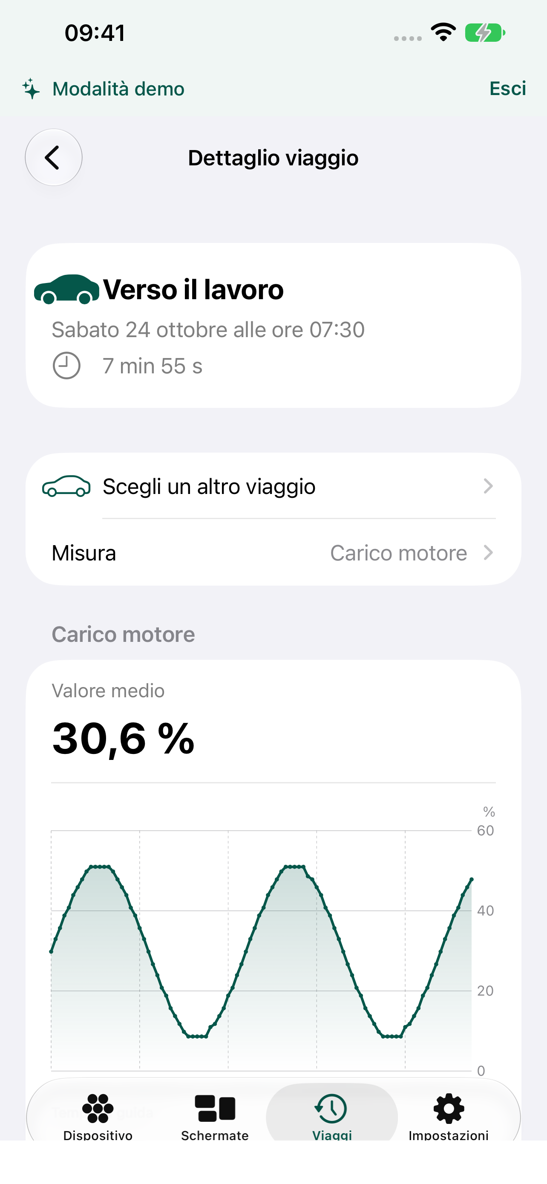
docs/validation/ios/UX27/after/09-trip-chart.png
