Ale1x/auto-gauge/docs/validation/ios/UX27/after/10-backup.png

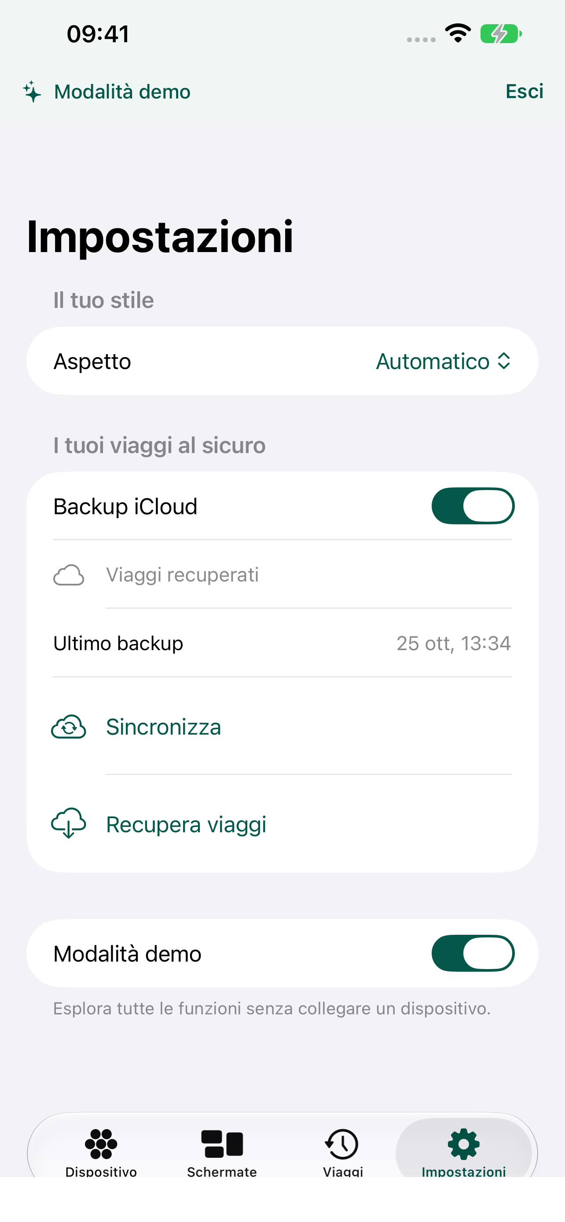
docs/validation/ios/UX27/after/10-backup.png
