Ale1x/auto-gauge/docs/validation/ios/UX27/after/12-screens-saved.png

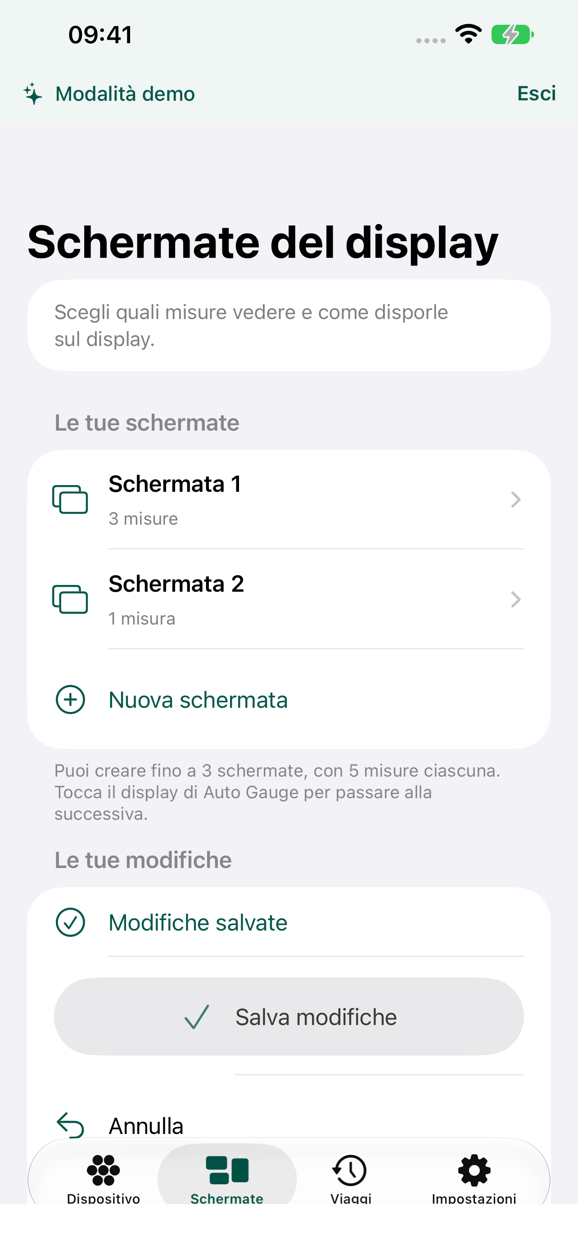
docs/validation/ios/UX27/after/12-screens-saved.png
