Ale1x/auto-gauge/docs/validation/ios/UX27/after/13-device-large-text.png

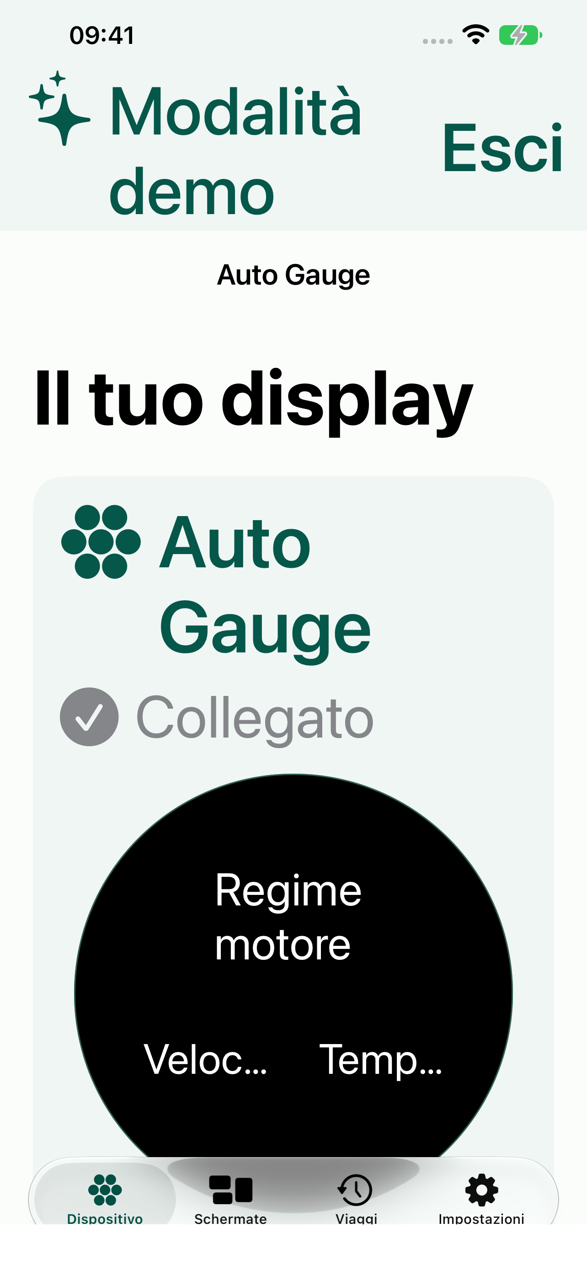
docs/validation/ios/UX27/after/13-device-large-text.png
