Ale1x/auto-gauge/docs/validation/ios/UX27/after/15-device-large-text-scrolled.png

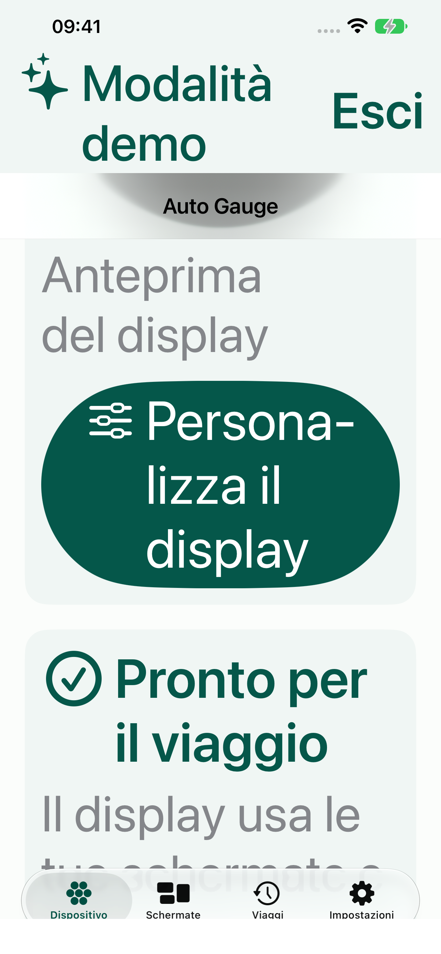
docs/validation/ios/UX27/after/15-device-large-text-scrolled.png
