Ale1x/auto-gauge/docs/validation/ios/UX27/before/01-device.png

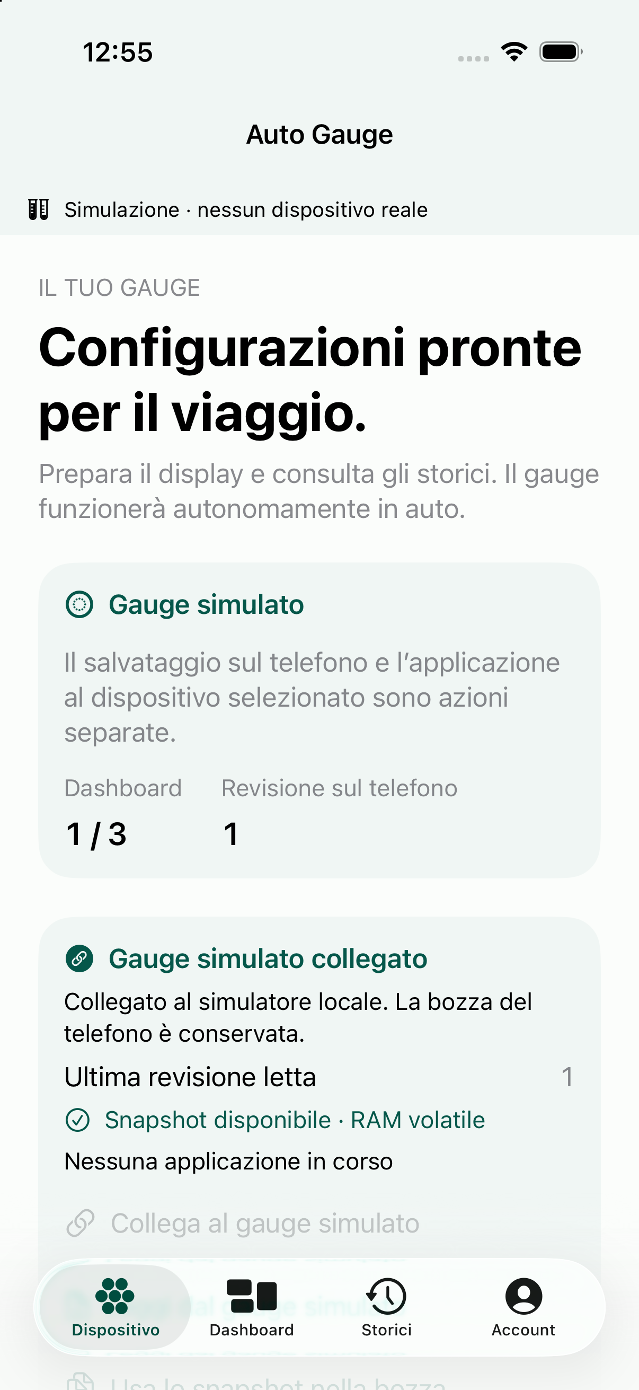
docs/validation/ios/UX27/before/01-device.png
