Ale1x/auto-gauge/docs/validation/ios/wide-light.png

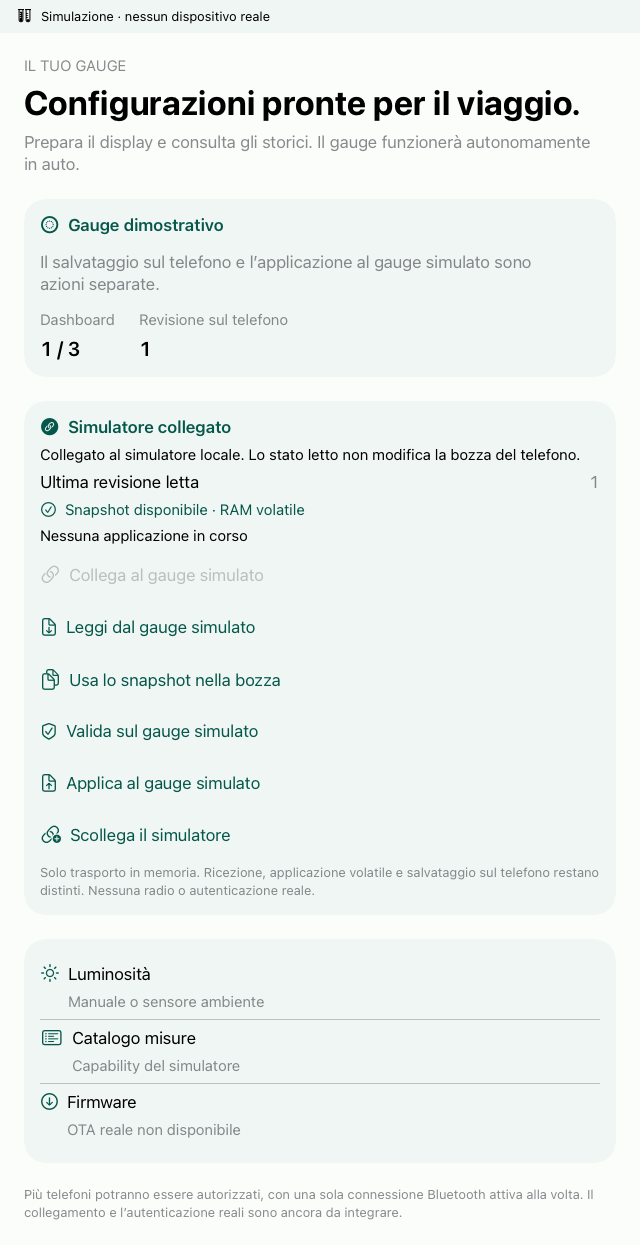
docs/validation/ios/wide-light.png
