Ale1x/auto-gauge/docs/hardware/issues/K0-001_BLOCKERS.md

# K0-001 — STOP / gate K0 non superato

Revisione 0.7, data 2026-10-24. Stato: APERTA. Priorità P0. Origine: stop condition di docs/archive/briefs/CODEX_KICAD_TASK_V0.2.md e SPEC §10, §11, §13.

1. **Fit pannello — aggiornato da DEC-002:** il proprietario autorizza un piccolo aumento oltre Ø44,45 mm. Il rifiuto al vecchio limite non è più causa di esclusione del candidato. Ø52 mm è ipotesi di studio; massimo finale, tolleranze e fit completo restano aperti. docs/hardware/MECHANICAL_K0.md riporta il calcolo preliminare, non una verifica CAD.
2. **Documentazione pannello:** discrepanze interne di rail e temperatura e dati massimi di consumo insufficienti. Richiedere datasheet corretto approvato, sequenze/inizializzazione e accoppiamento FPC. Nessun footprint congelabile.
3. **Sourcing:** ricerca estesa in docs/suppliers/PANEL_SOURCING_K0.md. Huaxin dichiara campioni a stock a USD10/unità (E32), ma quantità5 e identità esatta non confermate; VIEWE prezzo pubblico ma codici PDF discordanti; LX senza stock. Nessuna conferma lotto5 con datasheet corretto. O-16 aperta.
4. **IGN/wake:** nessuna prova su Polo o simulatore; O-18 e O-06 aperte. Nessuna equivalenza automatica CAN attivo = quadro ON; nessun polling di wake in standby.
5. **Standby:** target100µA/300s approvato DEC-005; mancano metodo completo e misure dell’intero assieme all’ingresso OBD.
6. **Protezione automotive:** DEC-008 ammette reset crank con ripartenza automatica, ma O-07 resta senza profili/limiti completi approvati; TVS, fusibile, MOSFET e coordinamento elettrico non dimensionati. Nessuna prova eseguita.
7. **Assemblaggio/costo:** richieste JLCPCB/PCBWay inviate via Gmail, SENT confermato; dettagli in docs/suppliers/SUPPLIER_CONTACT_LOG.md. O-17 senza conferma scritta per pannello+cavo+PCB e senza preventivo completo. Budget non verificato.
8. **Scope/storage:** Service01 approvato DEC-003; buffering locale limitato approvato DEC-004. DEC-006 approva2MiB condizionatiOTA, fino1Hz e overwrite con perdita segnalata. docs/hardware/CAPACITY_K0.md quantifica sensibilità flash/log e latenza CAN; restano build reale e verifica prestazioni, non la policy del meccanismo.

Effetto: fermare avanzamento a schematico finale, layout, export produttivi e ordini. Sono ammessi documentazione K0 e raccolta evidenze; i dati mancanti restano espliciti. Due disegni di assiemi dichiarati conformi richiedono parti documentate e verifica del fit; il candidato è riammesso allo studio, non selezionato.

Chiusura: prove e decisioni tracciate per ogni punto, disegno quotato dell'assieme reale e approvazione esplicita del gate K0 da parte del proprietario. Nessun punto è chiuso dal solo ERC/DRC.

Aggiornamento connettori: terminali crimp esatti candidati ora documentati, ma30cicli e compatibilità filo/isolante da verificare; alternativaHR30 comparata, senza stock plug nel canale consultato. Nessun blocker chiuso dalla sola identificazione dei terminali.

DEC-009 autorizza la creazione dello schema di revisione A0 in hardware/ anche a blocker aperti. La stop condition continua a impedire di dichiararlo definitivo/costruibile e di passare a produzione. Le aperture sono visibili nei fogli e in hardware/ERC_REVIEW.md; nessun blocker è stato chiuso dalla creazione del fileKiCad.
