Ale1x/auto-gauge/docs/reviews/software/JOURNAL_HISTORY_REVIEW.md

# FW-10 journal history — independent review

Date: 2026-10-24. Status: SOURCE_REVIEW_AND_HOST_FAULT_TESTS_COMPLETED; NOT_PHYSICAL_FLASH_QUALIFIED. Review ownership is this report only; firmware/mobile sources are not modified. No hardware, radio, physical flash, commits or remotes. Separately authorized NimBLE harness/documentation follow-ups were completed while waiting; they are reported in `docs/reviews/software/NIMBLE_STUDY_REVIEW.md`.

## Baseline and acceptance oracle

Read `ag_history.h/history.c`, `ag_flash_history.h/flash_history.c`, its simulator/tests, `docs/firmware/FLASH_HISTORY_MODEL.md` and `docs/protocols/LOG_SYNC_V0.1.md`. The existing two-bank COW store is a recovery reference, explicitly not a production append log. Its conservative READ_ONLY behavior on a dirty competing bank must not be silently weakened into an assertion that a damaged/newer sector never existed.

The journal must preserve these externally meaningful properties:

- A committed record has a stable (device, SID, sequence) identity and canonical contents; retry cannot silently replace it with another sample. Sequence and global serial never wrap. A fresh boot needs an explicitly fresh trusted SID; opening media never resumes old monotonic time implicitly.
- Record order and reported loss are exact for the requested SID and cursor. Fully evicted/unprovable sessions are not returned as complete empty pages. Incomplete append does not establish that a never-committed sample existed. Loss caused by reclaiming committed data is distinct from producer/RAM overflow.
- ACK from A does not erase data needed by B and does not create an unbounded device-side cursor table. Page output and errors must retain the established bounded wire semantics, raw64/status validation and uint64 decimal precision.
- Startup never auto-formats corrupt or unreadable media. Short reads are errors, not erased bytes. A successful append means its record/marker has been checked through the defined synchronous durability/readback contract. An interrupted operation can be durably committed before the caller observes success; recovery determines the authoritative result.

## Risk-driven fault-injection plan

1. **First append / ordinary append / last slot.** Cut every programmed byte, including headers, record body, CRC and commit marker; cut reads at0/1/length−1 and inject final readback failure. Recovery must return a canonical committed prefix or an explicit error, never malformed record success. Repeat append after reopening according to session policy.
2. **Rollover and reclaim.** Start with distinguishable data across at least three sectors, include a sector boundary inside a session, then cut each erase/header/marker/program step when reclaiming the oldest sector. Verify unaffected sector bytes remain unchanged. Committed eviction intent can define LOGICAL eviction before physical erase; the on-media format and query policy must explicitly use that commit point consistently, regardless of whether residual bytes remain. A partial/uncommitted intent cannot authorize erase or hide retained records. Repeated failures must not erase multiple valid sectors through restart guesses.
3. **Session transition.** Cut begin-session metadata and the first sample of a new SID. Old-session pages remain valid; new boot/session distinction is retained even if the new session is empty. Reused retained/current SID must fail. Freshness beyond retention remains a caller obligation.
4. **Selection and corruption.** Flip every byte of a newest sector/header/record including padding, then test duplicate generations, conflicting same-generation contents, missing sectors, reversed age/index and valid-CRC semantic counter regressions. Never silently choose a convenient older state while claiming complete synchronization. CRC protects accidental corruption, not hostile forgery.
5. **Sequence/geometry arithmetic.** Exercise capacity1/minimum geometry, nonmultiple/oversized geometry, overflow-prone offsets, UINT64_MAX sequence/serial/generation exactly once, clock regression, invalid PID/ECU/status/raw0/64/65 and output capacity0/exact/short. Detect all out-of-bounds IO with the simulator and ASan/UBSan.
6. **Client/query behavior.** Compare pages before/after ACK for two independent cursors and multiple sessions; exercise cursor ahead, fully evicted SID, empty current session, overwritten prefix, raw64/u64max budget and conservative degraded-media results. Compare shared golden pages with the existing RAM/COW producer when semantics overlap.
7. **Cost and operational boundary.** Count program/erase/read calls for non-rollover append and rollover separately, including scans/readback. Verify writes do not copy all retained data per append. Report bounded memory and nested stack, capacity/retention cost and wear amplification using the actual development format; do not assert a physical endurance, throughput5Hz, OTA fit or partition size from RAM simulation.

## Implementation status

The owner implemented `ag_journal_history.h`, `journal_history.c` and `test_journal_history.c`; `docs/firmware/JOURNAL_HISTORY.md` is the owner's documentation deliverable. Geometry is4KiB sectors with header128,30append entries128 and footer intent128. The footer intent is committed in the current sector before erasing the victim and defines logical eviction. Risks communicated to the owner: keep intent outside its victim, bind victim index/generation and serial/loss/session state, ignore partial intent, reject future/conflicting intent, and avoid resurrecting logically evicted data after incomplete target-header creation. Findings below refer to the final bitmap/witness source reviewed, not the first draft.

The stable FW-10 header has been read. Its READ_ONLY contract denies operational pages and ACK rather than returning a potentially older diagnostic page as complete history. The owner was also asked to distinguish control-entry serials from sample counts and test control-only/empty-session rollover, plus preserve global cursor-ahead/session-retention checks while exporting bounded typed windows compatible with `ag_history_snapshot_valid()`.

Pre-test source review of the first complete `journal_history.c` finds the expected structure: headers bind generation/index/geometry and serial position; entries distinguish samples from session-start controls; sector replay validates contiguous serials and per-session sequence/time; a full-sector footer stores the next generation, exact victim generation/index, retained boundary, sample-eviction count and session state before destructive IO. Startup validates the chronological sector chain and denies operational use when ambiguous. Pending intent can exclude a logically evicted intact victim before physical erase; a fully erased authorized victim is distinguished from a missing retained sector. Torn/unknown sectors remain read-only rather than being automatically erased. These are source observations, not completed fault-injection results.

The logical capacity is30entries/sector, including control entries, and reclaim drops a whole oldest sector. It is not a guarantee of30samples/sector under repeated empty sessions or a constant single-record eviction policy. Global serials order both kinds, so `evicted_samples` cannot be inferred from serial subtraction. Operational queries scan global session state before constructing at most16records for the shared serializer, including global cursor-ahead checks. Final test results are recorded below.

Baseline independently rerun in a temporary host directory: existing COW tests pass8groups,2267simulated IO cuts and6shared golden cases/12pages with ASan/UBSan and warnings as errors. This establishes the existing oracle only; it is not a FW-10 test result. No shared build directory or production CMake was used.

## Final format and findings

No unresolved concrete P0/P1 defect was identified in the reviewed final source under the serialized trusted-IO contract. This is not a production activation gate.

Before freeze, the firmware owner identified an actual recovery ambiguity: an entire ACKed last entry or newest header becoming0xff could resemble an unused tail, permitting silent rollback. The corrected format reserves an entry with duplicated monotone bitmaps at header112..119 before writing its body/marker. Header static CRC covers0..111; the independent scan rejects duplicate mismatch, noncanonical bit pattern or reservation count different from canonical committed entries. A reserved but absent entry produces READ_ONLY rather than a reused sequence.

Rollover additionally sets duplicated creation witnesses in the predecessor's committed footer before creating the next header. Static footer CRC excludes mutable witness88..95 and binds the intended victim, successor/index/geometry, sample eviction and canonical prior session state. Witness mismatch is degraded. A latest footer with a creation witness but missing/invalid successor cannot recreate a convenient empty header. Static intent remains recognized for logical eviction even when its witness is torn, so an ambiguous creation cannot resurrect already-evicted samples. Entire-media loss remains indistinguishable from never-used blank storage; bootstrap is explicit and fresh trusted SID remains mandatory.

The closing review verified bitmap/witness ordering in source and reproduced the ACKed-loss cases below. Partial entry/metadata writes conservatively disable operational pages and writes. This may halt logging after interruption and requires a separate explicit recovery policy; the review does not reinterpret READ_ONLY as successful autonomous recovery.

## Independently executed FW-10 checks

All host builds below used the actual production `journal_history.c`, `history.c` and existing RAM flash simulator, C11 warnings as errors, ASan and UBSan. No shared/SDK build directory was used.

- The owner's final eight-group journal suite independently passed:2573 IO cuts, every programmed-byte boundary including bitmap/witness/body/markers plus read/erase boundaries;8192single-byte XOR1 corruption positions; rollover, controls/empty sessions, exact loss, ACK without deletion, terminal uint64, geometry and output bounds. The8192positions are byte positions with one bit toggled at each, not all65536individual bit positions. Three added groups also cover all bootstrap program-byte cuts, the ACKed entry/header/sector erasure regression, and committed-intent resume from intact/fully erased victim without double-counted eviction. No algorithm change followed the reviewed bitmap/witness freeze.
- Independent480-operation four-sector model passed. Its expected global serial, generation and FIFO retention boundary were calculated from operation count, not copied from journal metadata. It mixed samples with distinct session-start controls, including consecutive controls/empty sessions; checked byte-exact pages at cursors0/2/UINT64_MAX for recent sessions and reopened every13operations. This exercises repeated rollover beyond the two-sector owner suite.
- Independent destructive ambiguity checks first appended/ACKed31samples, then set the newest committed entry, entire newest4KiBsector, or newest header plus used tail to0xff. Reopen returned READ_ONLY/CORRUPT and operational page/ACK did not succeed. A fully erased entire configured medium returned EMPTY and did not attach a writer; there is no claim that complete media erasure can be detected without external evidence.
- All6shared pagination fixtures/12pages matched byte for byte, including raw64, timeout metadata, >2^53 precision, uint64 terminal, empty session and overwritten prefix. To model the small-ring overwrite fixture on sector-granular storage,27distinct filler controls plus the target session-start placed target samples1/2at the end of the victim; later controls triggered reclaim while samples3..6remained. This creates the fixture's exact loss1..2without pretending the journal has configurable four-record physical capacity.

Initially the review-only drivers were compiled/executed in temporary host paths. Following explicit coordinator authorization, the independent480-operation model and all6fixture/12page golden comparisons were ported to `firmware/tests/test_journal_golden.c` and independently rerun with ASan/UBSan; both groups pass. It uses the existing generated `history_fixture.h`; the coordinator owns CMake registration. The owner's durable failure-injection suite remains `test_journal_history.c`. Key review reproducer: bootstrap two sectors, append and ACK31samples, overwrite bytes `[4096+128,4096+256)` or the whole second sector with0xff, reopen, and require non-operational page/ACK. The final bitmap/witness implementation satisfies this oracle.

## Limits and next boundary

At512sectors the format has15360entry slots (2MiB H), including controls, rather than a promise of seven hours. With only samples at5Hz, the upper slot-count duration is3072seconds/51min12s; actual session controls and whole-sector reclaim reduce it. This is format arithmetic, not a frozen partition/retention decision. The observed host store metadata size is5776bytes, fixed by512-sector arrays. No heap or whole-log recopy is used.

A non-rollover append scans the current sector, reserves8bitmap bytes and writes128entry bytes in four program calls with no erase; rollover adds intent/header/witness and at most one victim erase. These are callback-level model costs, not flash endurance/latency or electrical measurements. Repeated partial programming of bitmap/witness words, flash encryption alignment, erase behavior and real power interruption must be qualified for the selected component/driver. Wear-level lifetime and sustained5Hz remain unproven.

`ag_journal_make_page()` and `ag_journal_window()` have nested fixed-size snapshots (each6200bytes on this host), plus helper and serializer stack. The default app_main stack is not qualified; actual target high-water/latency/stack and owner scheduling must be measured before runtime integration. Trusted fresh boot/SID generation, provisioning, physical flash IO/partition, OTA sizing and the approved logger's≤1Hz/PID ingestion policy are separate work. CRC and monotone reservations detect the modeled accidental faults; they are not authenticated storage or proof against correlated arbitrary rewriting. Session freshness beyond fully evicted history remains caller responsibility. These tests do not supply a physical backend, radio connection or automatic repair of degraded media.

## Follow-up: typed journal-to-endpoint adapter

Read `ag_journal_endpoint.h`, `journal_endpoint.c` and `test_journal_endpoint.c`. No concrete defect identified in the intended typed `options.history_read` use. The adapter clears the caller snapshot before any read, maps journal OK/READ_ONLY/NOT_RETAINED/CURSOR_AHEAD explicitly, and maps other failures to UNAVAILABLE. It does not turn unknown/evicted SID into a misleading complete empty page. Null context/output cannot produce success. `ag_journal_window()` assigns its candidate only on success, so an error cannot resurrect a prior client's snapshot. Normal query may poison a corrupt store's in-memory readiness; that is conservative state invalidation, not a flash repair/write.

Independently compiled actual adapter/journal/history and existing flash simulator with C11 warnings as errors, ASan and UBSan in a temporary directory; `test_journal_endpoint.c` passes. Checks cover retained window16, exact loss1..30, tail page and cursor completion, cursor-ahead, unknown SID, querying after reopen without writer attachment, old/new session coexistence, short-read failure, corruption→READ_ONLY, output clearing and zero program/erase calls from read queries. No production source, CMake/shared build or hardware was modified. This validates the callback boundary, not a radio roundtrip or physical persistence.
