Ale1x/auto-gauge/docs/validation/ios/APP09/simulator-history.png

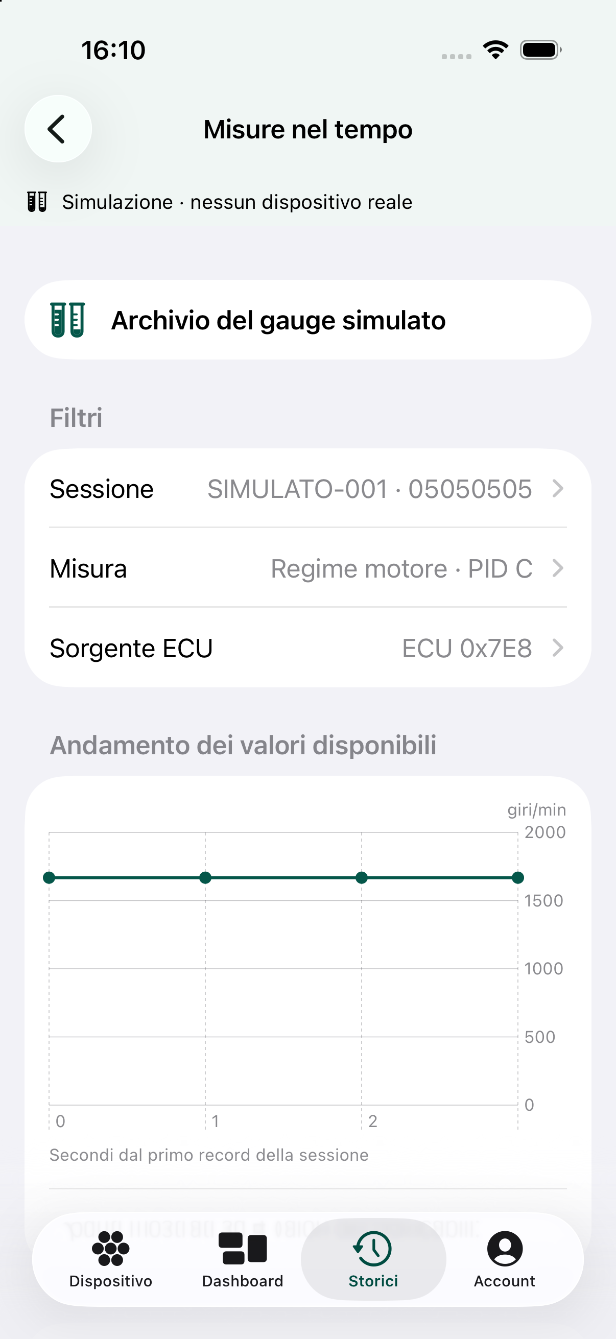
docs/validation/ios/APP09/simulator-history.png
