Ale1x/auto-gauge/hardware/exports/auto_gauge_A0.pdf

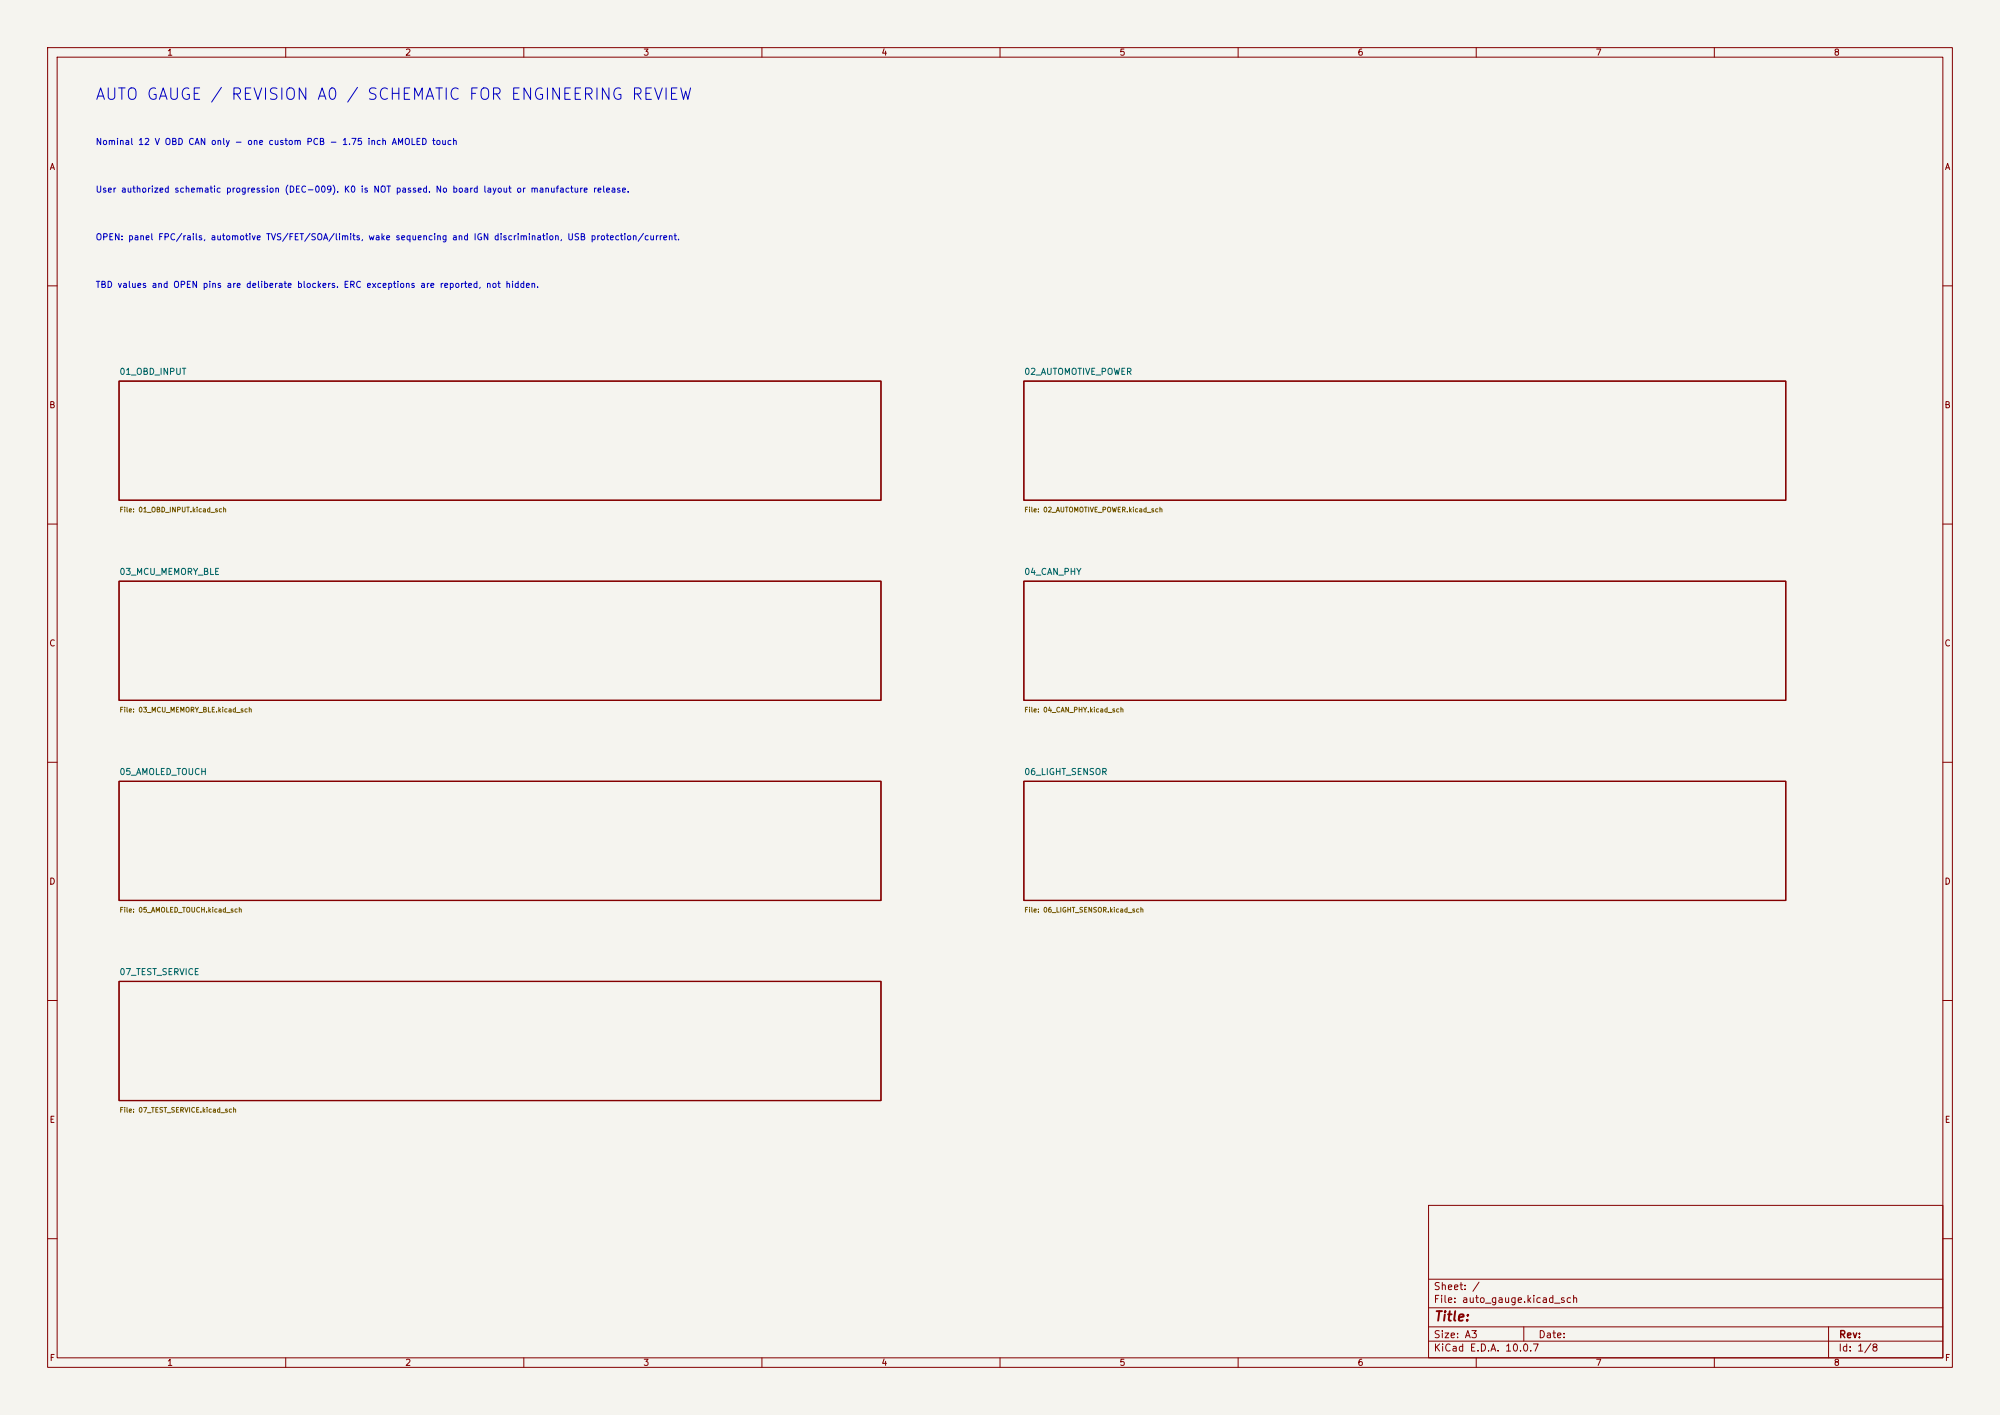
[picture p103: page 1]

AUTO GAUGE / REVISION A0 / SCHEMATIC FOR ENGINEERING REVIEW

Nominal 12 V OBD CAN only - one custom PCB - 1.75 inch AMOLED touch User authorized schematic progression (DEC-009). K0 is NOT passed. No board layout or manufacture release. OPEN: panel FPC/rails, automotive TVS/FET/SOA/limits, wake sequencing and IGN discrimination, USB protection/current. TBD values and OPEN pins are deliberate blockers. ERC exceptions are reported, not hidden.

Size: A3 | Rev: | F Date:
KiCad E.D.A. 10.0.7 | Id: 1/8

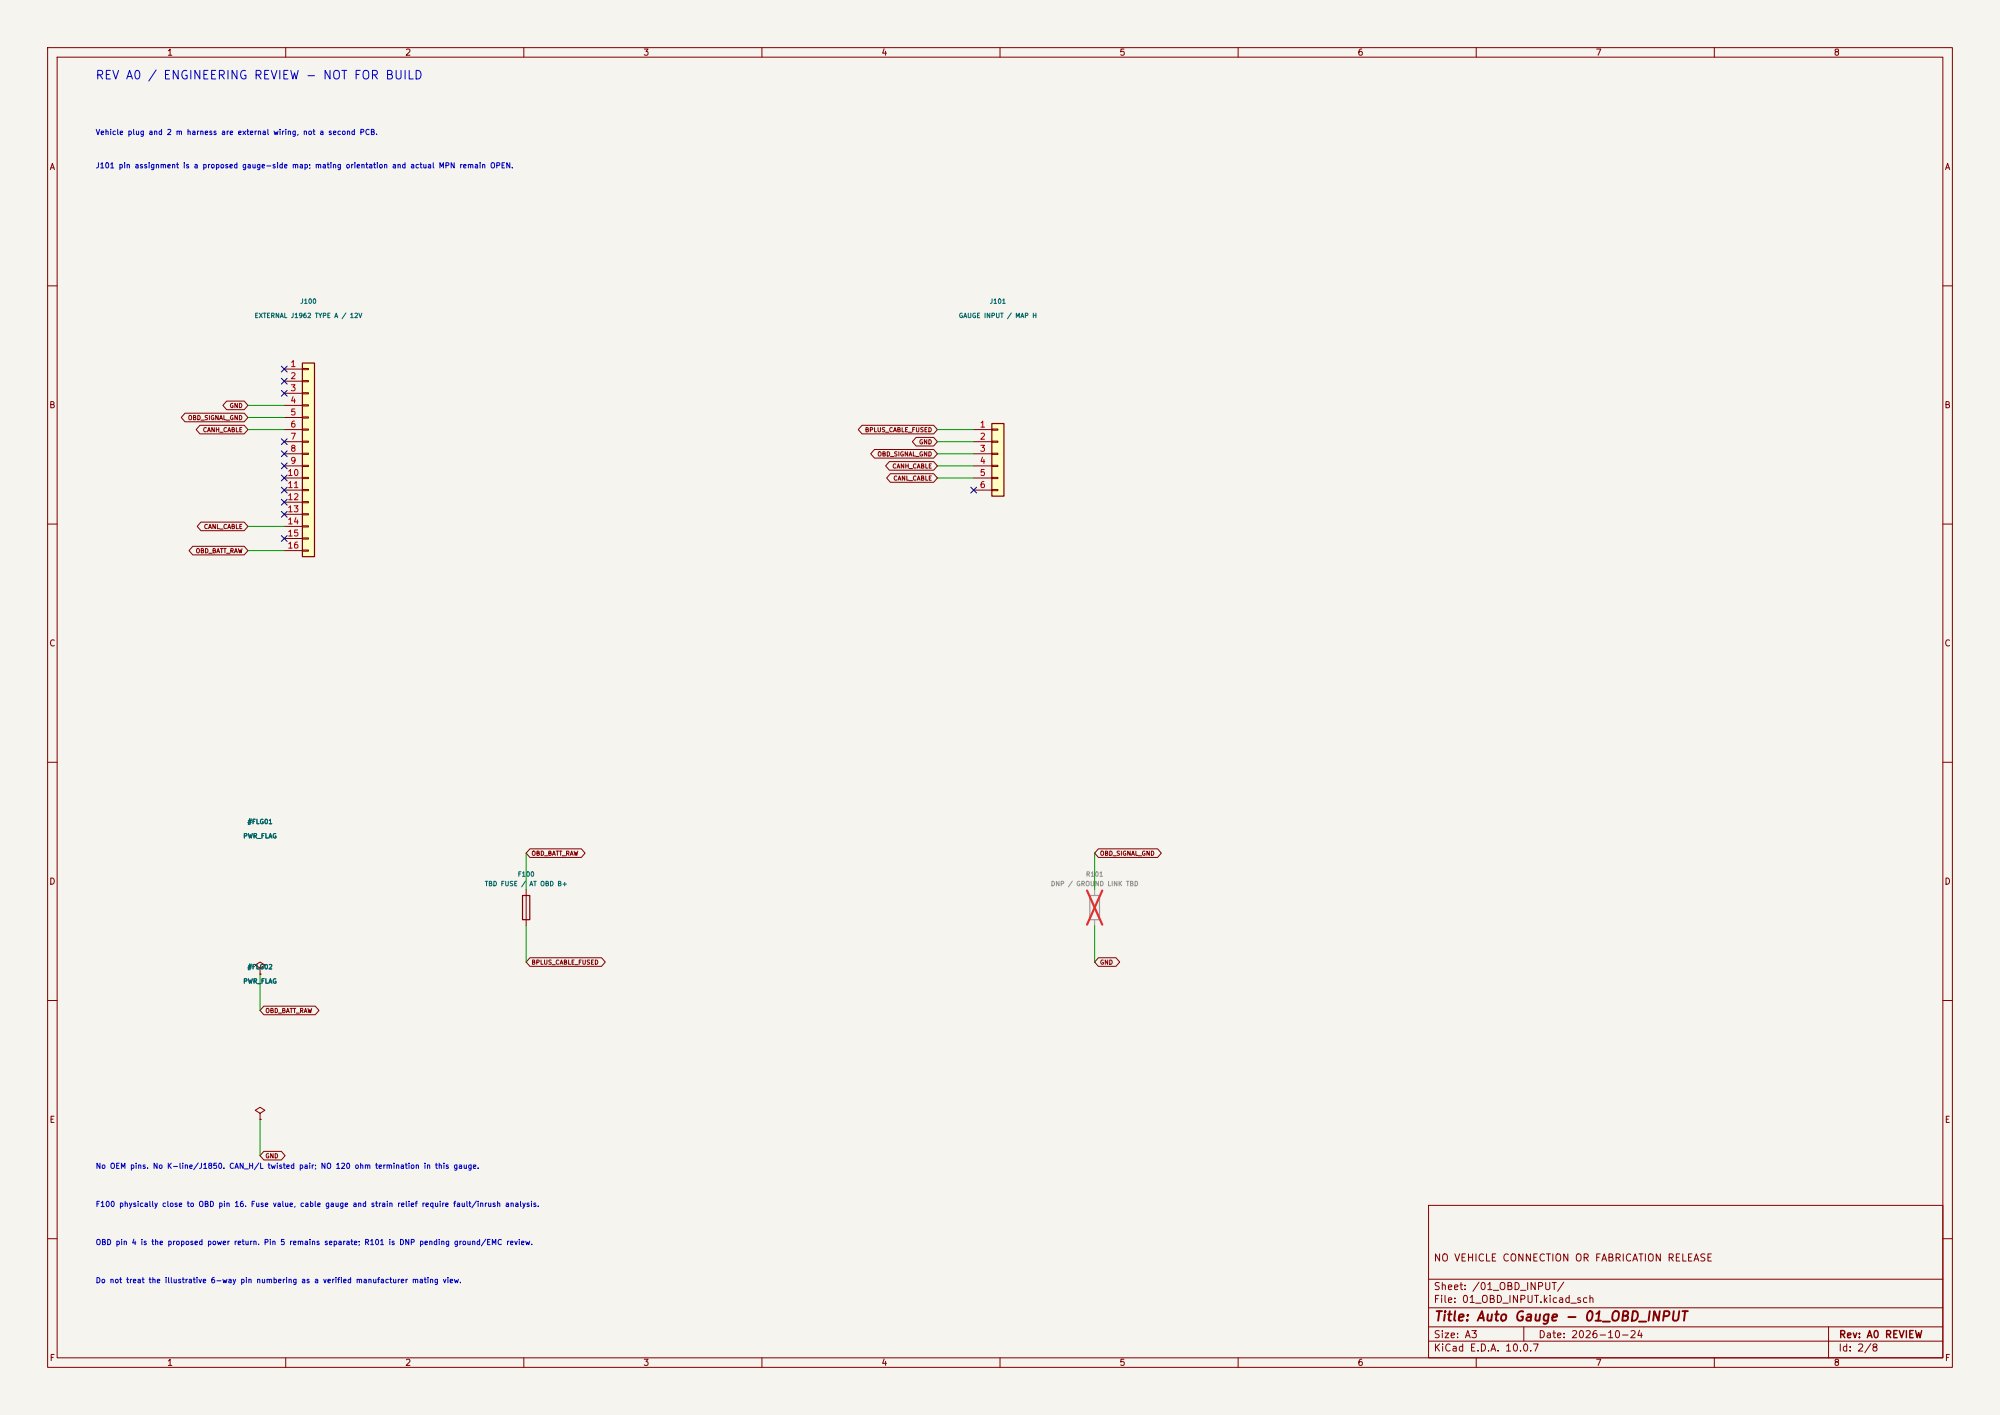
[picture p104: page 2]

J101 pin assignment is a proposed gauge-side map; mating orientation and actual MPN remain OPEN. REV A0 / ENGINEERING REVIEW - NOT FOR BUILD

Vehicle plug and 2 m harness are external wiring, not a second PCB.

R101 DNP / GROUND LINK TBD

Do not treat the illustrative 6-way pin numbering as a verified manufacturer mating view. OBD pin 4 is the proposed power return. Pin 5 remains separate; R101 is DNP pending ground/EMC review. F100 physically close to OBD pin 16. Fuse value, cable gauge and strain relief require fault/inrush analysis. No OEM pins. No K-line/J1850. CAN_H/L twisted pair; NO 120 ohm termination in this gauge.

NO VEHICLE CONNECTION OR FABRICATION RELEASE

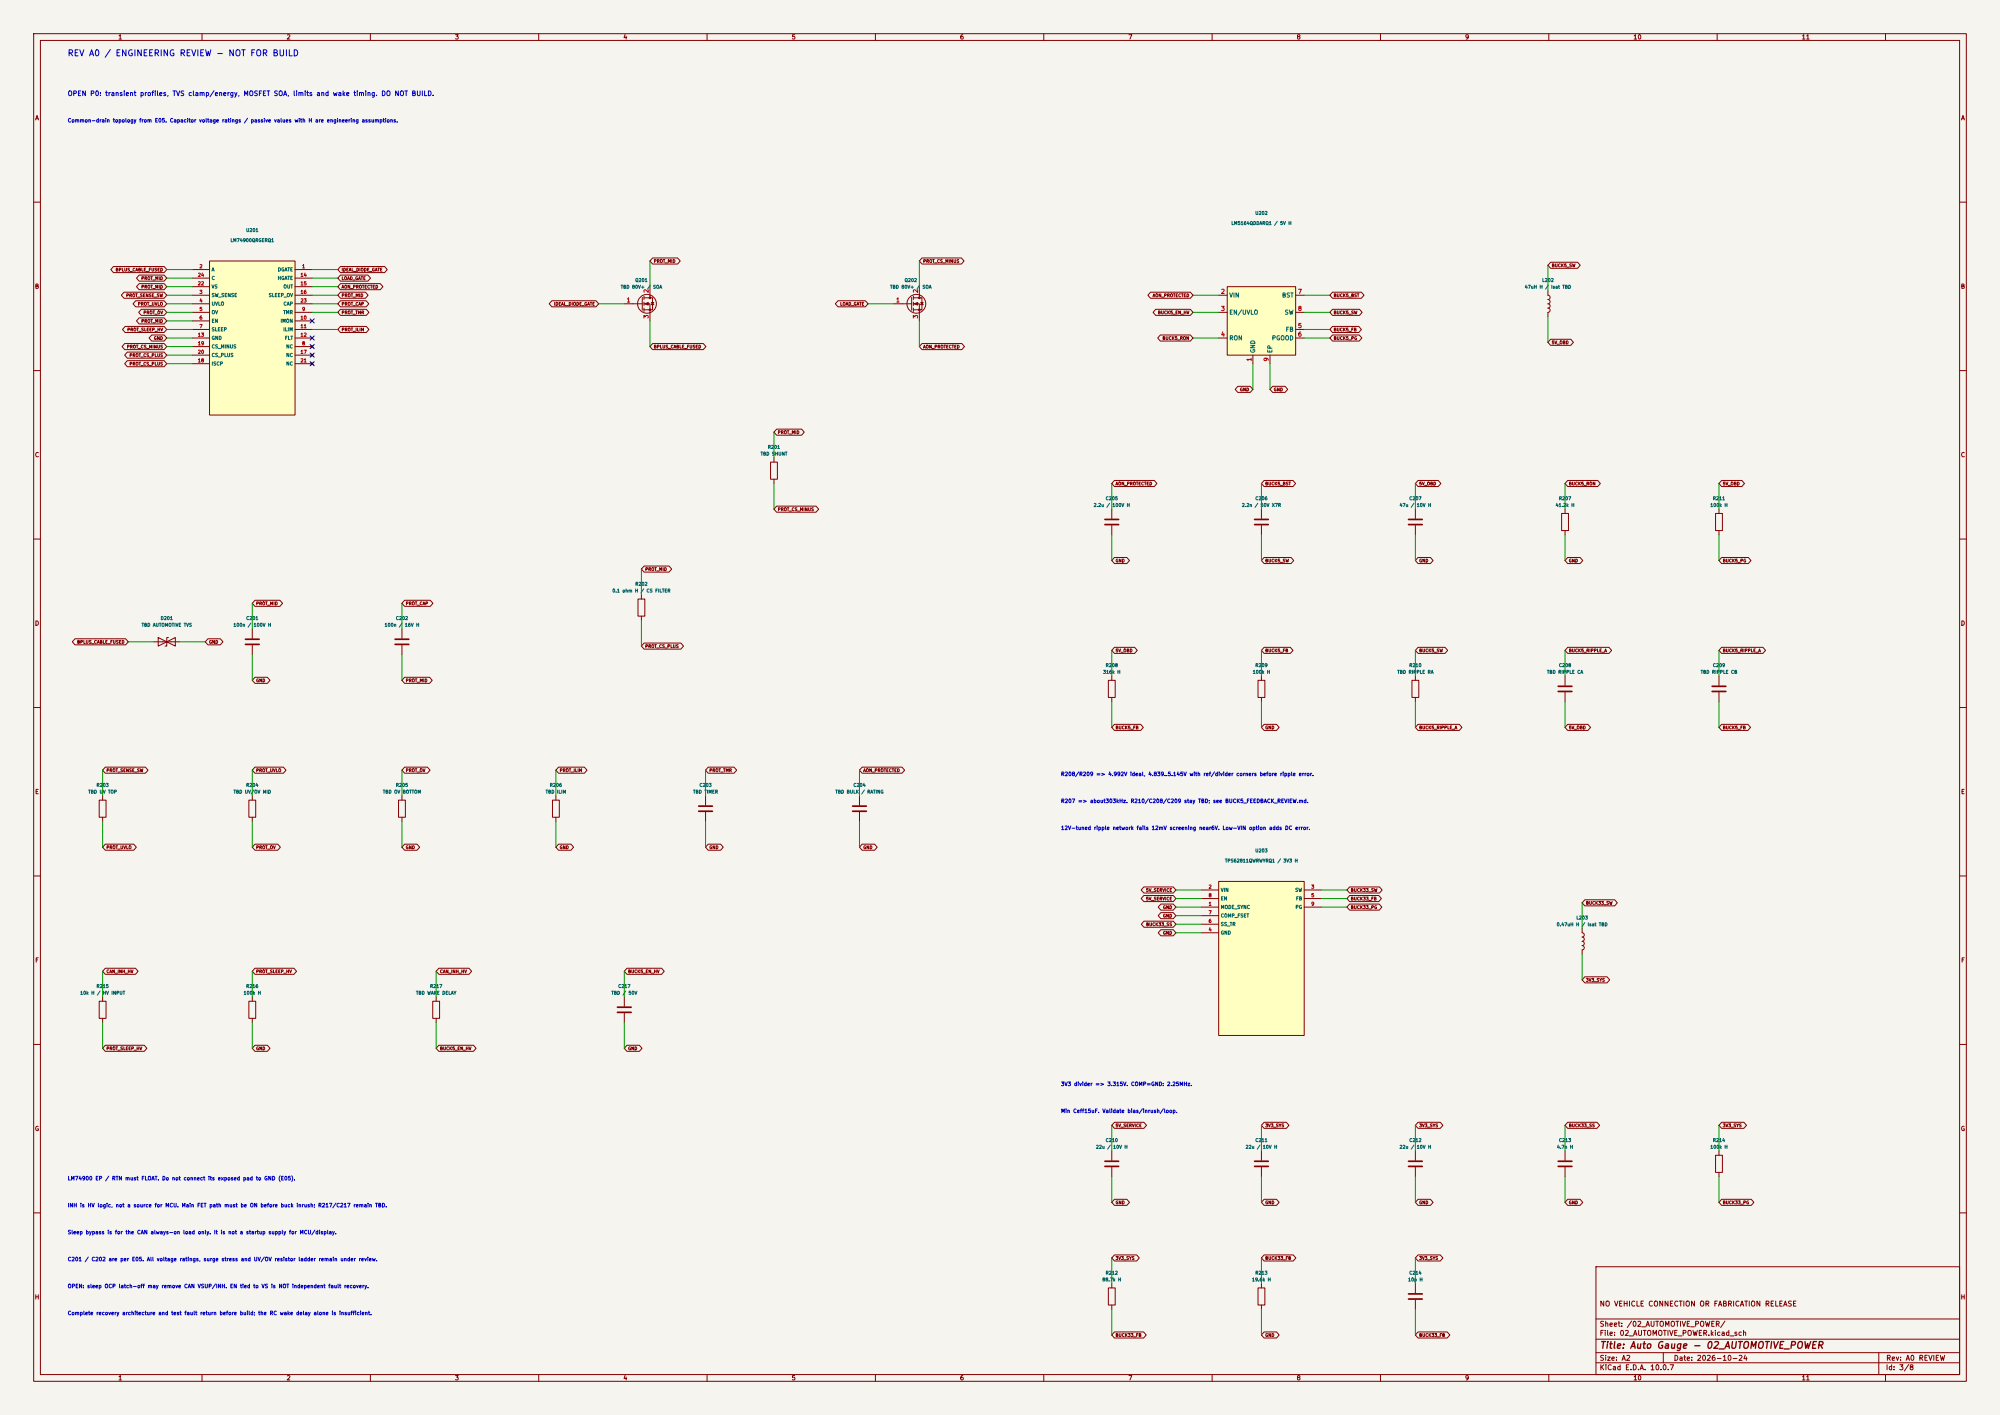
[picture p105: page 3]

Common-drain topology from E05. Capacitor voltage ratings / passive values with H are engineering assumptions. OPEN P0: transient profiles, TVS clamp/energy, MOSFET SOA, limits and wake timing. DO NOT BUILD. REV A0 / ENGINEERING REVIEW - NOT FOR BUILD

R207 => about303kHz. R210/C208/C209 stay TBD; see BUCK5_FEEDBACK_REVIEW.md. R208/R209 => 4.992V ideal, 4.839..5.145V with ref/divider corners before ripple error. 12V-tuned ripple network fails 12mV screening near6V. Low-VIN option adds DC error.

TBD UV/OV MID

GND 3V3 divider => 3.315V. COMP=GND: 2.25MHz.

LM74900 EP / RTN must FLOAT. Do not connect its exposed pad to GND (E05).

NO VEHICLE CONNECTION OR FABRICATION RELEASE

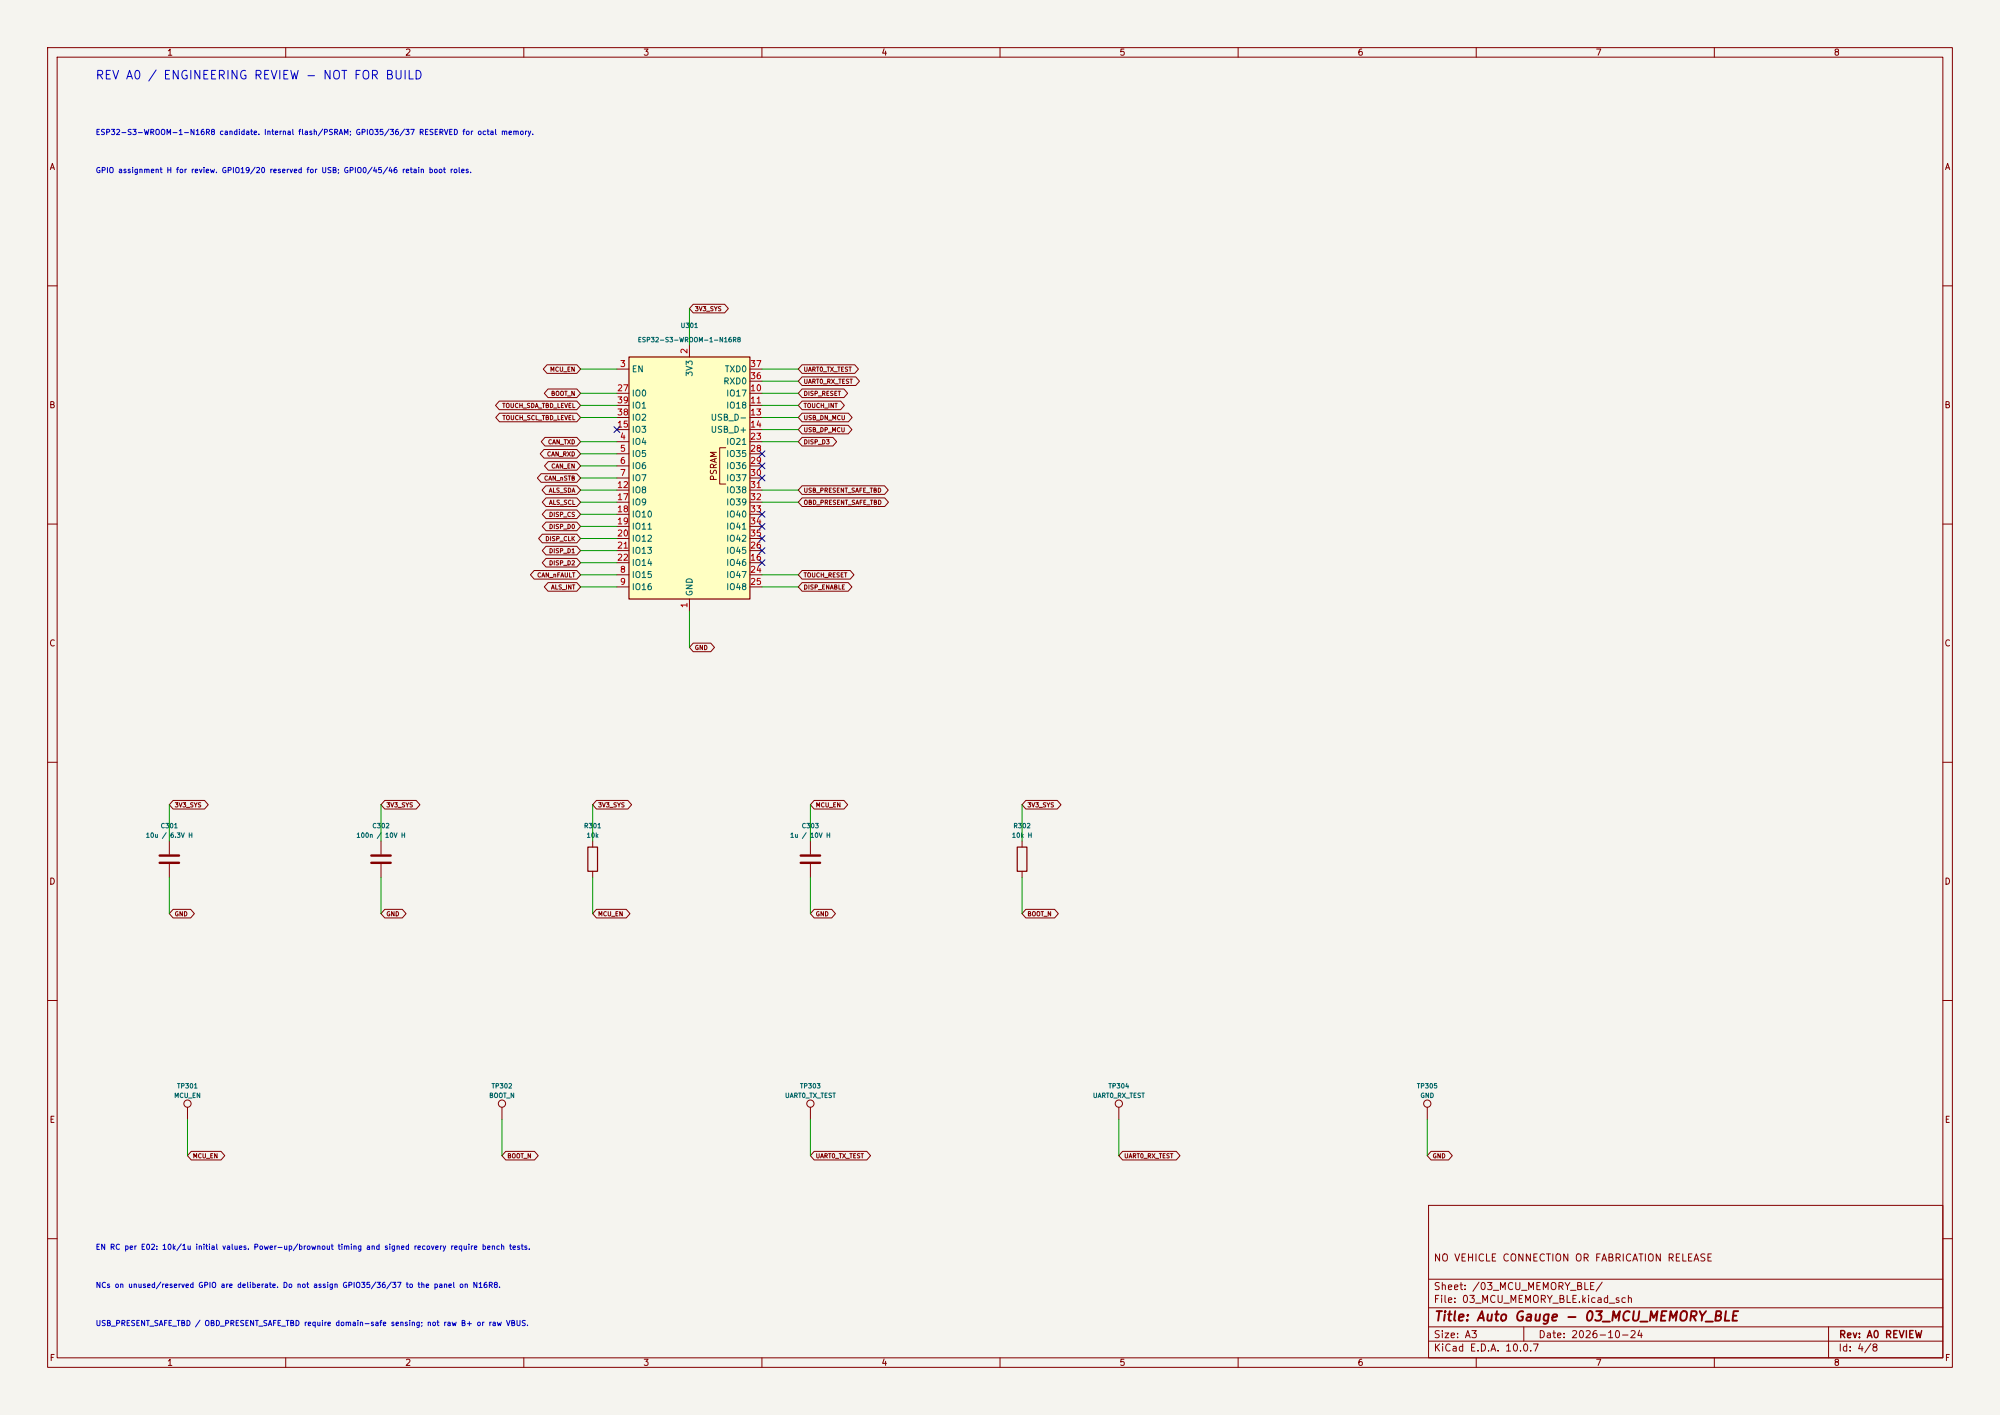
[picture p106: page 4]

GPIO assignment H for review. GPIO19/20 reserved for USB; GPIO0/45/46 retain boot roles. ESP32-S3-WROOM-1-N16R8 candidate. Internal flash/PSRAM; GPIO35/36/37 RESERVED for octal memory. REV A0 / ENGINEERING REVIEW - NOT FOR BUILD

GND EN RC per E02: 10k/1u initial values. Power-up/brownout timing and signed recovery require bench tests. NCs on unused/reserved GPIO are deliberate. Do not assign GPIO35/36/37 to the panel on N16R8. USB_PRESENT_SAFE_TBD / OBD_PRESENT_SAFE_TBD require domain-safe sensing; not raw B+ or raw VBUS.

NO VEHICLE CONNECTION OR FABRICATION RELEASE

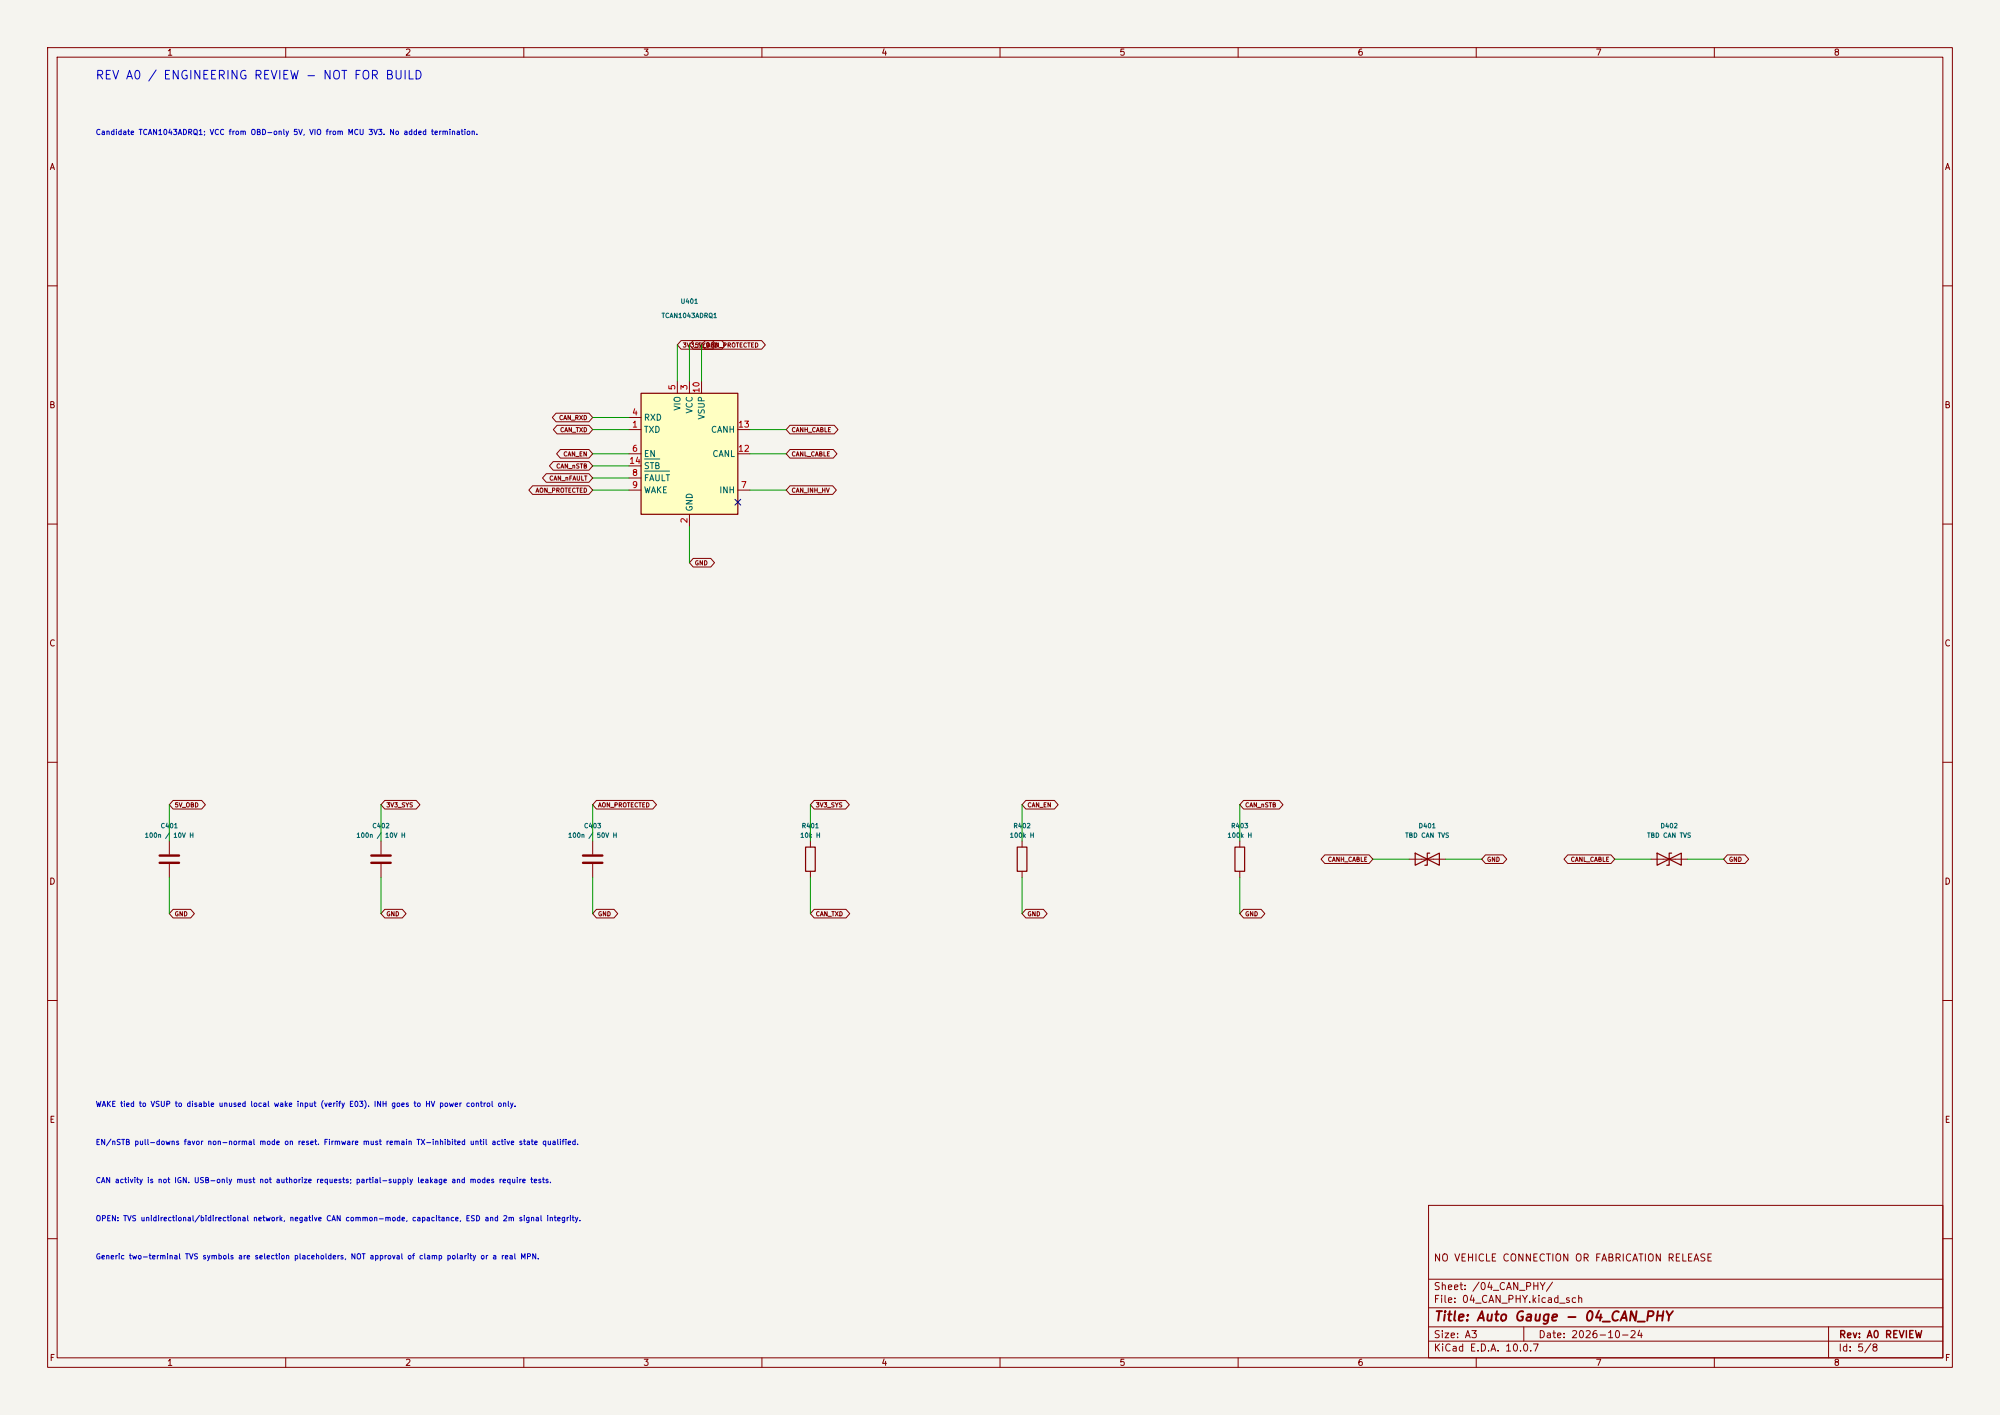
[picture p107: page 5]

REV A0 / ENGINEERING REVIEW - NOT FOR BUILD

Candidate TCAN1043ADRQ1; VCC from OBD-only 5V, VIO from MCU 3V3. No added termination.

WAKE tied to VSUP to disable unused local wake input (verify E03). INH goes to HV power control only.

Generic two-terminal TVS symbols are selection placeholders, NOT approval of clamp polarity or a real MPN. OPEN: TVS unidirectional/bidirectional network, negative CAN common-mode, capacitance, ESD and 2m signal integrity. CAN activity is not IGN. USB-only must not authorize requests; partial-supply leakage and modes require tests. EN/nSTB pull-downs favor non-normal mode on reset. Firmware must remain TX-inhibited until active state qualified.

NO VEHICLE CONNECTION OR FABRICATION RELEASE

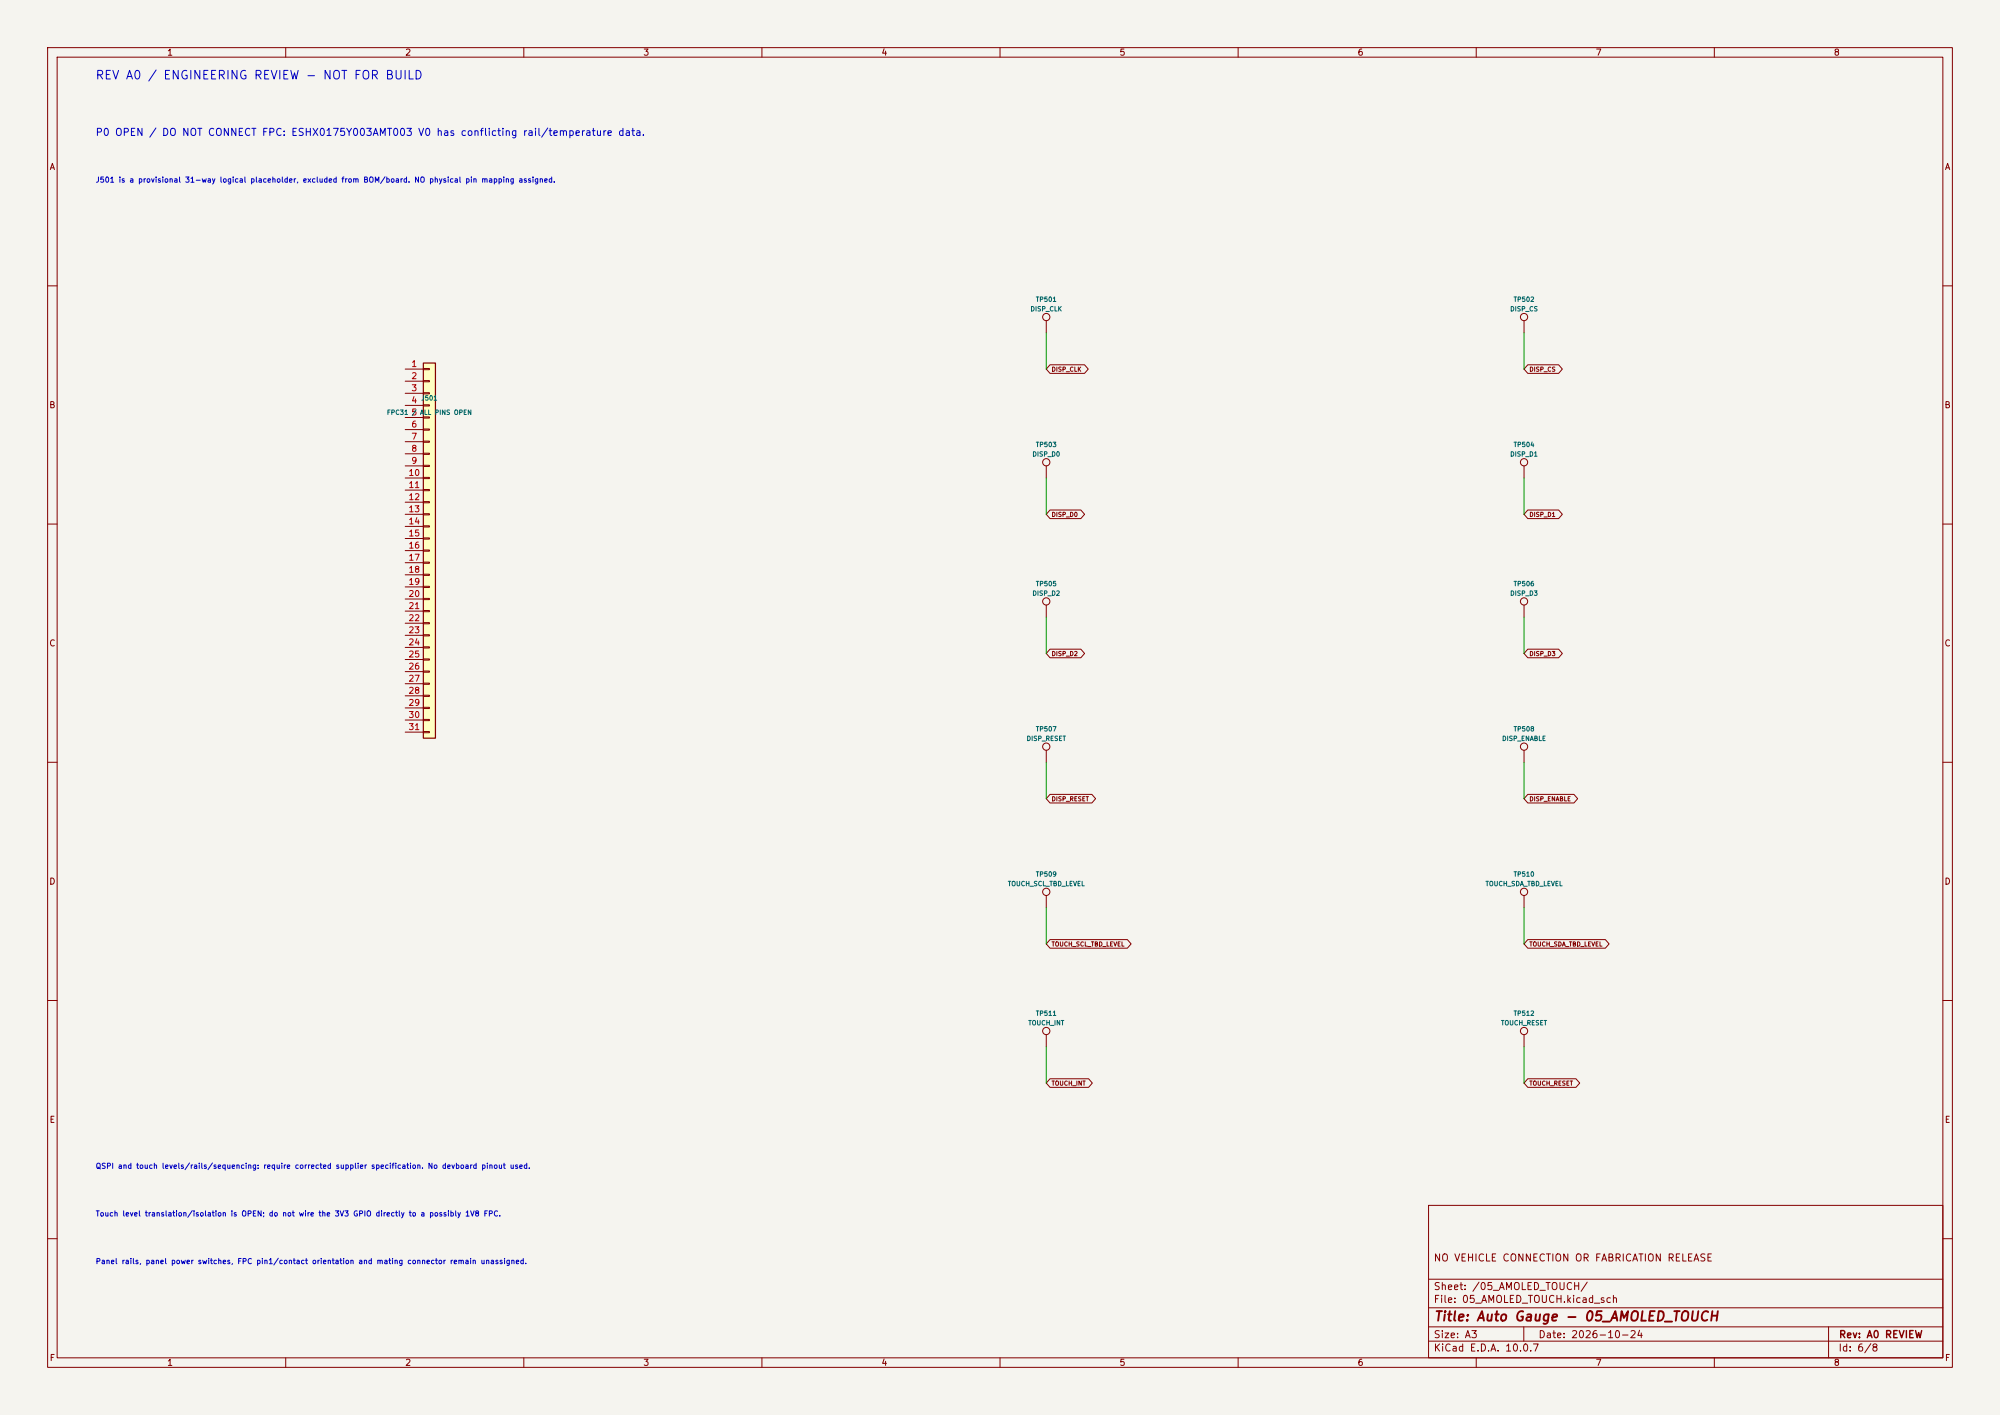
[picture p108: page 6]

REV A0 / ENGINEERING REVIEW - NOT FOR BUILD

P0 OPEN / DO NOT CONNECT FPC: ESHX0175Y003AMT003 V0 has conflicting rail/temperature data. J501 is a provisional 31-way logical placeholder, excluded from BOM/board. NO physical pin mapping assigned.

TOUCH_RESET Panel rails, panel power switches, FPC pin1/contact orientation and mating connector remain unassigned. QSPI and touch levels/rails/sequencing: require corrected supplier specification. No devboard pinout used. Touch level translation/isolation is OPEN; do not wire the 3V3 GPIO directly to a possibly 1V8 FPC.

NO VEHICLE CONNECTION OR FABRICATION RELEASE

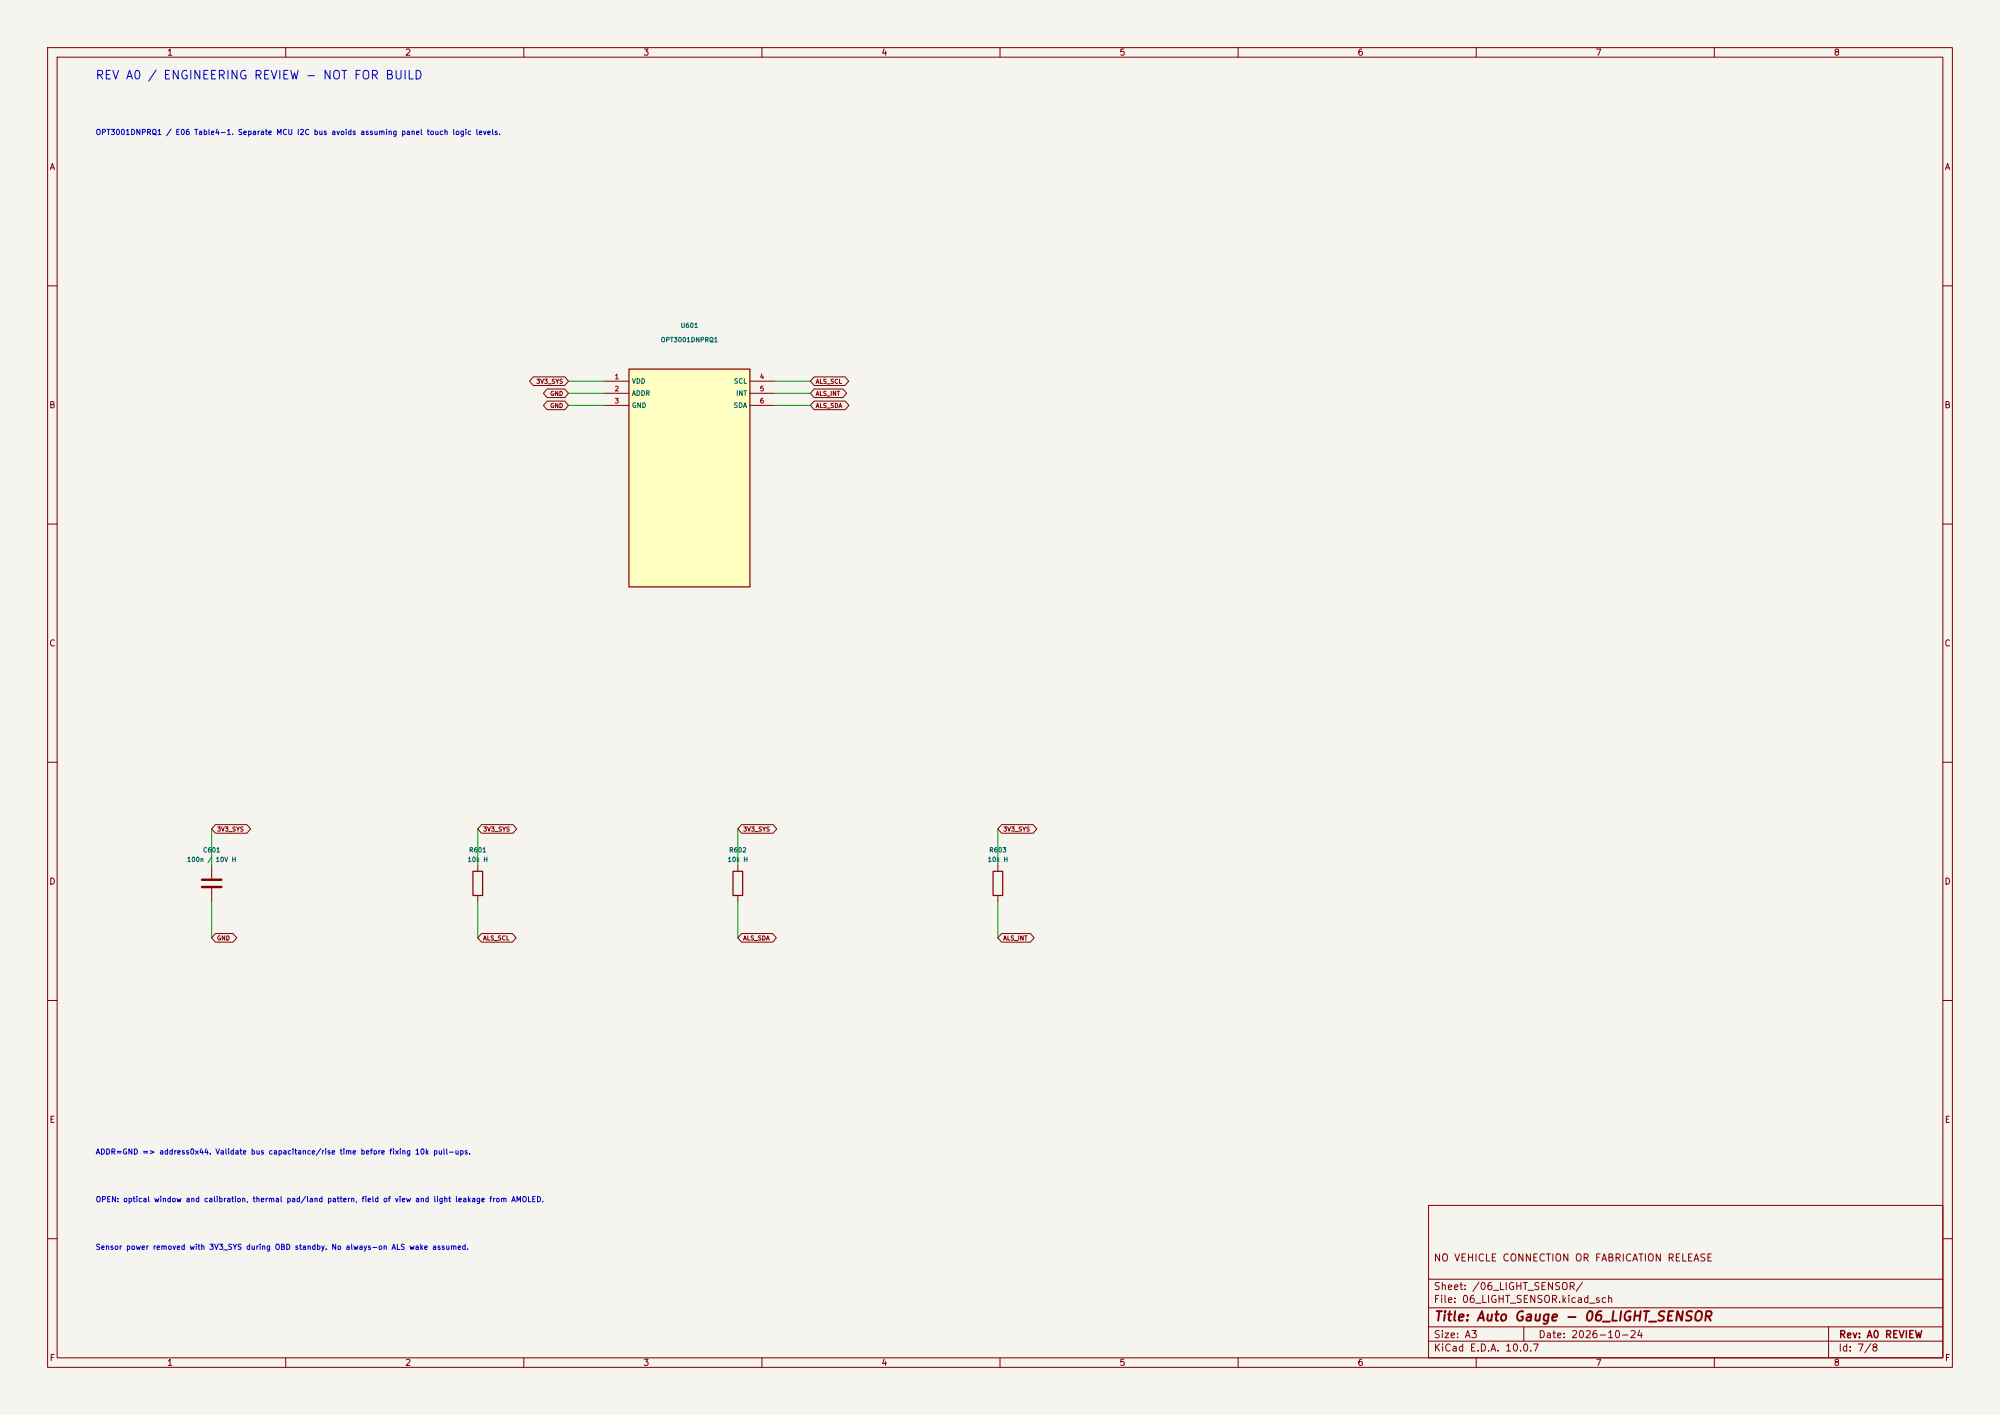
[picture p109: page 7]

OPT3001DNPRQ1 / E06 Table4-1. Separate MCU I2C bus avoids assuming panel touch logic levels. REV A0 / ENGINEERING REVIEW - NOT FOR BUILD

3V3_SYS OPEN: optical window and calibration, thermal pad/land pattern, field of view and light leakage from AMOLED. ADDR=GND => address0x44. Validate bus capacitance/rise time before fixing 10k pull-ups. Sensor power removed with 3V3_SYS during OBD standby. No always-on ALS wake assumed.

NO VEHICLE CONNECTION OR FABRICATION RELEASE

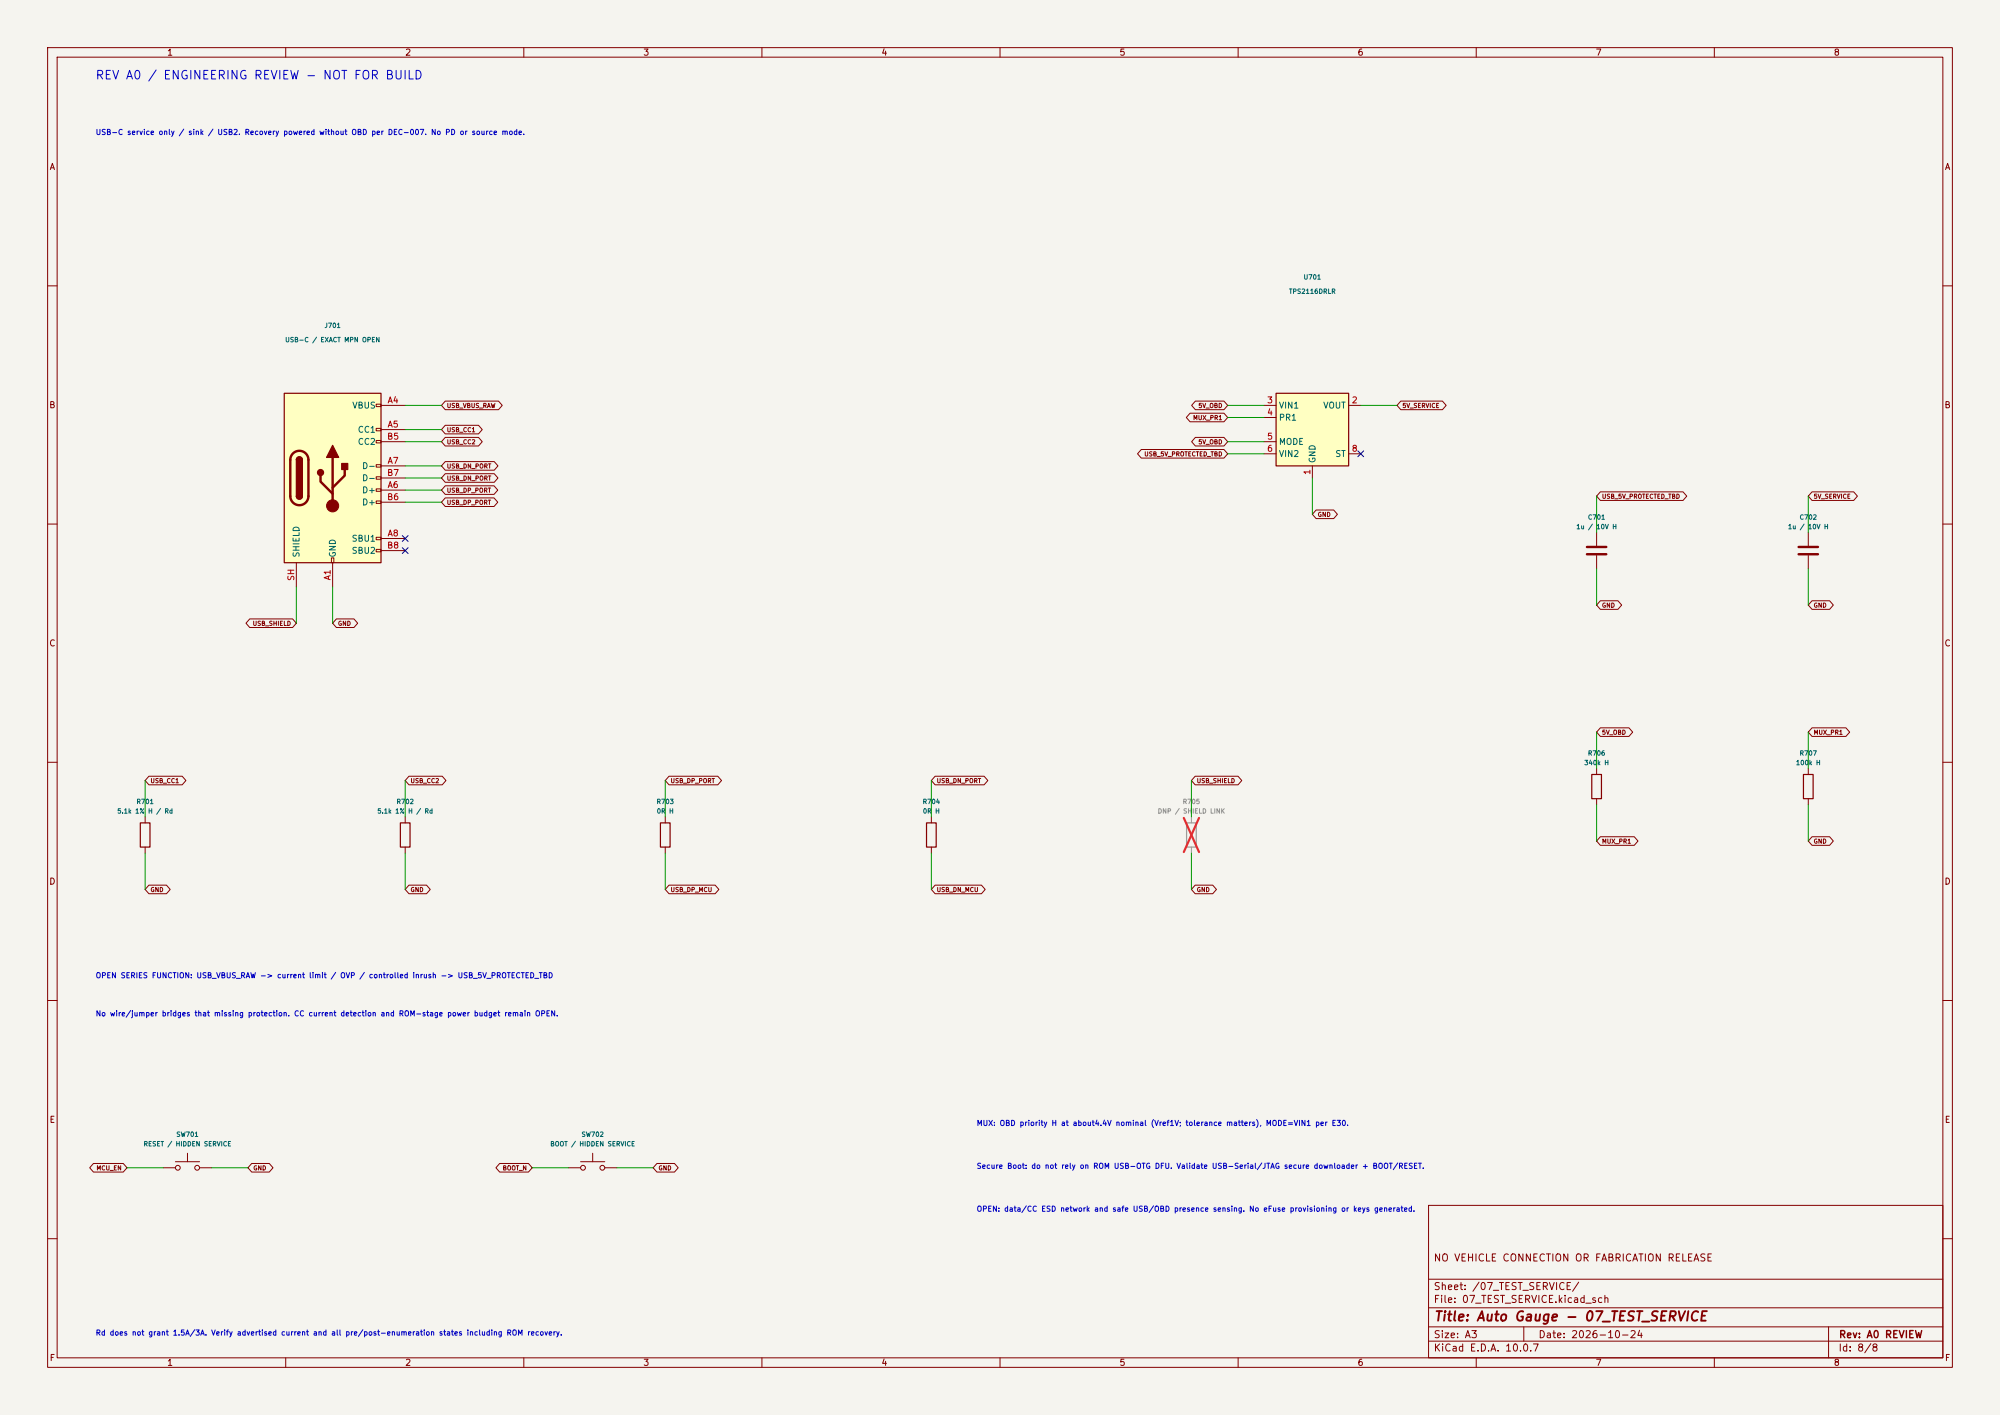
[picture p110: page 8]

REV A0 / ENGINEERING REVIEW - NOT FOR BUILD

USB-C service only / sink / USB2. Recovery powered without OBD per DEC-007. No PD or source mode.

J701 USB-C / EXACT MPN OPEN
5V_SERVICE USB_DN_PORT GND

NO VEHICLE CONNECTION OR FABRICATION RELEASE GND A1

MUX: OBD priority H at about4.4V nominal (Vref1V; tolerance matters), MODE=VIN1 per E30. Rd does not grant 1.5A/3A. Verify advertised current and all pre/post-enumeration states including ROM recovery. No wire/jumper bridges that missing protection. CC current detection and ROM-stage power budget remain OPEN. OPEN SERIES FUNCTION: USB_VBUS_RAW -> current limit / OVP / controlled inrush -> USB_5V_PROTECTED_TBD

SW702 BOOT / HIDDEN SERVICE SW701 RESET / HIDDEN SERVICE
