Ale1x/auto-gauge/hardware/01_OBD_INPUT.kicad_sch

## KiCad design hardware/01_OBD_INPUT.kicad_sch (2026-10-24)

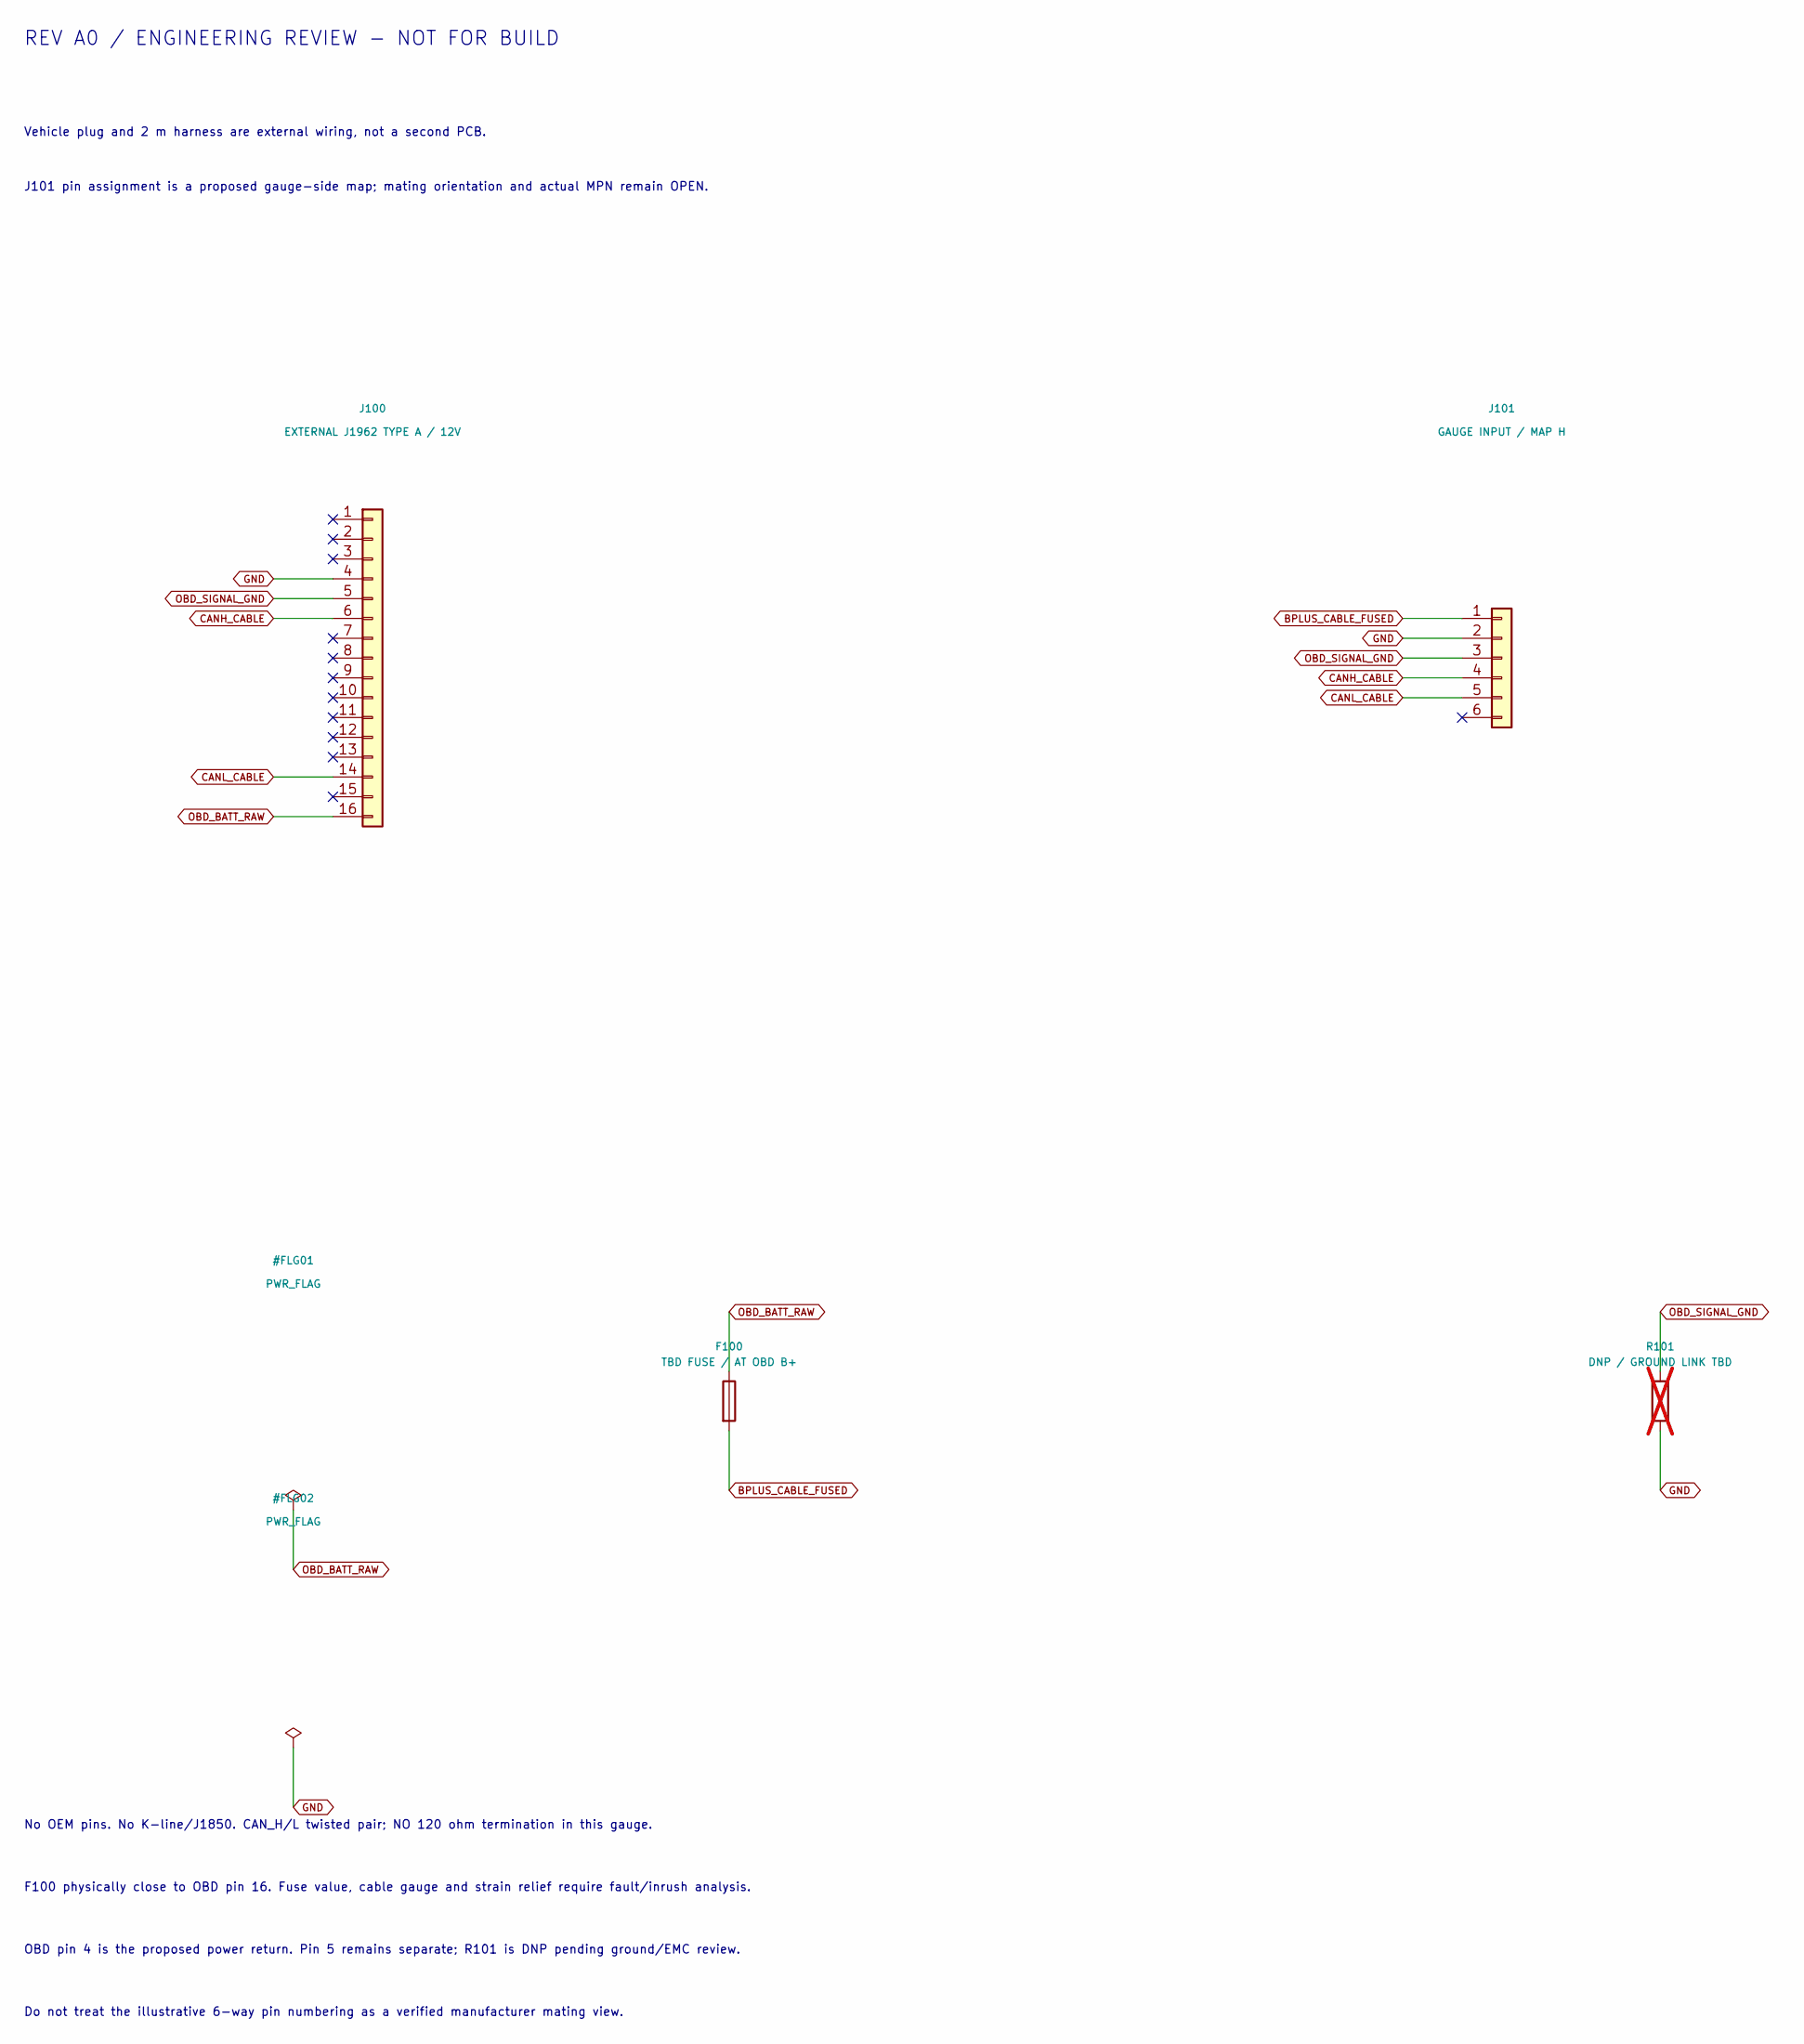
[picture p111: schematic 01_OBD_INPUT.kicad_sch]

Parts:
F100: TBD FUSE / AT OBD B+; MPN TBD
J100: EXTERNAL J1962 TYPE A / 12V; MPN TBD
J101: GAUGE INPUT / MAP H; MPN TBD
R101: DNP / GROUND LINK TBD; MPN TBD; not fitted

Connections:
BPLUS_CABLE_FUSED: F100.2, J101.1
CANH_CABLE: J100.6, J101.4
CANL_CABLE: J100.14, J101.5
GND: J100.4, J101.2, R101.2
OBD_BATT_RAW: F100.1, J100.16
OBD_SIGNAL_GND: J100.5, J101.3, R101.1

Notes on the sheet:
REV A0 / ENGINEERING REVIEW - NOT FOR BUILD
Vehicle plug and 2 m harness are external wiring, not a second PCB.
J101 pin assignment is a proposed gauge-side map; mating orientation and actual MPN remain OPEN.
No OEM pins. No K-line/J1850. CAN_H/L twisted pair; NO 120 ohm termination in this gauge.
F100 physically close to OBD pin 16. Fuse value, cable gauge and strain relief require fault/inrush analysis.
OBD pin 4 is the proposed power return. Pin 5 remains separate; R101 is DNP pending ground/EMC review.
Do not treat the illustrative 6-way pin numbering as a verified manufacturer mating view.
