Ale1x/auto-gauge/hardware/02_AUTOMOTIVE_POWER.kicad_sch

## KiCad design hardware/02_AUTOMOTIVE_POWER.kicad_sch (2026-10-24)

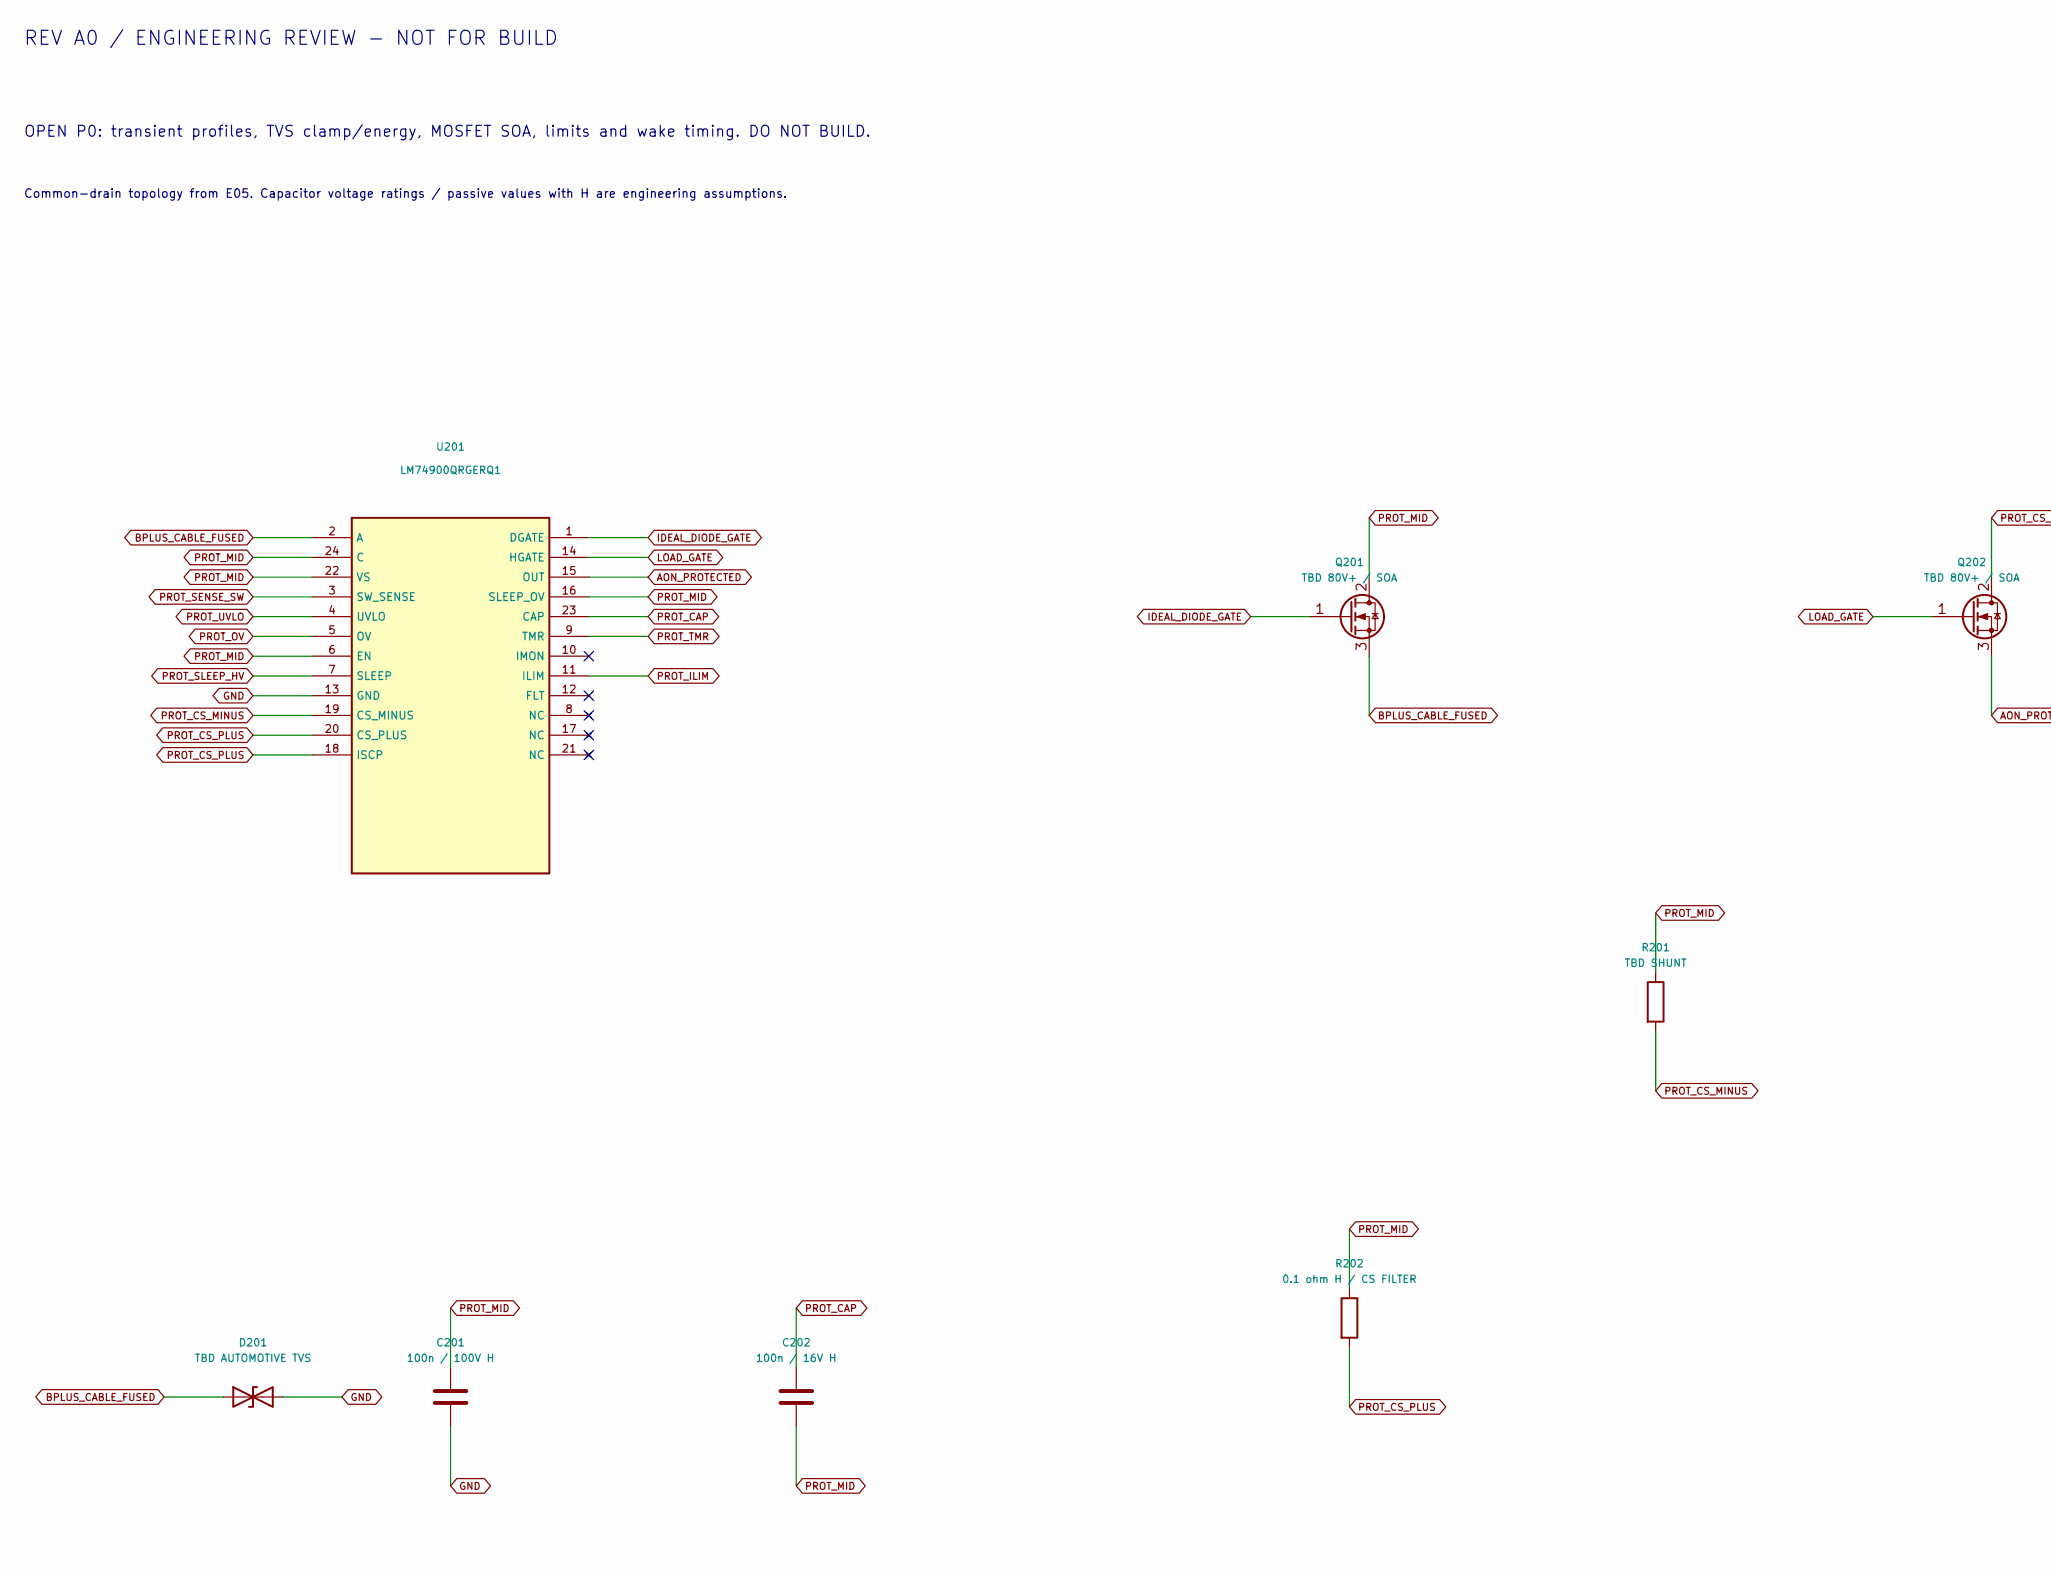
[picture p112: schematic 02_AUTOMOTIVE_POWER.kicad_sch, part in row 1, column 1]

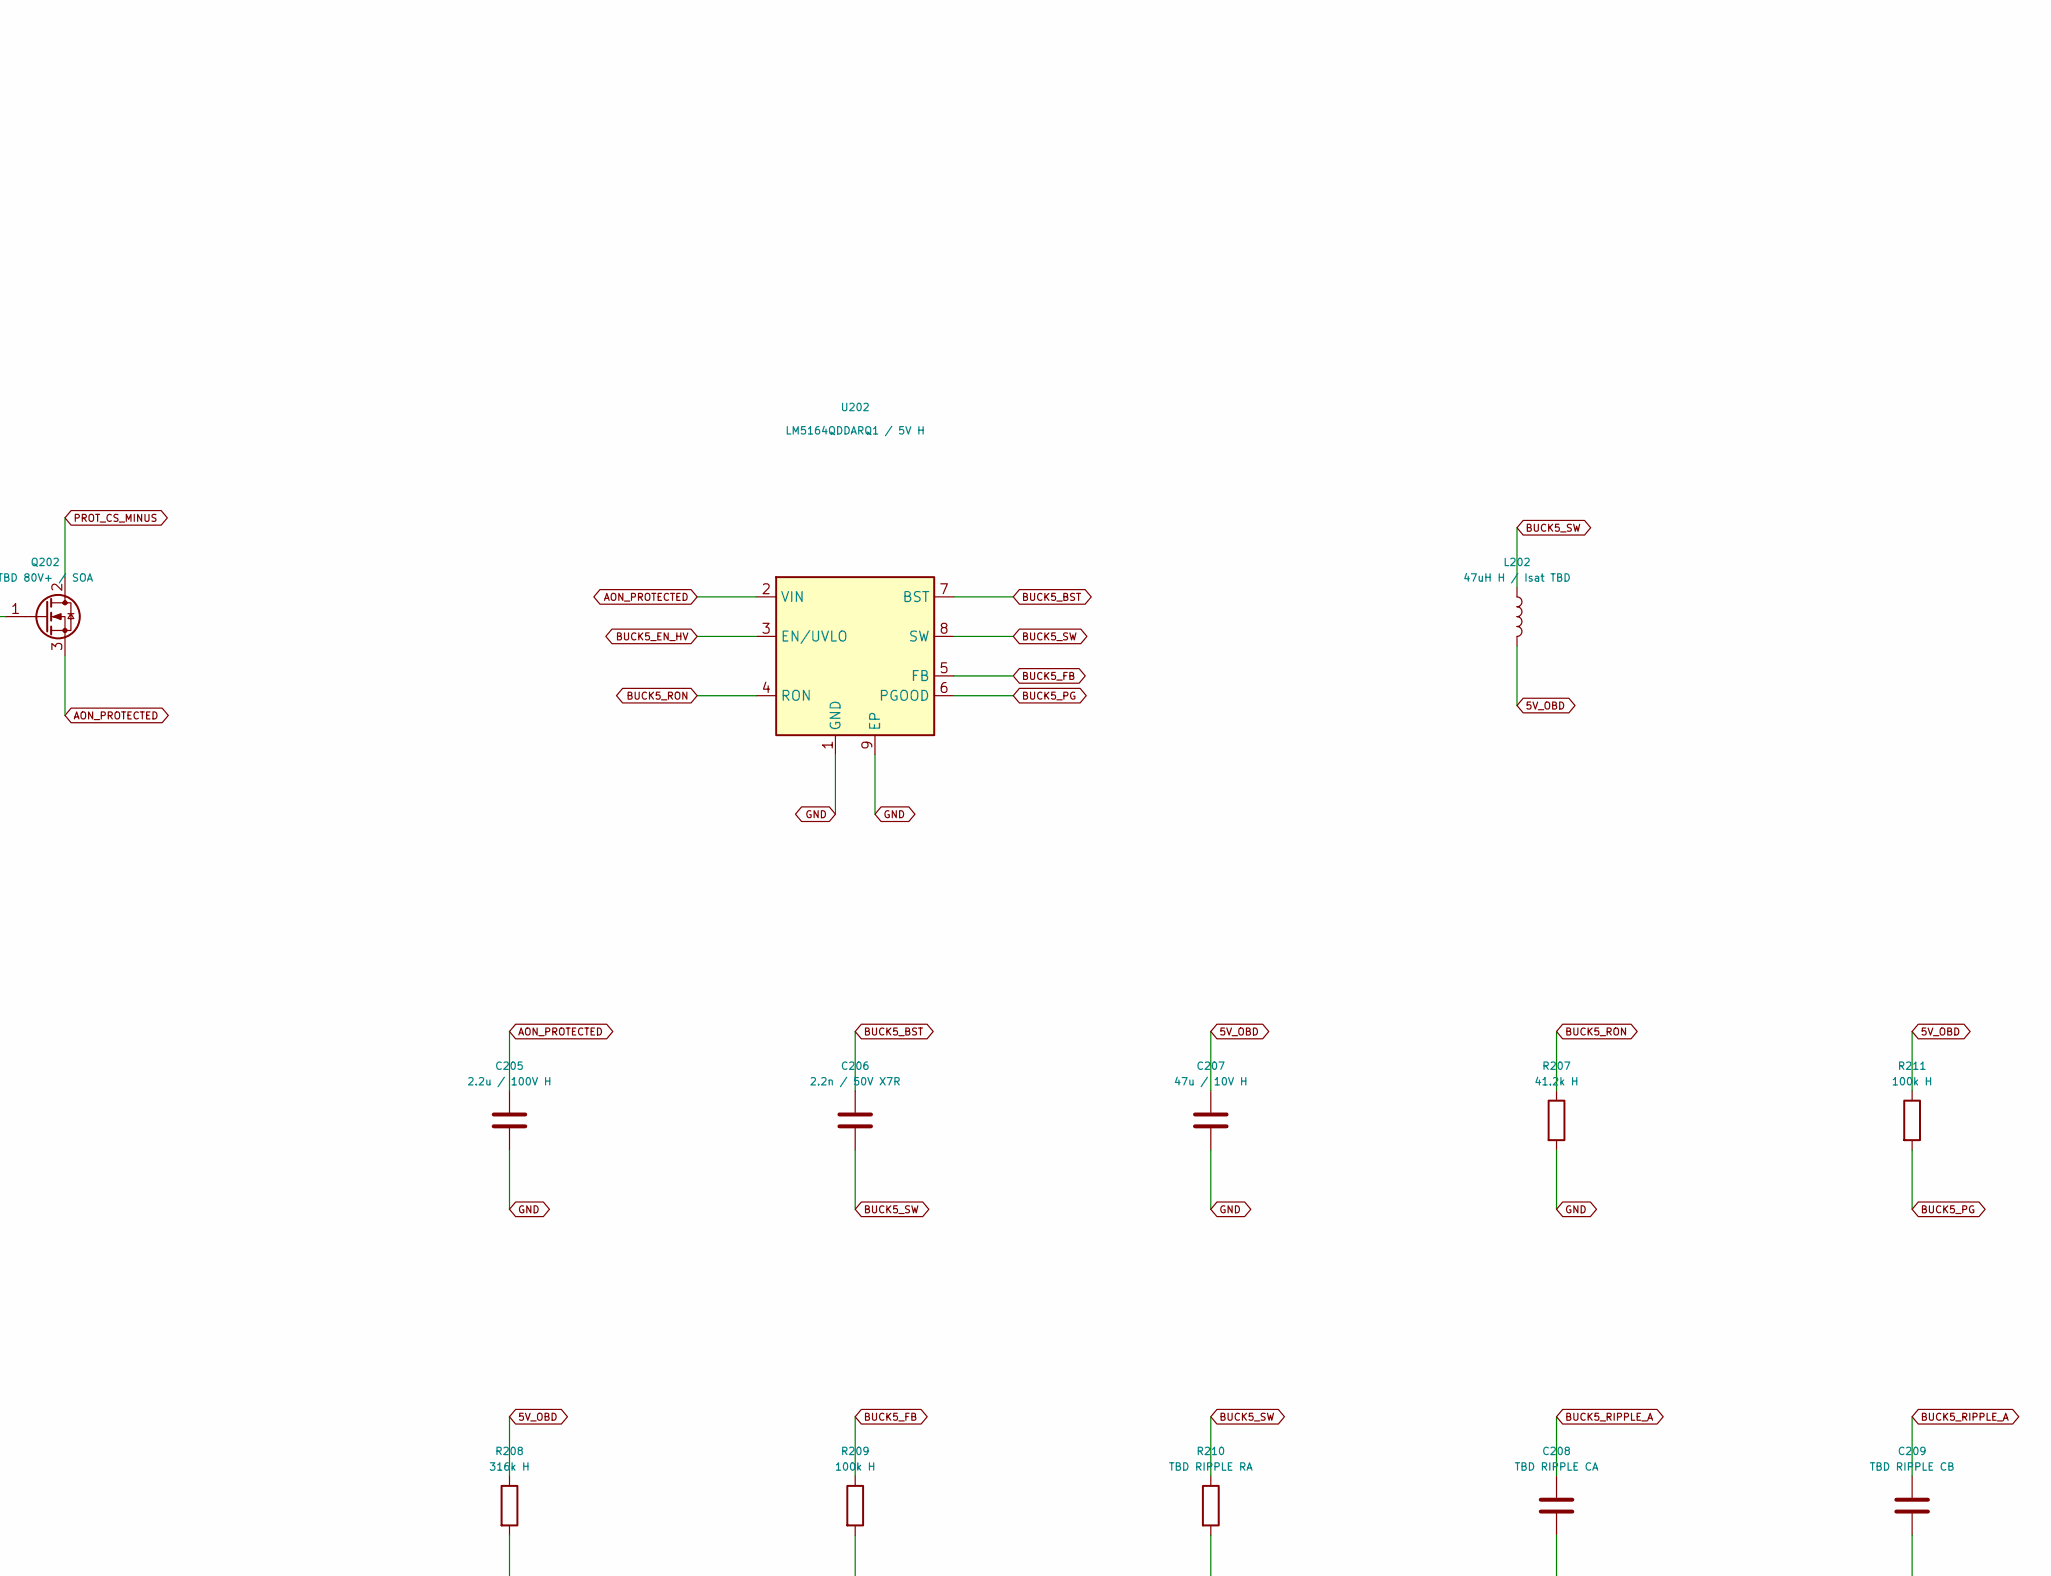
[picture p113: schematic 02_AUTOMOTIVE_POWER.kicad_sch, part in row 1, column 2]

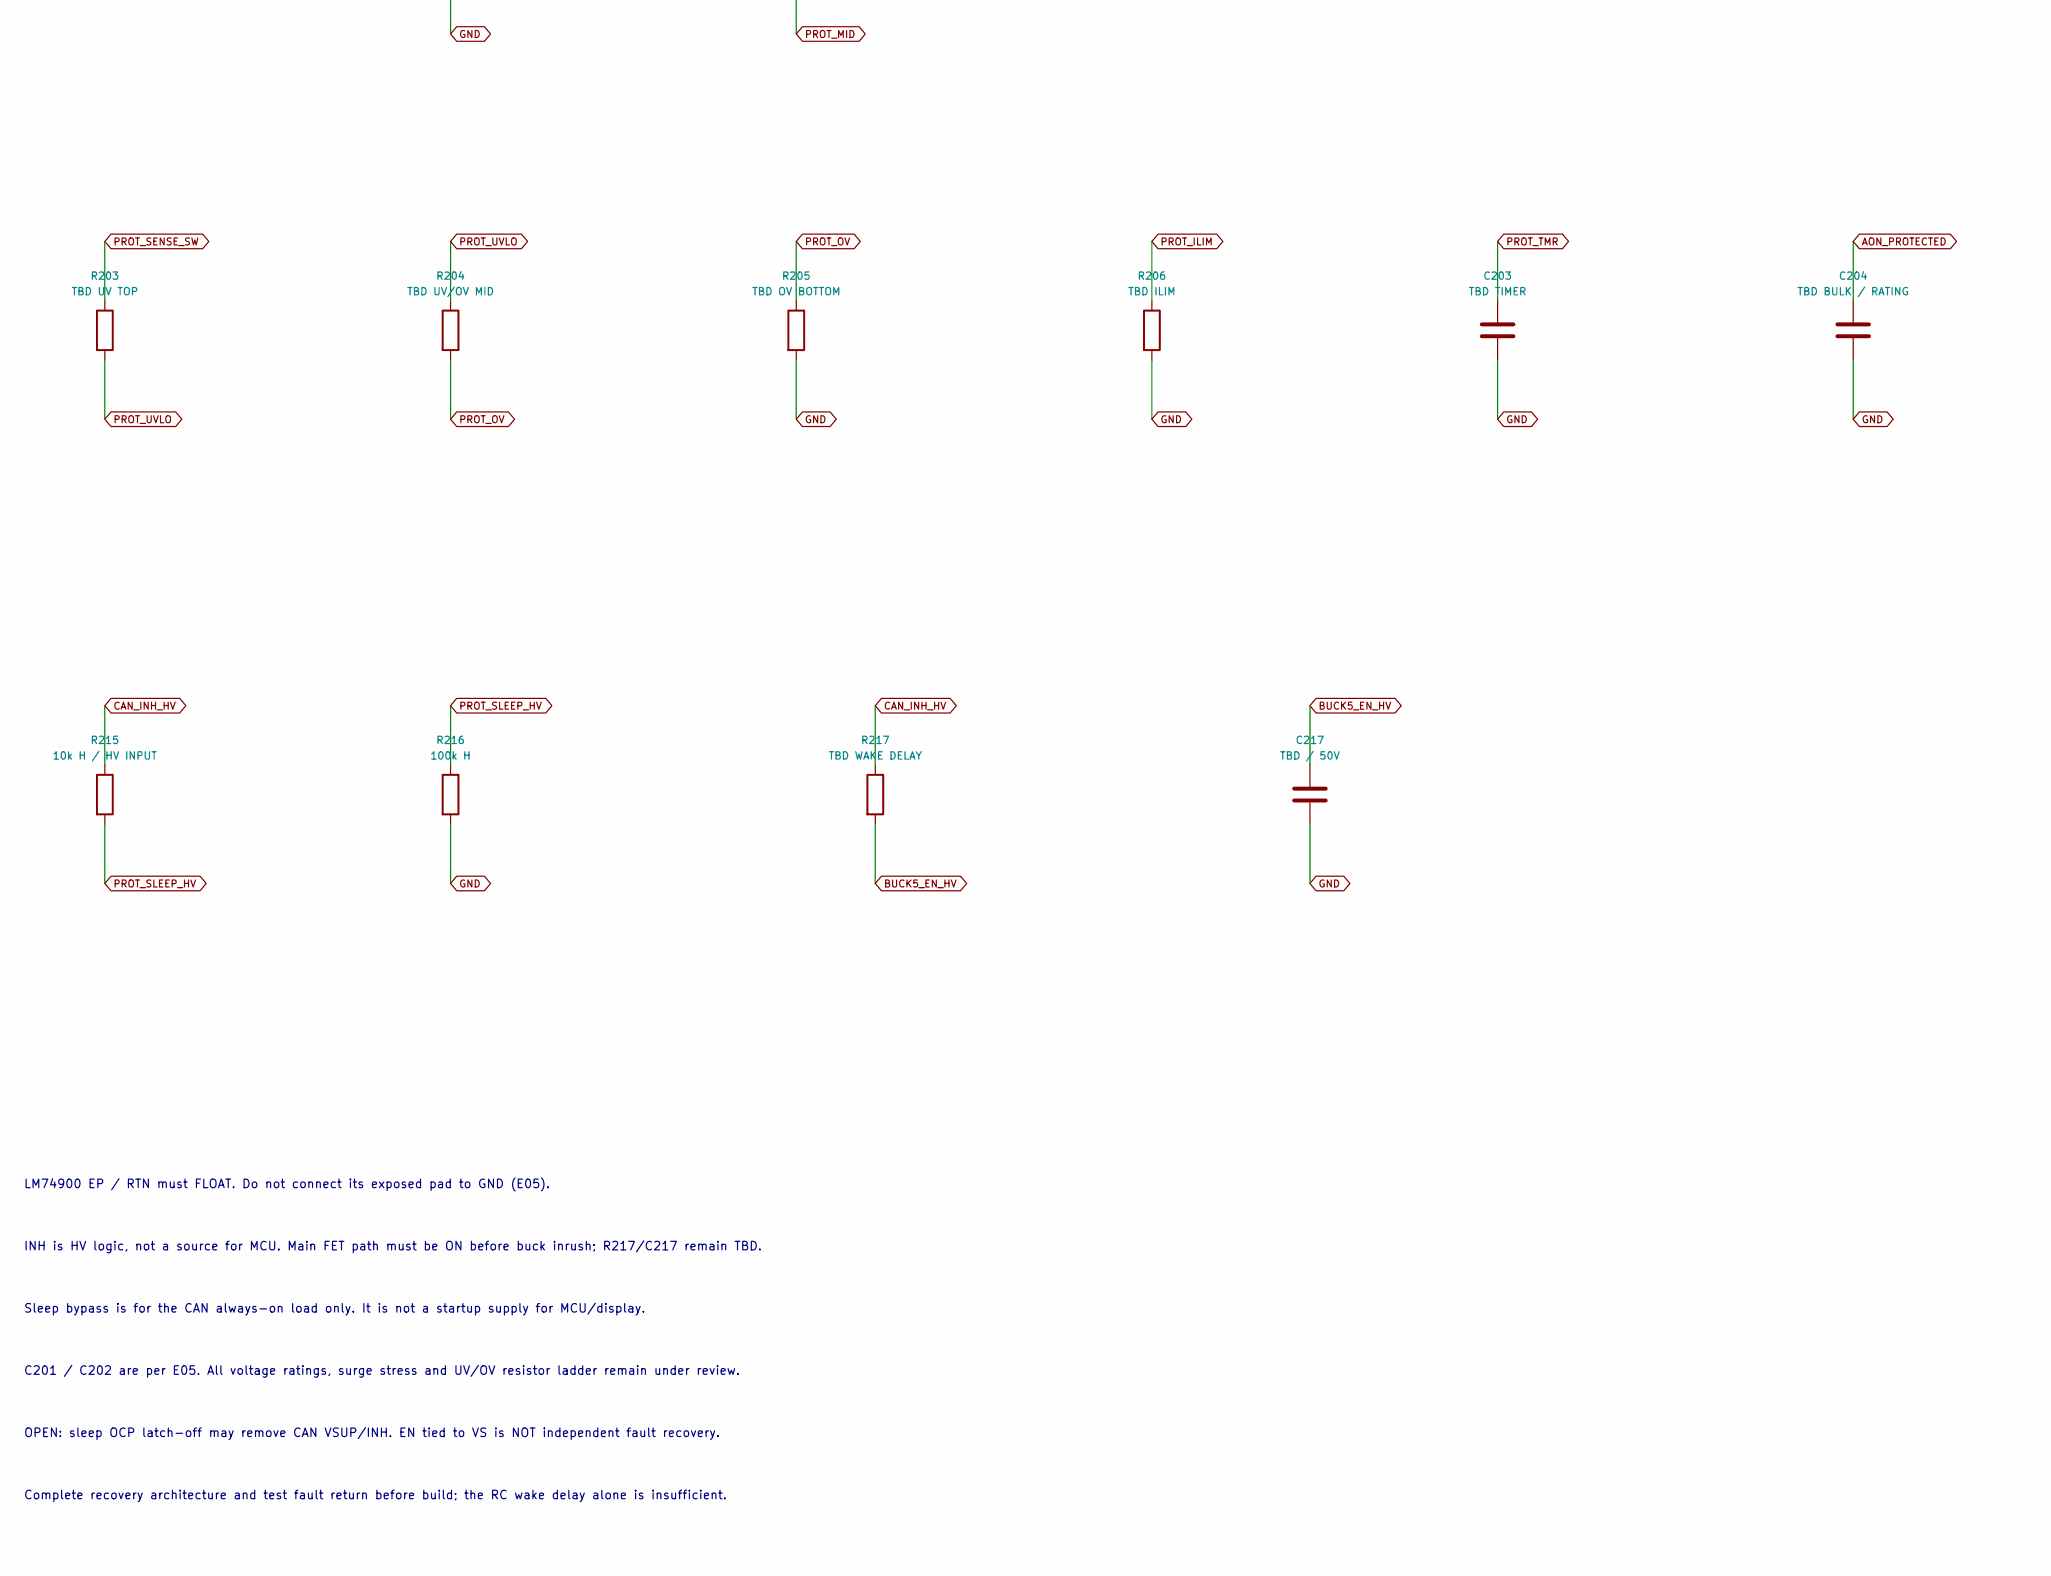
[picture p114: schematic 02_AUTOMOTIVE_POWER.kicad_sch, part in row 2, column 1]

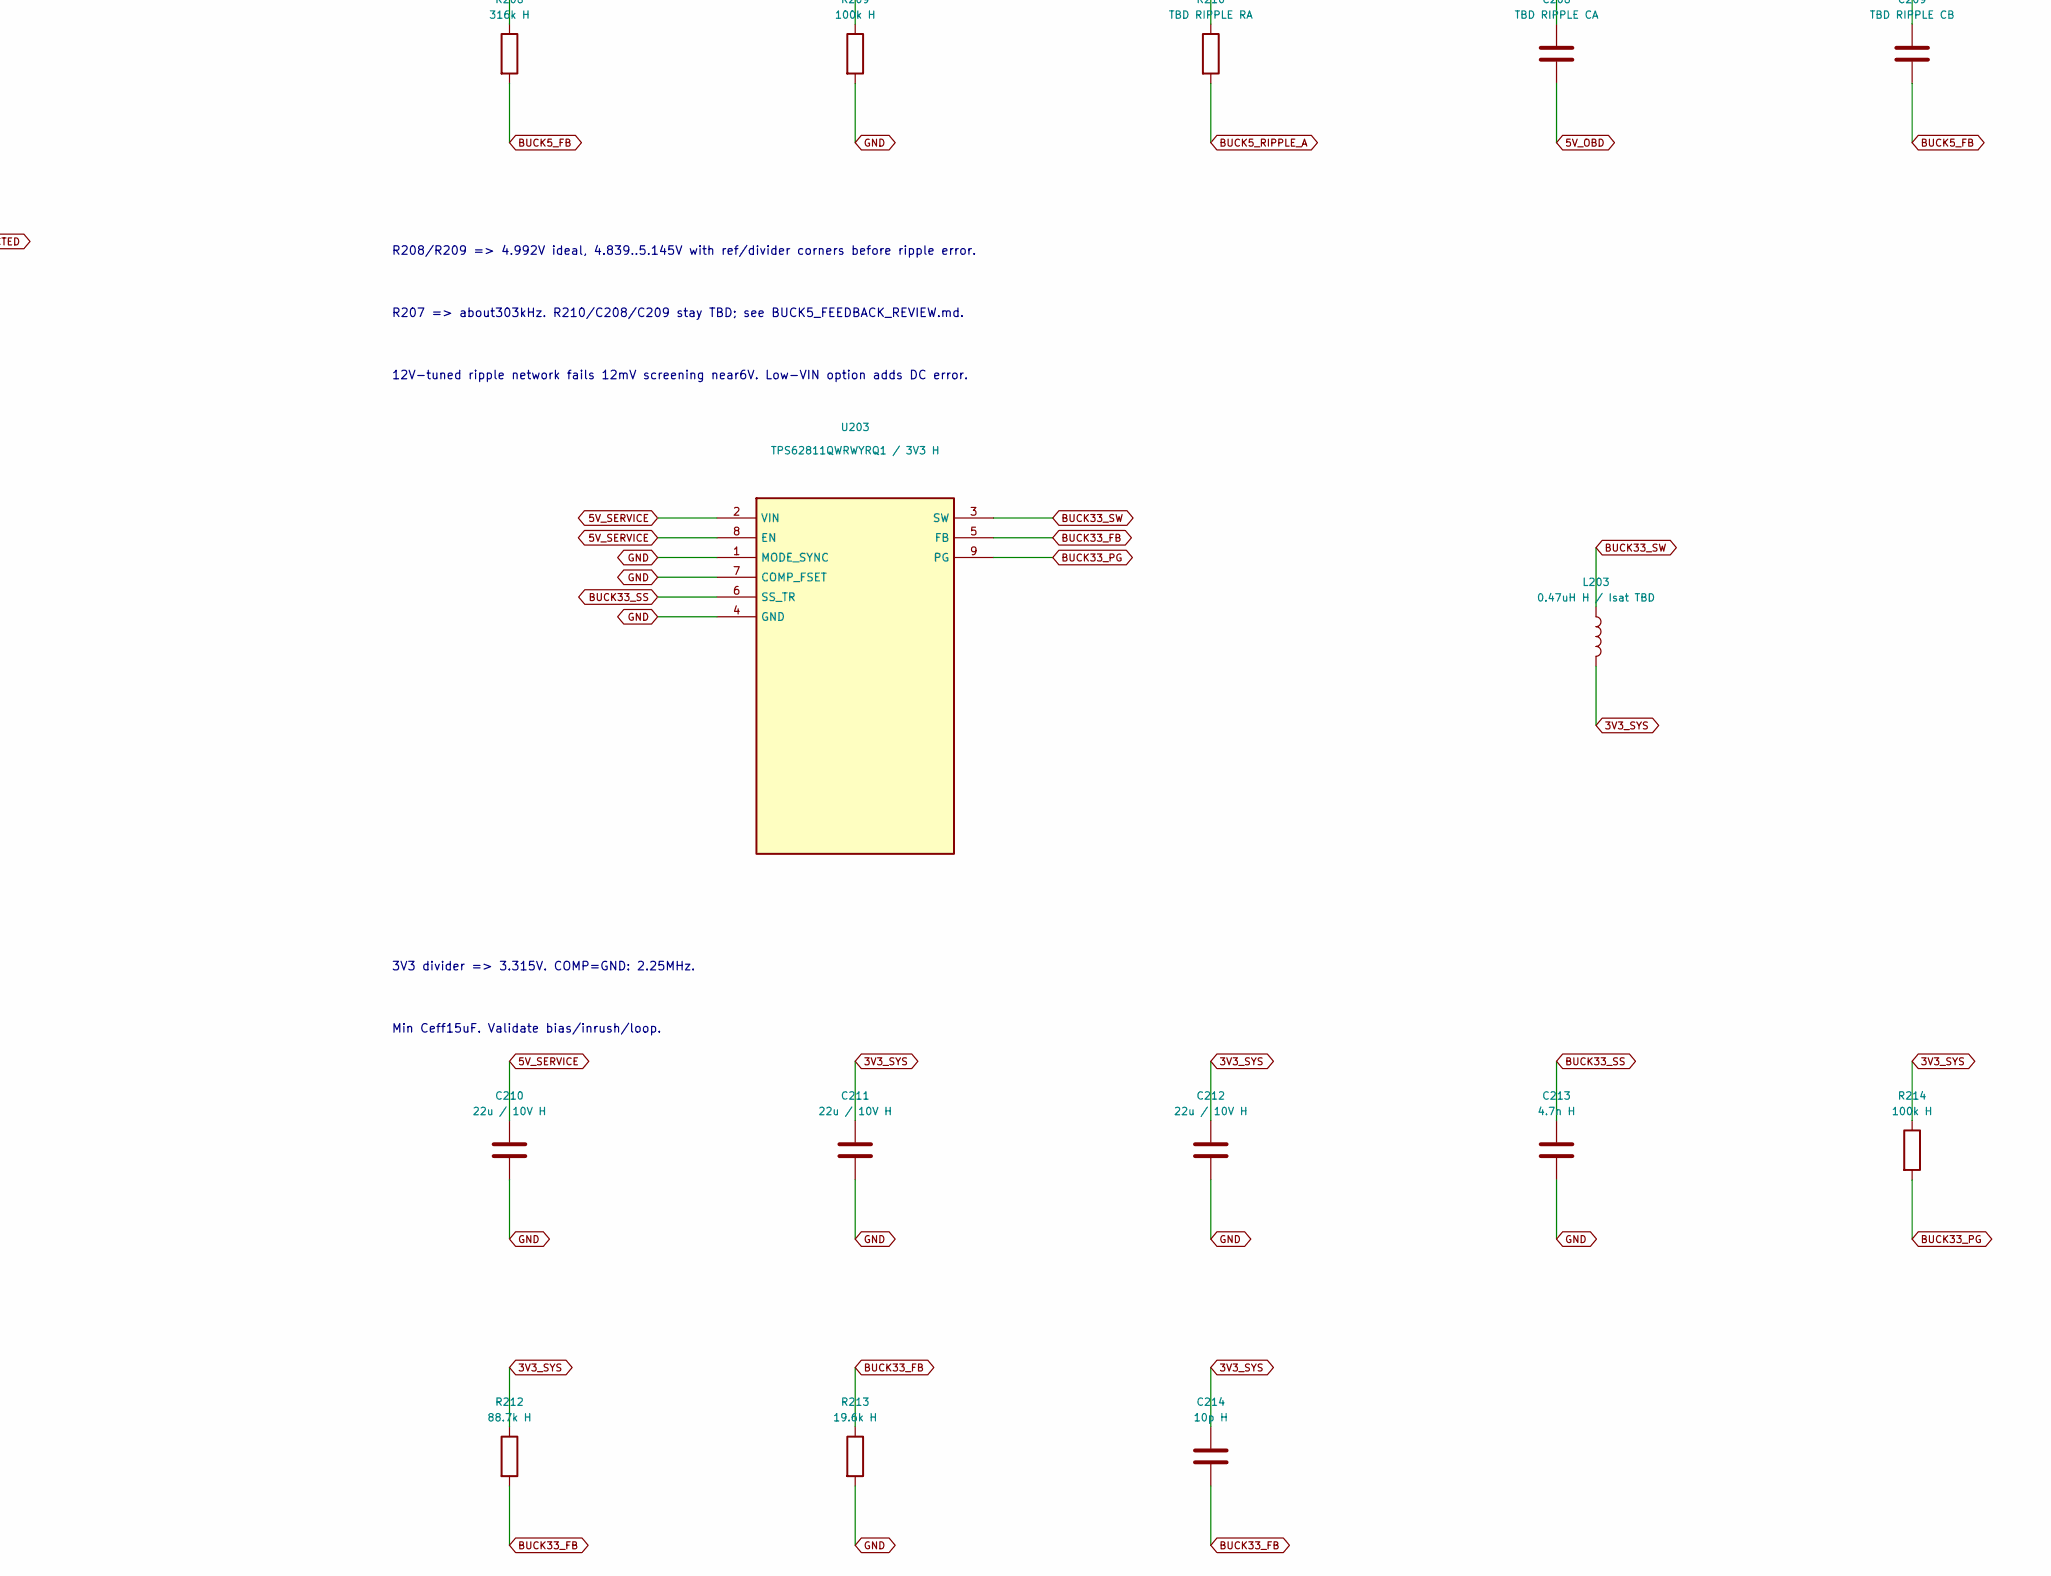
[picture p115: schematic 02_AUTOMOTIVE_POWER.kicad_sch, part in row 2, column 2]

Parts:
C201: 100n / 100V H; MPN TBD
C202: 100n / 16V H; MPN TBD
C203: TBD TIMER; MPN TBD
C204: TBD BULK / RATING; MPN TBD
C205: 2.2u / 100V H; MPN TBD
C206: 2.2n / 50V X7R; MPN TBD
C207: 47u / 10V H; MPN TBD
C208: TBD RIPPLE CA; MPN TBD
C209: TBD RIPPLE CB; MPN TBD
C210, C211, C212: 22u / 10V H; MPN TBD
C213: 4.7n H; MPN TBD
C214: 10p H; MPN TBD
C217: TBD / 50V; MPN TBD
D201: TBD AUTOMOTIVE TVS; MPN TBD
L202: 47uH H / Isat TBD; MPN TBD
L203: 0.47uH H / Isat TBD; MPN TBD
Q201, Q202: TBD 80V+ / SOA; MPN TBD
R201: TBD SHUNT; MPN TBD
R202: 0.1 ohm H / CS FILTER; MPN TBD
R203: TBD UV TOP; MPN TBD
R204: TBD UV/OV MID; MPN TBD
R205: TBD OV BOTTOM; MPN TBD
R206: TBD ILIM; MPN TBD
R207: 41.2k H; MPN TBD
R208: 316k H; MPN TBD
R209, R211, R214, R216: 100k H; MPN TBD
R210: TBD RIPPLE RA; MPN TBD
R212: 88.7k H; MPN TBD
R213: 19.6k H; MPN TBD
R215: 10k H / HV INPUT; MPN TBD
R217: TBD WAKE DELAY; MPN TBD
U201: LM74900QRGERQ1; MPN LM74900QRGERQ1
U202: LM5164QDDARQ1 / 5V H; HSOP-8-1EP_3.9x4.9mm_P1.27mm_EP2.41x3.1mm_ThermalVias; MPN LM5164QDDARQ1
U203: TPS62811QWRWYRQ1 / 3V3 H; MPN TPS62811QWRWYRQ1

Connections:
3V3_SYS: C211.1, C212.1, C214.1, L203.2, R212.1, R214.1
5V_OBD: C207.1, C208.2, L202.2, R208.1, R211.1
5V_SERVICE: C210.1, U203.2 (VIN), U203.8 (EN)
AON_PROTECTED: C204.1, C205.1, Q202.3 (S), U201.15 (OUT), U202.2 (VIN)
BPLUS_CABLE_FUSED: D201.1 (A1), Q201.3 (S), U201.2 (A)
BUCK5_BST: C206.1, U202.7 (BST)
BUCK5_EN_HV: C217.1, R217.2, U202.3 (EN/UVLO)
BUCK5_FB: C209.2, R208.2, R209.1, U202.5 (FB)
BUCK5_PG: R211.2, U202.6 (PGOOD)
BUCK5_RIPPLE_A: C208.1, C209.1, R210.2
BUCK5_RON: R207.1, U202.4 (RON)
BUCK5_SW: C206.2, L202.1, R210.1, U202.8 (SW)
BUCK33_FB: C214.2, R212.2, R213.1, U203.5 (FB)
BUCK33_PG: R214.2, U203.9 (PG)
BUCK33_SS: C213.1, U203.6 (SS_TR)
BUCK33_SW: L203.1, U203.3 (SW)
CAN_INH_HV: R215.1, R217.1
GND: C201.2, C203.2, C204.2, C205.2, C207.2, C210.2, C211.2, C212.2, C213.2, C217.2, D201.2 (A2), R205.2, R206.2, R207.2, R209.2, R213.2, R216.2, U201.13 (GND), U202.1 (GND), U202.9 (EP), U203.1 (MODE_SYNC), U203.4 (GND), U203.7 (COMP_FSET)
IDEAL_DIODE_GATE: Q201.1 (G), U201.1 (DGATE)
LOAD_GATE: Q202.1 (G), U201.14 (HGATE)
PROT_CAP: C202.1, U201.23 (CAP)
PROT_CS_MINUS: Q202.2 (D), R201.2, U201.19 (CS_MINUS)
PROT_CS_PLUS: R202.2, U201.18 (ISCP), U201.20 (CS_PLUS)
PROT_ILIM: R206.1, U201.11 (ILIM)
PROT_MID: C201.1, C202.2, Q201.2 (D), R201.1, R202.1, U201.6 (EN), U201.16 (SLEEP_OV), U201.22 (VS), U201.24 (C)
PROT_OV: R204.2, R205.1, U201.5 (OV)
PROT_SENSE_SW: R203.1, U201.3 (SW_SENSE)
PROT_SLEEP_HV: R215.2, R216.1, U201.7 (SLEEP)
PROT_TMR: C203.1, U201.9 (TMR)
PROT_UVLO: R203.2, R204.1, U201.4 (UVLO)

Notes on the sheet:
REV A0 / ENGINEERING REVIEW - NOT FOR BUILD
OPEN P0: transient profiles, TVS clamp/energy, MOSFET SOA, limits and wake timing. DO NOT BUILD.
Common-drain topology from E05. Capacitor voltage ratings / passive values with H are engineering assumptions.
LM74900 EP / RTN must FLOAT. Do not connect its exposed pad to GND (E05).
INH is HV logic, not a source for MCU. Main FET path must be ON before buck inrush; R217/C217 remain TBD.
Sleep bypass is for the CAN always-on load only. It is not a startup supply for MCU/display.
C201 / C202 are per E05. All voltage ratings, surge stress and UV/OV resistor ladder remain under review.
OPEN: sleep OCP latch-off may remove CAN VSUP/INH. EN tied to VS is NOT independent fault recovery.
Complete recovery architecture and test fault return before build; the RC wake delay alone is insufficient.
R208/R209 => 4.992V ideal, 4.839..5.145V with ref/divider corners before ripple error.
R207 => about303kHz. R210/C208/C209 stay TBD; see BUCK5_FEEDBACK_REVIEW.md.
12V-tuned ripple network fails 12mV screening near6V. Low-VIN option adds DC error.
3V3 divider => 3.315V. COMP=GND: 2.25MHz.
Min Ceff15uF. Validate bias/inrush/loop.
