Ale1x/auto-gauge/hardware/03_MCU_MEMORY_BLE.kicad_sch

## KiCad design hardware/03_MCU_MEMORY_BLE.kicad_sch (2026-10-24)

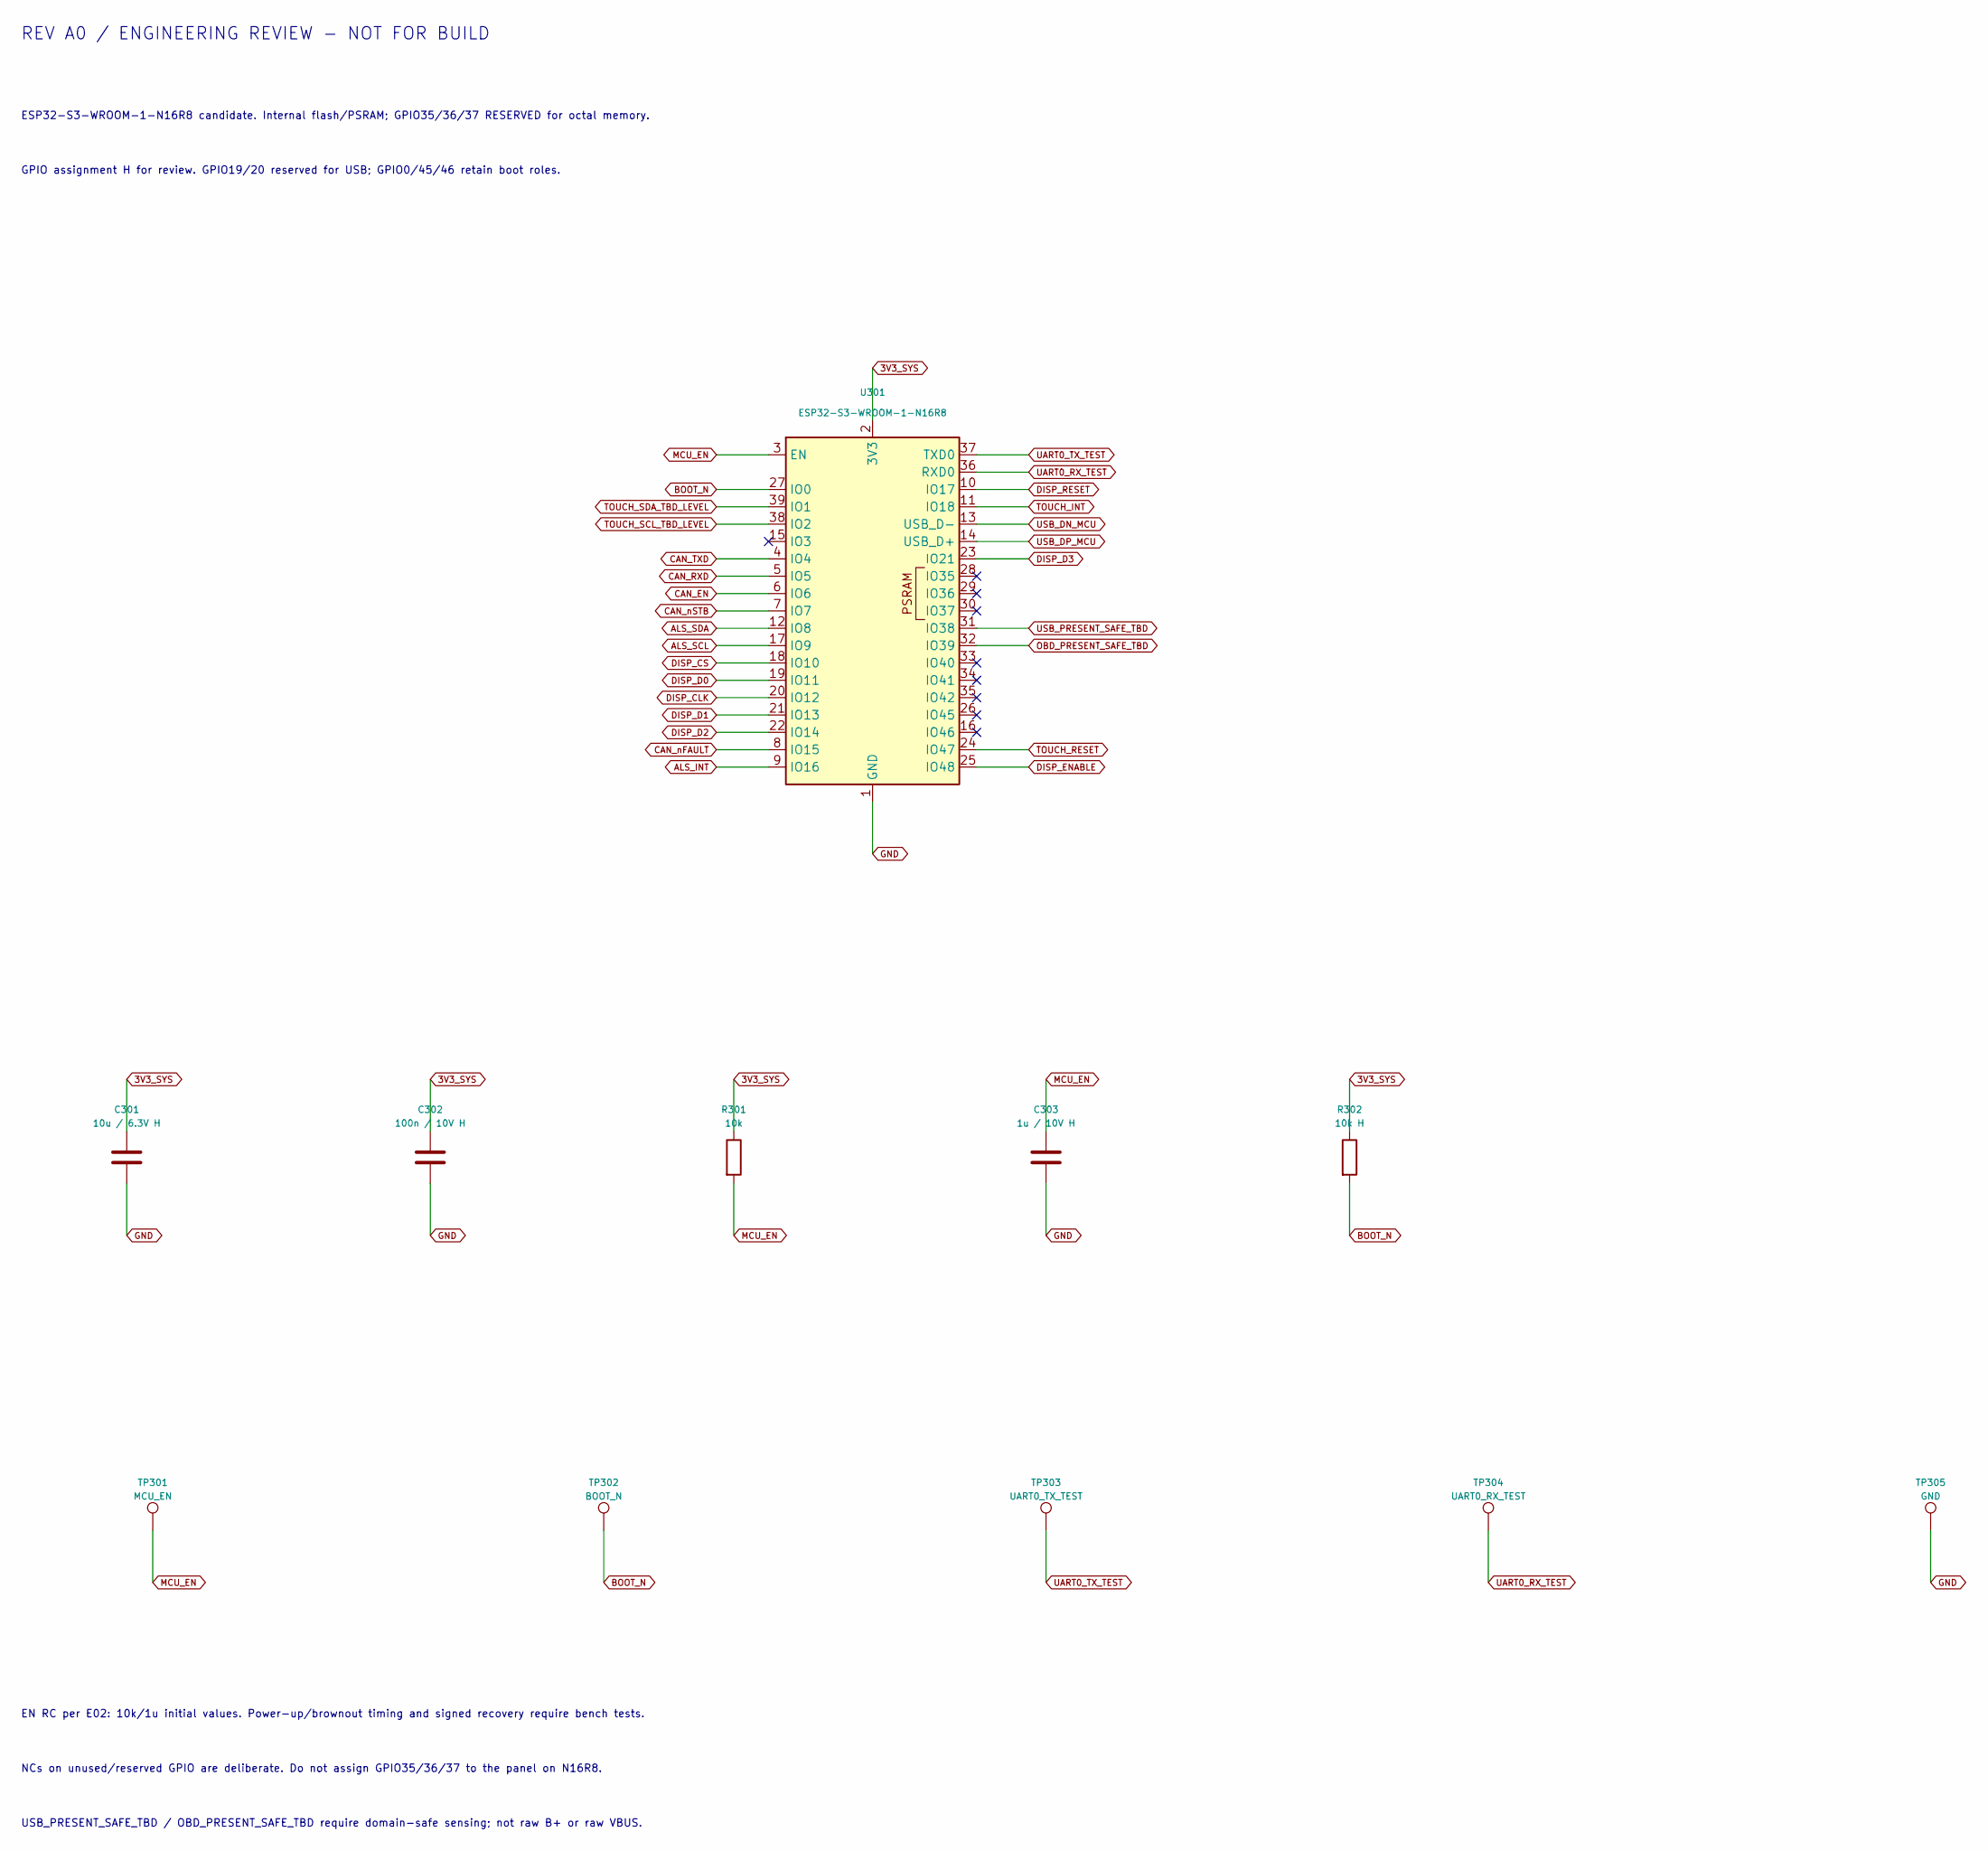
[picture p116: schematic 03_MCU_MEMORY_BLE.kicad_sch]

Parts:
C301: 10u / 6.3V H; MPN TBD
C302: 100n / 10V H; MPN TBD
C303: 1u / 10V H; MPN TBD
R301: 10k; MPN TBD
R302: 10k H; MPN TBD
TP301: MCU_EN; MPN TBD
TP302: BOOT_N; MPN TBD
TP303: UART0_TX_TEST; MPN TBD
TP304: UART0_RX_TEST; MPN TBD
TP305: GND; MPN TBD
U301: ESP32-S3-WROOM-1-N16R8; ESP32-S3-WROOM-1; MPN ESP32-S3-WROOM-1-N16R8

Connections:
3V3_SYS: C301.1, C302.1, R301.1, R302.1, U301.2 (3V3)
ALS_INT: U301.9 (IO16)
ALS_SCL: U301.17 (IO9)
ALS_SDA: U301.12 (IO8)
BOOT_N: R302.2, TP302.1, U301.27 (IO0)
CAN_EN: U301.6 (IO6)
CAN_RXD: U301.5 (IO5)
CAN_TXD: U301.4 (IO4)
CAN_nFAULT: U301.8 (IO15)
CAN_nSTB: U301.7 (IO7)
DISP_CLK: U301.20 (IO12)
DISP_CS: U301.18 (IO10)
DISP_D0: U301.19 (IO11)
DISP_D1: U301.21 (IO13)
DISP_D2: U301.22 (IO14)
DISP_D3: U301.23 (IO21)
DISP_ENABLE: U301.25 (IO48)
DISP_RESET: U301.10 (IO17)
GND: C301.2, C302.2, C303.2, TP305.1, U301.1 (GND), U301.40 (GND), U301.41 (GND)
MCU_EN: C303.1, R301.2, TP301.1, U301.3 (EN)
OBD_PRESENT_SAFE_TBD: U301.32 (IO39)
TOUCH_INT: U301.11 (IO18)
TOUCH_RESET: U301.24 (IO47)
TOUCH_SCL_TBD_LEVEL: U301.38 (IO2)
TOUCH_SDA_TBD_LEVEL: U301.39 (IO1)
UART0_RX_TEST: TP304.1, U301.36 (RXD0)
UART0_TX_TEST: TP303.1, U301.37 (TXD0)
USB_DN_MCU: U301.13 (USB_D-)
USB_DP_MCU: U301.14 (USB_D+)
USB_PRESENT_SAFE_TBD: U301.31 (IO38)

Notes on the sheet:
REV A0 / ENGINEERING REVIEW - NOT FOR BUILD
ESP32-S3-WROOM-1-N16R8 candidate. Internal flash/PSRAM; GPIO35/36/37 RESERVED for octal memory.
GPIO assignment H for review. GPIO19/20 reserved for USB; GPIO0/45/46 retain boot roles.
EN RC per E02: 10k/1u initial values. Power-up/brownout timing and signed recovery require bench tests.
NCs on unused/reserved GPIO are deliberate. Do not assign GPIO35/36/37 to the panel on N16R8.
USB_PRESENT_SAFE_TBD / OBD_PRESENT_SAFE_TBD require domain-safe sensing; not raw B+ or raw VBUS.
