Ale1x/auto-gauge/hardware/04_CAN_PHY.kicad_sch

## KiCad design hardware/04_CAN_PHY.kicad_sch (2026-10-24)

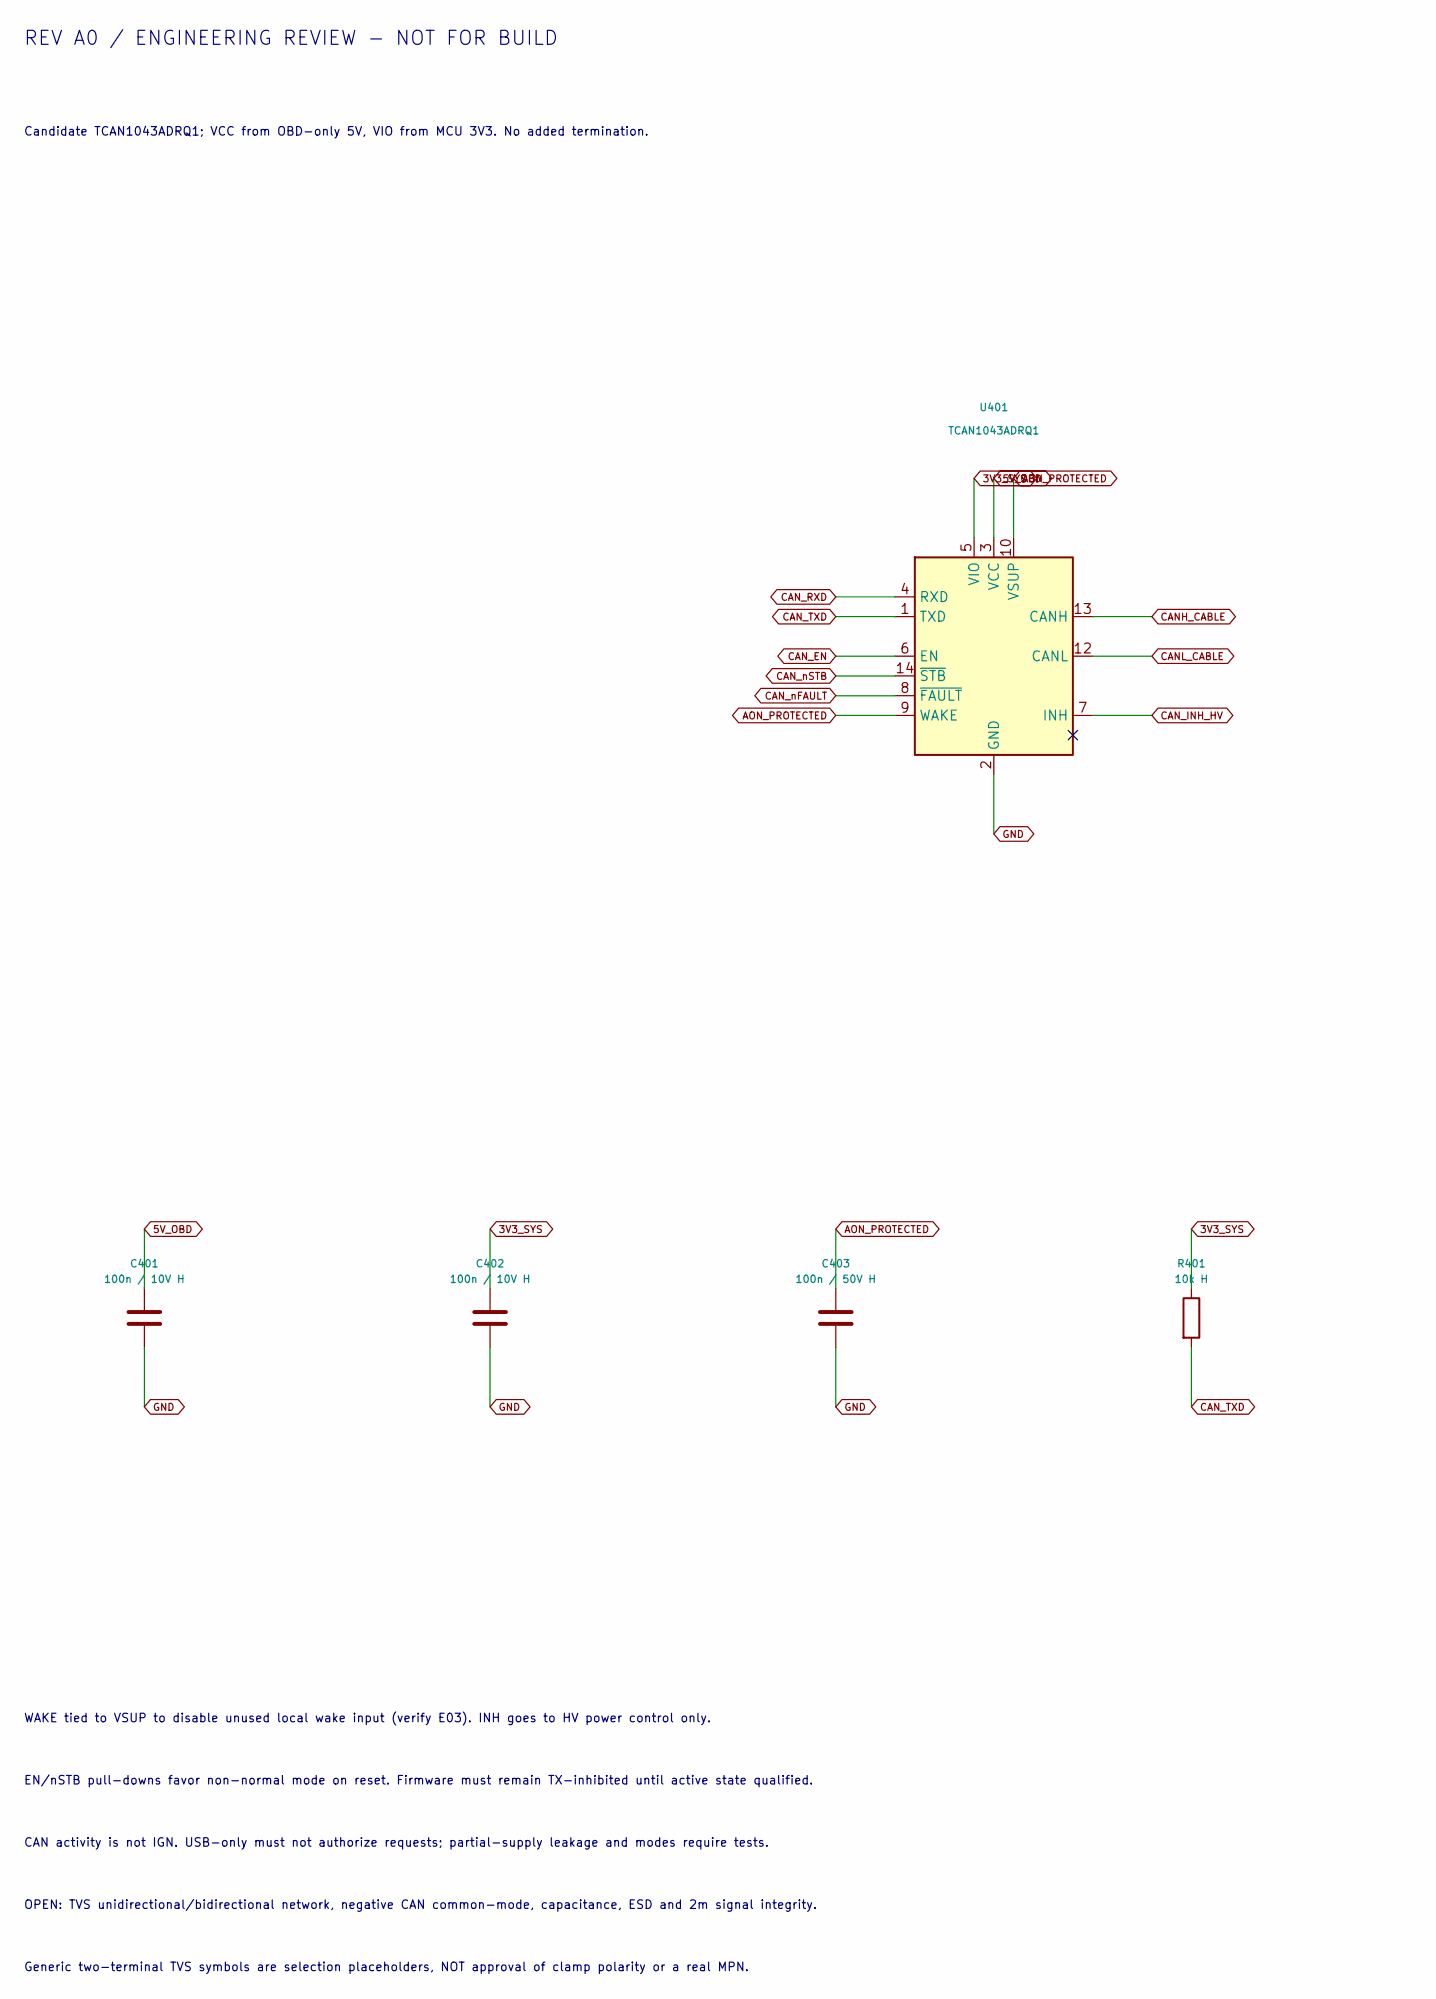
[picture p117: schematic 04_CAN_PHY.kicad_sch, part in row 1, column 1]

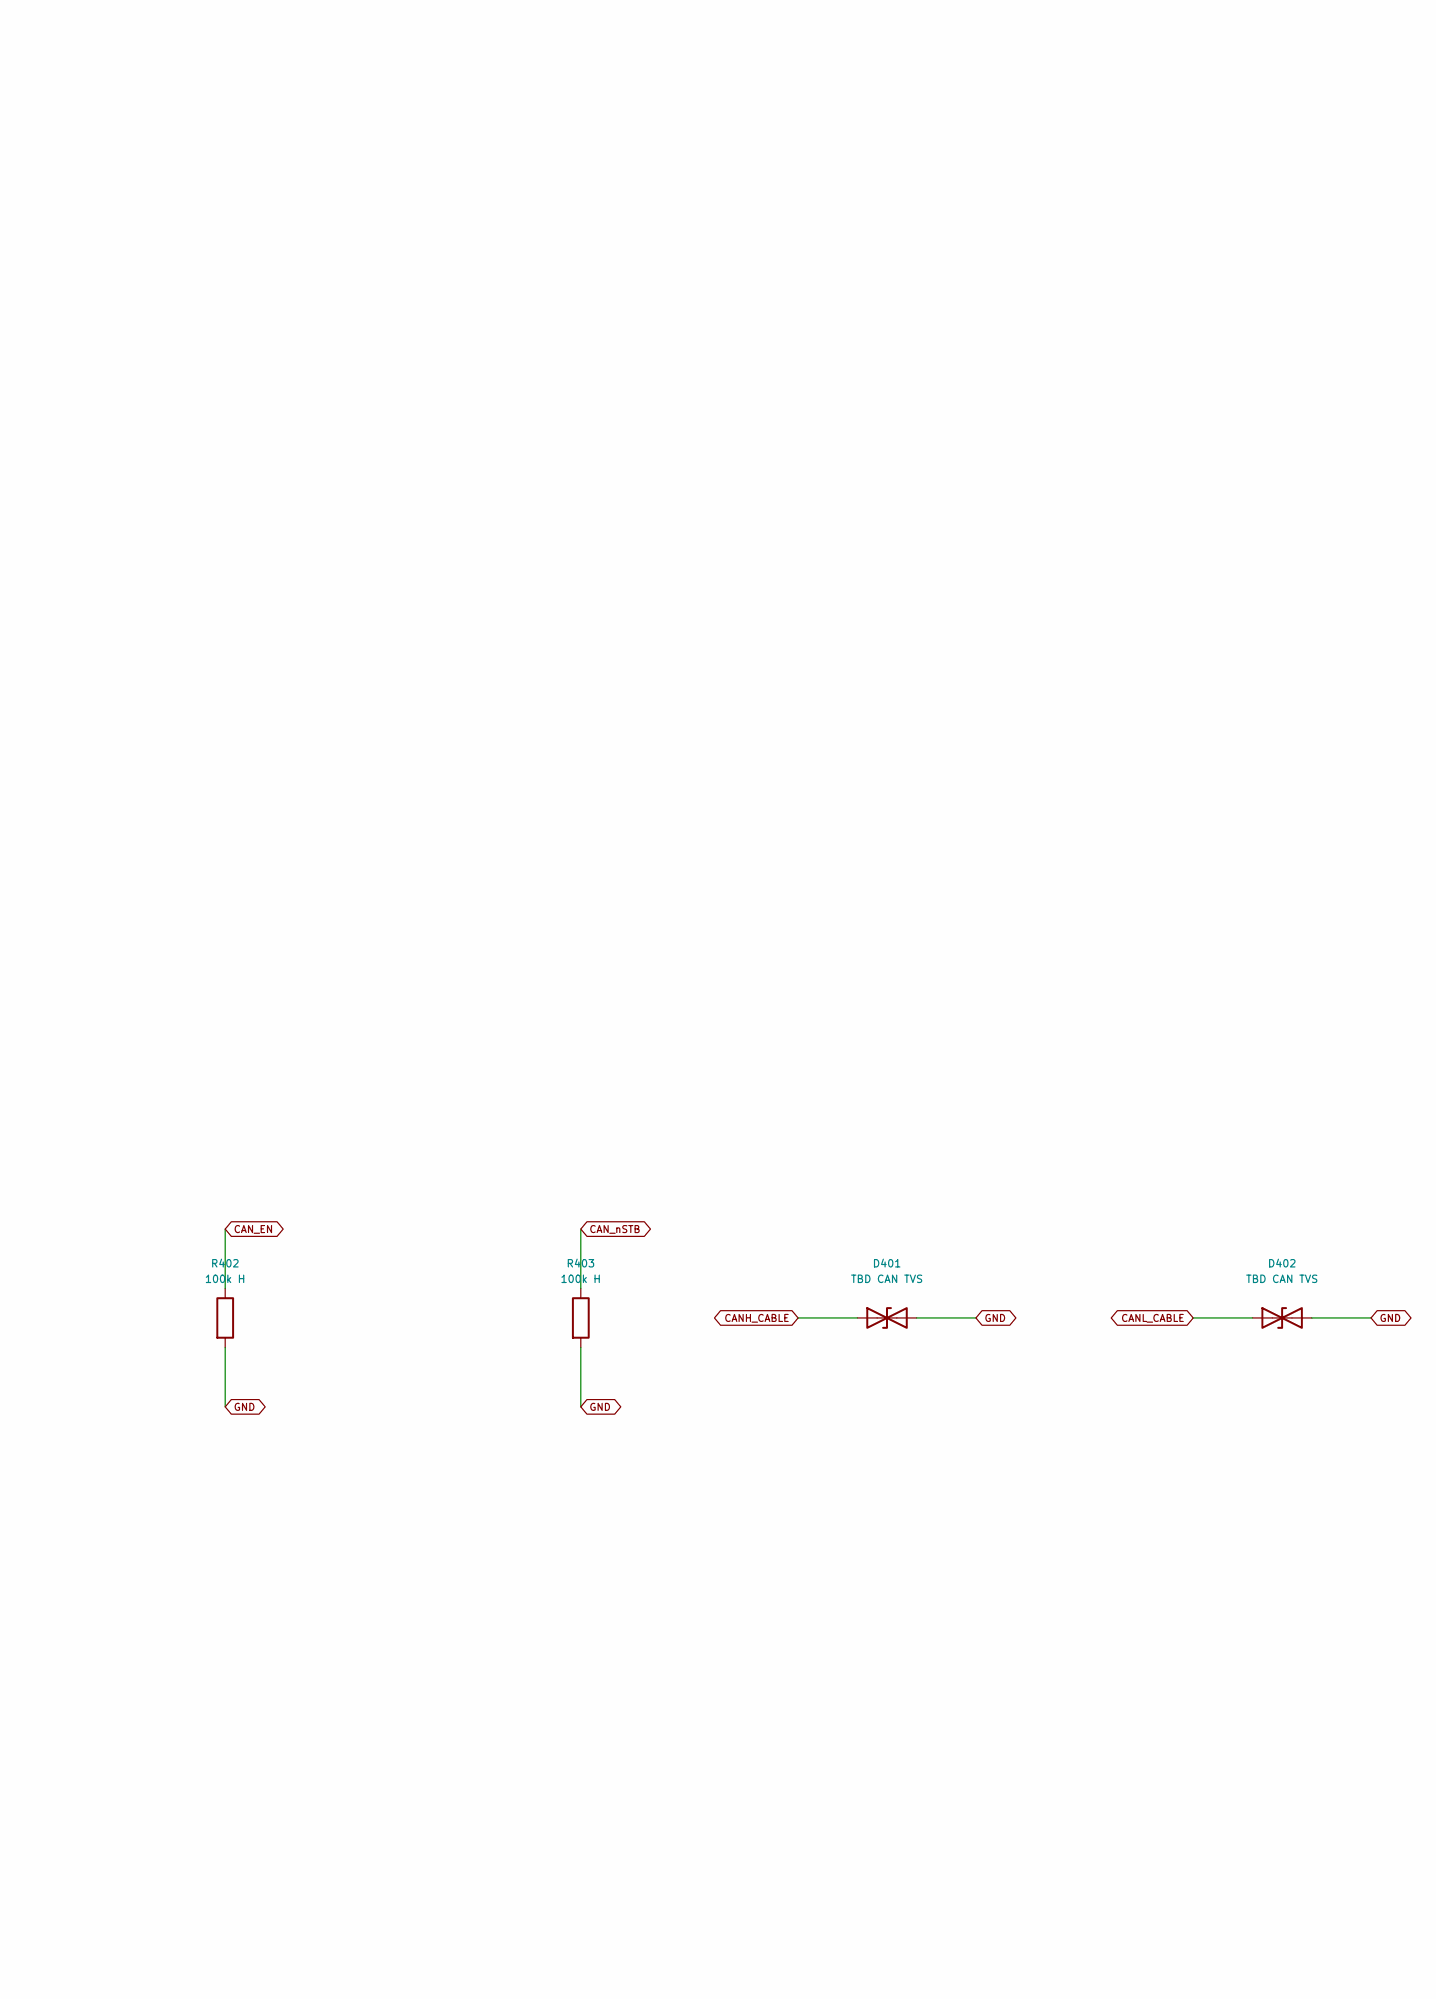
[picture p118: schematic 04_CAN_PHY.kicad_sch, part in row 1, column 2]

Parts:
C401, C402: 100n / 10V H; MPN TBD
C403: 100n / 50V H; MPN TBD
D401, D402: TBD CAN TVS; MPN TBD
R401: 10k H; MPN TBD
R402, R403: 100k H; MPN TBD
U401: TCAN1043ADRQ1; SOIC-14_3.9x8.7mm_P1.27mm; MPN TCAN1043ADRQ1

Connections:
3V3_SYS: C402.1, R401.1, U401.5 (VIO)
5V_OBD: C401.1, U401.3 (VCC)
AON_PROTECTED: C403.1, U401.9 (WAKE), U401.10 (VSUP)
CANH_CABLE: D401.1 (A1), U401.13 (CANH)
CANL_CABLE: D402.1 (A1), U401.12 (CANL)
CAN_EN: R402.1, U401.6 (EN)
CAN_INH_HV: U401.7 (INH)
CAN_RXD: U401.4 (RXD)
CAN_TXD: R401.2, U401.1 (TXD)
CAN_nFAULT: U401.8 (~FAULT)
CAN_nSTB: R403.1, U401.14 (~STB)
GND: C401.2, C402.2, C403.2, D401.2 (A2), D402.2 (A2), R402.2, R403.2, U401.2 (GND)

Notes on the sheet:
REV A0 / ENGINEERING REVIEW - NOT FOR BUILD
Candidate TCAN1043ADRQ1; VCC from OBD-only 5V, VIO from MCU 3V3. No added termination.
WAKE tied to VSUP to disable unused local wake input (verify E03). INH goes to HV power control only.
EN/nSTB pull-downs favor non-normal mode on reset. Firmware must remain TX-inhibited until active state qualified.
CAN activity is not IGN. USB-only must not authorize requests; partial-supply leakage and modes require tests.
OPEN: TVS unidirectional/bidirectional network, negative CAN common-mode, capacitance, ESD and 2m signal integrity.
Generic two-terminal TVS symbols are selection placeholders, NOT approval of clamp polarity or a real MPN.
