Ale1x/auto-gauge/hardware/05_AMOLED_TOUCH.kicad_sch

## KiCad design hardware/05_AMOLED_TOUCH.kicad_sch (2026-10-24)

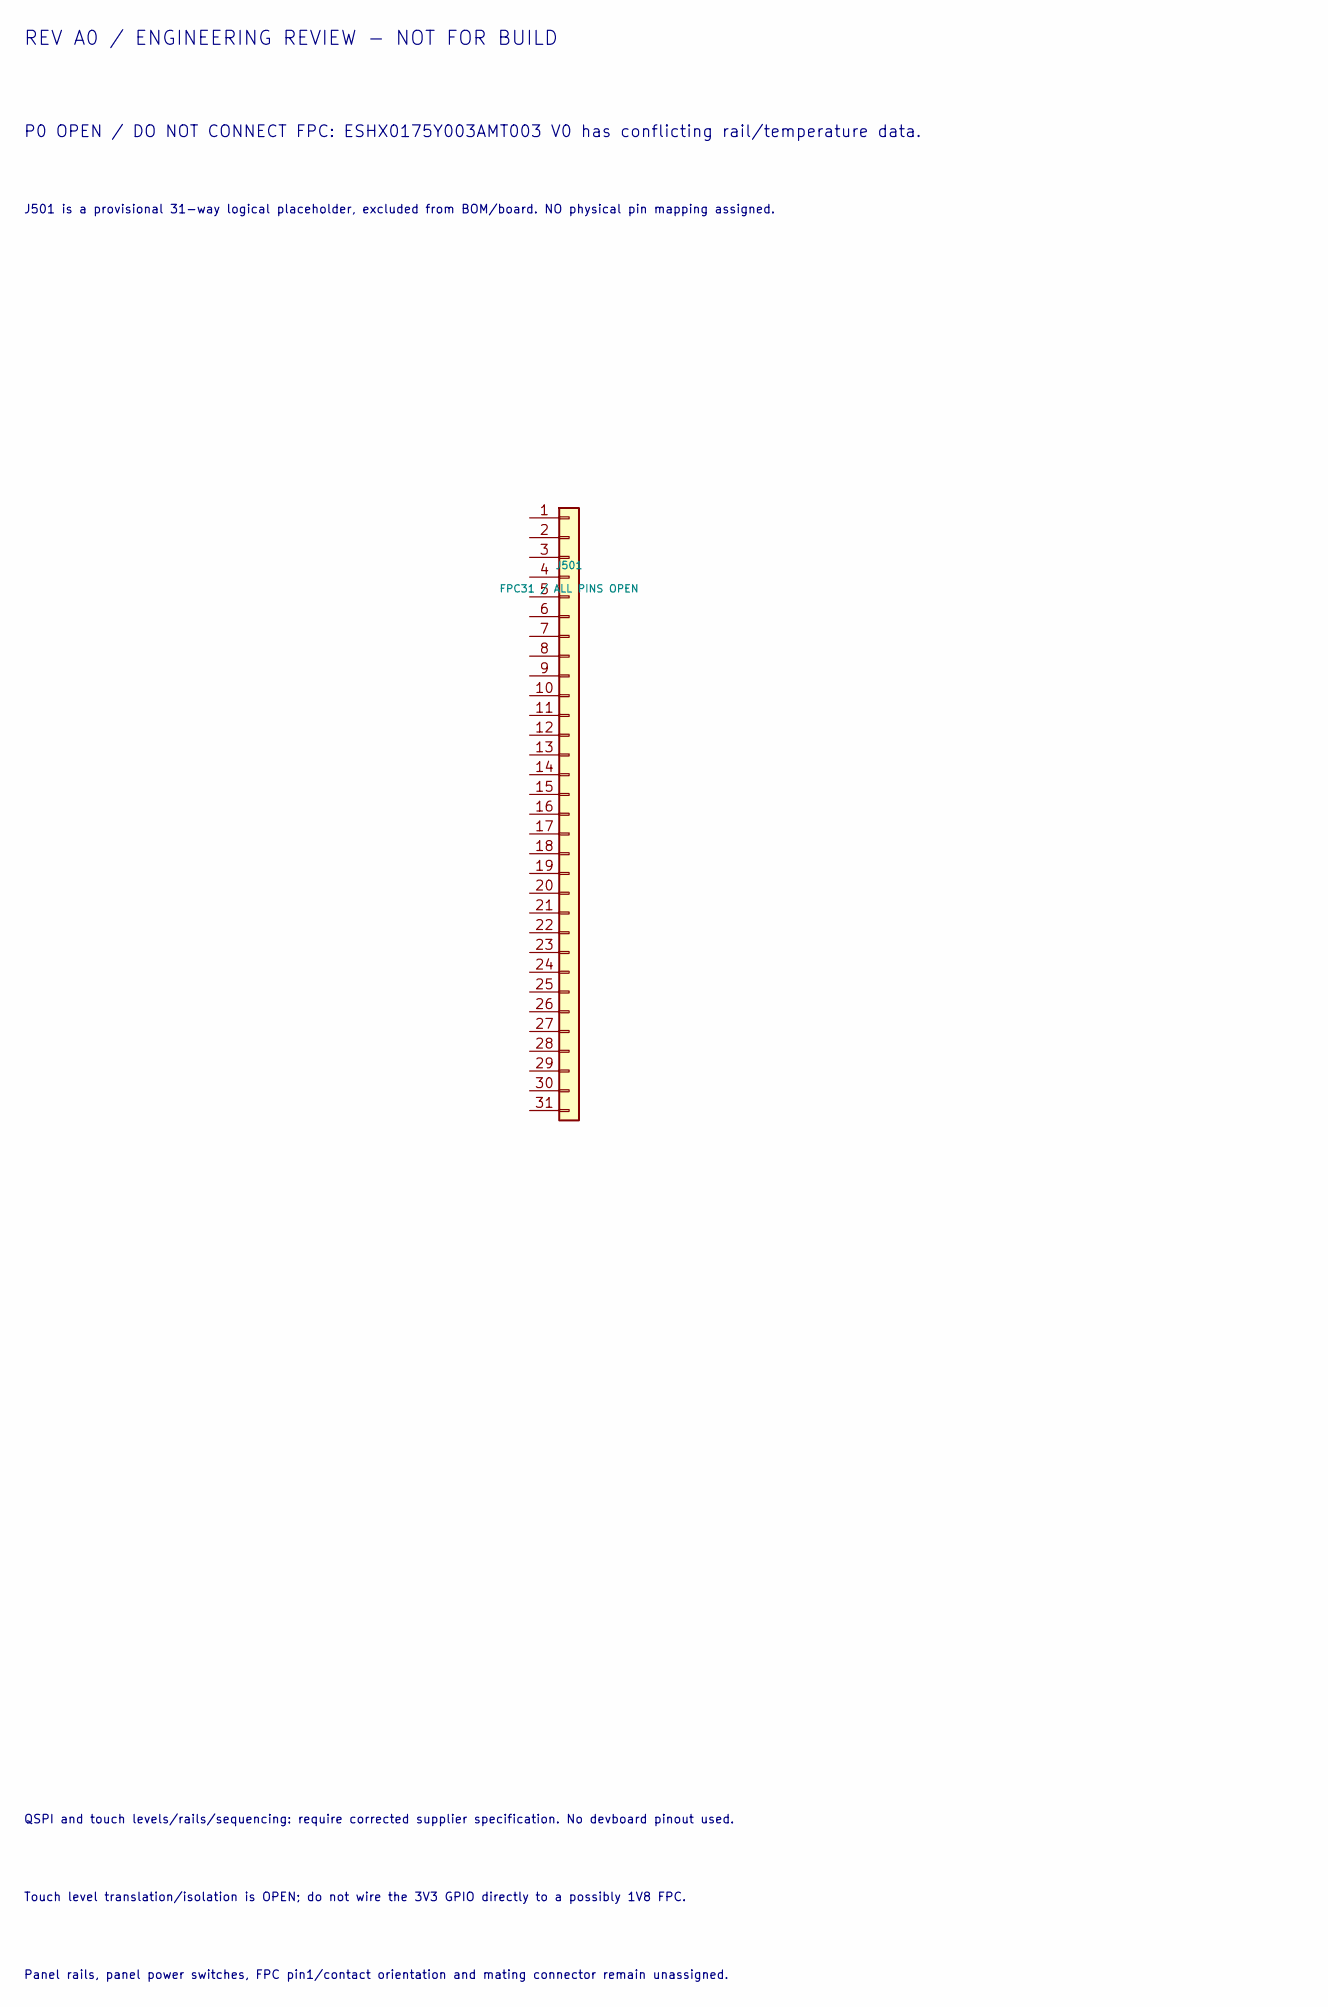
[picture p119: schematic 05_AMOLED_TOUCH.kicad_sch, part in row 1, column 1]

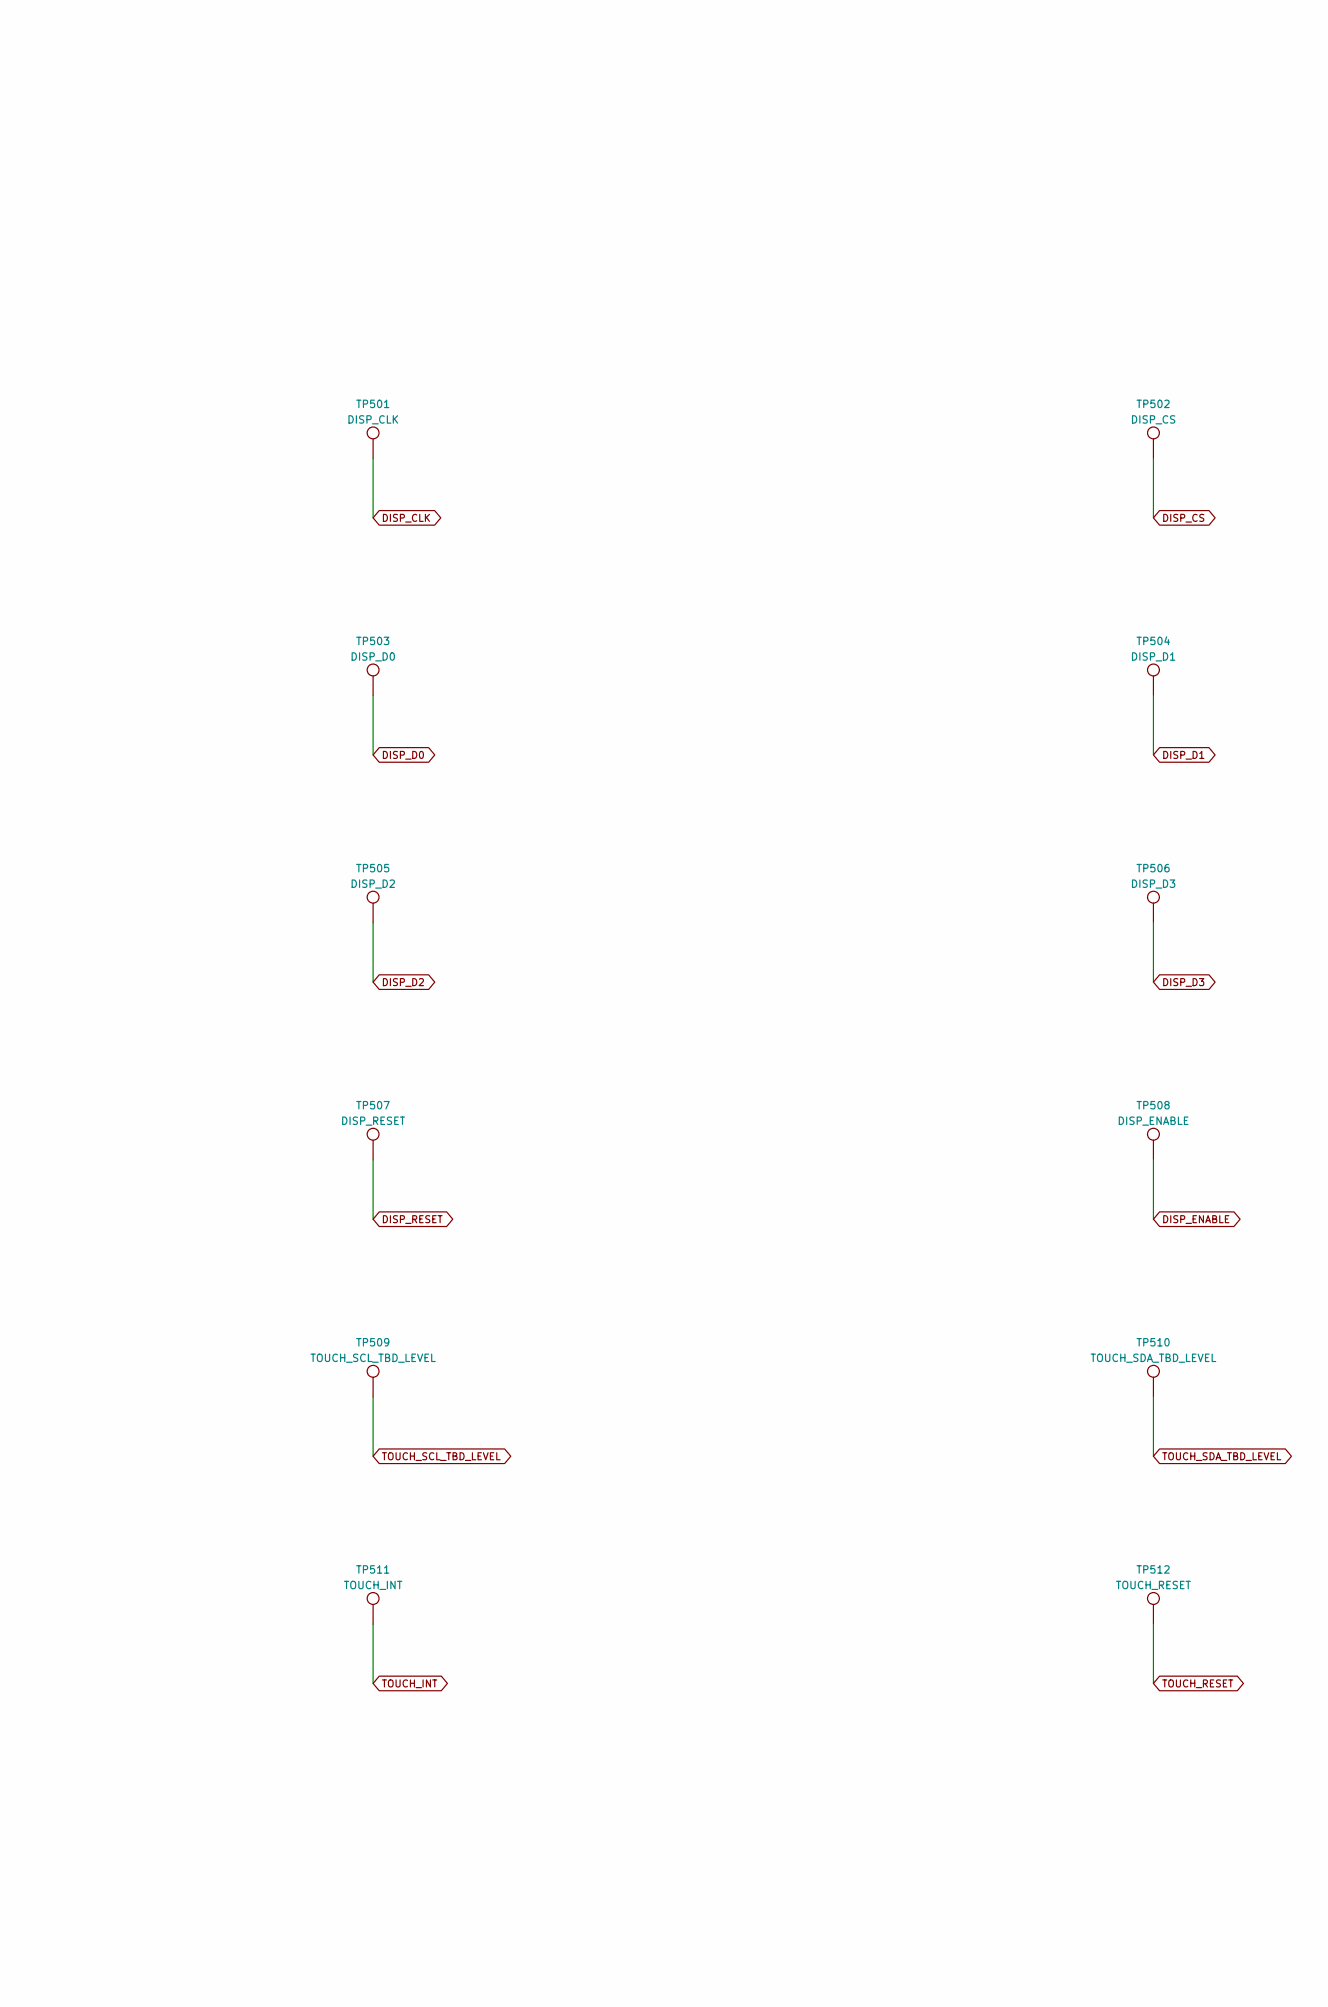
[picture p120: schematic 05_AMOLED_TOUCH.kicad_sch, part in row 1, column 2]

Parts:
J501: FPC31 / ALL PINS OPEN; MPN TBD
TP501: DISP_CLK; MPN TBD
TP502: DISP_CS; MPN TBD
TP503: DISP_D0; MPN TBD
TP504: DISP_D1; MPN TBD
TP505: DISP_D2; MPN TBD
TP506: DISP_D3; MPN TBD
TP507: DISP_RESET; MPN TBD
TP508: DISP_ENABLE; MPN TBD
TP509: TOUCH_SCL_TBD_LEVEL; MPN TBD
TP510: TOUCH_SDA_TBD_LEVEL; MPN TBD
TP511: TOUCH_INT; MPN TBD
TP512: TOUCH_RESET; MPN TBD

Connections:
DISP_CLK: TP501.1
DISP_CS: TP502.1
DISP_D0: TP503.1
DISP_D1: TP504.1
DISP_D2: TP505.1
DISP_D3: TP506.1
DISP_ENABLE: TP508.1
DISP_RESET: TP507.1
TOUCH_INT: TP511.1
TOUCH_RESET: TP512.1
TOUCH_SCL_TBD_LEVEL: TP509.1
TOUCH_SDA_TBD_LEVEL: TP510.1

Notes on the sheet:
REV A0 / ENGINEERING REVIEW - NOT FOR BUILD
P0 OPEN / DO NOT CONNECT FPC: ESHX0175Y003AMT003 V0 has conflicting rail/temperature data.
J501 is a provisional 31-way logical placeholder, excluded from BOM/board. NO physical pin mapping assigned.
QSPI and touch levels/rails/sequencing: require corrected supplier specification. No devboard pinout used.
Touch level translation/isolation is OPEN; do not wire the 3V3 GPIO directly to a possibly 1V8 FPC.
Panel rails, panel power switches, FPC pin1/contact orientation and mating connector remain unassigned.
