Ale1x/auto-gauge/hardware/06_LIGHT_SENSOR.kicad_sch

## KiCad design hardware/06_LIGHT_SENSOR.kicad_sch (2026-10-24)

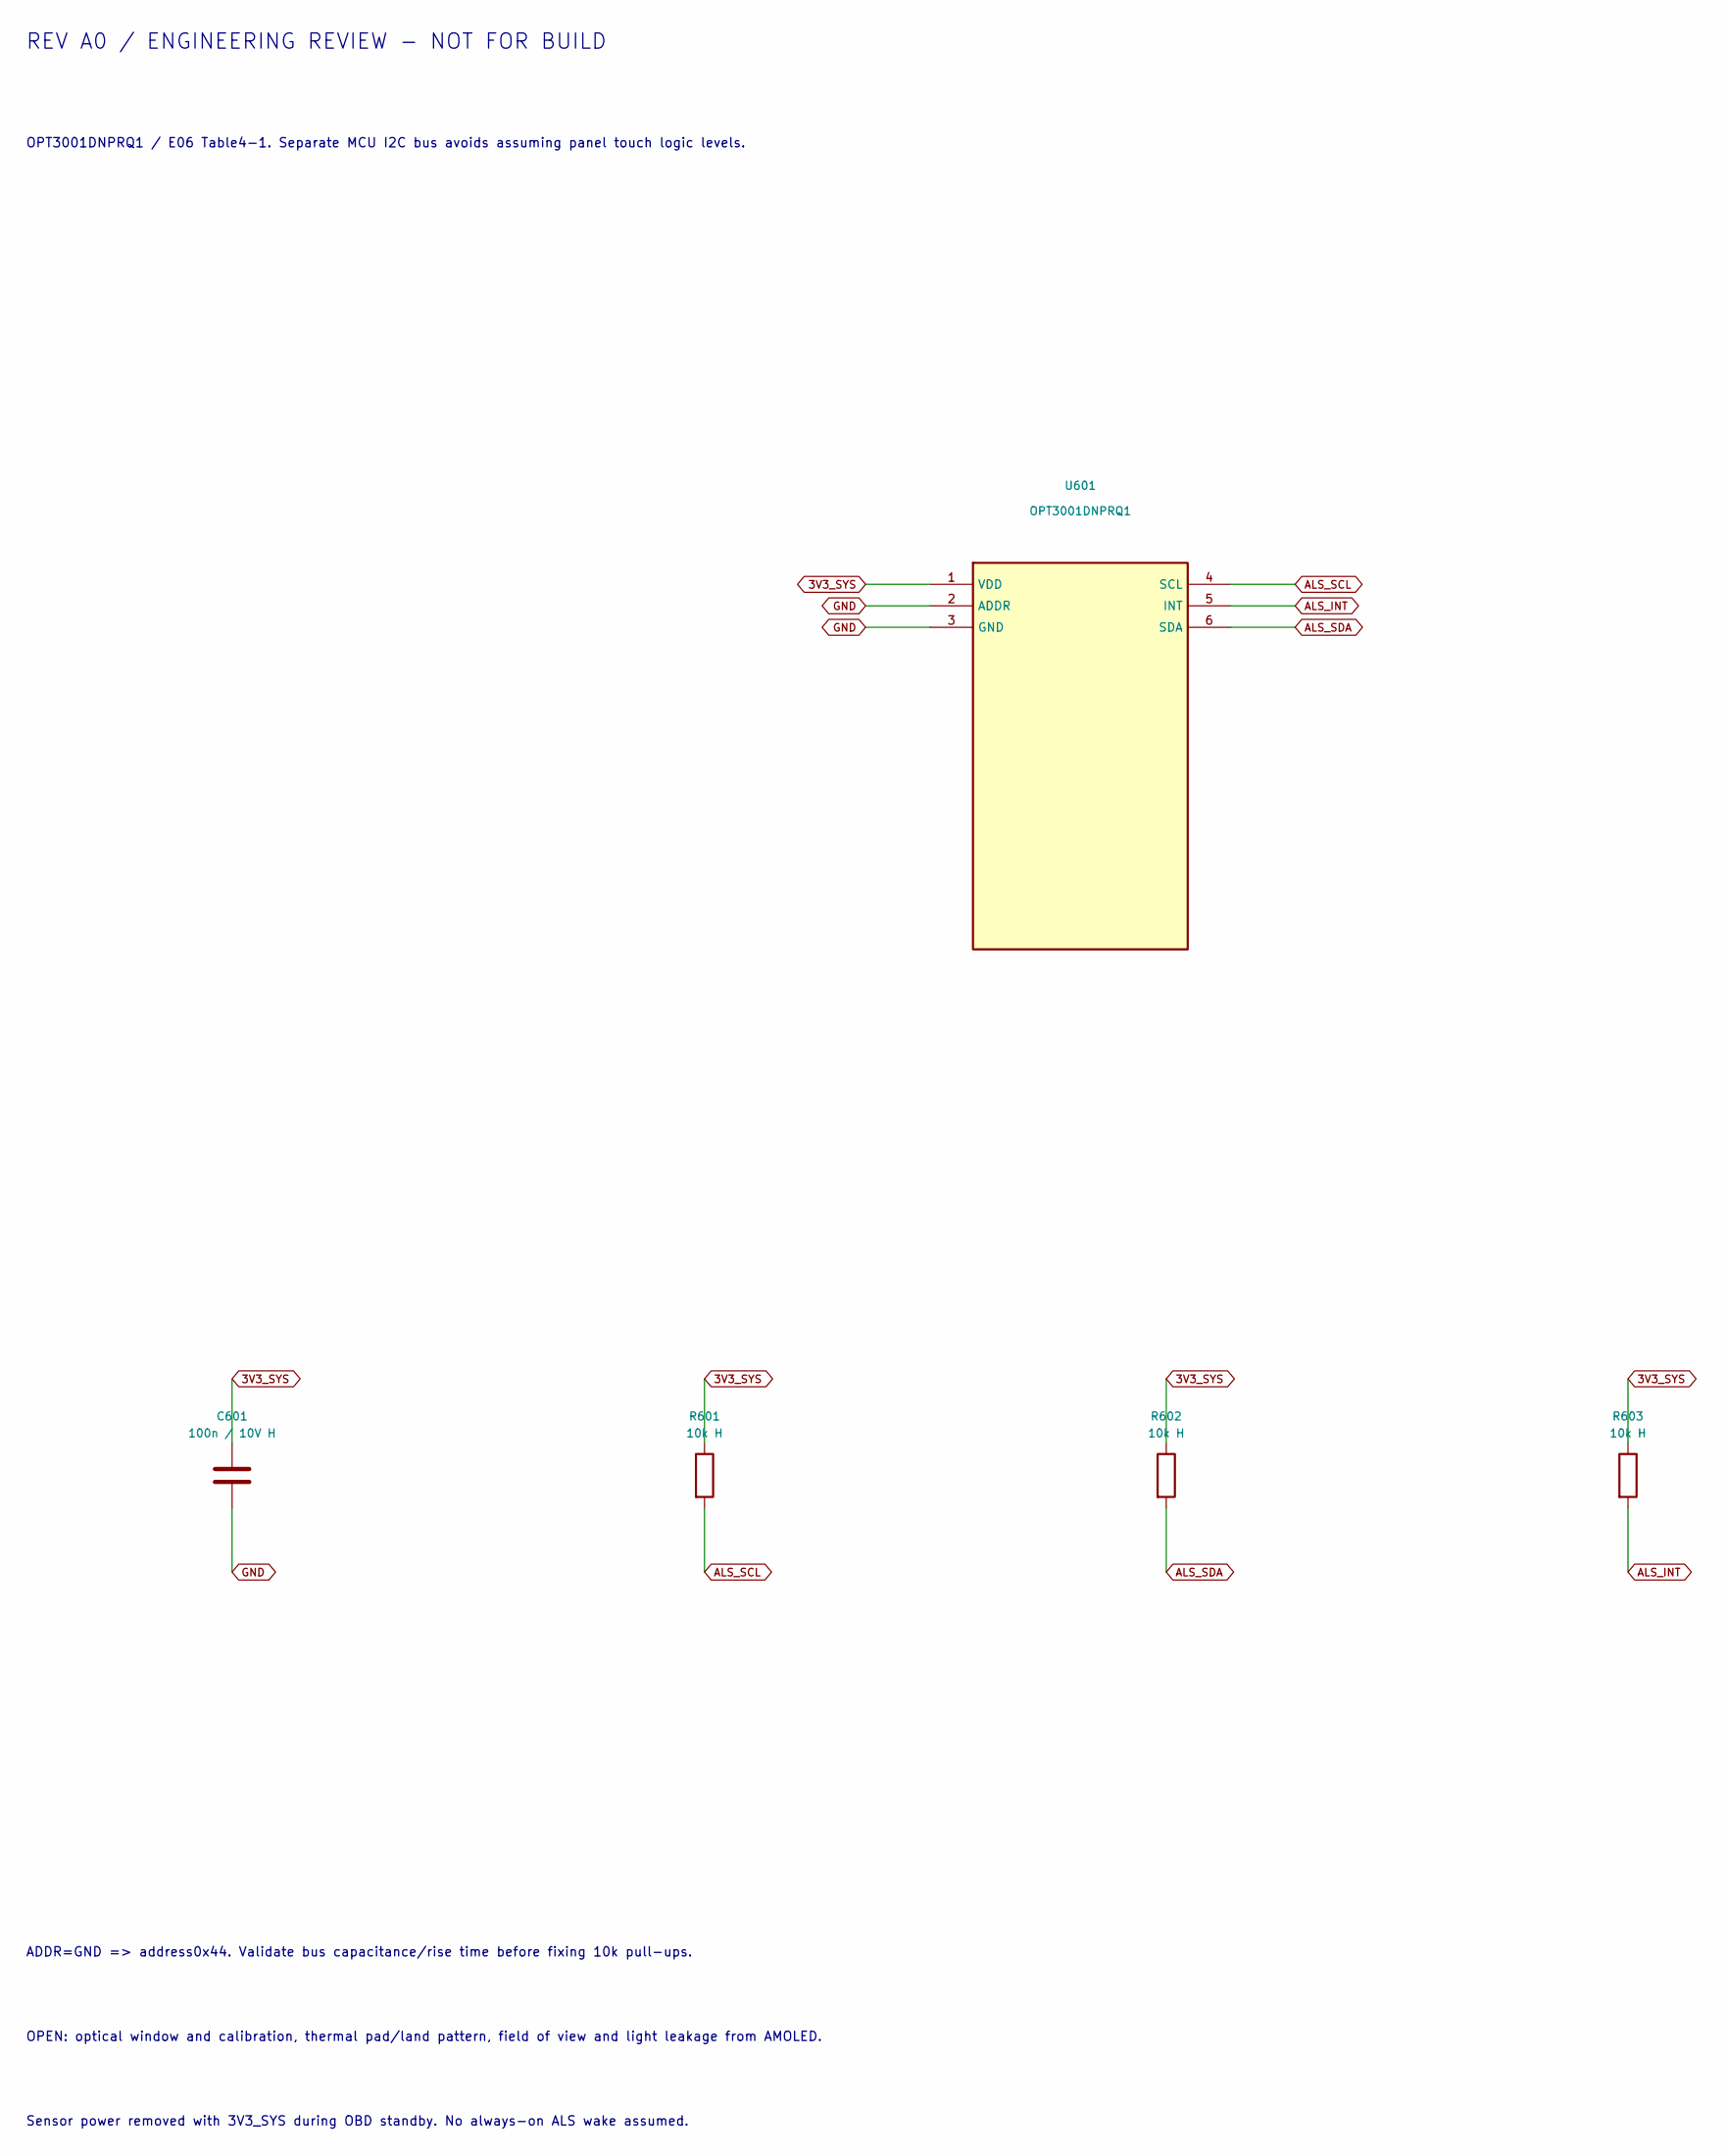
[picture p121: schematic 06_LIGHT_SENSOR.kicad_sch]

Parts:
C601: 100n / 10V H; MPN TBD
R601, R602, R603: 10k H; MPN TBD
U601: OPT3001DNPRQ1; MPN OPT3001DNPRQ1

Connections:
3V3_SYS: C601.1, R601.1, R602.1, R603.1, U601.1 (VDD)
ALS_INT: R603.2, U601.5 (INT)
ALS_SCL: R601.2, U601.4 (SCL)
ALS_SDA: R602.2, U601.6 (SDA)
GND: C601.2, U601.2 (ADDR), U601.3 (GND)

Notes on the sheet:
REV A0 / ENGINEERING REVIEW - NOT FOR BUILD
OPT3001DNPRQ1 / E06 Table4-1. Separate MCU I2C bus avoids assuming panel touch logic levels.
ADDR=GND => address0x44. Validate bus capacitance/rise time before fixing 10k pull-ups.
OPEN: optical window and calibration, thermal pad/land pattern, field of view and light leakage from AMOLED.
Sensor power removed with 3V3_SYS during OBD standby. No always-on ALS wake assumed.
