Ale1x/auto-gauge/hardware/07_TEST_SERVICE.kicad_sch

## KiCad design hardware/07_TEST_SERVICE.kicad_sch (2026-10-24)

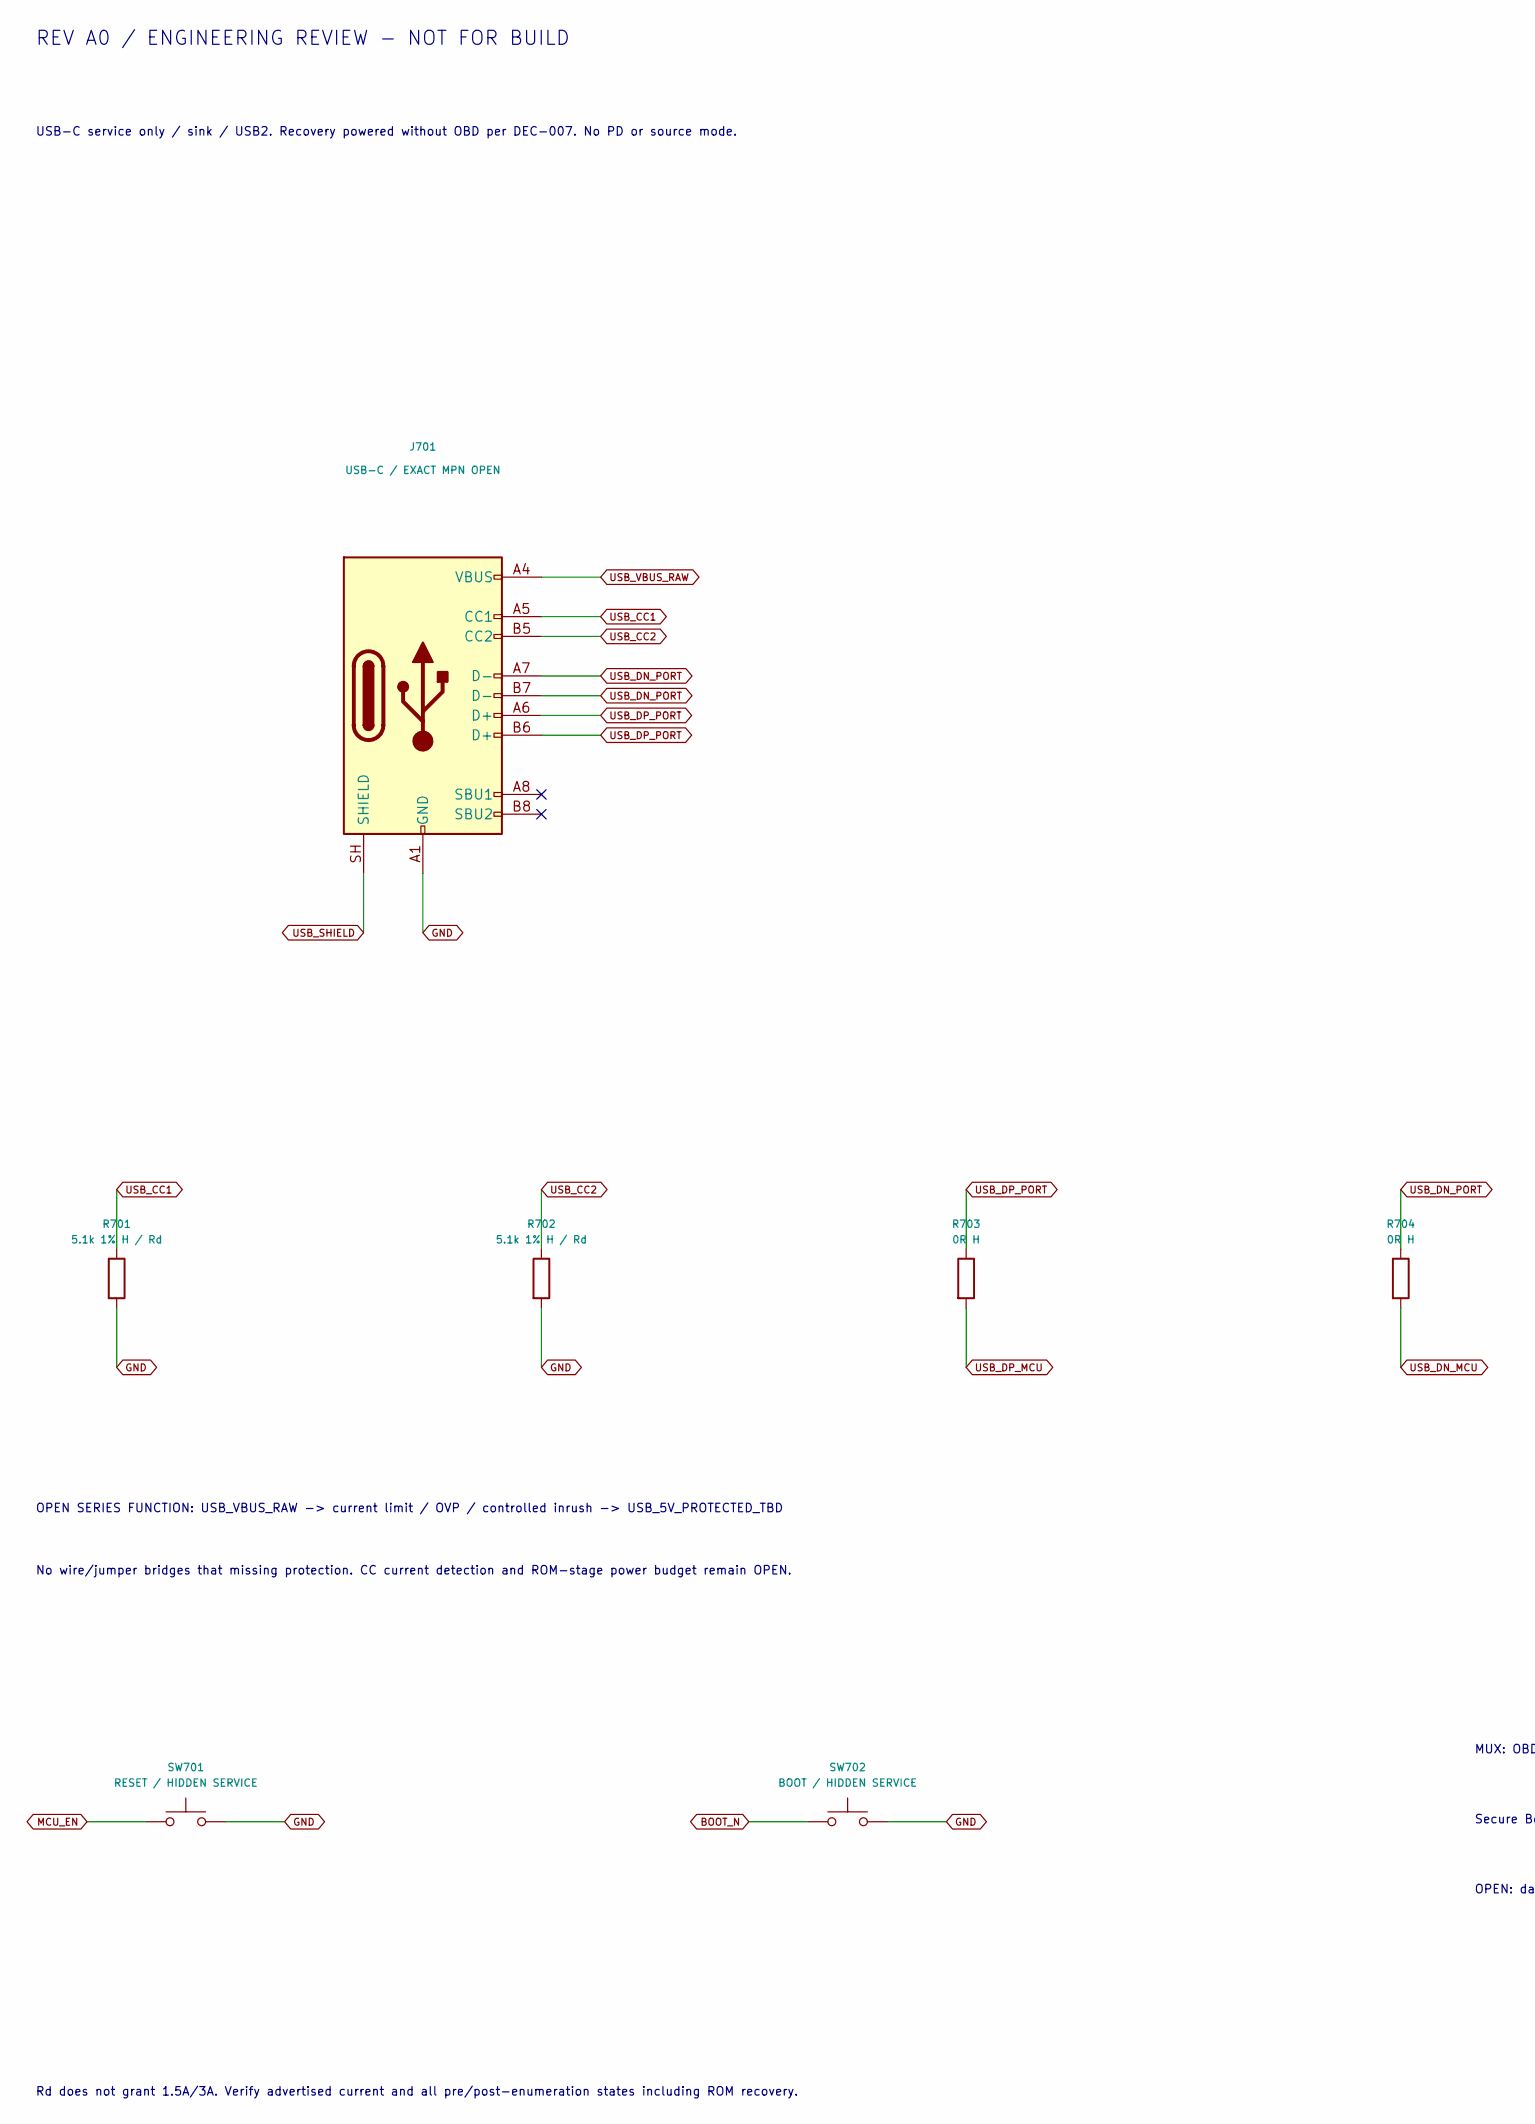
[picture p122: schematic 07_TEST_SERVICE.kicad_sch, part in row 1, column 1]

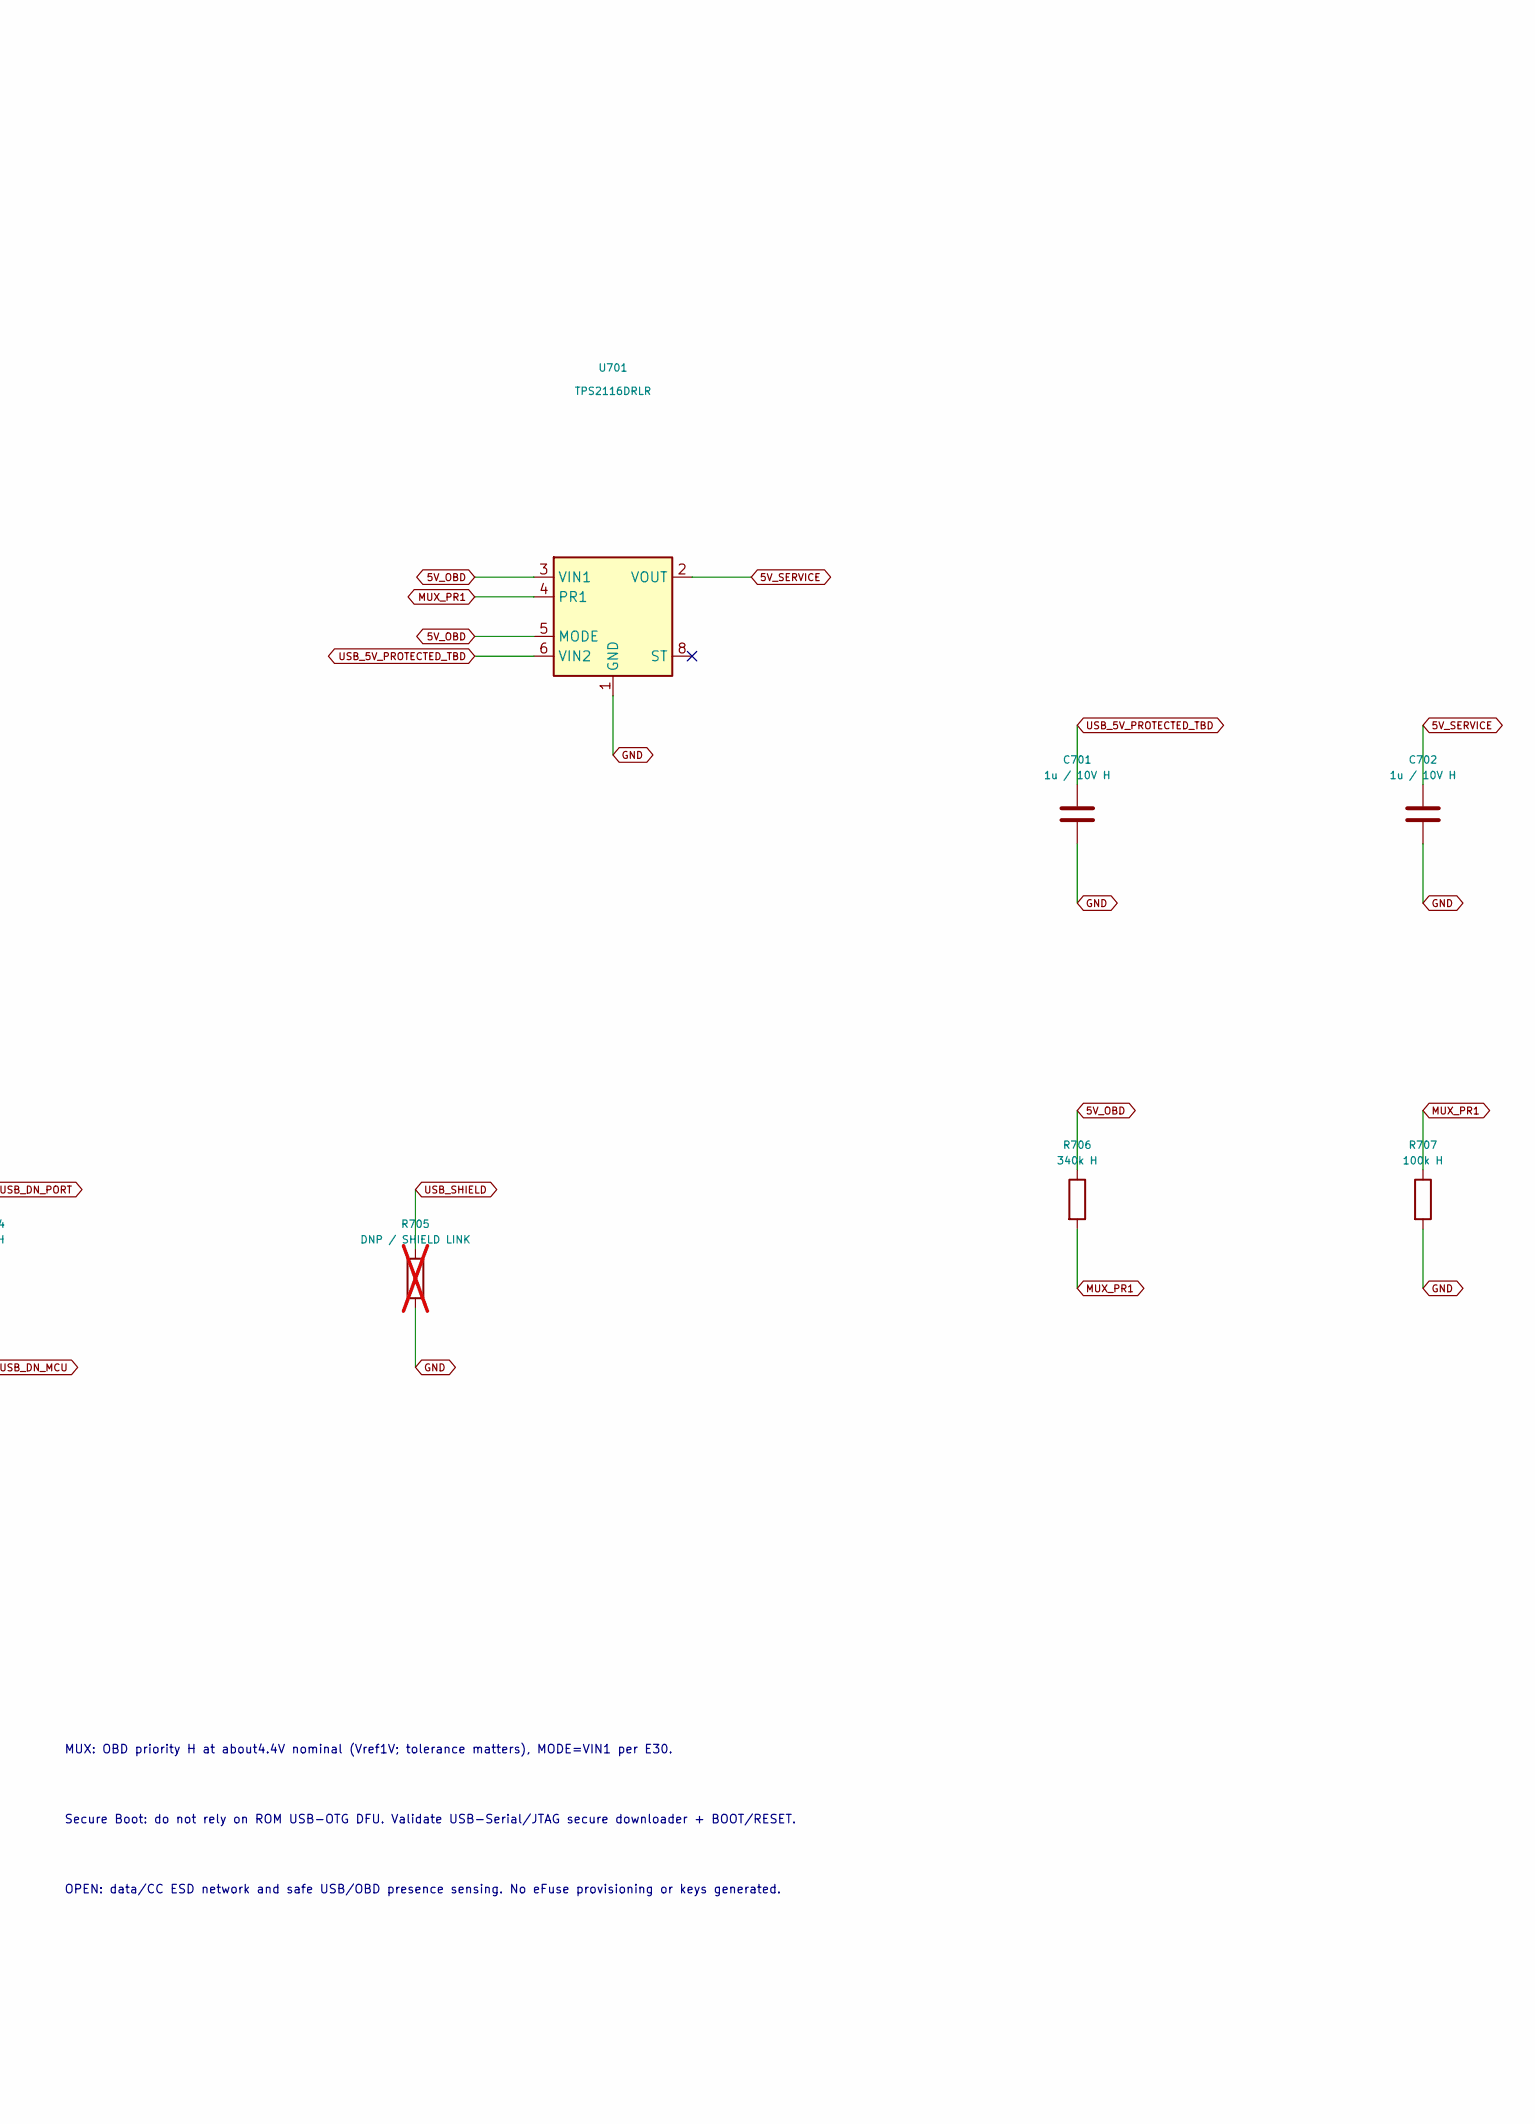
[picture p123: schematic 07_TEST_SERVICE.kicad_sch, part in row 1, column 2]

Parts:
C701, C702: 1u / 10V H; MPN TBD
J701: USB-C / EXACT MPN OPEN; MPN TBD
R701, R702: 5.1k 1% H / Rd; MPN TBD
R703, R704: 0R H; MPN TBD
R705: DNP / SHIELD LINK; MPN TBD; not fitted
R706: 340k H; MPN TBD
R707: 100k H; MPN TBD
SW701: RESET / HIDDEN SERVICE; MPN TBD
SW702: BOOT / HIDDEN SERVICE; MPN TBD
U701: TPS2116DRLR; SOT-583-8; MPN TPS2116DRLR

Connections:
5V_OBD: R706.1, U701.3 (VIN1), U701.5 (MODE)
5V_SERVICE: C702.1, U701.2 (VOUT), U701.7 (VOUT)
BOOT_N: SW702.1
GND: C701.2, C702.2, J701.A1 (GND), J701.A12 (GND), J701.B1 (GND), J701.B12 (GND), R701.2, R702.2, R705.2, R707.2, SW701.2, SW702.2, U701.1 (GND)
MCU_EN: SW701.1
MUX_PR1: R706.2, R707.1, U701.4 (PR1)
USB_5V_PROTECTED_TBD: C701.1, U701.6 (VIN2)
USB_CC1: J701.A5 (CC1), R701.1
USB_CC2: J701.B5 (CC2), R702.1
USB_DN_MCU: R704.2
USB_DN_PORT: J701.A7 (D-), J701.B7 (D-), R704.1
USB_DP_MCU: R703.2
USB_DP_PORT: J701.A6 (D+), J701.B6 (D+), R703.1
USB_SHIELD: J701.SH (SHIELD), R705.1
USB_VBUS_RAW: J701.A4 (VBUS), J701.A9 (VBUS), J701.B4 (VBUS), J701.B9 (VBUS)

Notes on the sheet:
REV A0 / ENGINEERING REVIEW - NOT FOR BUILD
USB-C service only / sink / USB2. Recovery powered without OBD per DEC-007. No PD or source mode.
OPEN SERIES FUNCTION: USB_VBUS_RAW -> current limit / OVP / controlled inrush -> USB_5V_PROTECTED_TBD
No wire/jumper bridges that missing protection. CC current detection and ROM-stage power budget remain OPEN.
MUX: OBD priority H at about4.4V nominal (Vref1V; tolerance matters), MODE=VIN1 per E30.
Secure Boot: do not rely on ROM USB-OTG DFU. Validate USB-Serial/JTAG secure downloader + BOOT/RESET.
OPEN: data/CC ESD network and safe USB/OBD presence sensing. No eFuse provisioning or keys generated.
Rd does not grant 1.5A/3A. Verify advertised current and all pre/post-enumeration states including ROM recovery.
