Ale1x/auto-gauge/hardware/presence_sensing/presence_sensing_study.kicad_sch

## KiCad design hardware/presence_sensing/presence_sensing_study.kicad_sch (2026-10-24)

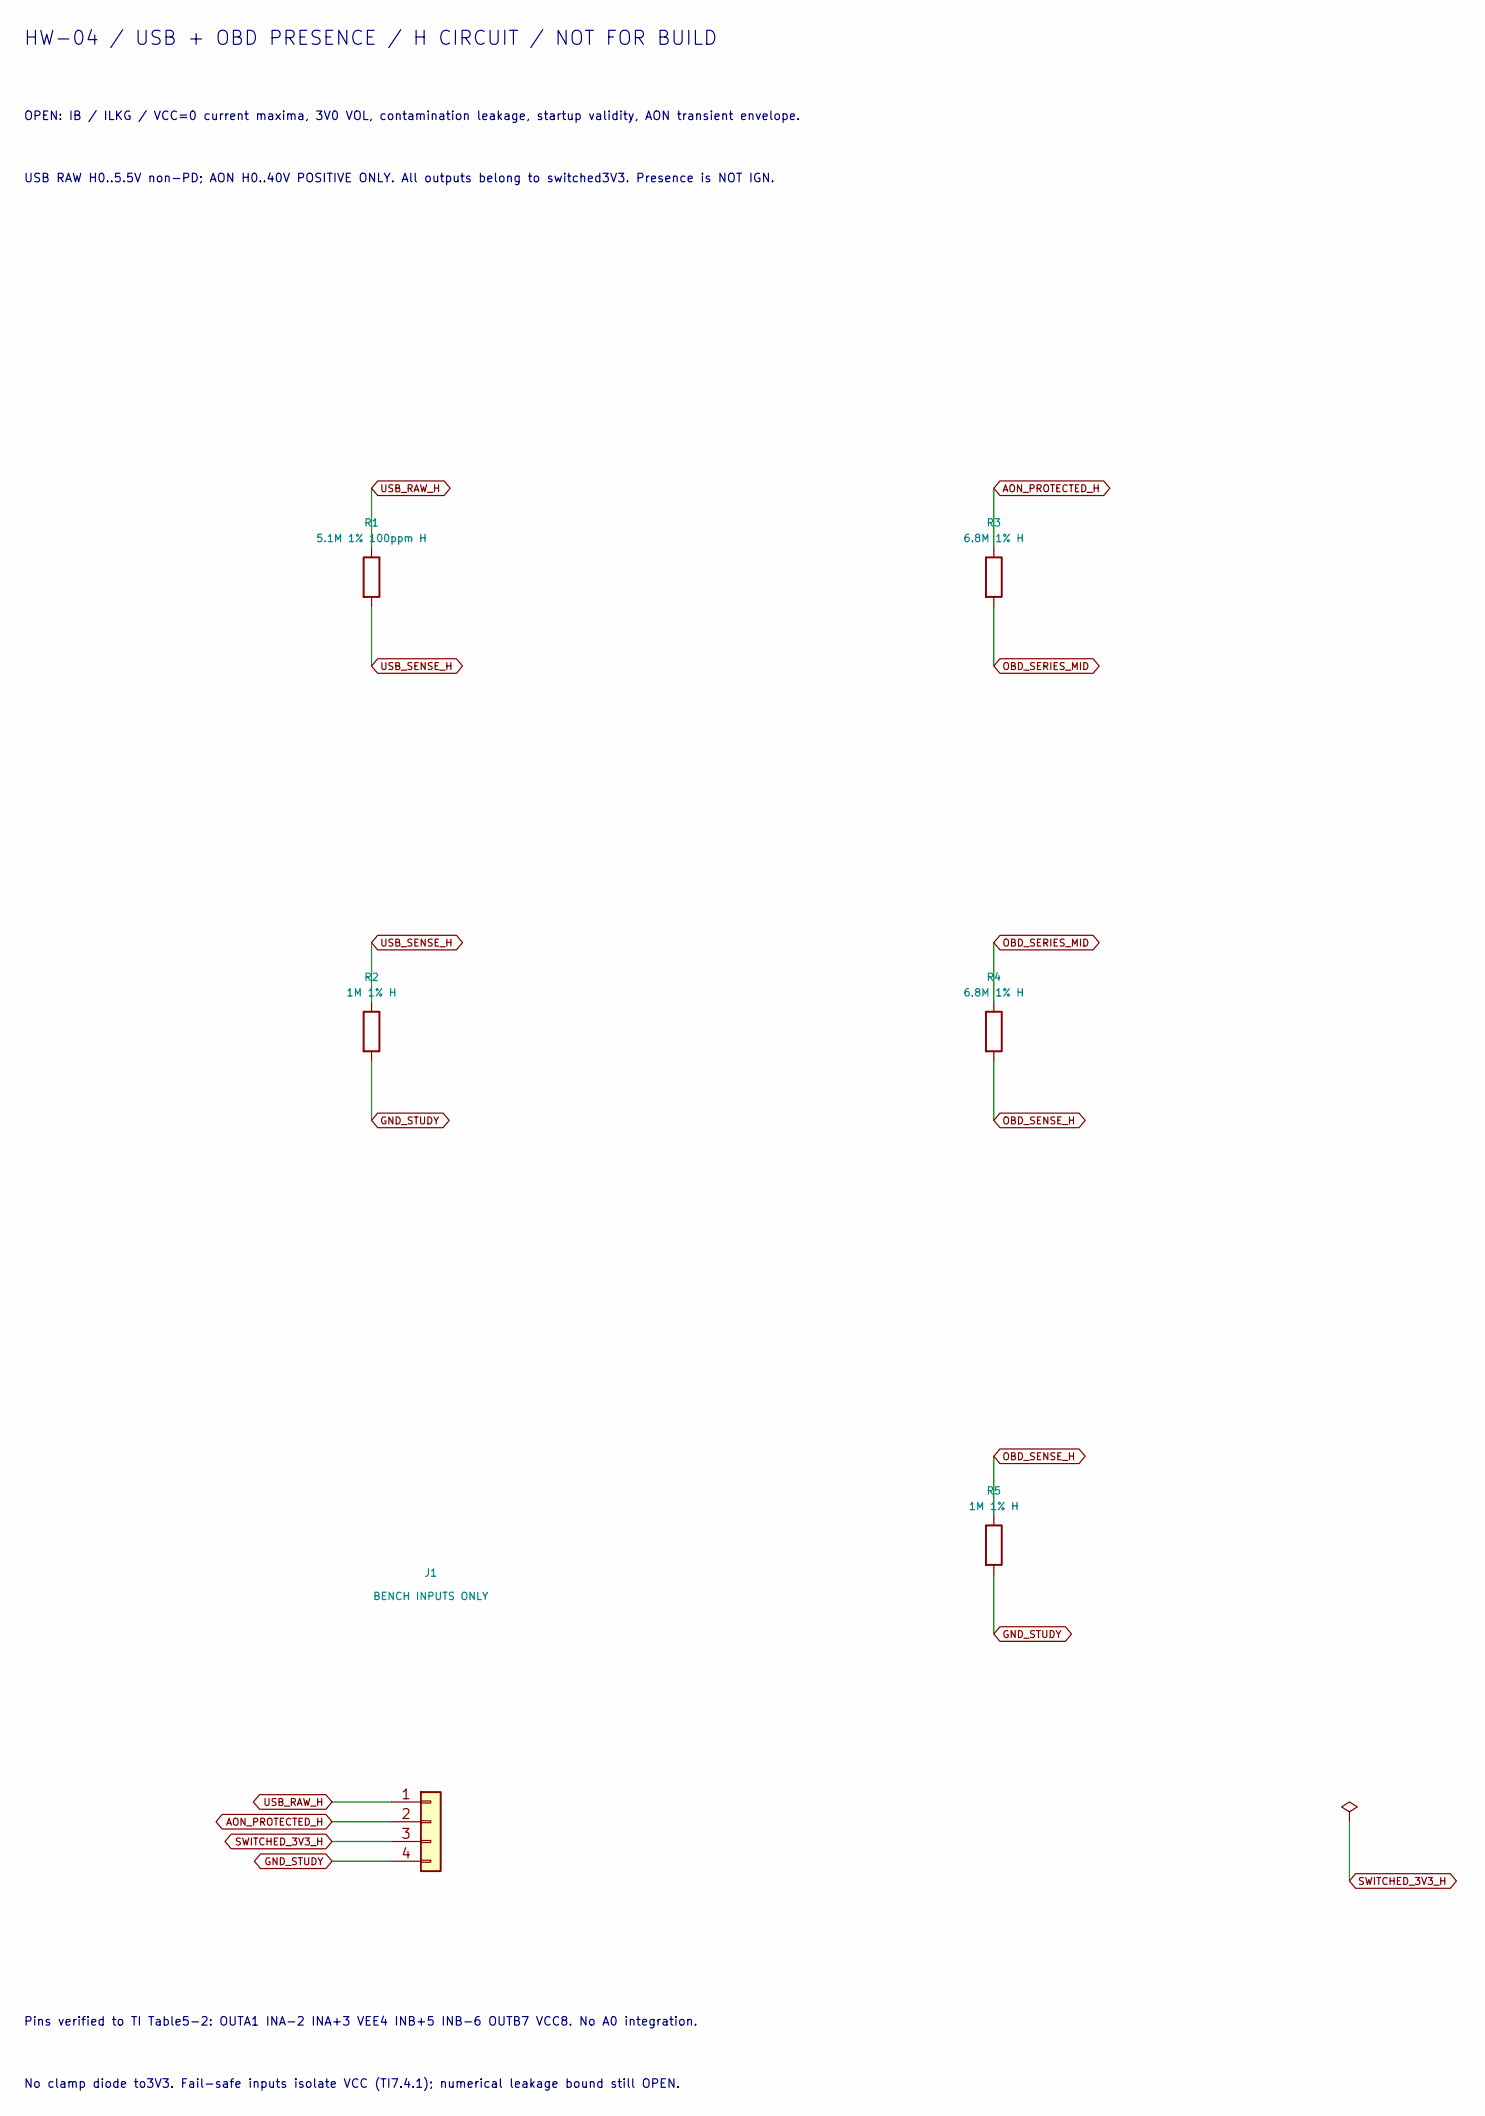
[picture p124: schematic presence_sensing_study.kicad_sch, part in row 1, column 1]

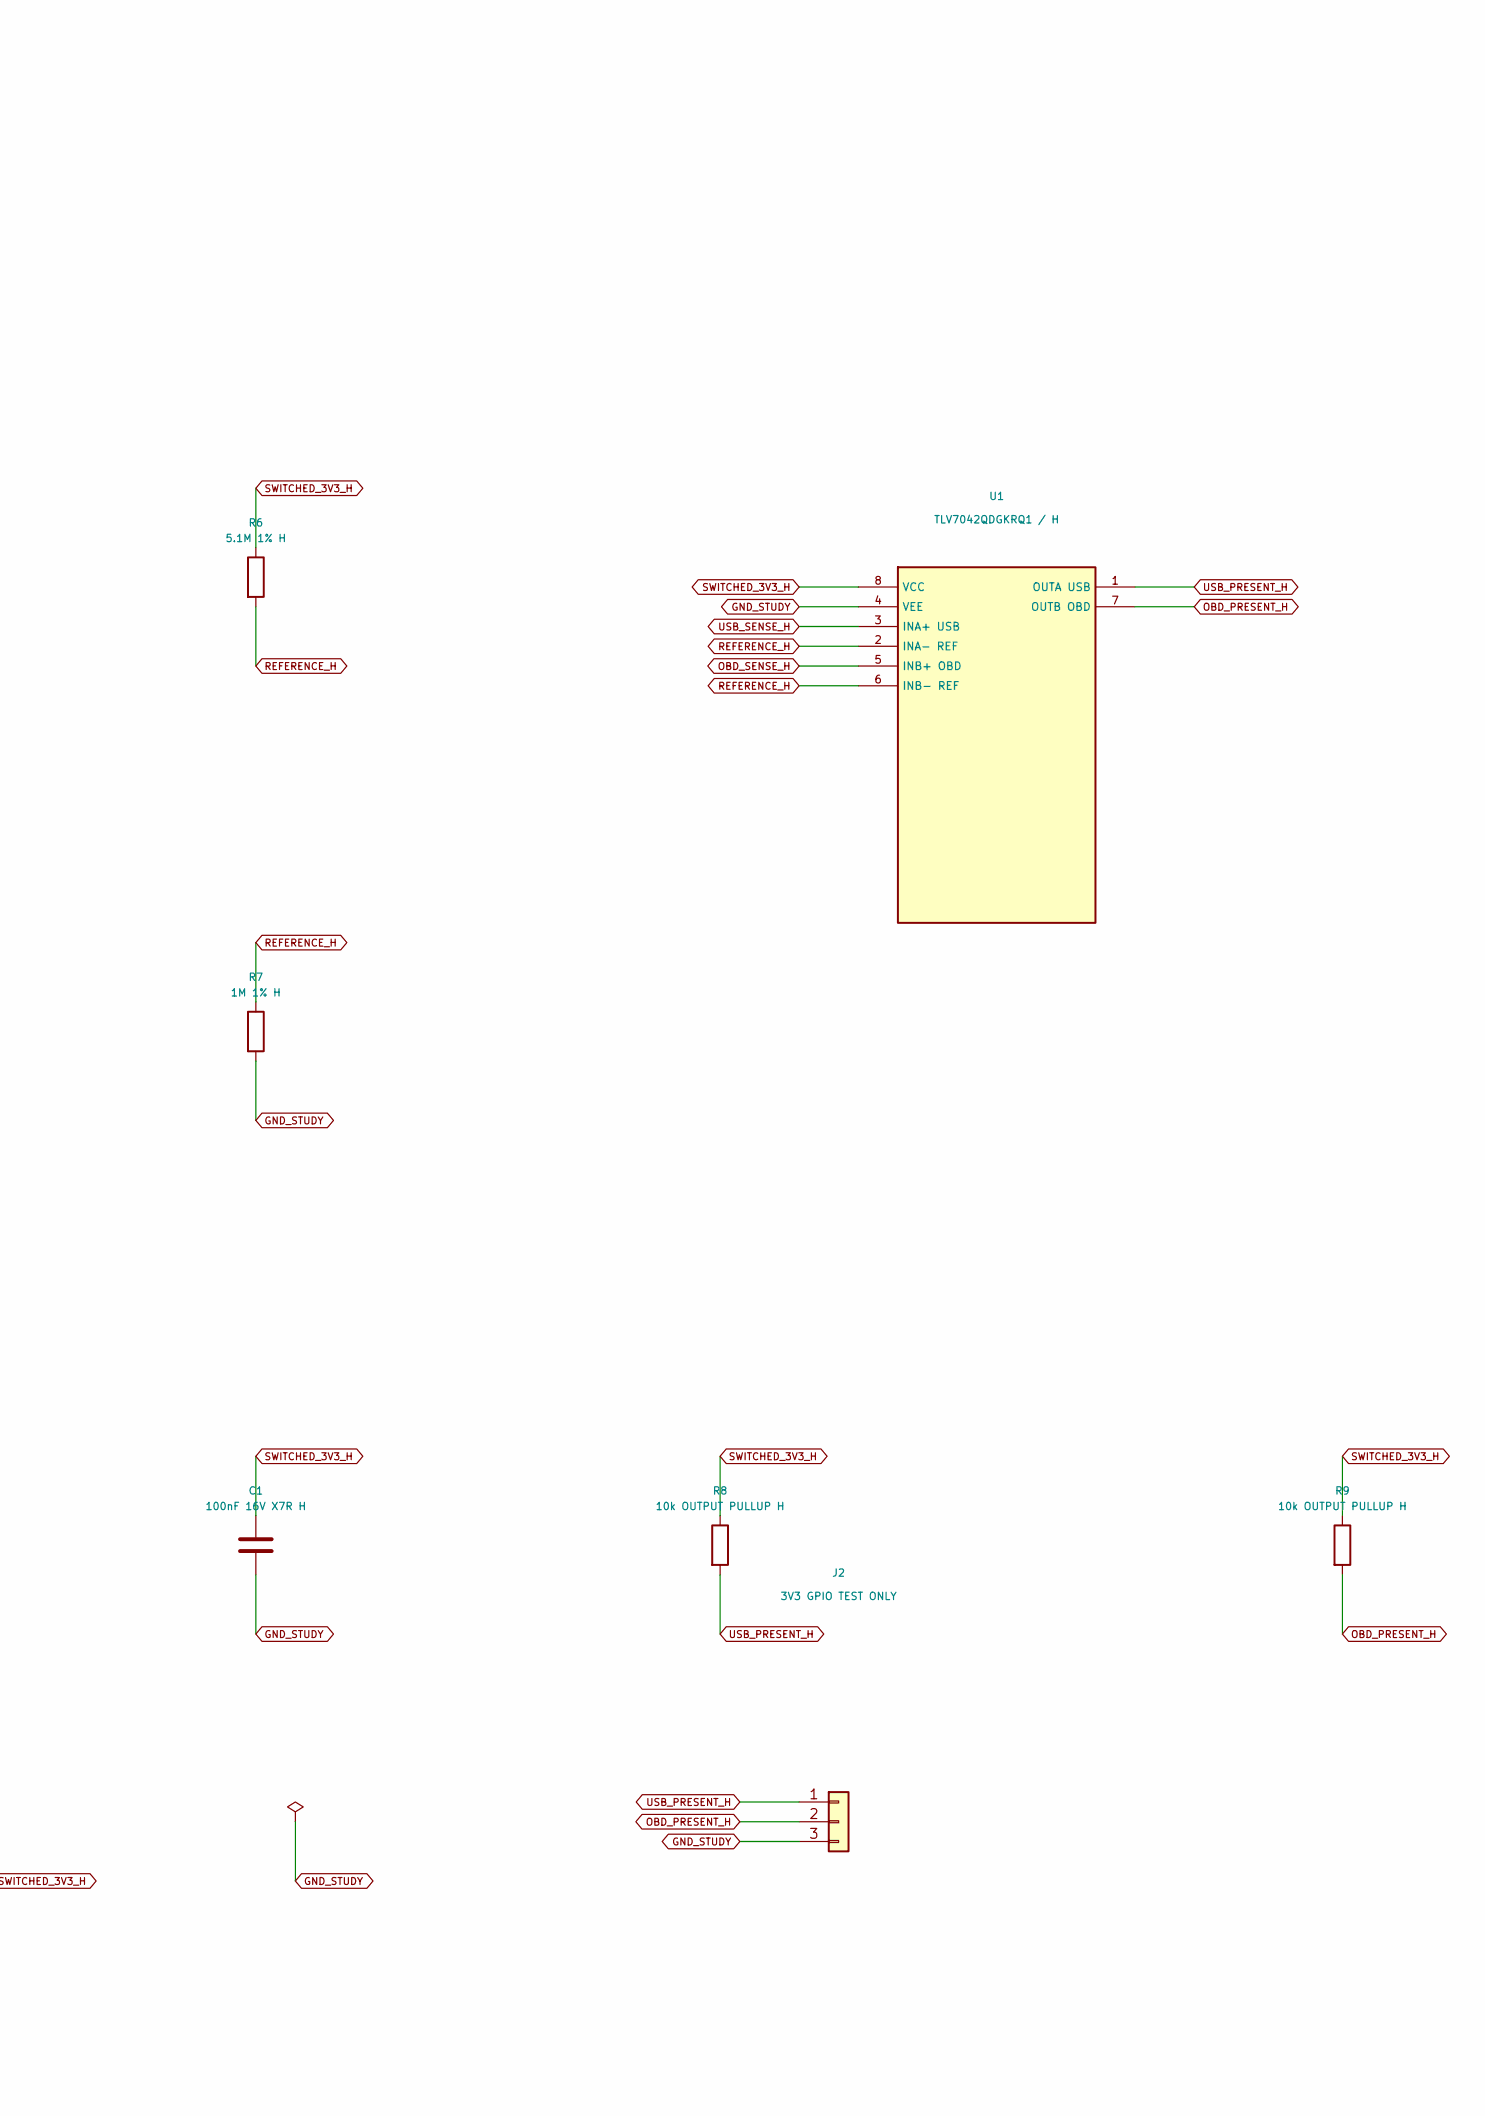
[picture p125: schematic presence_sensing_study.kicad_sch, part in row 1, column 2]

Parts:
C1: 100nF 16V X7R H; C_0603_1608Metric; MPN GRM188R71C104KA01D
J1: BENCH INPUTS ONLY; MPN TBD
J2: 3V3 GPIO TEST ONLY; MPN TBD
R1: 5.1M 1% 100ppm H; R_0603_1608Metric; MPN RC0603FR-075M1L
R2, R5, R7: 1M 1% H; R_0603_1608Metric; MPN RC0603FR-071ML
R3, R4: 6.8M 1% H; R_0603_1608Metric; MPN RC0603FR-076M8L
R6: 5.1M 1% H; R_0603_1608Metric; MPN RC0603FR-075M1L
R8, R9: 10k OUTPUT PULLUP H; R_0603_1608Metric; MPN RC0603FR-0710KL
U1: TLV7042QDGKRQ1 / H; VSSOP-8_3x3mm_P0.65mm; MPN TLV7042QDGKRQ1

Connections:
AON_PROTECTED_H: J1.2, R3.1
GND_STUDY: C1.2, J1.4, J2.3, R2.2, R5.2, R7.2, U1.4 (VEE)
OBD_PRESENT_H: J2.2, R9.2, U1.7 (OUTB OBD)
OBD_SENSE_H: R4.2, R5.1, U1.5 (INB+ OBD)
OBD_SERIES_MID: R3.2, R4.1
REFERENCE_H: R6.2, R7.1, U1.2 (INA- REF), U1.6 (INB- REF)
SWITCHED_3V3_H: C1.1, J1.3, R6.1, R8.1, R9.1, U1.8 (VCC)
USB_PRESENT_H: J2.1, R8.2, U1.1 (OUTA USB)
USB_RAW_H: J1.1, R1.1
USB_SENSE_H: R1.2, R2.1, U1.3 (INA+ USB)

Notes on the sheet:
HW-04 / USB + OBD PRESENCE / H CIRCUIT / NOT FOR BUILD
OPEN: IB / ILKG / VCC=0 current maxima, 3V0 VOL, contamination leakage, startup validity, AON transient envelope.
USB RAW H0..5.5V non-PD; AON H0..40V POSITIVE ONLY. All outputs belong to switched3V3. Presence is NOT IGN.
Pins verified to TI Table5-2: OUTA1 INA-2 INA+3 VEE4 INB+5 INB-6 OUTB7 VCC8. No A0 integration.
No clamp diode to3V3. Fail-safe inputs isolate VCC (TI7.4.1); numerical leakage bound still OPEN.
