Ale1x/auto-gauge/hardware/usb_power/design_v01/usb_preregulator_study.kicad_sch

## KiCad design hardware/usb_power/design_v01/usb_preregulator_study.kicad_sch (2026-10-24)

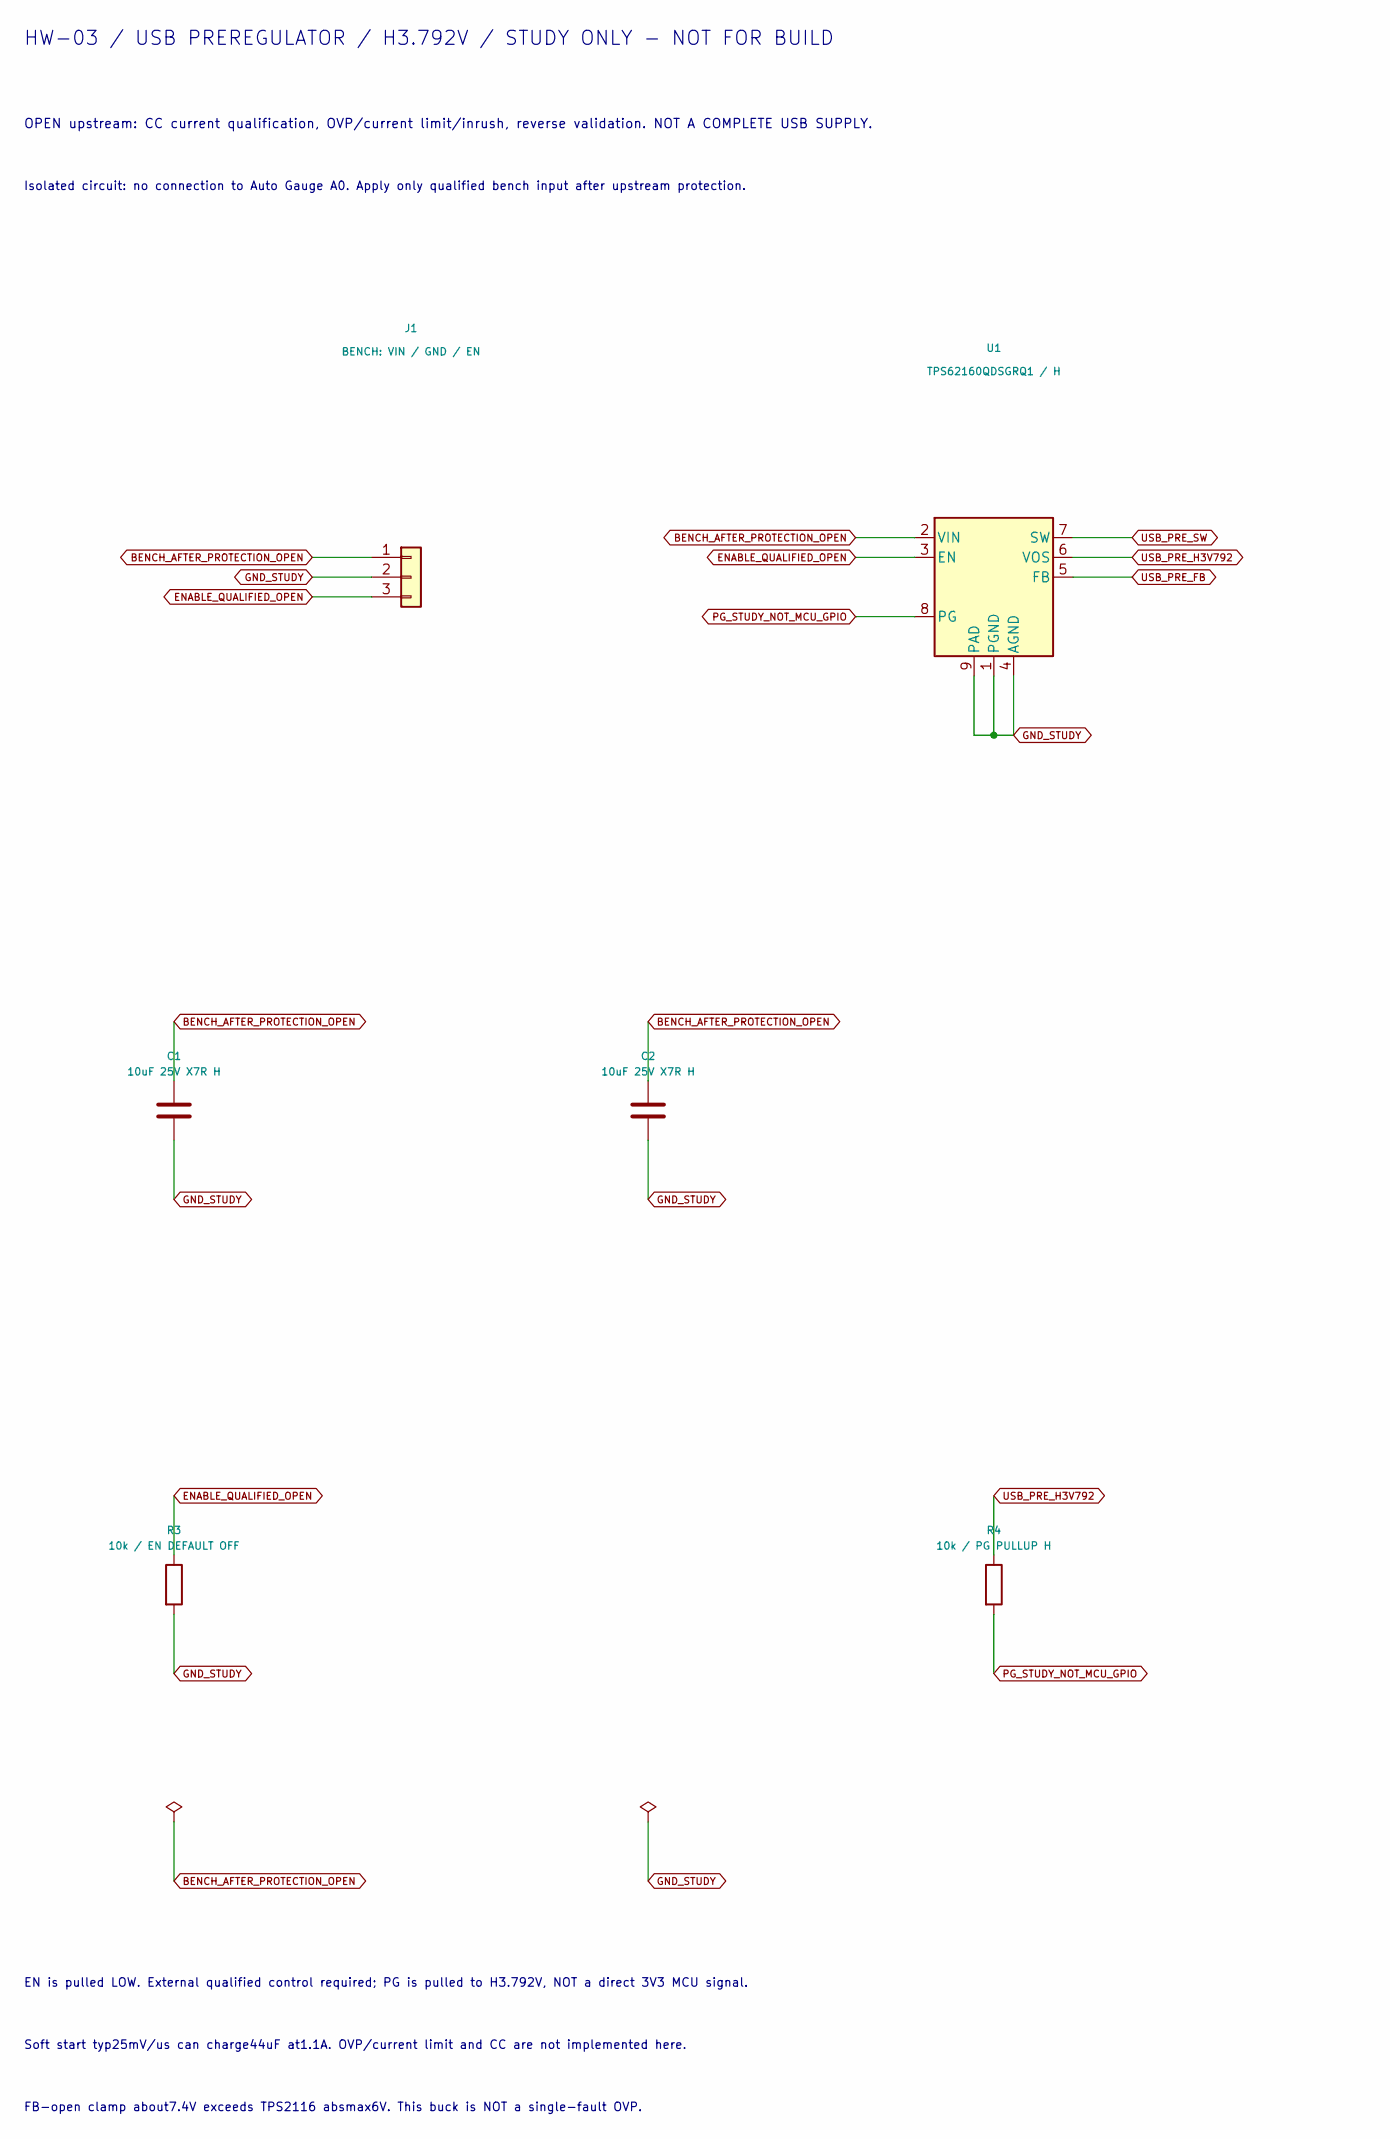
[picture p126: schematic usb_preregulator_study.kicad_sch, part in row 1, column 1]

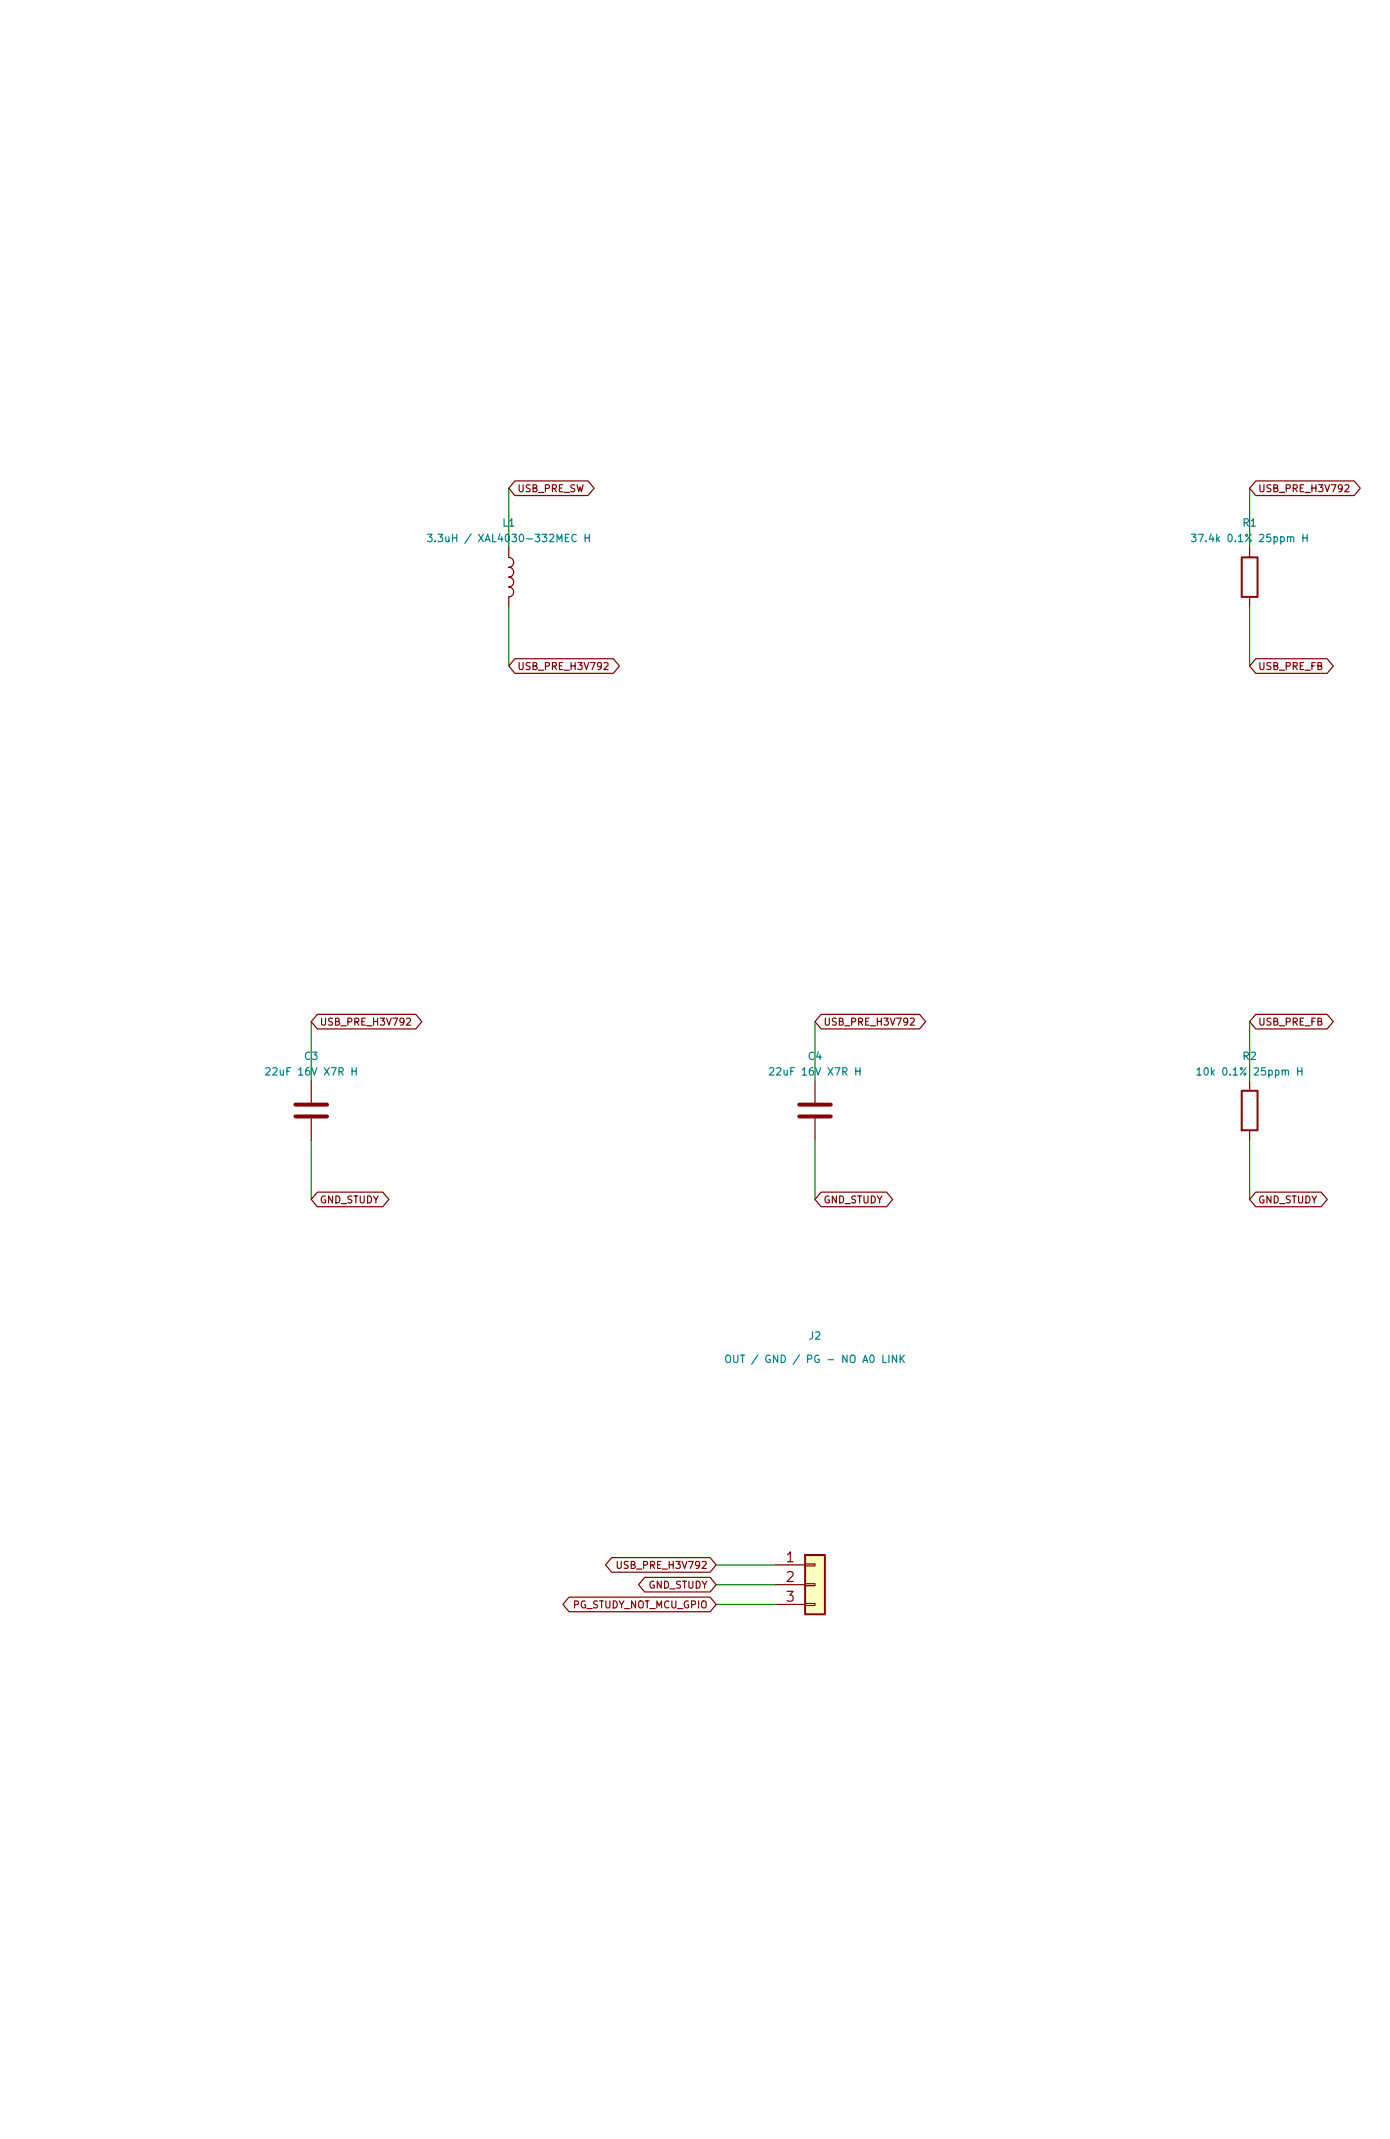
[picture p127: schematic usb_preregulator_study.kicad_sch, part in row 1, column 2]

Parts:
C1, C2: 10uF 25V X7R H; C_1206_3216Metric; MPN GRM31CR71E106KA12L
C3, C4: 22uF 16V X7R H; C_1210_3225Metric; MPN CGA6P1X7R1C226M250AC
J1: BENCH: VIN / GND / EN; MPN TBD
J2: OUT / GND / PG - NO A0 LINK; MPN TBD
L1: 3.3uH / XAL4030-332MEC H; MPN XAL4030-332MEC
R1: 37.4k 0.1% 25ppm H; R_0603_1608Metric; MPN AT0603BRD0737K4L
R2: 10k 0.1% 25ppm H; R_0603_1608Metric; MPN AT0603BRD0710KL
R3: 10k / EN DEFAULT OFF; R_0603_1608Metric; MPN AT0603BRD0710KL
R4: 10k / PG PULLUP H; R_0603_1608Metric; MPN AT0603BRD0710KL
U1: TPS62160QDSGRQ1 / H; MPN TPS62160QDSGRQ1

Connections:
BENCH_AFTER_PROTECTION_OPEN: C1.1, C2.1, J1.1, U1.2 (VIN)
ENABLE_QUALIFIED_OPEN: J1.3, R3.1, U1.3 (EN)
GND_STUDY: C1.2, C2.2, C3.2, C4.2, J1.2, J2.2, R2.2, R3.2, U1.1 (PGND), U1.4 (AGND), U1.9 (PAD)
PG_STUDY_NOT_MCU_GPIO: J2.3, R4.2, U1.8 (PG)
USB_PRE_FB: R1.2, R2.1, U1.5 (FB)
USB_PRE_H3V792: C3.1, C4.1, J2.1, L1.2, R1.1, R4.1, U1.6 (VOS)
USB_PRE_SW: L1.1, U1.7 (SW)

Notes on the sheet:
HW-03 / USB PREREGULATOR / H3.792V / STUDY ONLY - NOT FOR BUILD
OPEN upstream: CC current qualification, OVP/current limit/inrush, reverse validation. NOT A COMPLETE USB SUPPLY.
Isolated circuit: no connection to Auto Gauge A0. Apply only qualified bench input after upstream protection.
EN is pulled LOW. External qualified control required; PG is pulled to H3.792V, NOT a direct 3V3 MCU signal.
Soft start typ25mV/us can charge44uF at1.1A. OVP/current limit and CC are not implemented here.
FB-open clamp about7.4V exceeds TPS2116 absmax6V. This buck is NOT a single-fault OVP.
