Ale1x/auto-gauge/scripts/check_software.py

#!/usr/bin/env python3
"""Run host, Swift and simulator build checks in disposable directories."""
import argparse
from pathlib import Path
import shutil
import sys
import tempfile
from check_host import check_host,run

ROOT = Path(__file__).resolve().parents[1]


def main():
    parser = argparse.ArgumentParser(description=__doc__)
    parser.add_argument('--skip-ios-build', action='store_true',
                        help='Check shared fixtures, C host core and Swift package only')
    args = parser.parse_args()
    for executable in ('cmake', 'swift'):
        if shutil.which(executable) is None:
            raise SystemExit(f'Required development tool missing: {executable}')
    if not args.skip_ios_build and shutil.which('xcodebuild') is None:
        raise SystemExit('xcodebuild missing; use --skip-ios-build for host checks only')
    with tempfile.TemporaryDirectory(prefix='auto-gauge-check-') as temp:
        scratch = Path(temp)
        check_host(scratch/'firmware')
        run(['swift', 'test', '--package-path', ROOT / 'mobile',
             '--scratch-path', scratch / 'swift'])
        if not args.skip_ios_build:
            run(['xcodebuild', '-quiet', '-project', ROOT / 'mobile/AutoGauge.xcodeproj',
                 '-scheme', 'AutoGauge', '-configuration', 'Debug',
                 '-destination', 'generic/platform=iOS Simulator',
                 '-derivedDataPath', scratch / 'ios', 'CODE_SIGNING_ALLOWED=NO', 'build'])
    print('Software checks passed. No ESP-IDF/device, BLE, cloud or automotive validation performed.')


if __name__ == '__main__':
    main()
