Ale1x/auto-gauge/firmware/tests/test_journal_golden.c

#include "ag_journal_history.h"
#include "ag_flash_history_sim.h"
#include "history_fixture.h"
#include <assert.h>
#include <stdio.h>
#include <string.h>

static ag_journal_io_t journal_io(ag_flash_history_sim_t *sim) {
    ag_flash_history_io_t io = ag_flash_history_sim_io(sim);
    return (ag_journal_io_t){io.context, io.read, io.program, io.erase_sector};
}

static void test_shared_golden_pages(void) {
    unsigned pages = 0;
    for (size_t f = 0; f < kHistoryFixtureCount; ++f) {
        const ag_history_fixture_t *fixture = &kHistoryFixtures[f];
        uint8_t bytes[8192], filler_sid[16] = {0x80, 0};
        ag_flash_history_sim_t sim;
        ag_journal_history_t store;
        assert(ag_flash_history_sim_init(&sim, bytes, sizeof(bytes)));
        ag_journal_io_t io = journal_io(&sim);
        assert(ag_journal_open(&store, &io, 2) == AG_JOURNAL_EMPTY);
        const bool overwritten = fixture->record_count > fixture->capacity;
        unsigned filler = 0;
        assert(ag_journal_bootstrap(&store, overwritten ? filler_sid : fixture->session,
            fixture->first_sequence, 1) == AG_JOURNAL_OK);
        if (overwritten) {
            /* The shared four-record ring retains samples3..6. Journal eviction
             * is whole-sector: position its session-start at entry28, samples1/2
             * at29/30, then reclaim that sector using unrelated session controls.
             * This is fixture setup, not a four-record journal capacity claim. */
            assert(fixture->capacity == 4 && fixture->record_count == 6);
            for (unsigned n = 0; n < 27; ++n) {
                filler_sid[1] = (uint8_t)++filler;
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
