Ale1x/auto-gauge/(commit log)

2026-10-24 Document initial K0 feasibility and external diameter decision
    [BOM_CANDIDATES.csv]
2026-10-24 Allow modest enclosure diameter increase and assess 52 mm candidate
    [BOM_CANDIDATES.csv]
2026-10-24 Extend K0 display sourcing and document mechanical RF and memory constraints
    [BOM_CANDIDATES.csv]
2026-10-24 Record approved scope logging and standby targets and extend K0 analysis
    [BOM_CANDIDATES.csv, hw_ign_samples.csv]
2026-10-24 Add KiCad A0 review schematic, connectivity checks and documented open blockers
    [01_OBD_INPUT.kicad_sch, 02_AUTOMOTIVE_POWER.kicad_sch, 03_MCU_MEMORY_BLE.kicad_sch, 04_CAN_PHY.kicad_sch, 05_AMOLED_TOUCH.kicad_sch, 06_LIGHT_SENSOR.kicad_sch, 07_TEST_SERVICE.kicad_sch, BOM_CANDIDATES.csv]
2026-10-24 Screen 5V feedback alternatives and reject false-clean ERC summaries
    [02_AUTOMOTIVE_POWER.kicad_sch, buck5_ripple_screen.csv]
2026-10-24 Advance parallel editor diagnostics and bounded protocol references
    [current_limit_screen.csv, fault_charge_sensitivity.csv, inrush_screen.csv, ovp_thresholds.csv, preregulator_voltage_screen.csv, usb_cascade_power.csv, wake_architecture_screen.csv]
2026-10-24 Allow sequential BLE clients and integrate local history imports
    [rail_tradeoff.csv, study_candidate_bom.csv, study_pin_matrix.csv, usb_preregulator_study.kicad_sch]
2026-10-24 Integrate SwiftUI and CloudKit prototypes with durable config and CAN flow control
    [candidate_bom.csv, presence_sensing_study.kicad_sch, study_pin_matrix.csv, threshold_sensitivity.csv]
2026-10-24 Add append-only history, timeline charts and ESP32 image preflight
2026-10-24 Add autonomous acquisition runtime, 53-PID app catalog and OTA SDK study
2026-10-24 Bind OTA transfers to framed Swift and C sessions with terminal failure handling
    [report_build.py]
2026-10-25 Complete boot-state, storage, discovery and app session workstreams for handoff
    [partitions.csv]
2026-10-25 Integrate application owner, native SDK profile and recoverable app workflows
    [partitions.native.csv]
2026-10-25 Create image-led onboarding with native accessible paging
2026-10-25 Organize project documentation and add session instructions
    [BOM_CANDIDATES.csv]
